arushriswarup/Grad-School/Expenses/Home Hardware 30-Mar-2017.jpg

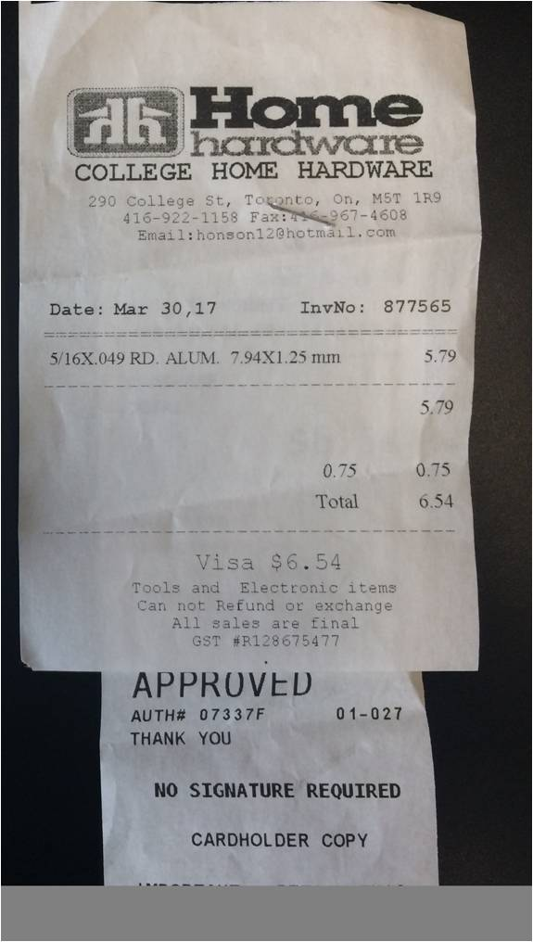
Expenses/Home Hardware 30-Mar-2017.jpg
