arushriswarup/Grad-School/Coursework/Bioengineering Science/Kevin Thesis Proposal Comments.JPG

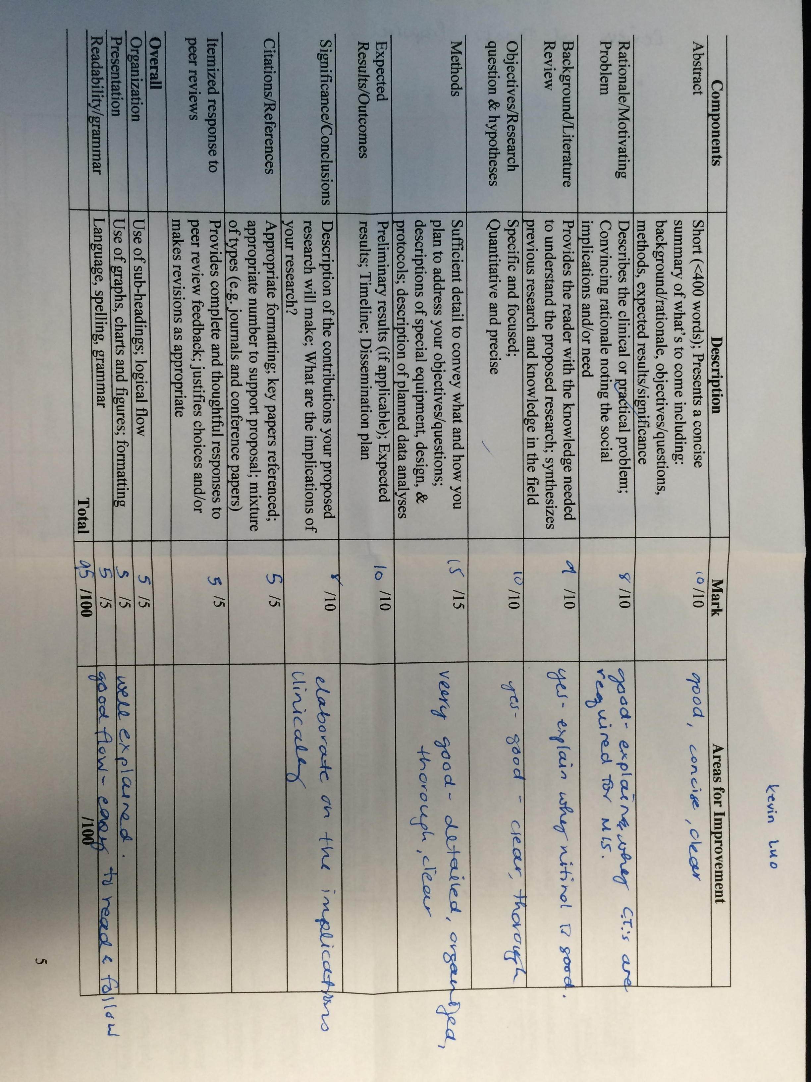
Coursework/Bioengineering Science/Kevin Thesis Proposal Comments.JPG
