arushriswarup/Grad-School/Ear Surgery Instruments/Wrist Tool Assembly/BOM.txt

McMaster Carr Parts: 

Stainless steel tubing for suction shaft: 5560K43 https://www.mcmaster.com/#5560k43/=15yuvoh
stainless steel tubing for containing the cable and suction shaft: 
stainless steel tubing for handle body: 89495K295 https://www.mcmaster.com/#standard-stainless-steel-hollow-tubing/=15ywdfg
