arushriswarup/Grad-School/Lab Meeting 07-Nov-2016.pptx

## Workspace Analysis

Goal: design the body and tip of the instrument using ear anatomy as a guide

## Problem: Endoscope can visualize areas in middle ear but current tools cannot reach certain areas.

Middle Ear Anatomy

Endoscopic View

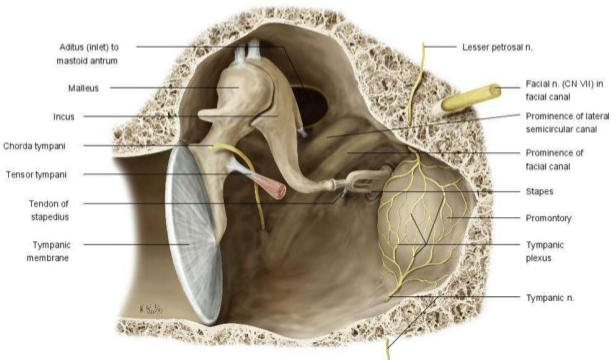
[picture p45: figure]

http://image.slidesharecdn.com/2-151023145818-lva1-app6892/95/anatomy-of-middle-ear-4-638.jpg?cb=1445612510

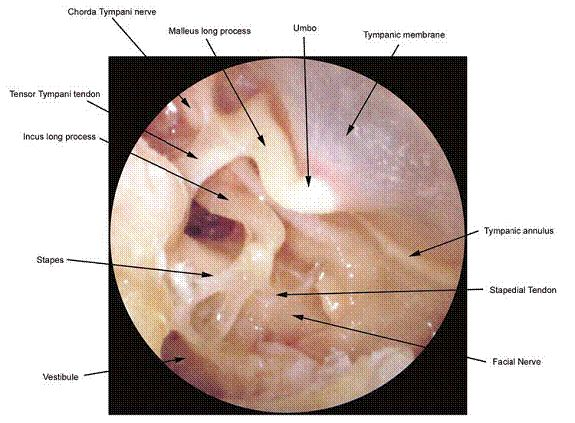
[picture p46: figure]

https://s-media-cache-ak0.pinimg.com/736x/a9/a7/0f/a9a70f560bd321be8d7cf8272315d433.jpg

Endoscope

## Slide 3

Question 1: What is the optimal geometry of the body of the tool to reach areas within the middle ear
Head CT Scan .dicom + Slicer → Solidworks [3D ear anatomy .stl + endoscope]
Question 2: What is the desired tip function when the tool reaches that area? (e.g. forceps, curette, blade, etc.)
3D printed bony ear anatomy + Instrument with electromagnetic sensors → map the tip workspace → integrate into computer model
Shaping Instrument:
Final computer model with anatomy & endoscope (boundaries), tip workspace → integrate a simple instrument and bend according to the model boundaries to try and form a shape that will reach the workspace

## Questions:

- Can you export the workspace map into an STL?
- How easy would it be to integrate into a solidworks file with an STL of the ear anatomy?
- How do you work with such a big file on solidworks?
- How easy is it to integrate a sldprt (endoscope and instrument model) into an STL on a solidworks file?
- Should I use solidworks for this or a different program?
- To validate that the tool will work on more than just one ear, I will make a separate model for each CT-generated ear model. Is this a good idea? What should be my sample size?
