arushriswarup/Grad-School/IP&C/ANSTY_Patent_Images.pptx

## Slide 2

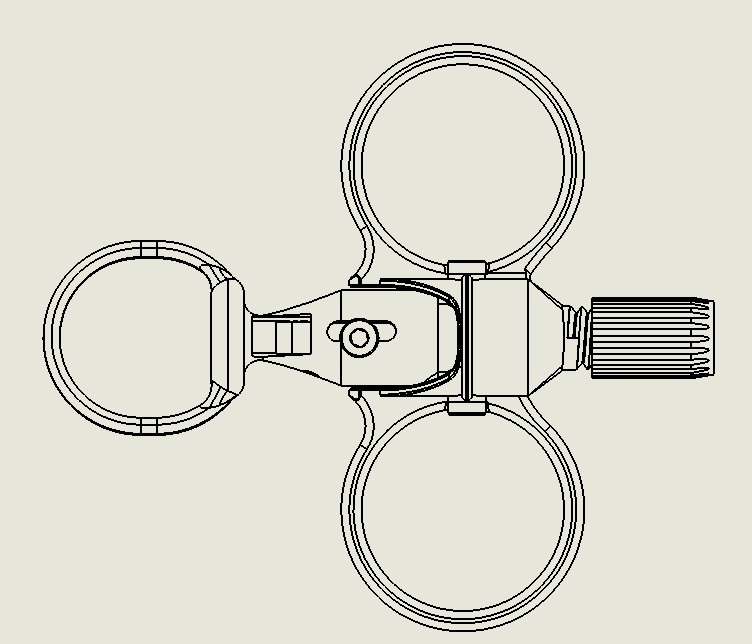
[picture p47: figure]

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
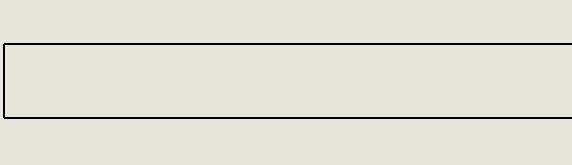
[picture p48: figure]

235

240

245

237

236

243

246

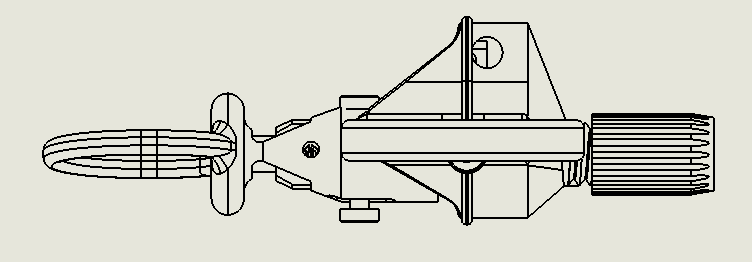
[picture p49: figure]

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
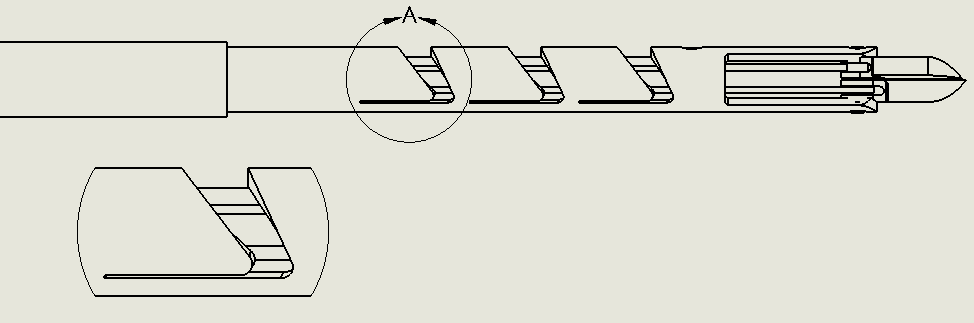
[picture p50: figure]
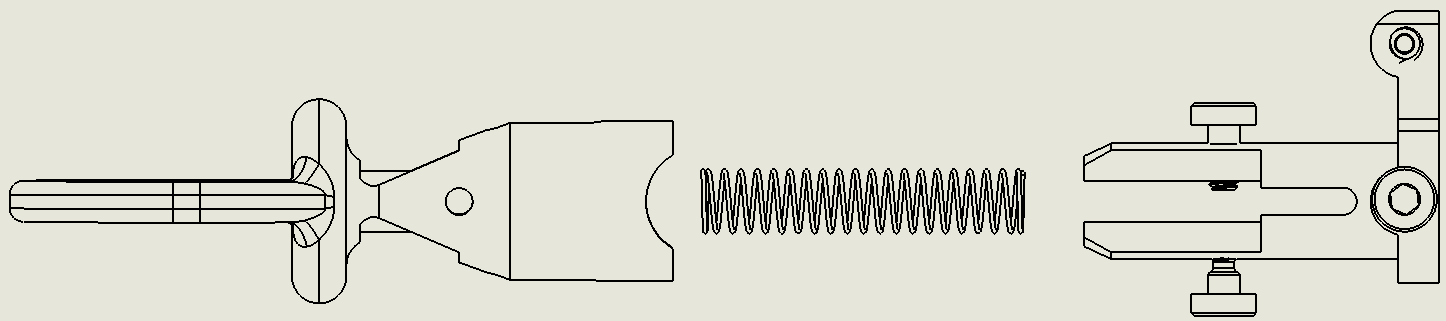
[picture p51: figure]

239

247

246

243

## Slide 3

Thumb Trigger

Compression Spring

Thumb Gimbal

## Slide 4

## Slide 5

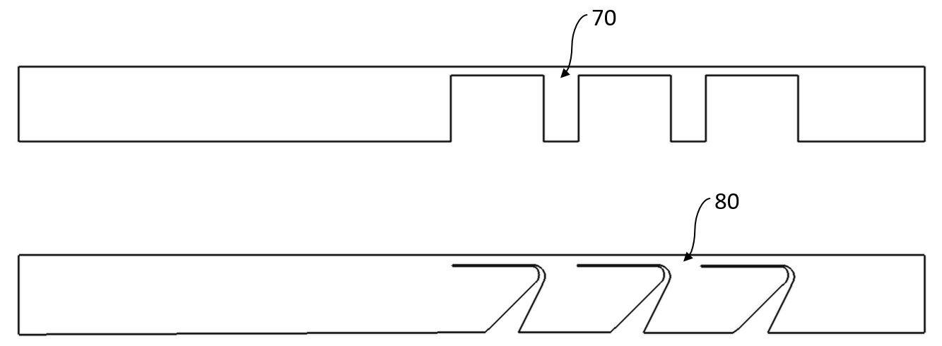
[picture p52: figure]
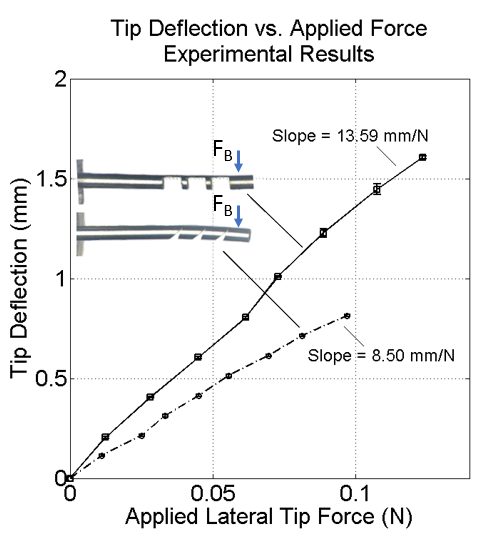
[picture p53: figure]

71

81

## Slide 6

## Slide 7

Dissector to the left:

Dissector to the right:

Dissector on the front:

Dissector to the left:

Dissector to the right:

Dissector on the front:

## Slide 8

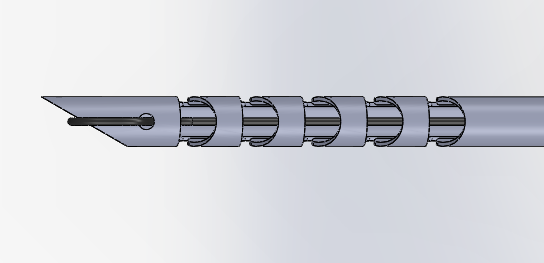
[picture p54: figure]

Nitinol CCM wrist

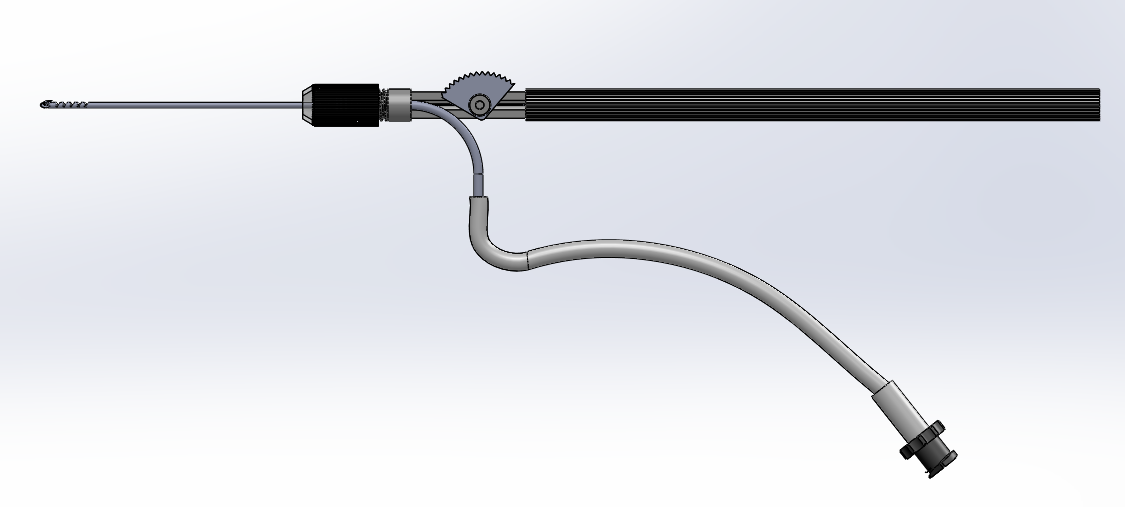
[picture p55: figure]

Finger Piece

Handle

Nitinol curved suction connector

Suction Tubing

Female Luer Connector

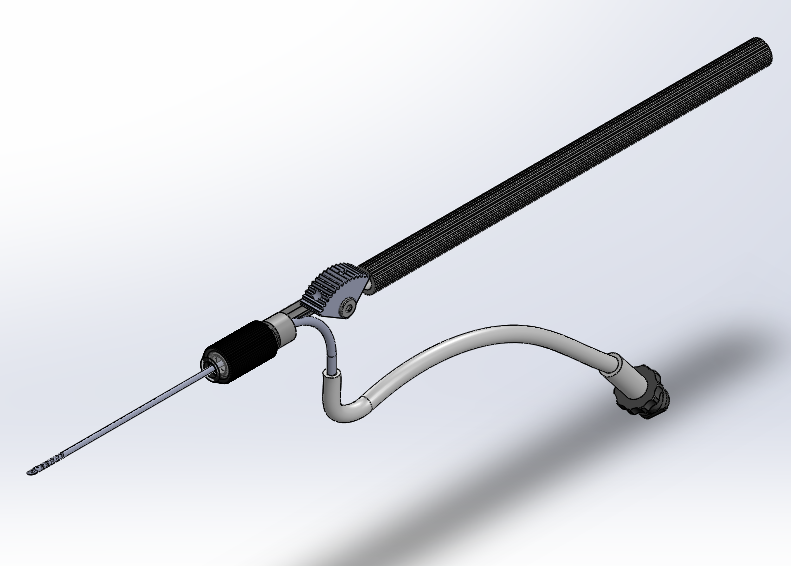
[picture p56: figure]
