arushriswarup/Grad-School/IP&C/Patent Search.docx

Patent Search:

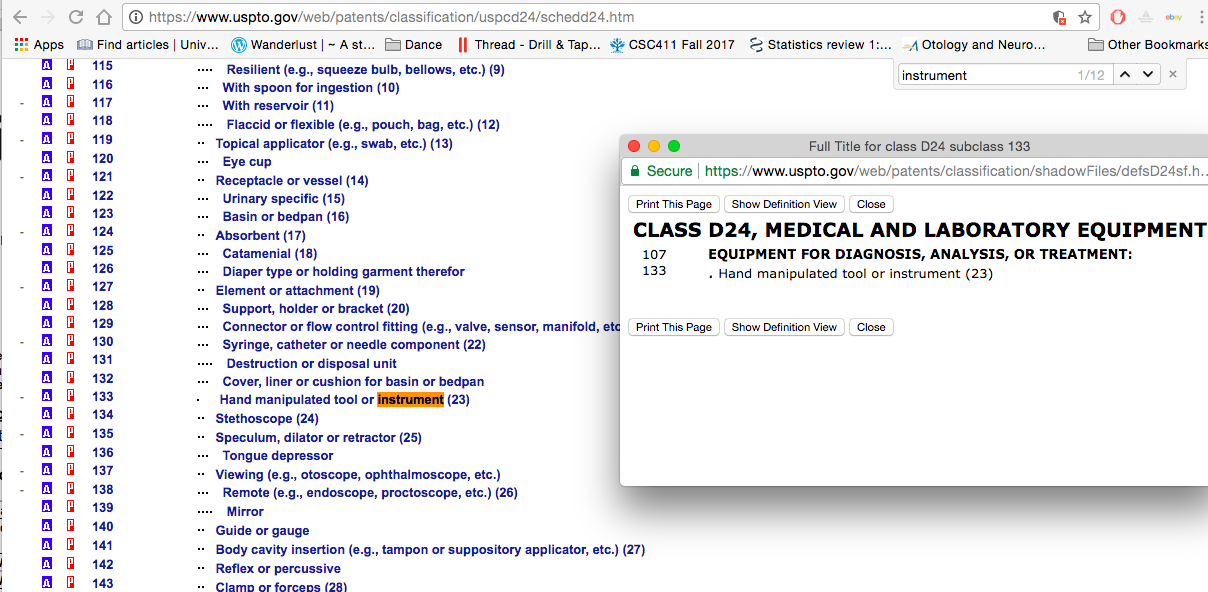
[picture p61: figure]

Classes:

CLASS D24, MEDICAL AND LABORATORY EQUIPMENT
107 | EQUIPMENT FOR DIAGNOSIS, ANALYSIS, OR TREATMENT:

133 | . Hand manipulated tool or instrument (23)

Click on the “p” button beside the class

http://patft.uspto.gov/netacgi/nph-Parser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

Patent Figures

- See folder of patents

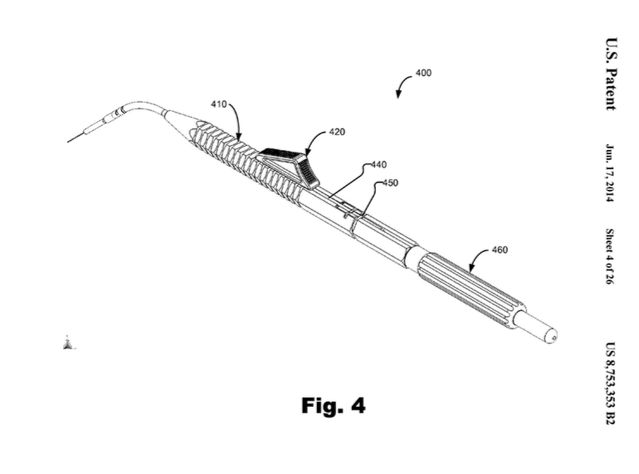
[picture p62: figure]
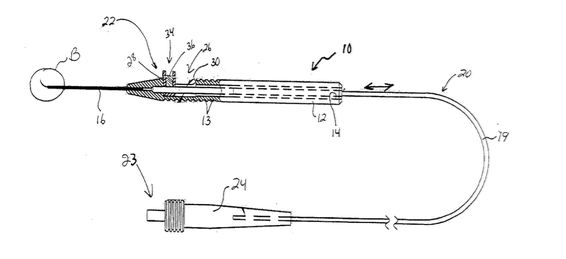
[picture p63: figure]
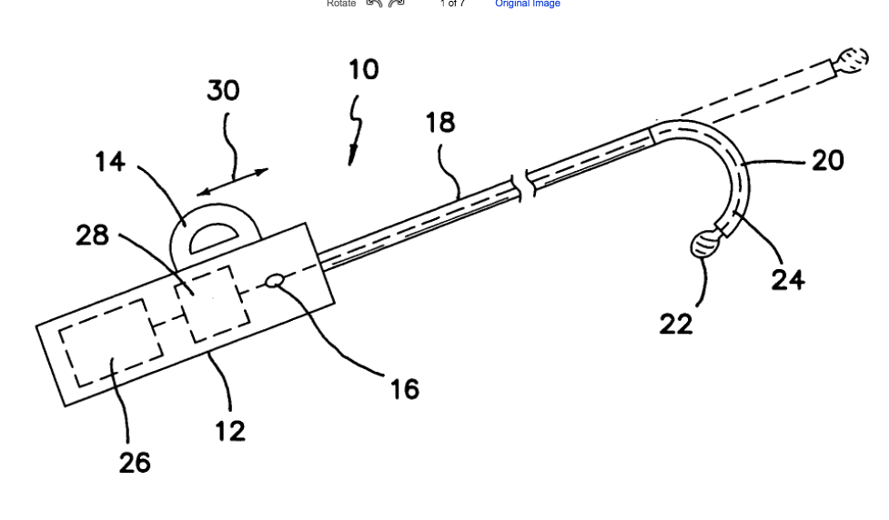
[picture p64: figure]

steerable catheter handles:

https://www.google.com/patents/US6146355

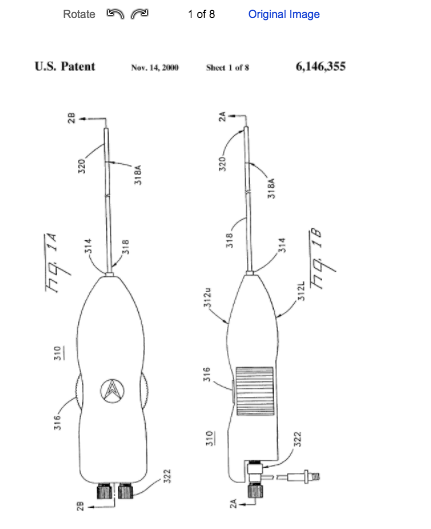
[picture p65: figure]

Published Prior Art

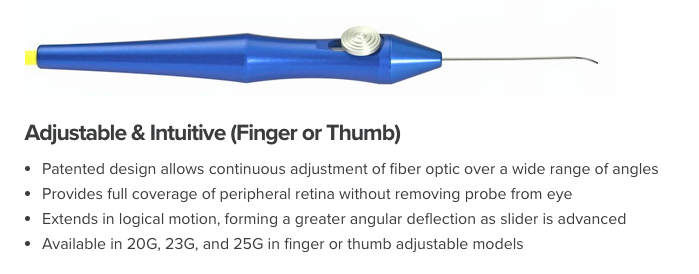
[picture p66: figure]

http://salientmed.com/solution/endoprobe-handpieces/

- https://healingsurgical.com.au/product/steerable-laser-probe#productDetailTab2

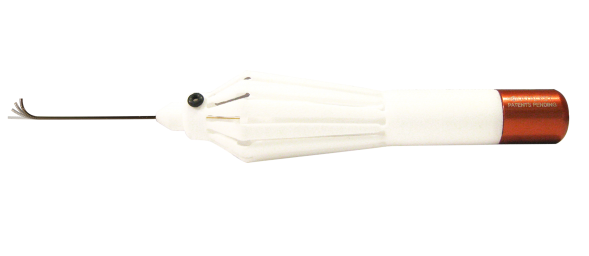
[picture p67: figure]

https://www.bitegroup.nl/category/maneuverable-devices/i-flex/

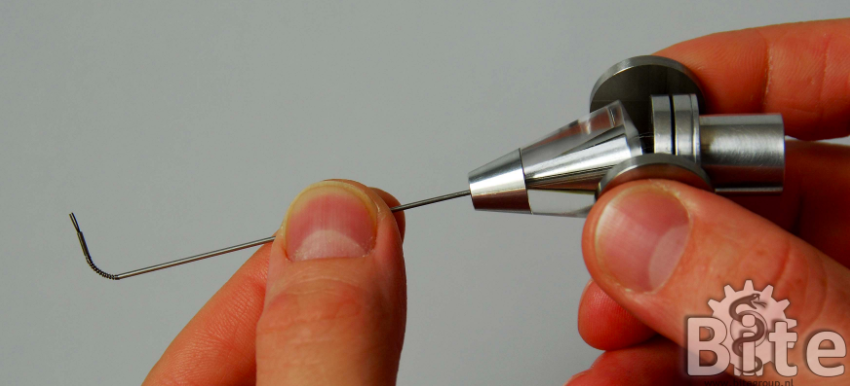
[picture p68: figure]

Curved Suction:

Medtronic Fusion ENT Navigation System: http://assets.medtronic.com/ent/flipbook-us/#p=44

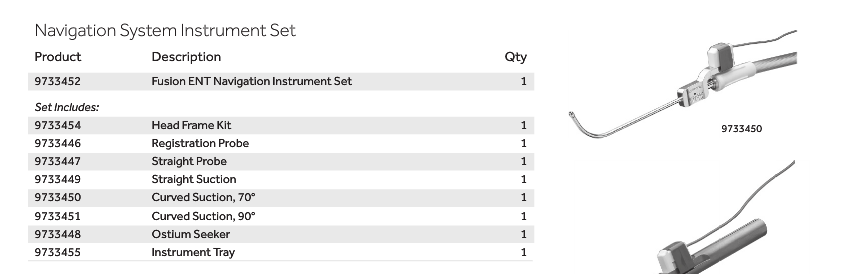
[picture p69: figure]

I think this has pre-curved suction (but not bendable)

http://www.medtronic.com/us-en/healthcare-professionals/products/ear-nose-throat/image-guided-surgery/fusion-ent-navigation-system/related-navigation-products.html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

- Frontal Suctions, 45° and 90°
- Small Straight Suction
- Suction Curettes, 45° and 90°
- Elevator
- Standard Registration Probe and Head Frame Kit (not pictured)
