arushriswarup/Grad-School/sentac/Sentac-Poster 01-Dec-2017.pdf

X

Thomassin Dissector,/
double/bend

Ear/Canal

Target

Controller:)Finger'Piece
Handle

Luer'Lock'for'
suction | Connector' | Tubing'for'suction)
| | or)laser)fibre

Flexible)Tip

0

20

40

60

80

100
Need for Better Instrumentation (%)

Reaching

Structures
Dissection and
Removal of

Cholesteatoma

Cutting Bone
Bleeding
Control

Keeping the
Lens Clean

Positioning a

Graft

### Arushri Swarup¹,2,3, Adrian L. James³

1Department of Otolaryngology – Head and Neck Surgery, Faculty of Medicine, University of Toronto, Toronto, ON, Canada 2Centre for Image Guided Innovation and Therapeutic Intervention, The Hospital for Sick Children, Toronto, ON, Canada 3Institute of Biomaterials and Biomedical Engineering, University of Toronto, Toronto, ON, Canada

# Design of Controllable Flexible Instruments to Facilitate Endoscopic Ear Surgery

As TEES is a young field, a needs analysis study was conducted to define the primary challenges faced by surgeons.

References
1. Cohen MS, Landegger LD, Kozin ED, Lee DJ. Pediatric endoscopic ear surgery in clinical practice: Lessons learned and early outcomes. Laryngoscope. 2015:732--738. 2. Kanona H, Virk JS, Owa A. Endoscopic ear surgery: A case series and first United Kingdom experience. World J Clin cases. 2015;;3(3):310--317. 3. Badr-el-dine M. Instrumentation and Technologies in Endoscopic Ear Surgery. Otolaryngol Clin NA. 2013;;46(2):211--225.
4. Bennett ML, Zhang D, Labadie RF, Noble JH. Comparison of Middle Ear Visualization With Endoscopy and Microscopy. Otol Neurotol. 2016;;37:362--366. 5. Yong M, Mijovic T, Lea J. Endoscopic ear surgery in Canada : a cross-sectional study. J Otolaryngol - Head Neck Surg. 2016:1--8. 6. Mijovic T, Lea J. Training and Education in Endoscopic Ear Surgery. Curr Otorhinolaryngol Rep. 2015;;3(4):193--199. 8. Eastwood KW, Francis P, Azimian H, Swarup A, Looi T, Drake JM, Naguib HE. Design of a Contact--Aided Compliant Notched--Tube Joint for Surgical Manipulation in Confined Workspaces. ASME. J. Mechanisms Robotics. 2017;;():. [accepted manuscript] arushri.swarup@mail.utoronto.ca
Study Results | Patient CT scans informed the design of the tip in order to reach the target anatomy, including the antrum and sinus tympani where cholesteatoma is usually found and currently inaccessible without removing bone. The desirable bending angle is 135o which allows the tip to reach the boundary of the endoscope viewing angle.

Reaching Problem: current instruments cannot reach all structures visualized by the endoscope without the removal of bone.

Reaching Solution: Incorporate a flexible “wrist” at the tip of the instrument. By cutting notches into a tube made of nitinol (a superelastic metal), the tube can bend by pulling on an

attached cable. A specific notch geometry is selected to achieve the desired bending shape while increasing stiffness⁷.

Cross%sectional-mixed-methodsstudy-questionnaireç

Interviews-with-5-localotologists

Pilot-questionnaire

TEES-skills-course

51-international-TEES-Surgeon-responses

Non%parametric-data-analysis:-Kruskal Wallis-H%Test
Wilcoxon-Method
P<0.05-significant

TEES-Experience:-
Percent-of-TEES-Cases:-
0%
Up-to-50%
50%90%
More-than-90%

Use-of-specialized-TEES-Instruments? Yes-No

“Are-there-any-other-instruments-that-you-would-like-tosee-modified-or-developed-for-endoscopic-earsurgery?-Please-give-examples”-

Visual-Analog-Scale:-
Rate-need-for-better-instrumentation-to-address-thefollowing-TEES-challenges:-Reaching-structures-visualized- by-the-endoscope Dissection-and-removal-of-cholesteatoma Cutting-bone
Bleeding- control
Keeping-the-endoscope-lens-clean Positioning- a-graft

The tip was manufactured by laser cutting a nitinol tube and attached to a handle which could articulate the joint. The handle is designed to maintain a similar grip used for existing ear surgery instruments with the addition of a finger piece for controlling the tip.

REB #s: 1000033566, 100005/5626

The | instrument | was
tested | using | an
endoscope inside 3D
printed patient temporal
bone models generated
from the CT scans. It
was possible to reach
the sinus tympani and
antrum.

To address the challenges of TEES, an instrument was designed, prototyped and tested to reach the structures visualized by the endoscope.

Defining the Challenges of TEES | Development of a New Instrument for TEES

### Needs Analysis Study

### Instrument Tip Design

### Instrument Prototype

### Instrument Testing

Transcanal endoscopic ear surgery (TEES) is a new minimally invasive middle ear surgery technique to access otherwise hidden recesses within the middle ear¹⁻-4. While TEES reduces length of hospital stay and patient morbidity, the surgical technique is challenging since only one hand can handle an instrument which must pass through the narrow ear canal⁵,6. Presently, surgeons performing TEES use otologic instruments developed for two-handed surgery which are not optimized for the TEES environment.
Objective: Design instruments to facilitate the challenges experienced during transcanal endoscopic ear surgery (TEES).

Reaching structures visualized by the endoscope yielded the greatest need for better instruments.

Survey comments called for new instruments to improve reach, dissect and remove
cholesteatoma, bone removal, and control bleeding.

### Future Work

Future work involves further testing of the tip to ensure it can safely encounter the tissue forces experienced during surgery, orient a laser fibre safely and effectively, and reach the desired targets within the middle ear without significant bone removal and ultimately facilitate endoscopic ear surgery.
