arushriswarup/Grad-School/Ear Surgery Instruments/Endoscopic Ear Surgery Tool Development Timeline.pdf

Untitled Gantt Project | Jan 26, 2016
Gantt Chart | 3

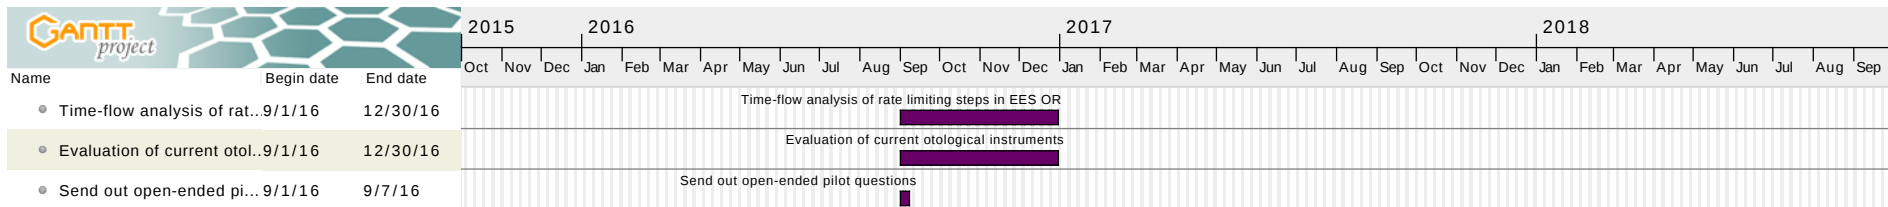
[picture p88: figure]
Name; Begin date; End date; Time-flow analysis of rat...9/1/16; Evaluation of current otol...9/1/16; Send out open-ended pi... 9/1/16; Oct; Nov; Dec; Jan; Feb; Mar; Apr; May; Jun; Jul; Aug; Sep; Time-flow; analysis; rate; limiting; steps; EES; Evaluation; current; otological; instruments; Send; out; open-ended; pilot; questions

Assimilate responses to ... 9/1/16 | 11/30/16
Send out survey and re... 10/3/16 | 10/10/16
Solidworks I Course - Ge...9/1/16 | 10/31/16
Assimilation and analysis...1/2/17 | 1/31/17
Dissemination of survey ...2/1/17 | 6/30/17
Feedback from on-line f... 2/1/17 | 6/30/17
Assimilation of focus-gro...2/1/17 | 6/30/17
Preparation of Instruments9/1/17 | 5/31/18
Preparation of virtual an... 9/1/17 | 9/30/17
Testing of instruments - ...10/2/17 | 12/29/17
Revision of Instruments | 12/1/17 | 1/31/18
Machine Final Instruments 2/1/18 | 2/28/18
Test final instruments - t...3/2/18 | 5/31/18
Survey Endoscopic Ear S... 3/2/18 | 5/31/18
Complete write-up of th... 5/2/18 | 8/31/18
Assimilate responses | to | pilot | survey | and | time-flow | analysis | to | develop | formal | needs | assessment | survey
Send | out | survey | and | reminders
Solidworks | I | Course | - | George | Brown | College
Assimilation | and | analysis | of | needs | assessment | survey
Dissemination | of | survey | results | and | time-flow | analysis | to | focus-groups | and | invitation | to | provide | solutions
Feedback | from | on-line | focus | groups
Assimilation | of | focus-group | feedback | with | in-house | solutions | and | comparison | with | current | instruments | to | create | innovative | solutions
Preparation | of | Instruments
Preparation | of | virtual | and | 3D | printed | temporal | bones | from | clinical | CT | scans | for | testing | of | prototype | instruments
Testing | of | instruments | - | involve | feedback | from | surveyed | endoscopic | ear | surgeons
Revision | of | Instruments
Machine | Final | Instruments
Test | final | instruments | - | time | flow | analysis
Survey | Endoscopic | Ear | Surgeons | for | acceptance | of | instruments
Complete | write-up | of | thesis, | preparation | for | dissemination | of | results

# Endoscopic Ear Surgery Tool Development Timeline
