arushriswarup/Grad-School/Ear Surgery Instruments/Gantt Chart 25-Jan-2016.pdf

Untitled Gantt Project | Jan 26, 2016 http://

Project manager
Project dates | Sep 1, 2016 - Aug 3, 2018
Completion | 0%
Tasks | 17
Resources | 0

Name | Begin date | End date
Time-flow analysis of rate limiting steps in EES OR | 9/1/16 | 12/30/16
Evaluation of current otological instruments | 9/1/16 | 12/30/16
Send out open-ended pilot questions | 9/1/16 | 9/7/16
Assimilate responses to pilot survey and time-flow analysis to develop formal needs assessment survey | 9/1/16 | 12/1/16
Send out survey and reminders | 10/3/16 | 10/10/16
Solidworks I Course - George Brown College | 9/1/16 | 11/1/16
Assimilation and analysis of needs assessment survey | 1/2/17 | 2/2/17
Dissemination of survey results and time-flow analysis to focus-groups and invitation to provide solutions | 2/1/17 | 6/1/17
Feedback from on-line focus groups | 2/1/17 | 6/1/17
Assimilation of focus-group feedback with in-house solutions and comparison with current instruments to create innovative solutions | 2/1/17 | 2/1/17
Preparation of Instruments | 9/1/17 | 6/1/18
Testing of instruments - involve feedback from surveyed endoscopic ear surgeons | 9/1/17 | 12/1/17
Revision of Instruments | 12/1/17 | 2/1/18
Machine Final Instruments | 2/1/18 | 3/2/18
Test final instruments - time flow analysis | 3/2/18 | 5/2/18
Survey Endoscopic Ear Surgeons for acceptance of instruments | 3/2/18 | 5/2/18
Complete write-up of thesis, preparation for dissemination of results | 5/2/18 | 8/2/18
Untitled Gantt Project | Jan 26, 2016
Tasks | 2

## Gantt Chart

3

Evaluation of current ot... 9/1/16 | 12/30/16
Send out open-ended ... 9/1/16 | 9/7/16
Assimilate responses to...9/1/16 | 12/1/16
Send out survey and re... 10/3/16 | 10/10/16
Solidworks I Course - G...9/1/16 | 11/1/16
Assimilation and analysi...1/2/17 | 2/2/17
Dissemination of survey...2/1/17 | 6/1/17
Feedback from on-line ... 2/1/17 | 6/1/17
Assimilation of focus-gr...2/1/17 | 2/1/17
Preparation of Instrume... 9/1/17 | 6/1/18
Testing of instruments ... 9/1/17 | 12/1/17
Revision of Instruments 12/1/17 | 2/1/18
Machine Final Instruments2/1/18 | 3/2/18
Test final instruments -...3/2/18 | 5/2/18
Survey Endoscopic Ear ... 3/2/18 | 5/2/18
Complete write-up of t... 5/2/18 | 8/2/18

Machine Final Instruments

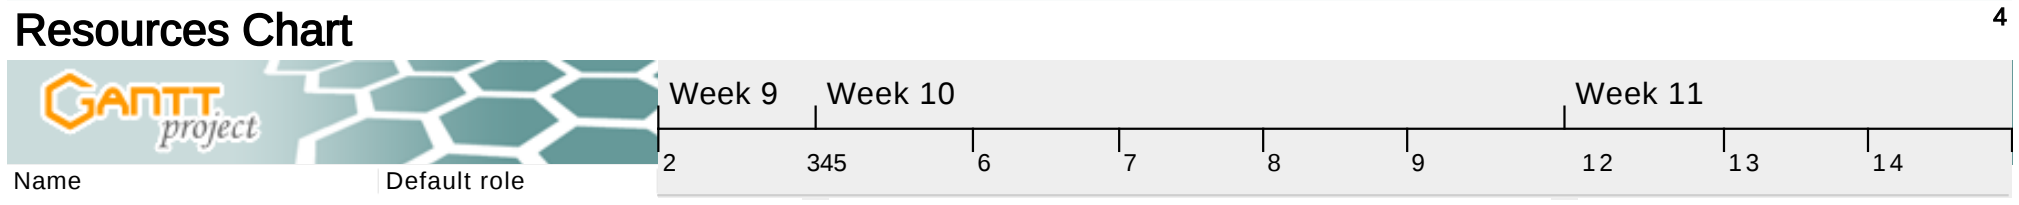
[picture p89: figure]
Resources Chart; Name; Default role; Week 9; Week 10; Week 11
