arushriswarup/Grad-School/Coursework/Bioengineering Science/First Draft Proposal .docx

Needs Analysis and Time Flow Study to Assess Endoscopic Ear Surgery

Page numbers, version date

Background:

Middle ear surgery is traditionally performed through an external incision with visualisation of delicate anatomical structures using a microscope. More recently, minimally invasive ear surgical techniques have been developed using endoscopes to access the middle ear through the ear canal without an external incision [1] [2]. As with open microscope-guided surgery, this transcanal endoscopic ear surgery (TEES) technique, allows the surgeon to perform procedures such as ear drum reconstruction, skin growth removal and hearing bone repair [2] [3]. The advantages of endoscopic ear surgery are as follows: removing the need for an external incision and reducing postoperative morbidity (10), improving visualisation for disease eradication (2-4), including reduction of the rate of residual skin growth (2, 3), and improving hearing by facilitating hearing bone preservation (10, 11).

Despite the enthusiasm of some ear surgeons (otologists), endoscopic ear surgery has not as yet been accepted by all practicing otologists (5). The principal challenge with TEES is that a one-handed surgical technique is required as the endoscope is held in the other hand. Otologic instruments were developed for two-handed microscope-guided surgery so they are not optimized for the TEES environment [2] [4]. As otologists have been trained and gained experience in microscope-guided ear surgery, they have developed techniques with the according instruments and have become accustomed to a two-handed surgical approach. By learning different surgical techniques and gaining experience with the endoscope, most surgeons find that they can complete more cases endoscopically (1, 7, 12). Nevertheless, the learning curve can be slow and frustrating. In the experience of the primary investigator (PI), technological advances in the design of the endoscope, camera and suction dissection instruments have lead to incremental stepwise jumps in this learning curve (13). There is a knowledge gap in the literature where it is not reported exactly why surgeons have not adopted the technique, and what technological and/or training advances would encourage greater adoption. It is proposed that in order to improve the adoption of TEES, the needs of surgeons and current limitations of tools must be determined.

Objectives and Hypothesis:

Objectives:

In order to increase the use of TEES, the following will be investigated: a) the reason for surgeons not adopting TEES and b) limitations of existing tools. This will aim to understand why TEES is not widely adopted by otologists and how its adoption can be improved.

Hypothesis:

TEES is recognized for its potential and the investigators hypothesize that by conducting a needs analysis survey and a surgical time flow analysis, current limitations of TEES will be developed to develop criteria to improve the adoption of TEES.

Overview of Methodology:

The protocol for this study forms part of a larger project aiming to develop improved instrumentation for endoscopic ear surgery. This study has two parts: (1) a needs assessment and (2) a time flow study.

1. Needs Assessment

The first part of this study aims to understand why TEES is not widely adopted by otologists and what technological advances would allow more frequent and broader use of TEES. A needs assessment survey will be conducted, using the two-round Delphi method, that examines the current limitations of surgical instruments used in TEES. Information from interviews with local otologists will be used to generate a questionnaire that will be disseminated to otologists globally. These results will help guide development of new instrumentation to facilitate TEES.

2. Time Flow Study

As well, independent of the needs analysis, a time flow analysis, recording the duration of surgical steps, will be conducted to quantify the limitations of the current instruments used in TEES, by assessing their efficiency.

Methods and Analysis:

Part 1: Needs Assessment Survey:

Surveys are widely used to gain information regarding a specific topic by consulting a wide variety of experts in the field. They have been used to assess the challenges of endoscopic neurosurgery in Britain and the current status of endoscopic ear surgery in Canada [6]-[7]. The Delphi method has been employed internationally in the field of surgery where surveys are sent out to surgeons to form a consensus about varying surgical issues such as: treatment of the retraction pockets of the tympanic membrane, developing a core set of patient-reported outcomes in pancreatic cancer, and an international consensus for sepsis and septic shock definitions [8] [9] [10].

A qualitative assessment of the challenges in endoscopic ear surgery caused by limitations in current instrumentation will be completed by performing an online survey of surgeons that perform endoscopic ear surgery. The Delphi method will be followed to analyze the qualitative results of the survey.

Preliminary interviews of local otolaryngologists, with varied experience in TEES within the University of Toronto, will be conducted by an IBBME MASc student (Arsuhri Swarup). Questions will ask for comments on factors that have prevented otologists from using endoscopes in ear surgery, and for comments on the perceived strengths and weaknesses of currently available instruments for endoscopic ear surgery. Their opinions will be de-identified and collated to develop a list of requirements for improvements in instrument design. In order to determine the relative priority of these requirements, a pilot questionnaire will be developed to ask a wider group of otologists to rate the importance of each requirement and will include further open-ended questions for additional comments. Invitations to participate will be sought from the 60 members of the International Working Group on Endoscopic Ear Surgery (IWGEES) (http://www.iwgees.org) plus delegates known to the PI from attendance at ear surgery courses. Results from this pilot questionnaire will be used to generate a formal questionnaire for a global survey of otologists’ opinions. This will attempt to develop a consensus on priorities for improvements in TEES instrumentation.

Participant Recruitment:

The participants are otologists who will be invited to participate by email. The email addresses will be obtained in two ways:

1. Publicly available information, as many ear surgeons list their email on their hospital website.

2. The mailing list of otological societies. Online surveys of surgical practice are frequently distributed by such societies. The following societies of which the PI is a member will be contacted asking for permission to survey their members:

- Canadian Society of Otolaryngology - Head and Neck Surgery
- American Society of Otology
- Politzer Society
- European Academy of Otology and Neurotology
- British Academy of Otolaryngology - Head and Neck Surgery
- International Working Group on Endoscopic Ear Surgery

In order to ensure that results of the survey remain de-identified, all contact information will be kept in a separate password protected spreadsheet from the results of the survey.

Needs Assessment Survey:

This portion has only surgeon participants. The survey responses will remain anonymous to the researchers and consent will be implied if the survey is filled out and received by the research team.

Questionnaire:

Refer to Appendix A for the survey details.

Part 2: Time Flow Study:

Time flow studies aim to analyze the efficiency of procedures, and have been used for many purposes in surgery, including MRI-guided angioplasty workflow and operating room setup dedicated for minimally invasive laparoscopic surgery [4]-[5]. This study will assess the feasibility and efficiency of endoscopic ear surgery using the same method.

Study Design (General Overview):

The time flow analysis will be recorded by the MASc student during ear surgery. The surgery will be divided into steps, described below. The type of instruments used during the different steps and the number of changes between instruments will also be noted. These observations will lead to an appreciation of the ergonomic requirements of instruments and the design advantages of different instruments for specific maneuvers. The time taken for five surgeons to perform ten surgeries each will be recorded. Each step for each surgeon will have a mean and standard error time, and statistical difference between surgeons for each step will be calculated. This will aim to determine the inefficiencies and address the steps where further instrument design would be beneficial. This would also provide a good benchmark against which to measure efficiency and feasibility of future tools that would be developed. The last half of surgeries will be done using the new tools developed for improving TEES. The results will be compared statistically.

Participants

The time flow study will include two kinds of participants: patients, who will be undergoing ear surgery, and surgeons, who will be performing the ear surgery.

Participant Recruitment

The PI’s colleagues in otolaryngology are interested in this project and would also like to improve their experience with TEES. Three additional surgeons from SickKids and one from Toronto General Hospital have expressed interest in participating in this study.

Inclusion criteria

Patient participants: 40 surgical patients, who require cholesteatoma surgery or tympanoplasty (surgical repair of perforated ear drum).

Surgeon participants: 5 surgeons with more than one year of experience in endoscopic ear surgery.

Exclusion criteria

Residents and fellows who are in training. It would be inappropriate to include surgeons in training in the study as their lack of experience will contribute to delays and lack of efficiency in time flow, so confounding the estimate of the contribution of instrument design to surgical time flow. Although the ability of trainees to use different instruments in TEES and the impact of their level of experience on this ability would be of interest, they are beyond the current scope and design of this study.

Study intervention

Each surgeon will be observed and recorded performing ten operations. The time and number of instruments changed will be recorded for the steps outlined in the Data Collection Form, included in Appendix B.

Outcome measures

The following outcomes will be measured: duration of the surgical steps described above and the number of times the surgeon changes the tool he/she is using during the step.

Statistical analysis

The factor to be studied is the type of instruments used for each surgical step. The block is the surgeon. The response is the time required for the surgical step. Therefore, an ANOVA will be used to determine if there is a statistical difference in the time to complete a surgical step depending on the instruments used.

[1] “Benefits of Minimally Invasive Surgery | AIMIS.” [Online]. Available: http://www.aimis.org/benefits-of-minimally-invasive-surgery/. [Accessed: 14-Nov-2015].

[2] M. S. Cohen, L. D. Landegger, E. D. Kozin, and D. J. Lee, “Pediatric endoscopic ear surgery in clinical practice: Lessons learned and early outcomes,” Laryngoscope, p. n/a–n/a, 2015.

[3] H. Kanona, J. S. Virk, and A. Owa, “Endoscopic ear surgery: A case series and first United Kingdom experience.,” World J. Clin. cases, vol. 3, no. 3, pp. 310–7, 2015.

[4] M. A. Rube, F. Fernandez-gutierrez, B. F. Cox, B. Holbrook, J. G. Houston, R. D. White, H. Mcleod, M. Fatahi, and A. Melzer, “HHS Public Access,” vol. 10, no. 5, pp. 637–650, 2015.

[5] K. C. Hsiao, Z. Machaidze, and J. G. Pattaras, “Time Management in the Operating Room : An Analysis of the Dedicated Minimally Invasive Surgery Suite,” pp. 300–303, 2004.

[6] H. J. Marcus, T. P. Cundy, A. Hughes-hallett, Z. Yang, A. Darzi, D. Nandi, and D. Phil, “Europe PMC Funders Group Endoscopic and Keyhole Endoscope-assisted Neurosurgical Approaches : A Qualitative Survey on Technical Challenges and Technological Solutions,” vol. 28, no. 5, pp. 606–610, 2015.

[7] M. Yong, T. Mijovic, and J. Lea, “Endoscopic ear surgery in Canada : a cross-sectional study,” J. Otolaryngol. - Head Neck Surg., pp. 1–8, 2016.

[8] A. Gerritsen, M. Jacobs, I. Henselmans, J. van Hattum, F. Efficace, G.-J. Creemers, I. H. de Hingh, M. Koopman, I. Q. Molenaar, H. W. Wilmink, O. R. Busch, M. G. Besselink, H. W. van Laarhoven, and Dutch Pancreatic Cancer Group, “Developing a core set of patient-reported outcomes in pancreatic cancer: A Delphi survey.,” Eur. J. Cancer, vol. 57, pp. 68–77, Apr. 2016.

[9] S. Y. Kosyakov, Y. V Minavnina, and E. V Pchelenok, “[The consensus view of the treatment of the retraction pockets of the tympanic membrane].,” Vestn. Otorinolaringol., vol. 81, no. 1, pp. 78–83, 2016.

[10] M. Singer, C. S. Deutschman, C. W. Seymour, M. Shankar-Hari, D. Annane, M. Bauer, R. Bellomo, G. R. Bernard, J.-D. Chiche, C. M. Coopersmith, R. S. Hotchkiss, M. M. Levy, J. C. Marshall, G. S. Martin, S. M. Opal, G. D. Rubenfeld, T. van der Poll, J.-L. Vincent, and D. C. Angus, “The Third International Consensus Definitions for Sepsis and Septic Shock (Sepsis-3).,” JAMA, vol. 315, no. 8, pp. 801–10, Feb. 2016.

[11] “AANS - Minimally Invasive Spine Surgery MIS.” [Online]. Available: http://www.aans.org/patient information/conditions and treatments/minimally invasive spine surgery mis.aspx. [Accessed: 17-Nov-2015].

[12] “Endoscopic Nasal & Sinus Surgery.” [Online]. Available: http://care.american-rhinologic.org/ess. [Accessed: 17-Nov-2015].

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

[14] A. L. James, B. C. Papsin, and B. C. Papsin, “-- Head and Neck Surgery,” no. September, 2012.

Page 1 of 4. Version date 27th October 2016
