arushriswarup/Grad-School/Coursework/Bioengineering Science/Proposal Outline 17-Oct-2016 Arushri Swarup.docx

Needs Analysis and Time Flow Study to Assess Endoscopic Ear Surgery

Introduction:

- Minimally invasive ear surgical techniques have been developed using endoscopes to access the middle ear through the ear canal without an external incision (1), (2)
- This is a new and challenging surgical technique, requiring one handed surgery (one hand holds the endoscope steady) and current instruments are not optimized for the technique therefore there is a low adoption among ear surgeons
- Traditional surgeries can be performed via this technique which allows better visualization within the hidden recesses in the middle ear

Research Question: Why is transcanal endoscopic ear surgery (TEES) not widely adopted by otologists and what technological advances would encourage more frequent and broader use of TEES.

Hypothesis: We hypothesize that a needs analysis study will provide an answer to this question and help develop criteria against which new endoscopic ear surgery tools can be developed.

Research Objectives: In order to increase the use of TEES we need to understand: a) the reason for surgeons not adopting TEES by conducting a questionnaire for surgeons and b) limitations of existing tools by conducting time flow analysis.

Study Rationale/Literature Review:

Time Flow Analysis

- Have been used for many purposes in surgery to test feasibility and efficiency of a specialized method
- Eg. MRI-guided angioplasty workflow and operating room setup dedicated for minimally invasive laparoscopic surgery (3)-(4)

Survey

- Used to gain information regarding a specific topic by consulting a wide variety of experts in the field
- Has been used to assess the challenges of endoscopic neurosurgery in Britain and the current status of endoscopic ear surgery in Canada (5)-(6) and is therefore applicable to assess the needs for endoscopic ear surgery

Specific Aims and Methods:

Time Flow Analysis:

- Aim: to measure the efficiency of current endoscopic ear surgery and provide areas where instrumentation redesign is required. Method: measure the duration of predetermined steps during endoscopic ear surgery as well as the number of changes between instruments

Survey:

- Aim: understand the reason why ear surgeons are not using endoscopic ear surgery and what would increase its use. Method: Following a two-round Delphi method: 1) preliminary survey developed by talking to local ear surgeons 2) first round of survey sent out to members of otology societies globally (provides a wide range of surgical experience & environments) 3) qualitative results are analyzed, using a statistical approach, to categorize answers and generate more specific questions 4) send out these new questions for round two of the survey 5) analyze and present results

Expected Outcomes and Significance:

From discussions with project investigator (an endoscopic ear surgeon) and his colleagues:

- Disadvantages: one handed surgery is difficult, bleeding control with one hand and limited space
- Advantages: better visualization within hidden recesses in middle ear, low patient morbidity, minimally invasive surgery advantages
- Understanding the needs for TEES in order to design instruments better suited for the surgery aims to encourage surgeons to adopt endoscopic ear surgery
- This study can also be applicable to other types of minimally invasive surgery performed through natural orifices in the body; can provide a means of developing better instruments for these other types of minimally invasive surgery

References:

1. Cohen MS, Landegger LD, Kozin ED, Lee DJ. Pediatric endoscopic ear surgery in clinical practice: Lessons learned and early outcomes. Laryngoscope [Internet]. 2015;n/a – n/a. Available from: http://doi.wiley.com/10.1002/lary.25410

2. Kanona H, Virk JS, Owa A. Endoscopic ear surgery: A case series and first United Kingdom experience. World J Clin cases [Internet]. 2015;3(3):310–7. Available from: http://www.pubmedcentral.nih.gov/articlerender.fcgi?artid=4360503&tool=pmcentrez&rendertype=abstract

3. Rube MA, Fernandez-gutierrez F, Cox BF, Holbrook B, Houston JG, White RD, et al. HHS Public Access. 2015;10(5):637–50.

4. Hsiao KC, Machaidze Z, Pattaras JG. Time Management in the Operating Room : An Analysis of the Dedicated Minimally Invasive Surgery Suite. 2004;300–3.

5. Marcus HJ, Cundy TP, Hughes-hallett A, Yang Z, Darzi A, Nandi D, et al. Europe PMC Funders Group Endoscopic and Keyhole Endoscope-assisted Neurosurgical Approaches : A Qualitative Survey on Technical Challenges and Technological Solutions. 2015;28(5):606–10.

6. Yong M, Mijovic T, Lea J. Endoscopic ear surgery in Canada : a cross-sectional study. J Otolaryngol - Head Neck Surg [Internet]. Journal of Otolaryngology - Head & Neck Surgery; 2016;1–8. Available from: http://dx.doi.org/10.1186/s40463-016-0117-7

Arushri Swarup 998866071 BME1450 Proposal Outline 17-Oct-2016
