arushriswarup/Grad-School/Needs Analysis Survey/superceded/Needs Analysis Survey Paper 05-Sept-2017.docx

The Current Limitations and Future Direction of Instruments in Totally Endoscopic Ear Surgery: A Needs Analysis Survey.

Short title: Current Limitations and Future Direction of Instruments in Totally Endoscopic Ear Surgery.

Arushri Swarup BASc¹,², Gavin J. le Nobel, BSc.Eng MD FRCSC²,³, Adrian James¹,²,³ MA DM FRCS.

¹Hospital for Sick Children, Toronto, ON

²Institute of Biomaterials and Biomedical Engineering, University of Toronto, Toronto, ON

³Department of Otolaryngology Head and Neck Surgery, University of Toronto, Toronto, ON

Corresponding author:

Dr. Adrian James

Phone: (416) 813-4938

Fax: (416) 813-5036

Hospital for Sick Children

555 University Avenue

Toronto ON, Canada, M5G 1X8

email: adr.james@utoronto.ca

Sources of funding:

Director’s Innovation Award, Institute of Biomaterials and Biomedical Engineering, University of Toronto

Department of Otolaryngology – Head & Neck Surgery, Hospital for Sick Children

# Needs Analysis Survey Paper

## Journal

Otology & Neurotology - http://edmgr.ovid.com/on/accounts/ifauth.htm

Basic Science Reports: - 3500 words. This count does not include the abstract, references, tables, or figure legends.

- 6 main figures and tables. Individual figures may consist of figure parts (Figure 1A, 1B, etc), but additional figures and tables should be submitted as Supplemental Digital Content.
- Title page – submitted as a separate word document

## Abstract:

250 words

Hypothesis: Brief, clear statement of the main goals of the investigation.
Background: Concise; designed for orientation of the reader who is unfamiliar with this line of investigation.
Methods: Succinct summary of techniques and materials used.
Results: Include statistical measures where appropriate.
Conclusion: Include only those directly supported by data generated from this study. Emphasize clinical relevance wherever possible.

## Introduction:

Endoscopes provide direct access and a wide angle view into the middle ear, reducing the time required to gain access, drill bone for exposure and close during middle ear surgery and are able to visualize hidden recesses within the middle ear including: the sinus tympani, anterior and posterior epitympanum and hypotympanum [1][2][3][4]. As well, the endoscope allows visualization past the shaft of the instrument, such as the drill, which is a problem during microscopic surgery[5].

Despite the enthusiasm of some otologists, endoscopic ear surgery has a low acceptance rate[6][7]. The principal challenge with TEES is that a one-handed surgical technique is required as the endoscope is held in the other hand[6][8]. During traditional surgery, the non-dominant hand usually maintains suction and removes blood from the operative field while the dominant hand performs the delicate maneuvers [8]. Otologic instruments were developed for two-handed microscope-guided surgery so they are not optimized for the TEES environment. As otologists have been trained and gained experience in microscope-guided ear surgery, they have developed techniques with the according instruments and have become accustomed to a two-handed surgical approach. By learning different surgical techniques and gaining experience with the endoscope, most surgeons find that they can complete more cases totally endoscopically [9][6][1][8].

Technological advances in the design of the endoscope, camera and suction dissection instruments have lead to incremental stepwise jumps in this learning curve [10]. In order to further develop technology and instruments to facilitate TEES, it is important to understand the specific challenges experienced during TEES. It is proposed that in order to facilitate TEES, the needs of surgeons and current limitations of tools must be determined.

We hypothesize that otologists need better instrumentation to facilitate specific challenges posed by TEES. Further, we hypothesize that otologists performing greater proportions of surgeries using TEES will experience different challenges than those who use TEES less frequently. Similarly, we hypothesize that those surgeons who use specialized TEES instrument sets may experience different challenges that those who do not. To this end, we conducted a mixed-methods study to explore these hypotheses.

## Materials and Methods:

### Study Design:

Ethics approval was obtained for this study from the institution’s Research Ethics Board (REB number: 1000055626, Principal Investigator: Dr. Adrian Lewis James).

This cross-sectional study employed a mixed-methods self-administered online questionnaire consisting of nine questions. The responses were scored using multiple choice, yes/no, an analog scale and an open-ended free-text response. The analog scale was anchored with verbal descriptions to ensure comparability between participants, while facilitating parametric statistical analysis. Participant demographics included the percentage of middle ear surgeries performed using TEES as well as whether the surgeon uses a specialized TEES instrument set. Participants were asked the degree to which an instrument that addresses the following challenges would be of use to the participant: i) bleeding control ii) keeping the endoscope lens clean iii) cutting and/or removing bone iv) reaching structures visualized by the endoscope v) dissection and removal of cholesteatoma vi) moving and positioning a graft into the intended place.

In addition, participants were asked to identify any other types of instruments that they would find useful while performing TEES. The questionnaire content was developed through a literature search on challenges experienced during TEES and the clinical experience of the principal author and his colleagues. Using this data, a preliminary questionnaire was developed and piloted amongst local otologists with varying degrees of TEES experience. The results of the pilot questionnaire were used to create the final concise questionnaire that was distributed internationally.

### Participants and Data Collection:

We identified otologists who attended the 2nd World Congress of Endoscopic Ear Surgery, members of the International Working Group of Endoscopic Ear Surgery and attendees of a TEES course in Japan. After obtaining REB approval, these otologists were invited to participate in the survey. The beginning of the online survey includes a letter of information and informed consent was assumed upon anonymous completion of the questionnaire. All information was stored anonymously.

### Data Analysis:

Visual analog scales were quantified and the means as well as the 95% confidence intervals were established. ANOVA was used to determine which challenge presented the greatest degree of need. The Kruskall-Wallis H-test was used to determine if the percentage of cases done with TEES influenced the degree of need for each challenge. The t-test was used to determine if use of a specialized TEES instrument set affected the degree of need for each challenge. Qualitative data was analyzed by grouping the responses into themes/categories which would describe additional difficulties those tools would address. Statistical analysis was performed using JPM statistical analysis software (JMP version 13.0; SAS Institute; Cary, NC).

## Results:

### Study Participants and Demographics

The questionnaire was distributed to a total of _____ surgeons and 51 surgeons completed the questionnaire with an overall response rate of <???>. 16 attendees at the 2nd World Congress on Endoscopic Ear Surgery, six attendees of the Japanese course, and 26 members of the International Working Group on Endoscopic Ear Surgery (IWGEES) responded. Of the respondents, 4 (8.1%) do not perform any surgeries using TEES, 15 (30.6%) perform up to 50% of surgeries using TEES, 20 (40.8%) perform 50-90% of surgeries using TEES, and 10 (20.4%) perform greater than 90% of surgeries using TEES. Thirty eight (77.6%) of respondents use specialized TEES instrument sets.

Figure XXX. Mean degree of need reported for each TEES challenge. The error bars indicate standard error, n = 51.

### Challenges during TEES that exhibit the greatest degree of need by surgeons:

The average degree of need exceeded 50% for all challenges. Reaching structures visualized by the endoscope resulted in the highest degree of need (mean 83%, 95%CI 76-89%) although the degree of need was not statistically different from the degree of need for dissecting and removal of cholesteatoma. Conversely, positioning the graft resulted in the lowest degree of need (mean 58%, 95%CI 52-65%), although this was not statistically different from the degree of need for keeping the endoscope clean.

### Effect of percentage of surgeries performed totally endoscopically on TEES challenges:

There was a statistically significant difference in the degree of need for reaching structures and for positioning a graft, depending on the percentage of surgeries performed endoscopically. For reaching structures, X²(2) = 8.9481, p = 0.0300 with mean scores of 76, 72, 88, and 92, respectively, for surgeons who perform none, 0 – 50%, 50 – 90%, and greater than 90% of surgeries using TEES. For positioning a graft, X²(2) = 12.8438, p = 0.0050 with mean scores of 50, 44, 60, and 81, respectively, for surgeons who perform none, 0 – 50%, 50 – 90%, and greater than 90% of surgeries using TEES. The remainder of challenges were not significantly dependent on the proportion of cases performed using TEES

### Effect of using a specialized TEES instrument set on TEES challenges experienced:

Respondents who used a specialized TEES instrument set had a significantly lower mean degree of need for positioning a graft than those who did not use a specialized set, with means of 55 and 71 respectively (p=0.002)

### Qualitative Results:

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

When asked _____ question_______, 30 comments were received and many of the comments suggested identified a need for the development of instruments that could address multiple challenges faced in TEES. The comments included 8 (27%) addressing the need to reach structures, 10 (33%) addressing the need for improved dissection and removal of cholesteatoma, 4 (13%) addressing the need for improved bone removal, 6 (20%) addressing the need for improved bleeding control, and 1 (3%) addressing the need for keeping the lens clean). No comments specifically addressed the need for development of instruments to address the challenge of positioning the graft.

Ten (33%) comments suggested improvements to instruments to address challenges arising from a need to reach structures and remove cholesteatoma. Four (13%) of these comments identified a need for different curved suctions and another 2 (13%) comments identified a need for additional curved instruments to reach into middle ear recesses and the mastoid. A need for suctions and instruments specifically designed to access the sinus tympani were identified in 4 (13%) comments. Two (7%) comments identified a need for flexible instruments to reach the mastoid and middle ear recesses in TEES. Four (13%) respondents identified a need for improving bone removal techniques in endoscopic surgery with 2 comments focusing on improving visualization with drilling alongside endoscopes and 2 comments focusing on further development of piezoelectric surgical instruments. Three (10%) comments suggested developing new instruments to manage bleeding, with two (7%) focusing on coagulating instruments such as bipolar. One (3%) comment suggested development of an instrument combining suction with bipolar to facilitate hemostasis. One (3%) comment identified a need for modification of endoscope such that there would be a continuously cleaning lens. No comments suggested development of new instruments to help position grafts in TEES.

Eight (27%) comments from respondents focused on modifications to endoscopes and the use of endoscopes in TEES. Four comments identified a need for endoscope holders to facilitate two handed operating with a stationary endoscope. Two comments focused on improving visualization using endoscopes that are flexible or endoscopes with a continuously cleaning lens. One comment identified a need for more instruments with curved shafts to facilitate working alongside the endoscope.

From the comments regarding instrumentation to facilitate TEES, 10 out of 21 responses described an instrument that combines suction with another function, such as dissection, cautery and reach via shaft shape. 10 comments described an instrument that could reach areas better and four comments mentioned a tool that combined reach and suction. Four described an instrument to hold the endoscope and four comments described an instrument that could drill bone while combining irrigation and suction or with better visualization.

## Discussion:

We have conducted a cross-sectional mixed-methods survey to identify, quantify, and describe the challenges otologists face with TEES. A survey on TEES for Canadian otologists has reported that 11% of otologists in Canada use TEES for cholesteatoma, tympanoplasty, and ossicular reconstruction surgeries and they find the following factors difficult about TEES: single-handed surgery, efficiency/operative time, technical difficulty, cost, managing bleeding [6]. This questionnaire was intended to build upon this research by measuring the degree to which surgeons experience specific challenges during surgery and whether they could be addressed by a specialized surgical tool. While previous studies have sought to identify challenges experienced during specific TEES surgeries, fewer studies have attempted to identify these challenges as well as instruments that could address these challenges. This survey included respondents internationally to get a world-wide response on what challenges during TEES require instrumentation.

Reaching Structures & Dissection & Removal of Cholesteatoma

While endoscopes facilitate excellent visualization, reaching structure as well as dissection and removal of cholesteatoma remain significant challenges in TEES surgery. Difficult to reach anatomical recesses include the sinus tympani, facial recess, and anterior epitympanic recess [3]. As a result of inadequate access, patients may be at increased risk of residual disease if these areas are involved with cholesteatoma[15][16]. Further, surgeons may have to modify their approach to reach these areas, potentially necessitating a post-auricular approach or additional bone removal with a TEES approach thus resulting in more aggressive surgery. While specialized instruments with curved tips have been developed to address this, the curves in the shafts are fixed and there are areas where these instruments still cannot reach [3].

These challenges were found to have the greatest need by respondents on visual analog scale. Further, when asked about need for development or modification of new instruments, more than 30% of the comments focused on the need for instruments that address these challenges. This indicates that otologists struggle with these aspects of endoscopic ear surgery. The degree of need for reaching structures was lower for surgeons who perform a lower proportion of cases using TEES. This may be because surgeons who perform lower proportions of cases using TEES may be more likely to use a microscope when they need to access deep recesses in the middle ear and mastoid. As a result, this may result in a lower degree of need for reaching structures for their TEES cases where as for surgeons who perform more difficult using TEES, this may remain a challenge with a significant degree of need. Interestingly, the degree of need for these challenges did not differ amongst respondents depending on use of specialized TEES instrument sets. This suggests reaching structures as well as dissection and removal of cholesteatoma remain significant challenges despite current specialized TEES instrument sets. Certainly, these results suggest that future instrument development should focus on instruments that improve our ability to reach structures and facilitate dissection and removal of cholesteatoma.

### Cutting and removing bone

Cutting and removing bone allows visualization of and access to areas within the middle ear that cannot be seen by the endoscope or reached by existing instruments. While straight and angled endoscopes facilitate a broader field of view than line-of-sight microscopic surgery, bone removal may still be necessary for visualization and access of recesses within the middle ear and mastoid. Currently, bone removal can be accomplished with bone curettes, osteotomes, drills, and piezoelectric bone instruments. Nevertheless, this was still found identified as the challenge with the third greatest degree of need in our survey. This may relate to some of the limitations with each of the current bone removal techniques: bone curettes offer precise bone removal, however, bone removal is slow and removal of large amounts of bone may be difficult; osteotomes may be imprecise working along endoscopes in the confines of the middle ear; drills may be difficult to use alongside endoscopes and bone dust from drilling may impair visualization with the endoscopes; Pizeoelectic surgical instruments, while effective, are very expensive. The degree of need was not significantly dependent on use of a specialized TEES instrument set or the proportion of middle ear cases accomplished with TEES.

-suggested future design focus?

### Bleeding control

-discuss the nature of the challenge

-identified this as a challenge

-compare this to existing literature on the topic (i.e. did we identify this as being a greater concern? Subgroup analyses?)

-discuss existing methods managing bleeding

-discuss potential future ways of managing

Management of intraoperative bleeding represents a significant challenge when performing TEES. Intraoperative bleeding may impair surgical field clarity and obscure target tissues and this may lead to increased rates of residual cholesteatoma [15]. To manage this, techniques such as hypotensive anesthesia, patient positioning, local vasoconstrictors, and atraumatic surgical techniques have been employed[8][14][15]. In addition, specialized instrument sets have been developed specifically to improve bleeding management in TEES [3]. These instruments incorporate a functional tip with a suction shaft to allow for cutting, dissecting or elevating tissues while suctioning[3]. Previous studies have identified management of intraoperative bleeding as a significant challenge faced by otologists when performing TEES (by 24% of Canadian Otologist respondents in Lea et al.’s survey)[5][6][3][4][14]. Our study confirms this finding. Our study confirms that this is a challenge with a significant degree of need on visual analog scales. Interestingly, despite that fact specialized TEES instrument sets are specifically designed to address this challenge, the degree of need for those who used specialized TEES instrument sets was not significantly different from those who did not.

Moreover, from this questionnaire, bleeding control exhibited a mean need of 67% and nine of the seventeen comments from respondents described that an instrument combining suction with another functionality, such as dissecting, cauterizing or reaching, would be beneficial for TEES.

### Keeping the endoscope lens clean

Fogging and smearing of the endoscope tip is a challenge of TEES and surgeons must pause surgery, remove the fogged lens, and wipe it clean on a defog pad periodically[3][14]. This can be time consuming during surgery. Moreover, compromised visualization may potentially increase the risk injury to middle ear structures or the tympanomeatal flap as the instruments and endoscopes are repeatedly introduced and removed from the ear to facilitate cleaning the endoscope lens. Keeping the endoscope lens clean was identified as the challenge with the second lowest degree of need in our survey, however, the mean degree of need still exceeded 60%. Currently, this is managed by … ?

### Moving and positioning a graft into the intended place

In tympanoplasty surgery, the approach, graft material and graft placement technique vary depending on the training, case load, resources and experience available to the surgeon [18]. During TEES tympanoplasty the graft must be inserted into the ear canal and positioned single handedly in the desired orientation [18]. Performing this technique single handedly is, in the authors’ experience, quite challenging. Nevertheless, this was identified as the challenge with the lowest mean degree of need.

and so perhaps a tool that facilitates graft manipulation would be helpful for TEES surgeons. Lea and Mijovic show that cartilage or graft placement is easier when using two hands in a surgery video [8]

### Implications of the Findings

The findings from this needs analysis study can be used for future development of tools to facilitate TEES or to develop training/teaching models. The team hopes that otologists will continue to study the needs of TEES to continually improve upon the technology available to facilitate its use (?????).

### Limitations

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

## Conclusion:

key findings

review main outcome measures

compare key findings with other literature

limitations of study

# References:

[1] M. S. Cohen, L. D. Landegger, E. D. Kozin, and D. J. Lee, “Pediatric endoscopic ear surgery in clinical practice: Lessons learned and early outcomes,” Laryngoscope, p. n/a-n/a, 2015.

[2] H. Kanona, J. S. Virk, and A. Owa, “Endoscopic ear surgery: A case series and first United Kingdom experience.,” World J. Clin. cases, vol. 3, no. 3, pp. 310–7, 2015.

[3] M. Badr-el-dine, “Instrumentation and Technologies in Endoscopic Ear Surgery,” Otolaryngol. Clin. NA, vol. 46, no. 2, pp. 211–225, 2013.

[4] M. L. Bennett, D. Zhang, R. F. Labadie, and J. H. Noble, “Comparison of Middle Ear Visualization With Endoscopy and Microscopy,” Otol. Neurotol., vol. 37, pp. 362–366, 2016.

[5] M. Tarabichi, “Endoscopic Middle Ear Surgery,” Ann. Otol. Rhinol. Laryngol., vol. 108, no. 1, pp. 39–46, 1999.

[6] M. Yong, T. Mijovic, and J. Lea, “Endoscopic ear surgery in Canada : a cross-sectional study,” J. Otolaryngol. - Head Neck Surg., pp. 1–8, 2016.

[7] S. C. Prasad, A. Giannuzzi, E. A. Nahleh, G. De Donato, A. Russo, and M. Sanna, “Is endoscopic ear surgery an alternative to the modified Bondy technique for limited epitympanic cholesteatoma?,” Eur. Arch. Oto-Rhino-Laryngology, vol. 273, no. 9, pp. 2533–2540, 2016.

[8] T. Mijovic and J. Lea, “Training and Education in Endoscopic Ear Surgery,” Curr. Otorhinolaryngol. Rep., vol. 3, no. 4, pp. 193–199, 2015.

[9] A. L. James, “Endoscopic Middle Ear Surgery in Children.,” Otolaryngol. Clin. North Am., vol. 46, no. 2, pp. 233–44, Apr. 2013.

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

[11] A. Celenza and I. R. Rogers, “Comparison of visual analogue and Likert scales in evaluation of an emergency department bedside teaching programme,” EMA - Emerg. Med. Australas., vol. 23, no. 1, pp. 68–75, 2011.

[12] D. M. Marsh-richard, E. S. Hatzis, C. W. Mathias, N. Venditti, D. M. Dougherty, and W. Forest, “Adaptive Visual Analog Scales (AVAS): A Modifiable Software Program for the Creation, Administration, and Scoring of Visual Analog Scales,” Heal. (San Fr., vol. 41, no. 1, pp. 99–106, 2009.

[13] H. T. and P. Filzmoser, “Benefits from Using Continuous Rating Scales in Online Survey Research,” J. Econ. Soc. Meas., vol. 4, no. November, p. 25, 2009.

[14] E. D. Kozin, R. Kiringoda, and D. J. Lee, “Incorporating Endoscopic Ear Surgery into Your Clinical Practice,” Otolaryngol. Clin. North Am., vol. 49, no. 5, pp. 1237–1251, 2016.

[15] G. J. le Nobel, S. L. Cushing, B. C. Papsin, and A. L. James, “Intraoperative Bleeding and the Risk of Residual Cholesteatoma,” Otol. Neurotol., vol. 38, no. 4, pp. 529–534, 2017.

[16] J. L. Sheehy, “Cholesteatoma Surgery in Children,” The American journal of otology, vol. 6, no. 2. pp. 170–2, 1985.

[17] B. M. Hanna et al., “Minimally invasive functional approach for cholesteatoma surgery,” Laryngoscope, vol. 124, no. 10, pp. 2386–2392, 2014.

[18] A. L. James and B. C. Papsin, “Ten Top Considerations in Pediatric Tympanoplasty,” Am. Acad. Otolaryngol. - Head Neck Surg., no. September, pp. 992–998, 2012.

[19] H. J. Marcus et al., “Europe PMC Funders Group Endoscopic and Keyhole Endoscope-assisted Neurosurgical Approaches : A Qualitative Survey on Technical Challenges and Technological Solutions,” vol. 28, no. 5, pp. 606–610, 2015.
