arushriswarup/Grad-School/Conferences.docx

Conferences:

- Can’t submit the same thing for multiple conferences

Workspace study – Hamlyn Competition (paper not searchable on pubmed) June

http://embc.embs.org/2017/ - IEEE Engineering in Medicine and Biology Society

IWGEES conference – needs analysis April

Design of Medical Devices - http://www.dmd.umn.edu/ - April

Techna

Gallie Day - http://surgery.utoronto.ca/research/Gallie_Day_2016_-_Oral_Presentations_and_Abstracts.htm
