arushriswarup/Grad-School/Talk.docx

Talk

Theme – to show how to explore the limits of what can be done with pediatric endoscopic ear surgery

Dr. James – limits of disease adn anatomy

Me – how can we push those limits with improved instrument design

Promo for the needs analysis – show initial results and then ask

- Describe the problem and how to solve
- Show the model and different ways of approaching it
  - CONCENTRIC tubes
  - Wrist
- Show how we will test and develop them
- Pictures of the model
