arushriswarup/Grad-School/Coursework/Bioengineering Science/Kevin Thesis Proposal Comments.pdf

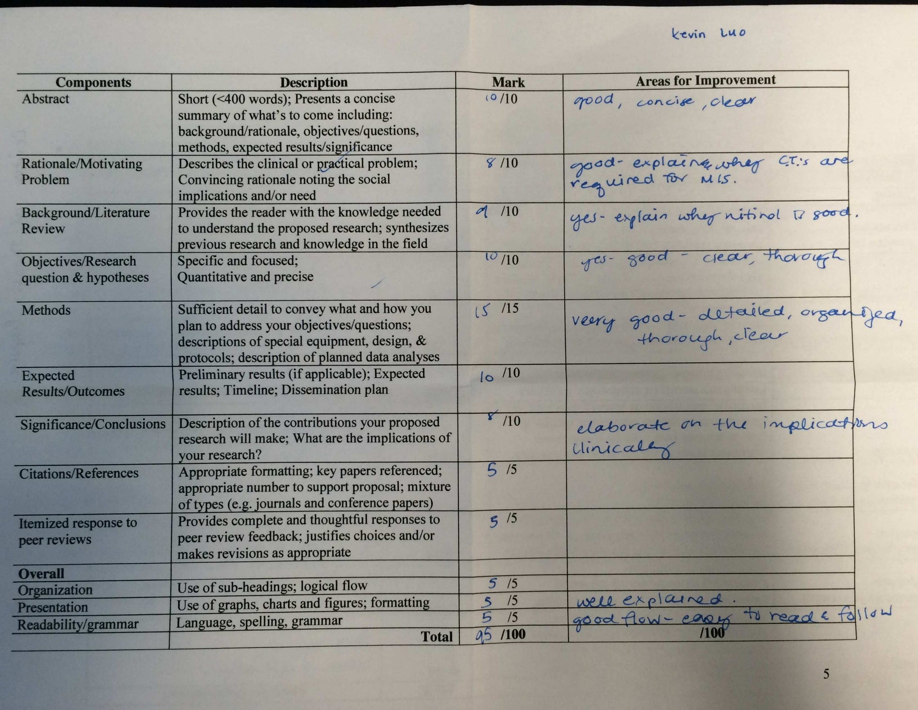
[picture p116: page 1]
