arushriswarup/Grad-School/Coursework/Bioengineering Science/Tianyu Thesis Proposal Comments.pdf

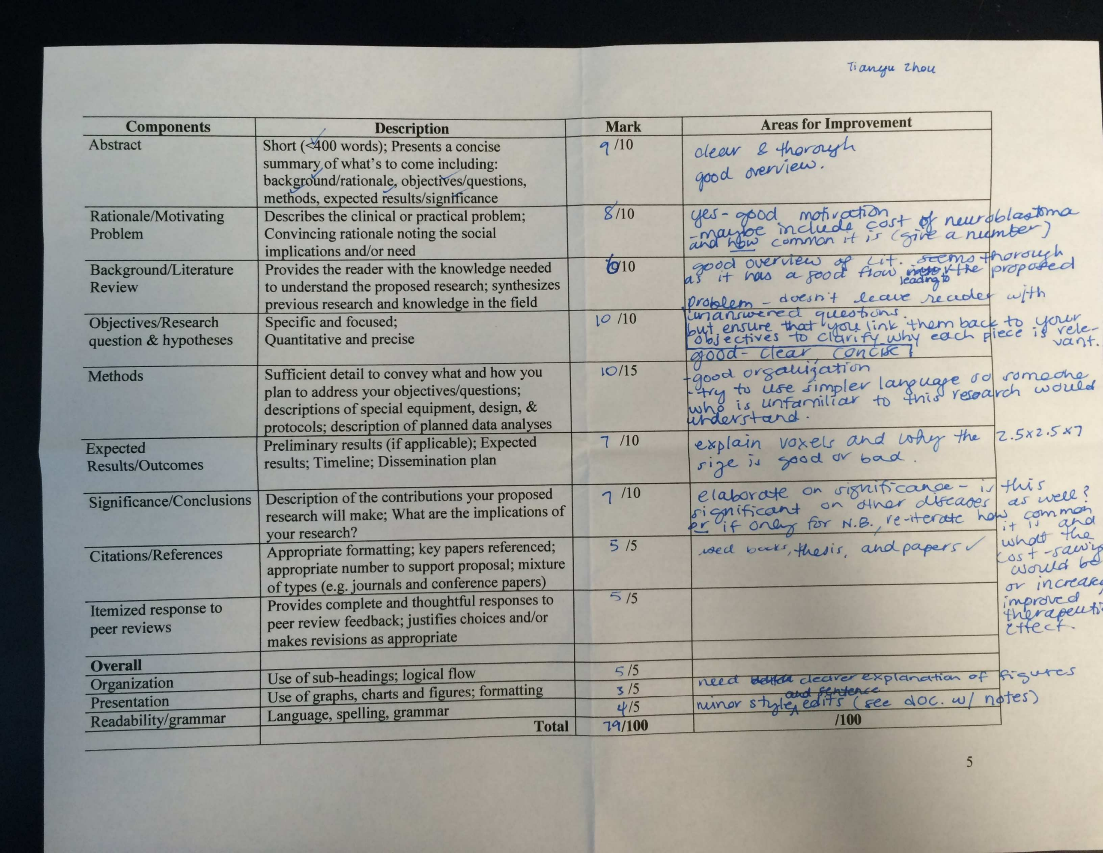
[picture p117: page 1]
