arushriswarup/Grad-School/Expenses/Receipts for Jan-2018 expense claim .pdf

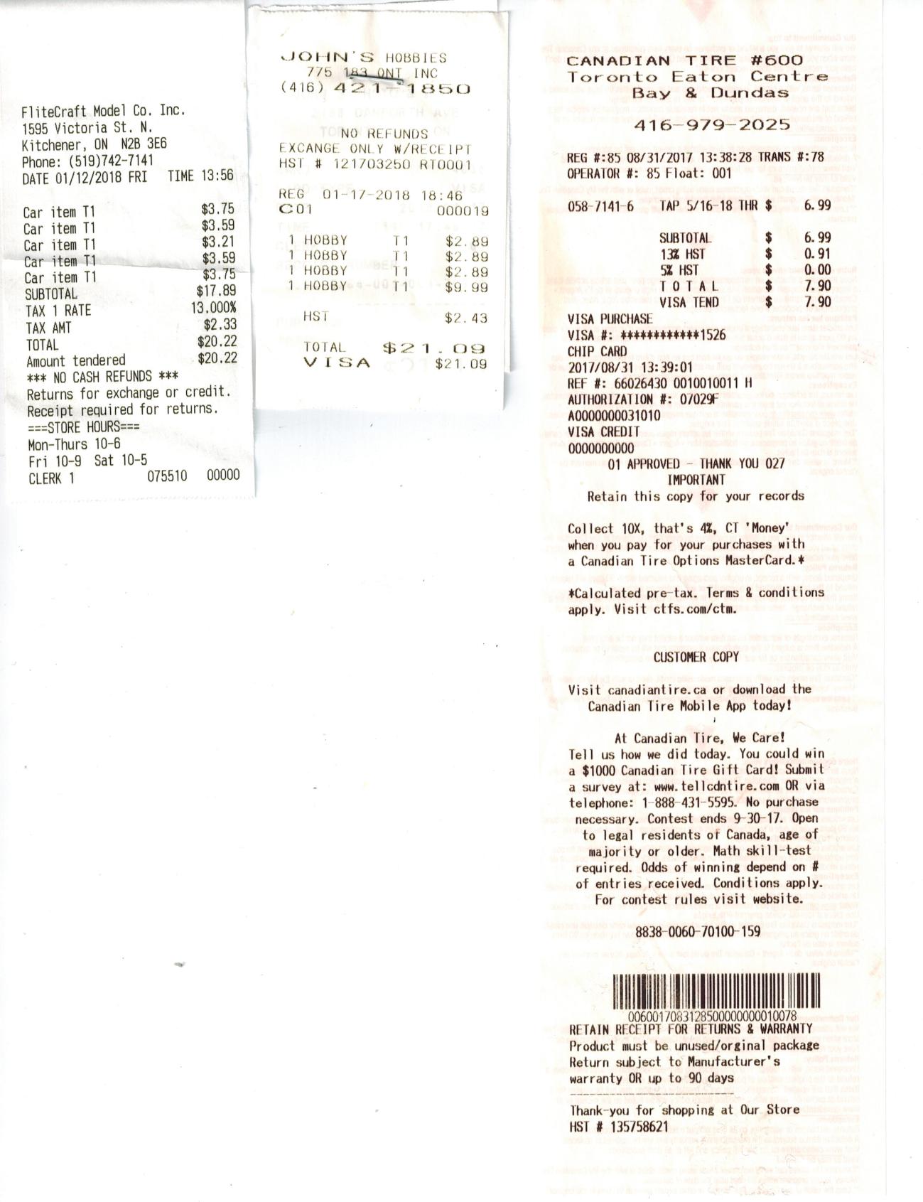
[picture p126: figure]

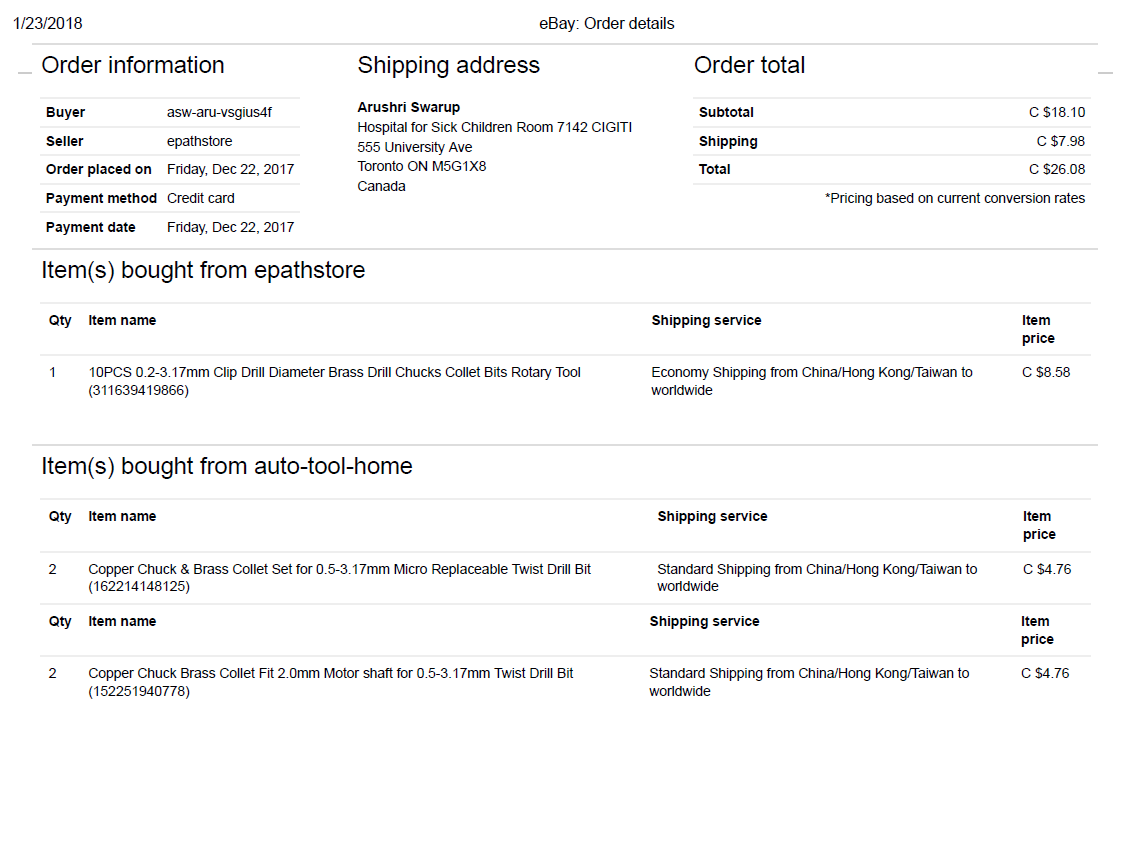
[picture p127: figure]
