arushriswarup/Grad-School/Coursework/signed TA application form 2017.pdf

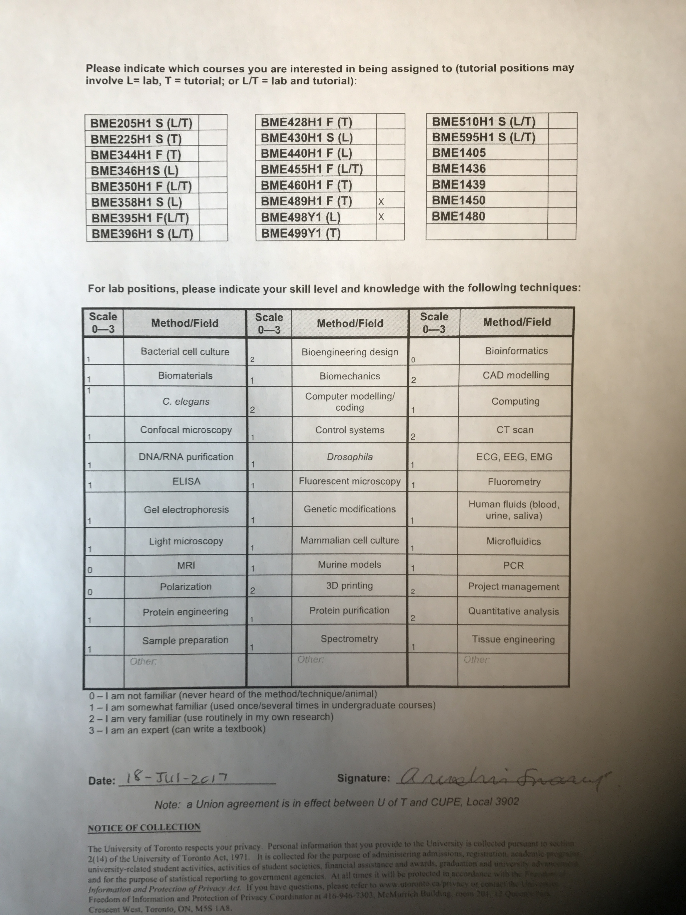
[picture p128: page 1]
