arushriswarup/Grad-School/Ear Surgery Instruments/T-Tube Inserter.pdf

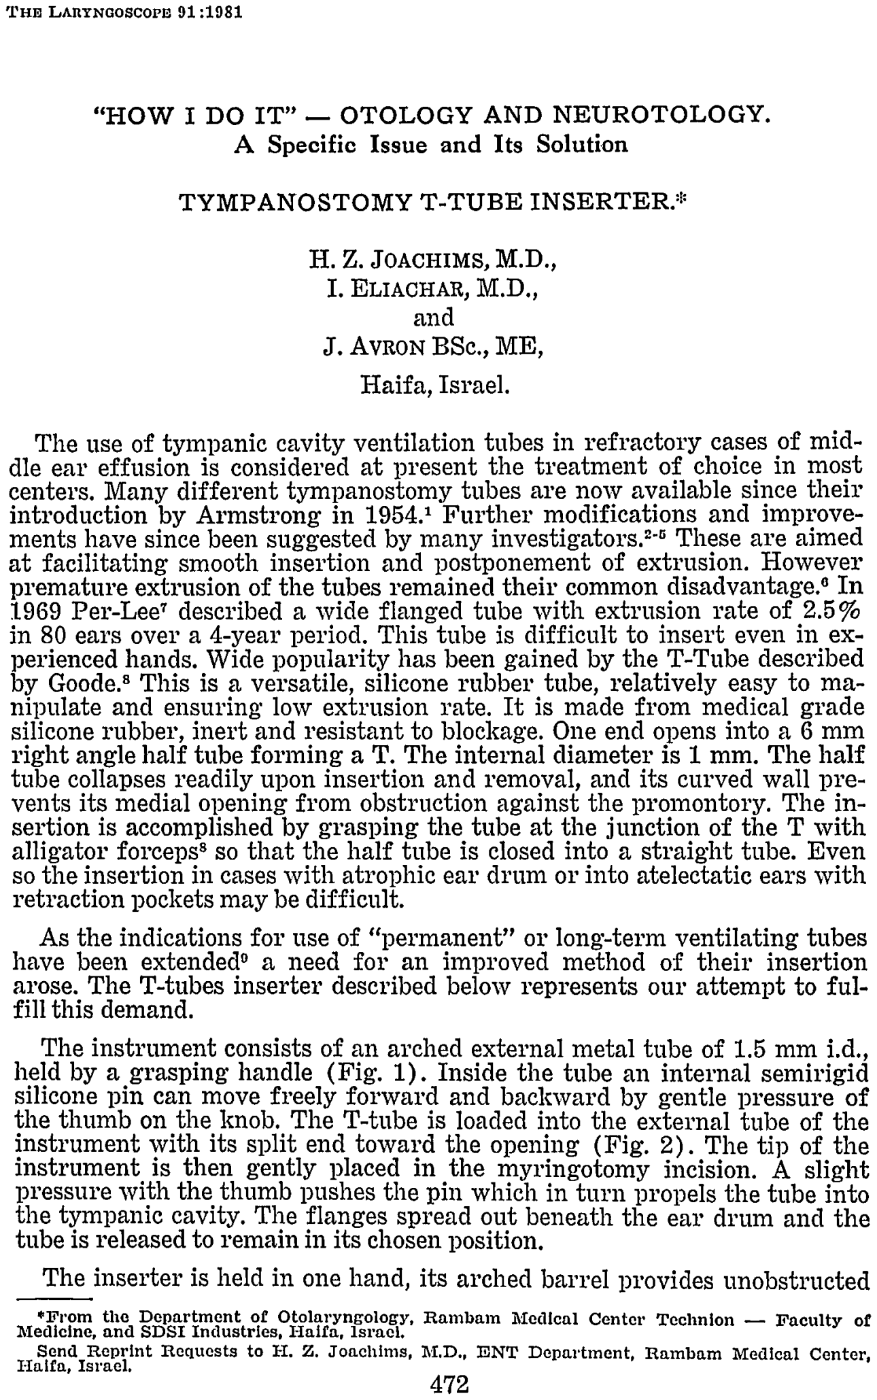
[picture p129: page 1]
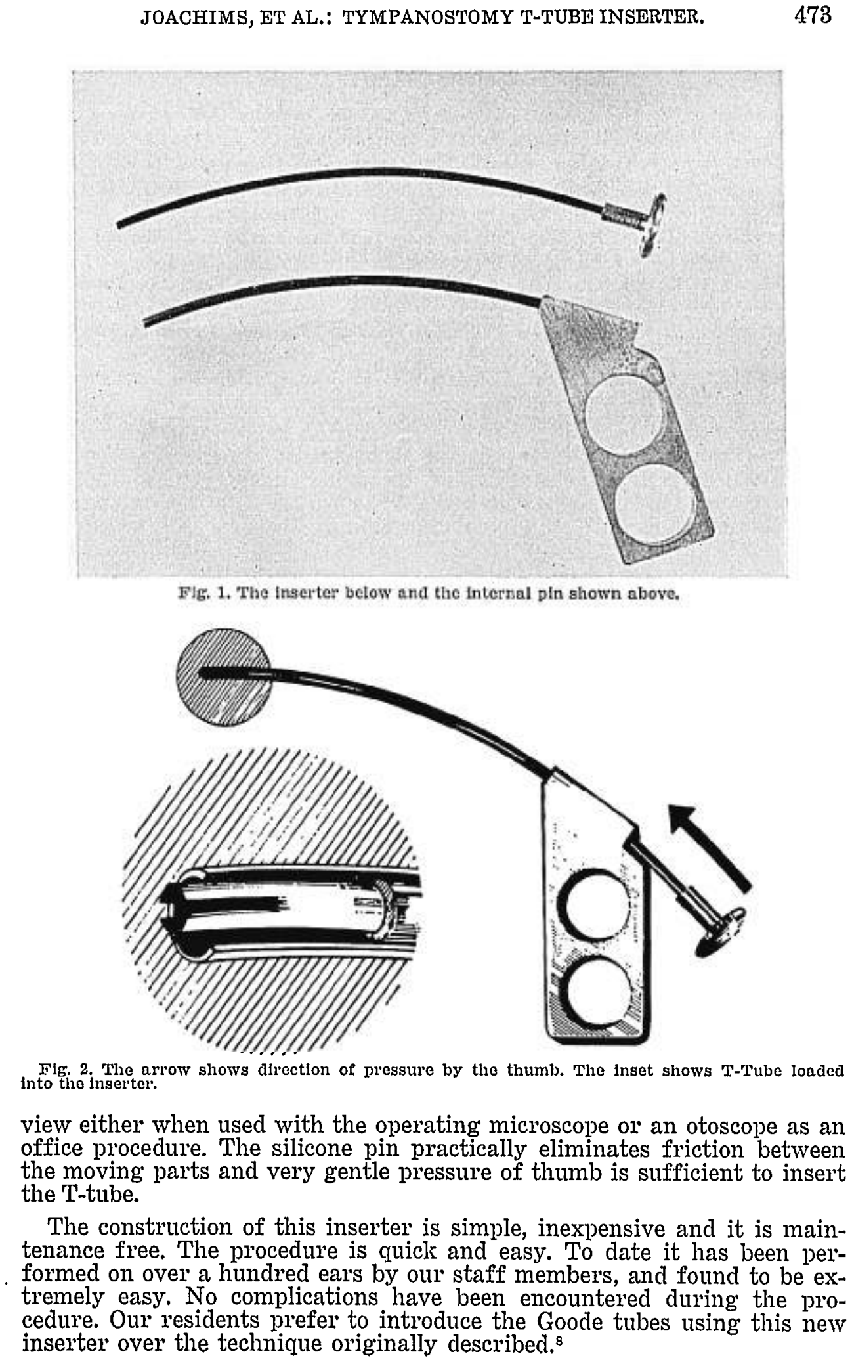
[picture p130: page 2]
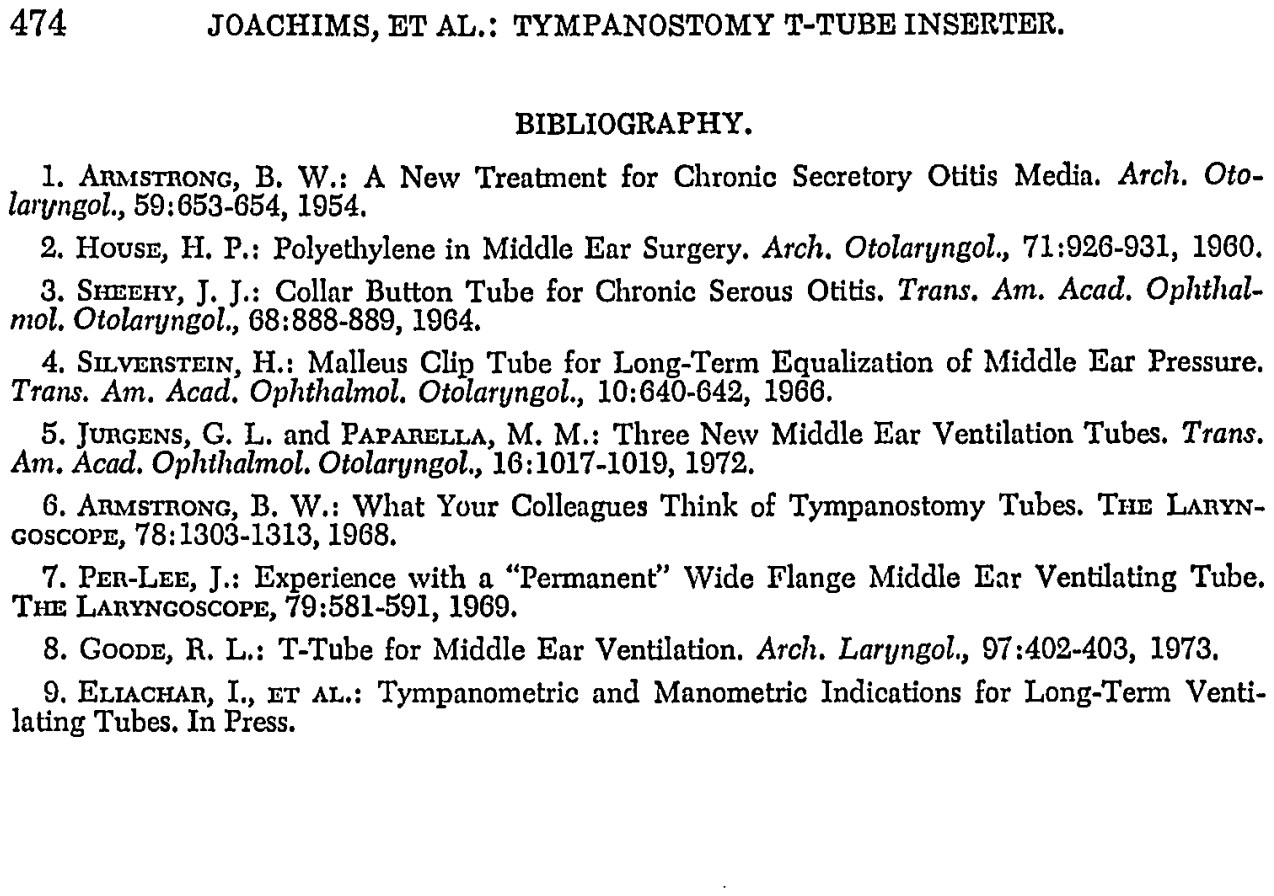
[picture p131: page 3]
