arushriswarup/Grad-School/HR Stipend and Admin/Direct deposit bank authorization.pdf

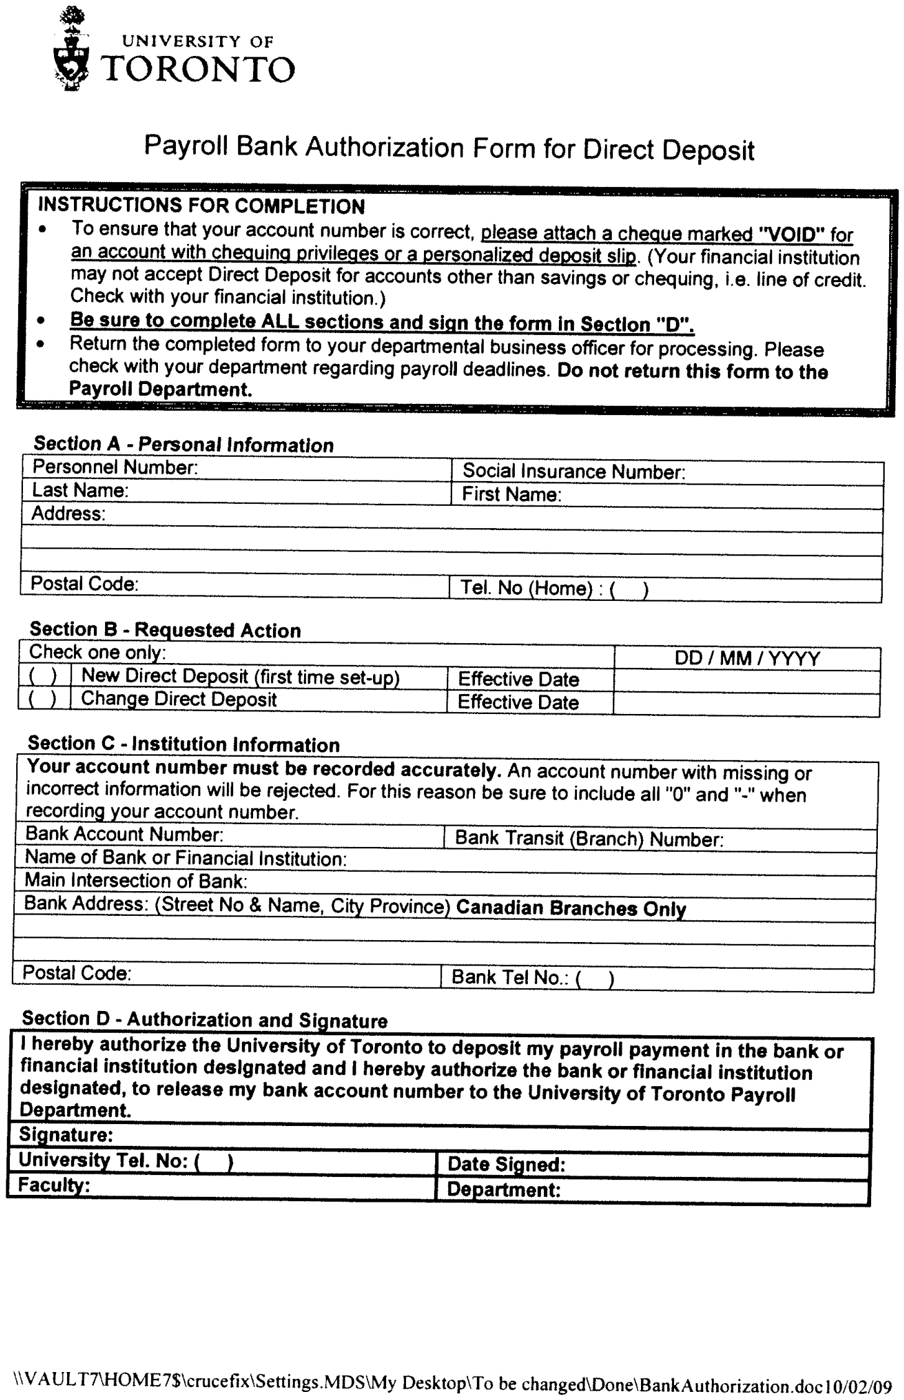
[picture p132: page 1]
