arushriswarup/Grad-School/HR Stipend and Admin/Graduate Stipend Form 2016-17.pdf

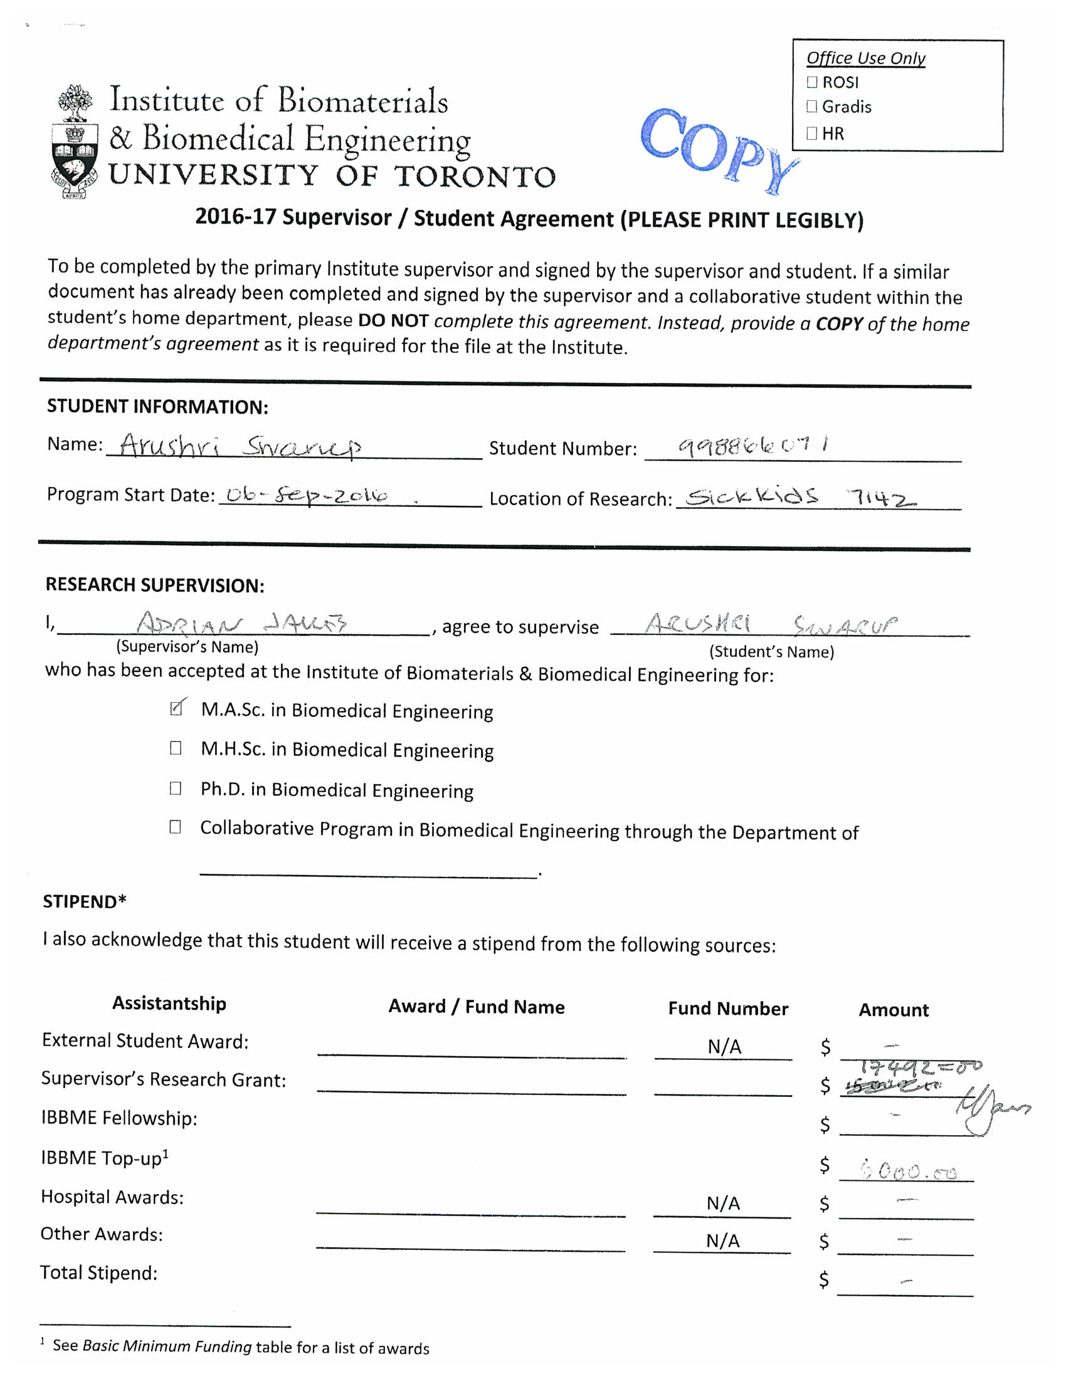
[picture p133: page 1]
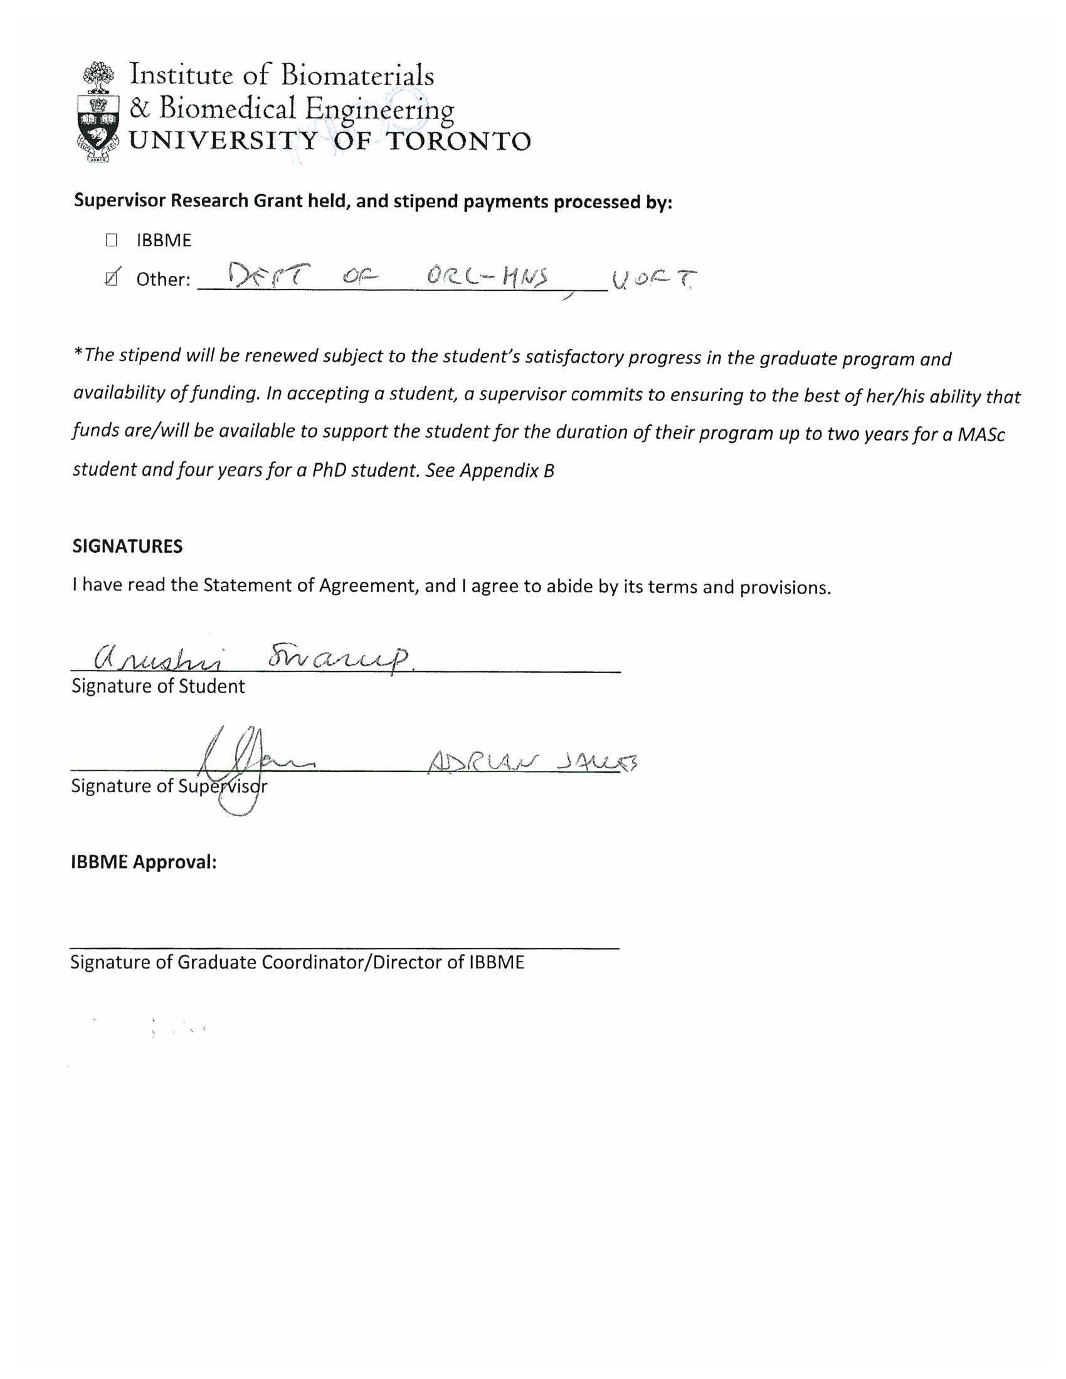
[picture p134: page 2]
