arushriswarup/Grad-School/HR Stipend and Admin/Signed offer of admission.pdf

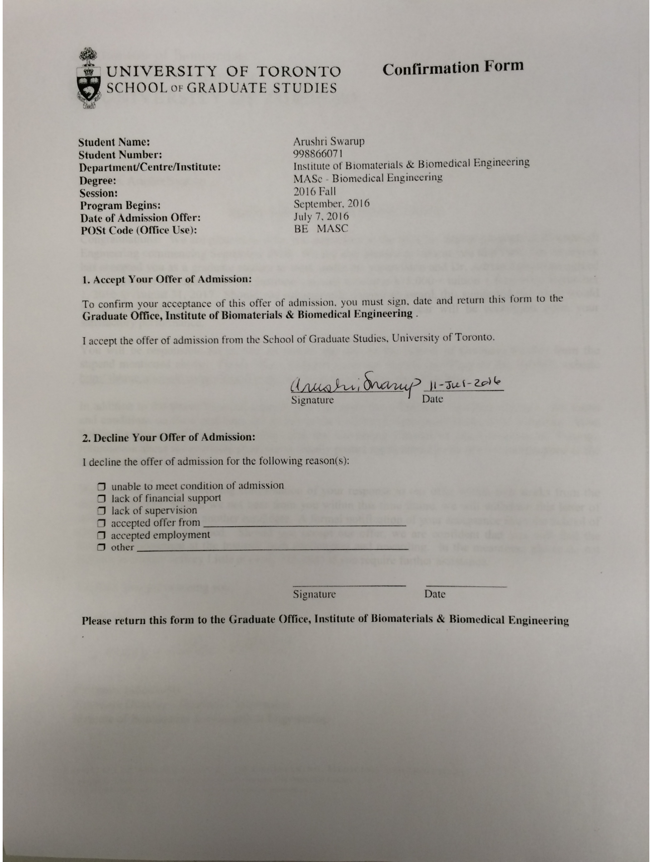
[picture p135: page 1]
