arushriswarup/Grad-School/UHN Observership/1.pdf

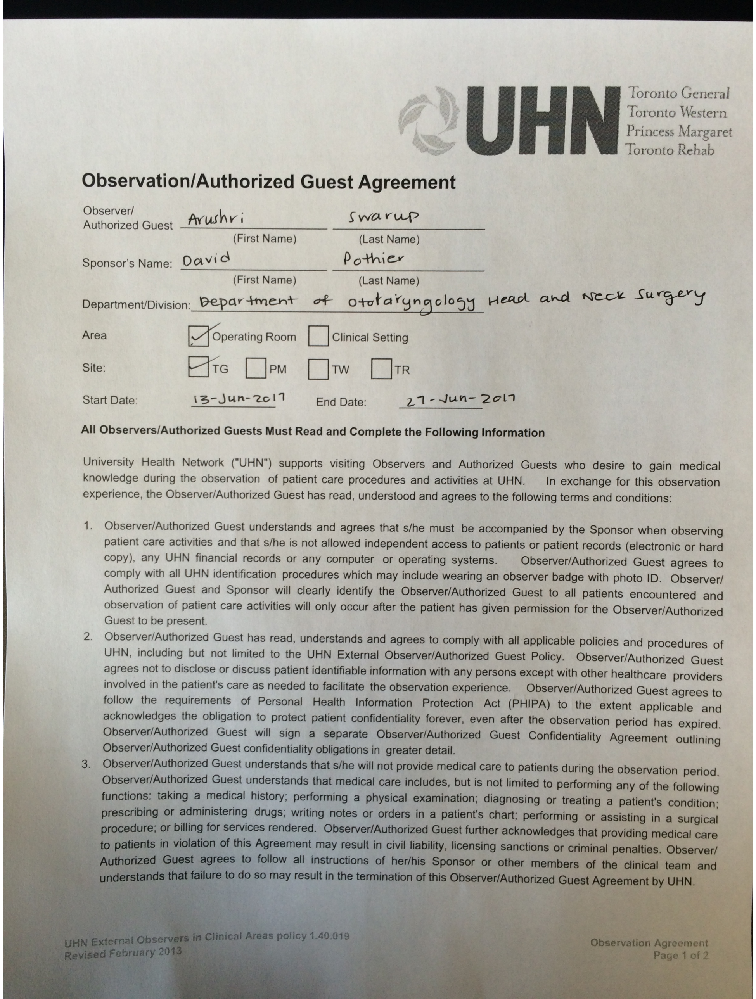
[picture p136: page 1]
