arushriswarup/Grad-School/UHN Observership/2.pdf

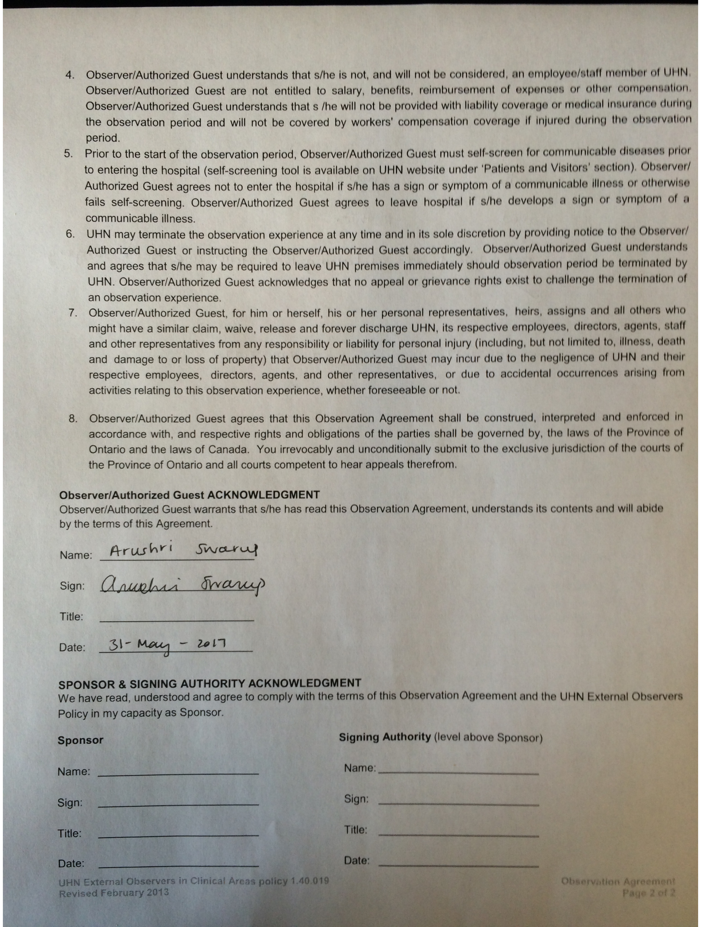
[picture p137: page 1]
