arushriswarup/Grad-School/UHN Observership/Observership_Dr. Pothier signed.pdf

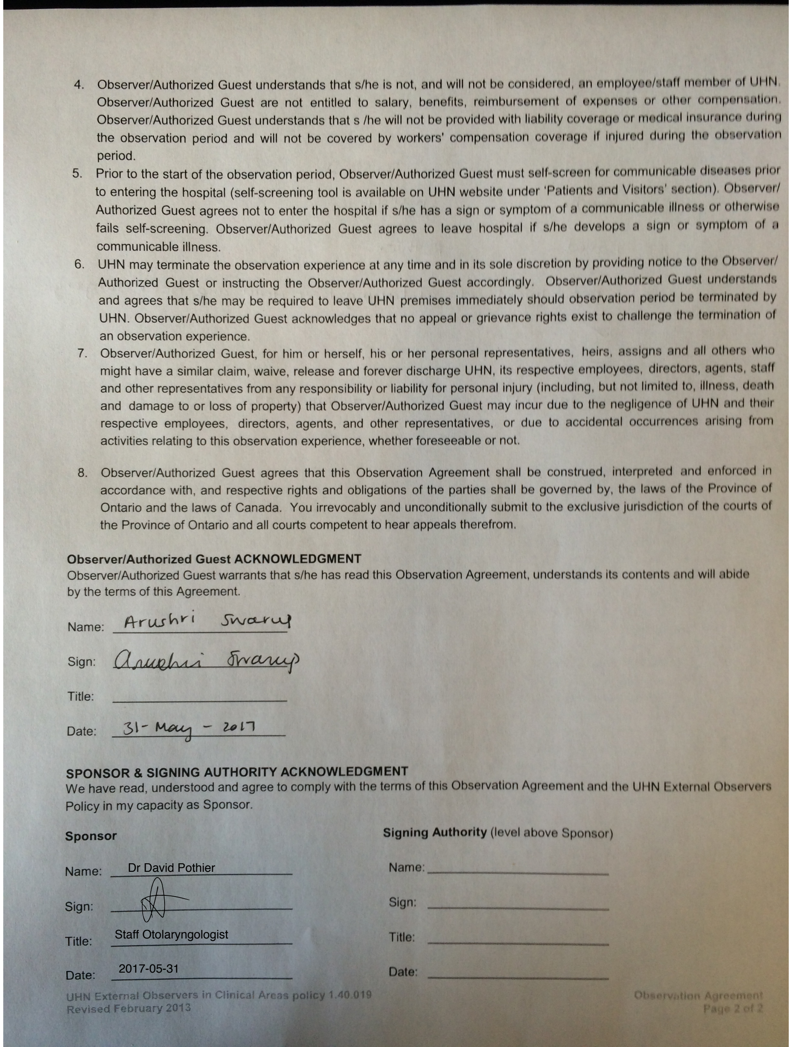
[picture p138: page 1]

Dr David Pothier

Staff Otolaryngologist

2017-05-31
