arushriswarup/Grad-School/UHN Observership/Proof of Enrolment.pdf

Arushri

Swarup

Proof

of

Enrolment

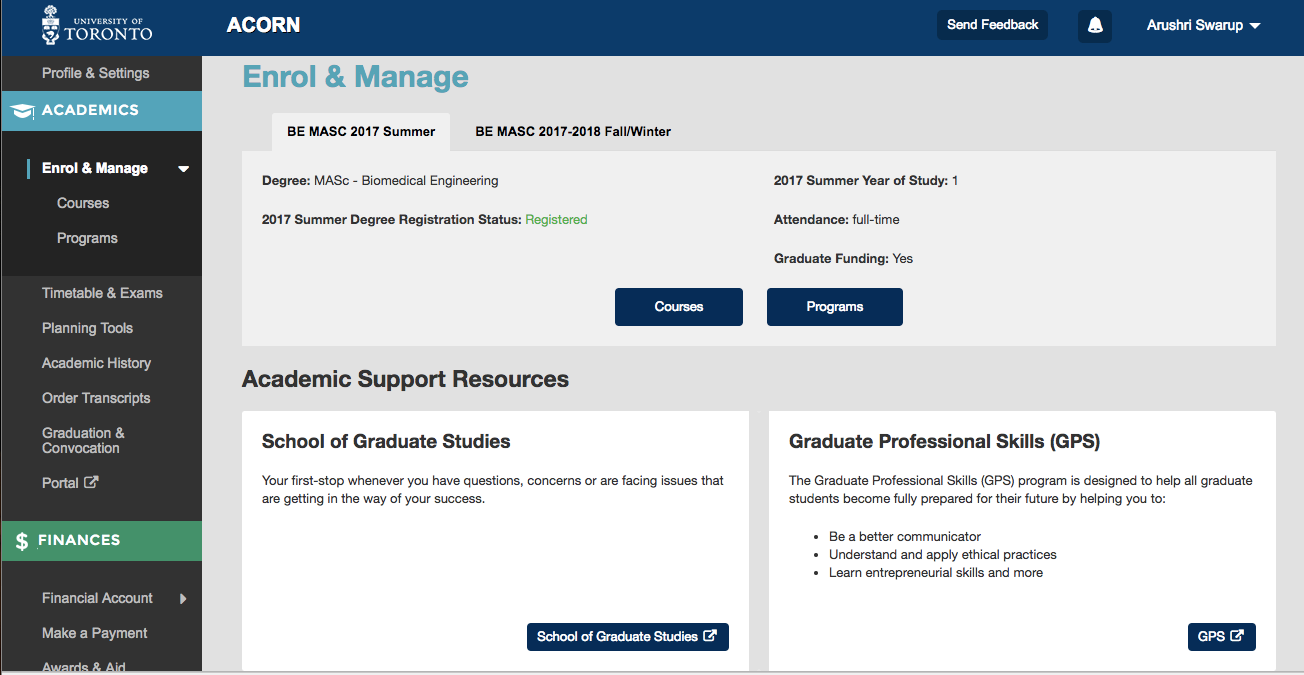
[picture p139: figure]
