arushriswarup/Grad-School/3D Models/anatomy stls/Stand_1.JPG

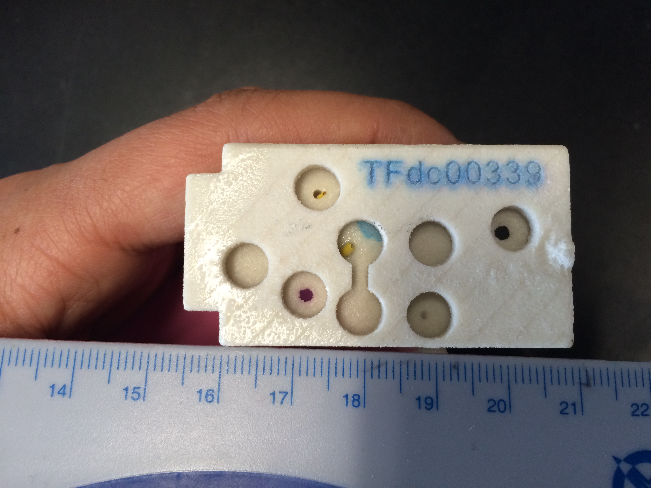
3D Models/anatomy stls/Stand_1.JPG
