arushriswarup/Grad-School/3D Models/anatomy stls/stand_2.JPG

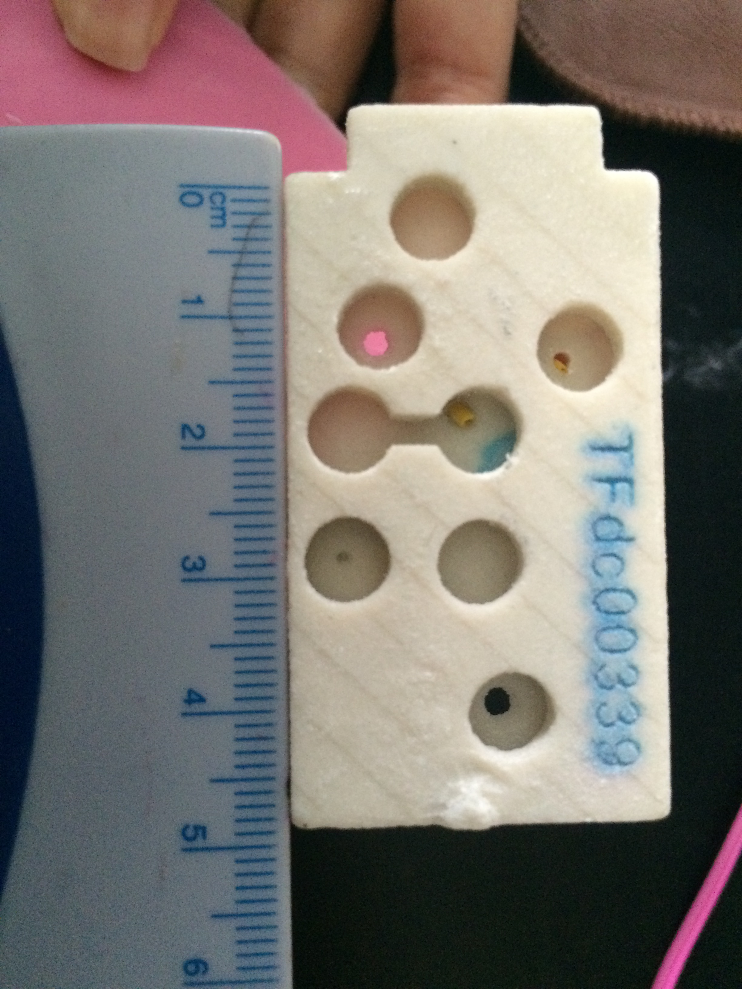
3D Models/anatomy stls/stand_2.JPG
