arushriswarup/Grad-School/3D Models/cross section of ear canal with endoscope.png

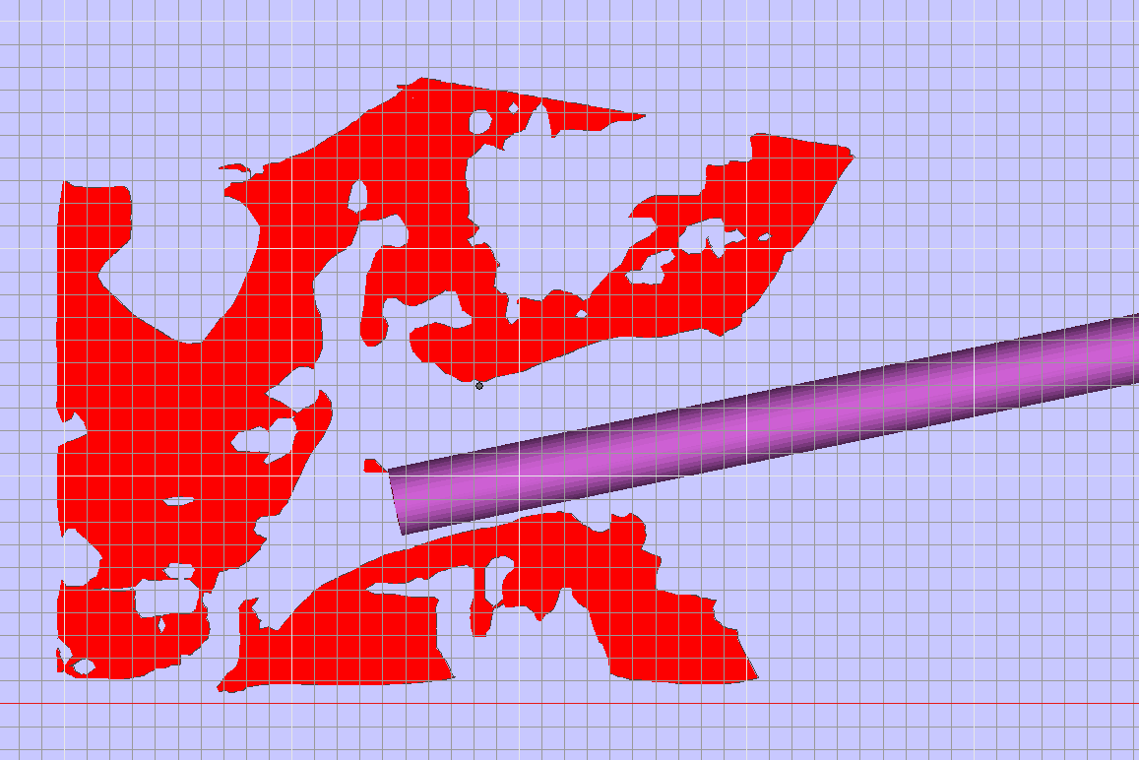
3D Models/cross section of ear canal with endoscope.png
