arushriswarup/Grad-School/3D Models/cross section of ear canal with endoscope_3.png

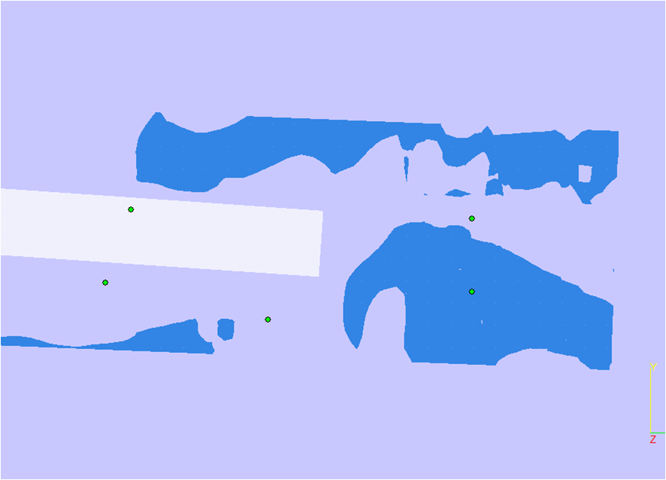
3D Models/cross section of ear canal with endoscope_3.png
