arushriswarup/Grad-School/3D Models/CT scans May-2017 targets/A/axial section.png

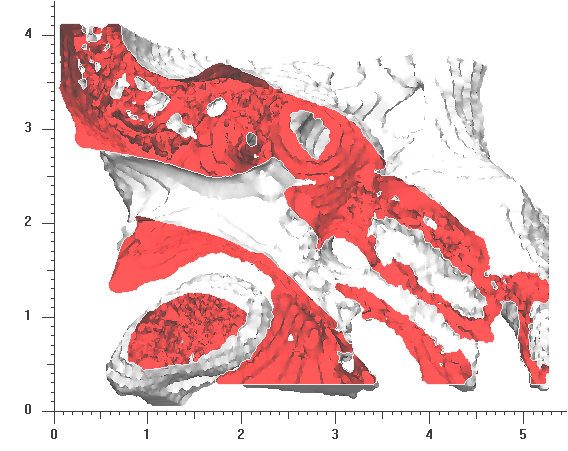
3D Models/CT scans May-2017 targets/A/axial section.png
