arushriswarup/Grad-School/3D Models/CT scans May-2017 targets/A/cropped model 1.PNG

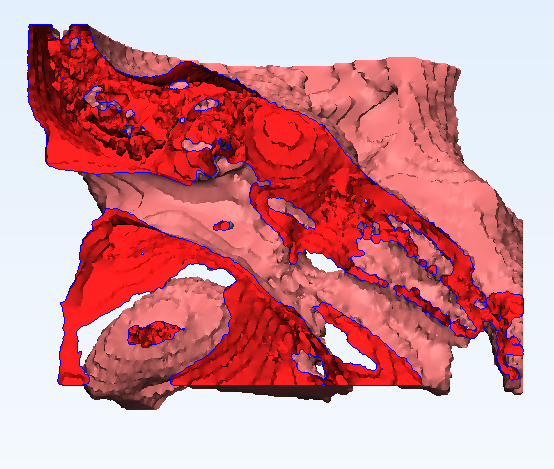
3D Models/CT scans May-2017 targets/A/cropped model 1.PNG
