arushriswarup/Grad-School/3D Models/CT scans May-2017 targets/A/target A.PNG

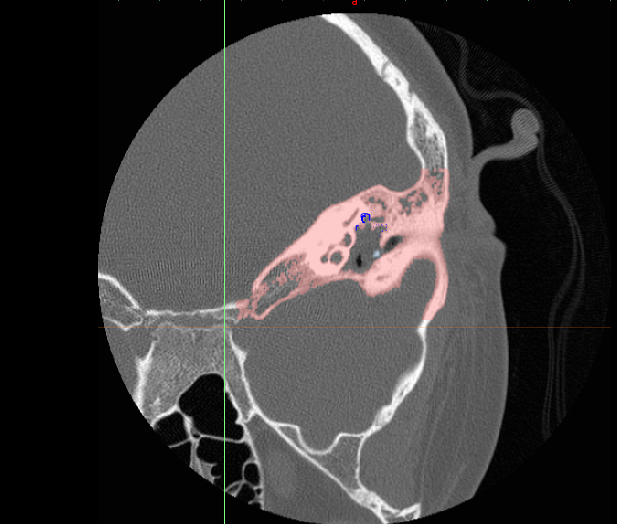
3D Models/CT scans May-2017 targets/A/target A.PNG
