arushriswarup/Grad-School/3D Models/CT scans May-2017 targets/A/Target A_3D model_axial.PNG

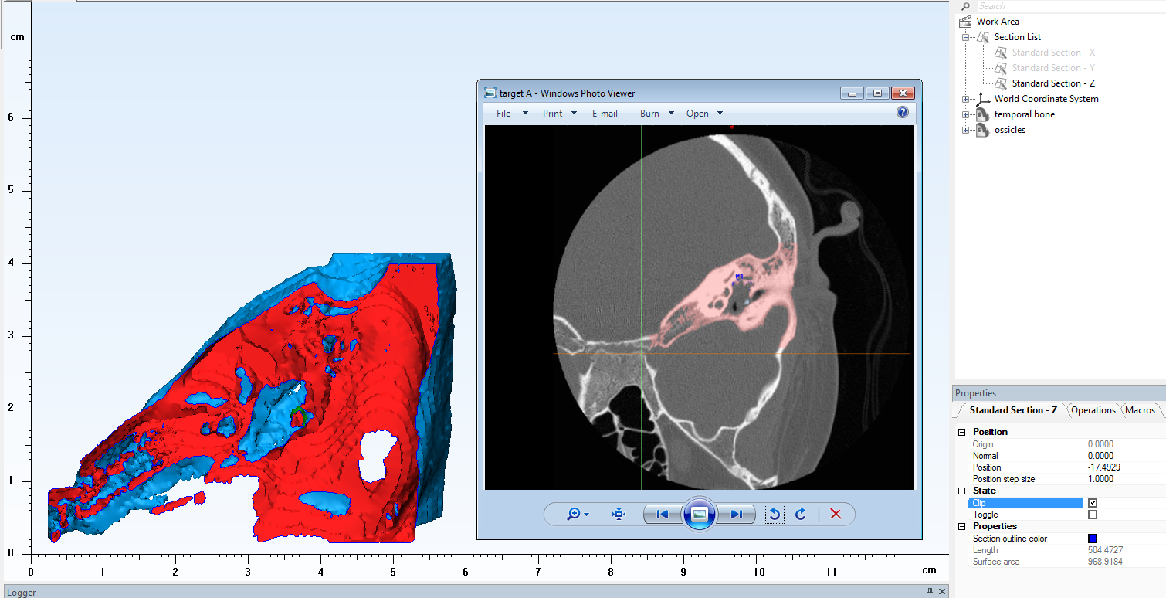
3D Models/CT scans May-2017 targets/A/Target A_3D model_axial.PNG
