arushriswarup/Grad-School/3D Models/CT scans May-2017 targets/A/Target A_3D model_coronal.PNG

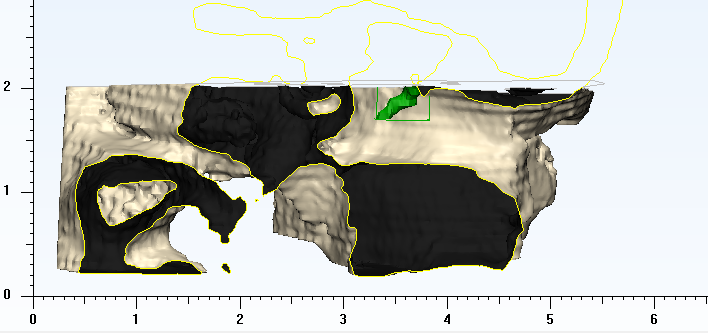
3D Models/CT scans May-2017 targets/A/Target A_3D model_coronal.PNG
