arushriswarup/Grad-School/3D Models/CT scans May-2017 targets/A/Target B_3D model.PNG

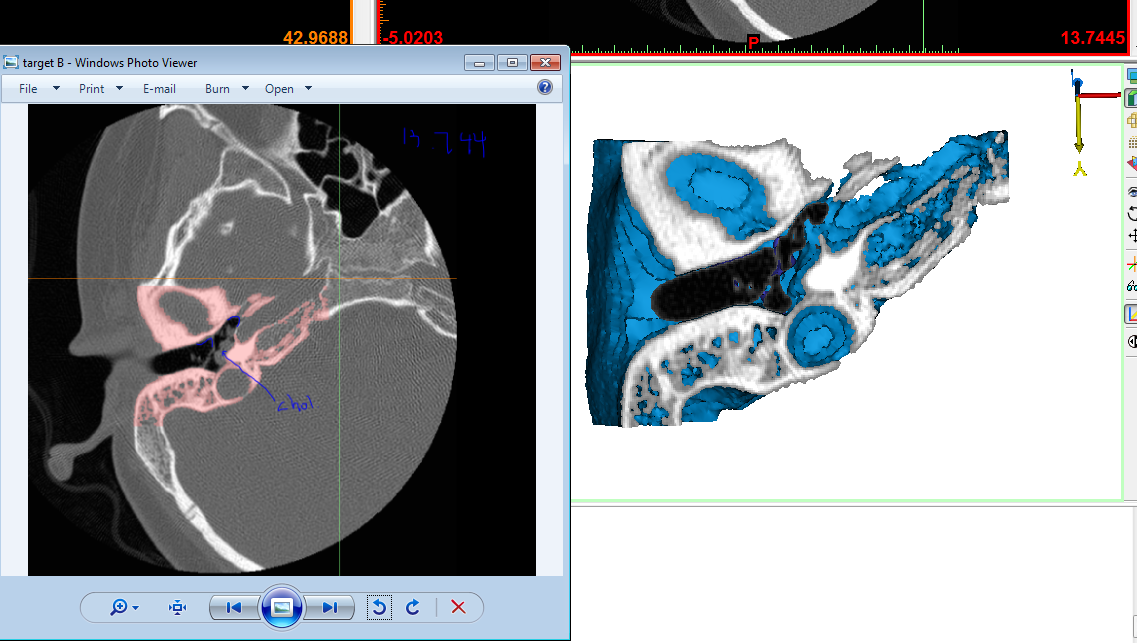
3D Models/CT scans May-2017 targets/A/Target B_3D model.PNG
