arushriswarup/Grad-School/3D Models/CT scans May-2017 targets/A/target d.PNG

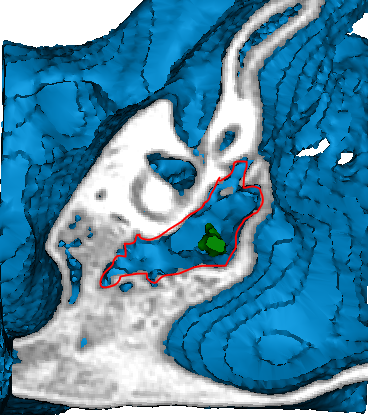
3D Models/CT scans May-2017 targets/A/target d.PNG
