arushriswarup/Grad-School/3D Models/CT scans May-2017 targets/A/target e 15.6189.PNG

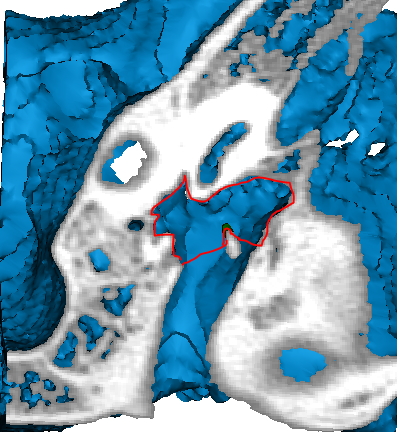
3D Models/CT scans May-2017 targets/A/target e 15.6189.PNG
