arushriswarup/Grad-School/3D Models/instrument photos/Angled Thomassin.JPG

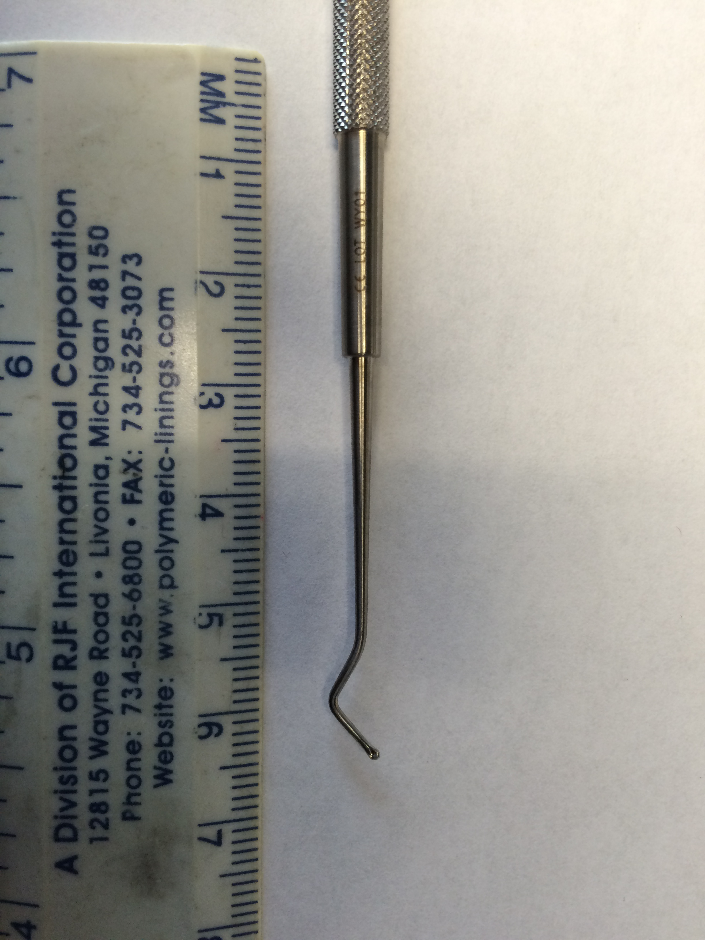
3D Models/instrument photos/Angled Thomassin.JPG
