arushriswarup/Grad-School/3D Models/instrument photos/IMG_5397.JPG

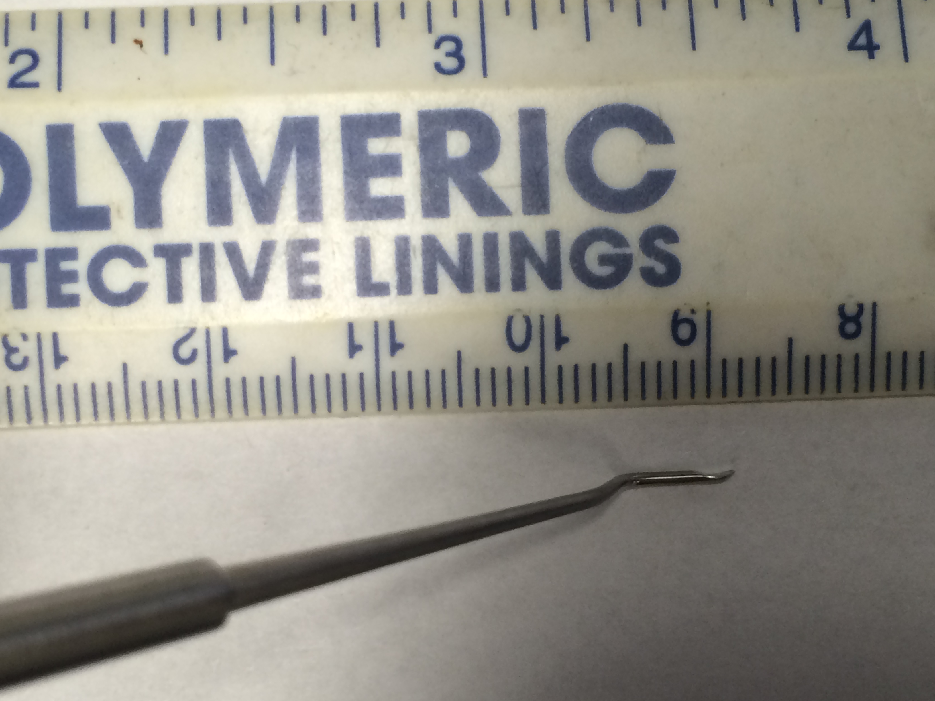
3D Models/instrument photos/IMG_5397.JPG
