arushriswarup/Grad-School/3D Models/instrument photos/IMG_5398.JPG

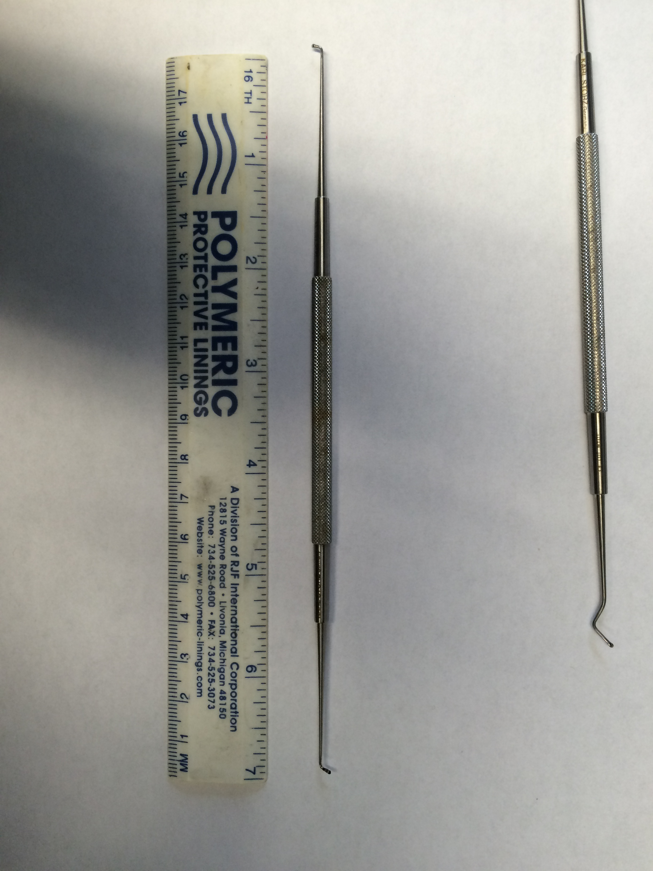
3D Models/instrument photos/IMG_5398.JPG
