arushriswarup/Grad-School/3D Models/instrument photos/IMG_5400.JPG

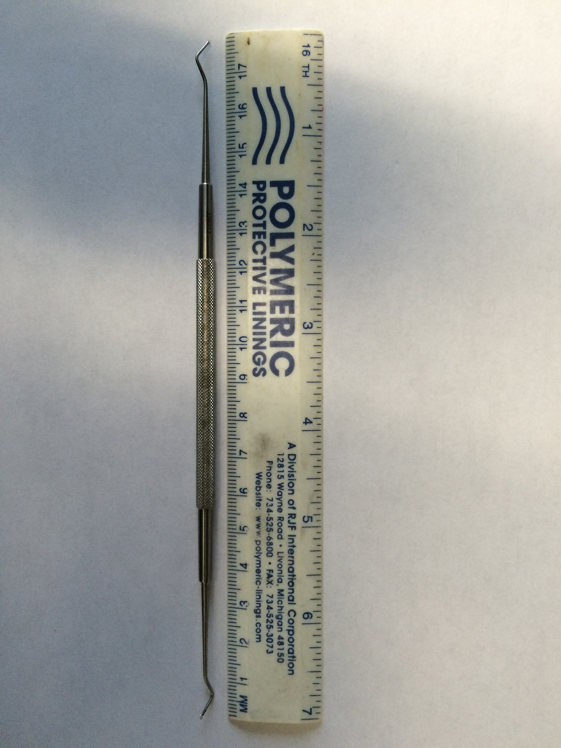
3D Models/instrument photos/IMG_5400.JPG
