arushriswarup/Grad-School/3D Models/instrument photos/panetti left zoomed.JPG

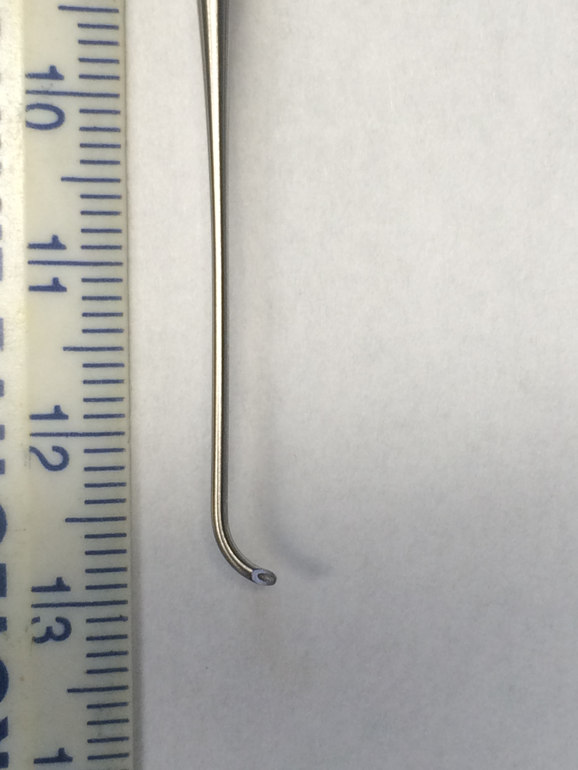
3D Models/instrument photos/panetti left zoomed.JPG
