arushriswarup/Grad-School/3D Models/instrument photos/panetti right.jpg

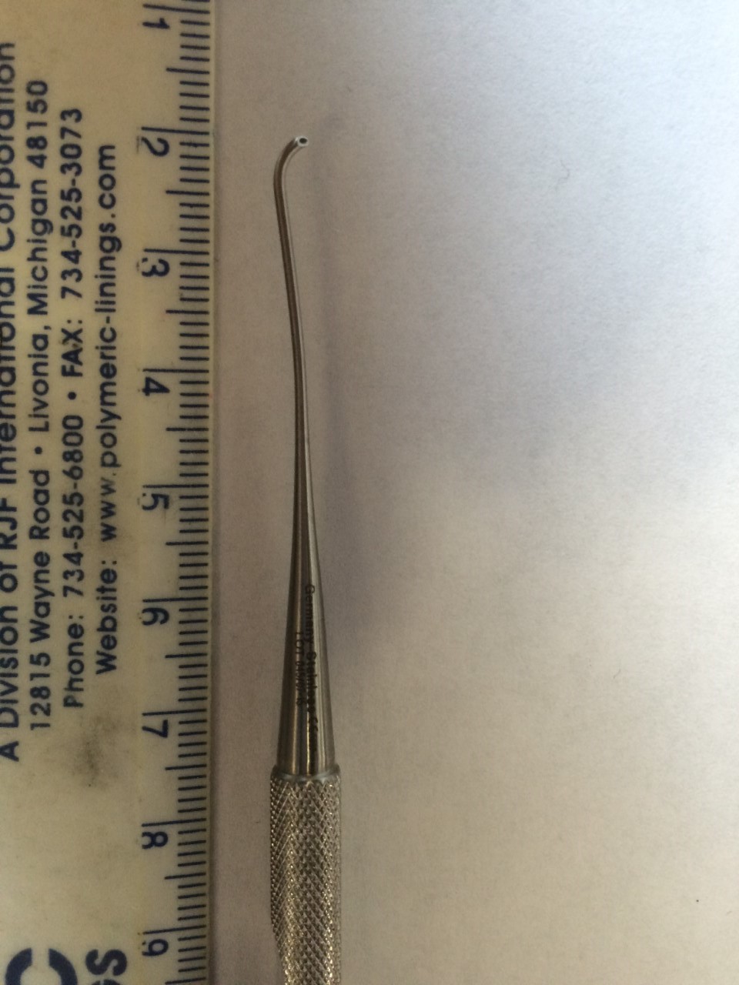
3D Models/instrument photos/panetti right.jpg
