arushriswarup/Grad-School/3D Models/instrument photos/rosen.JPG

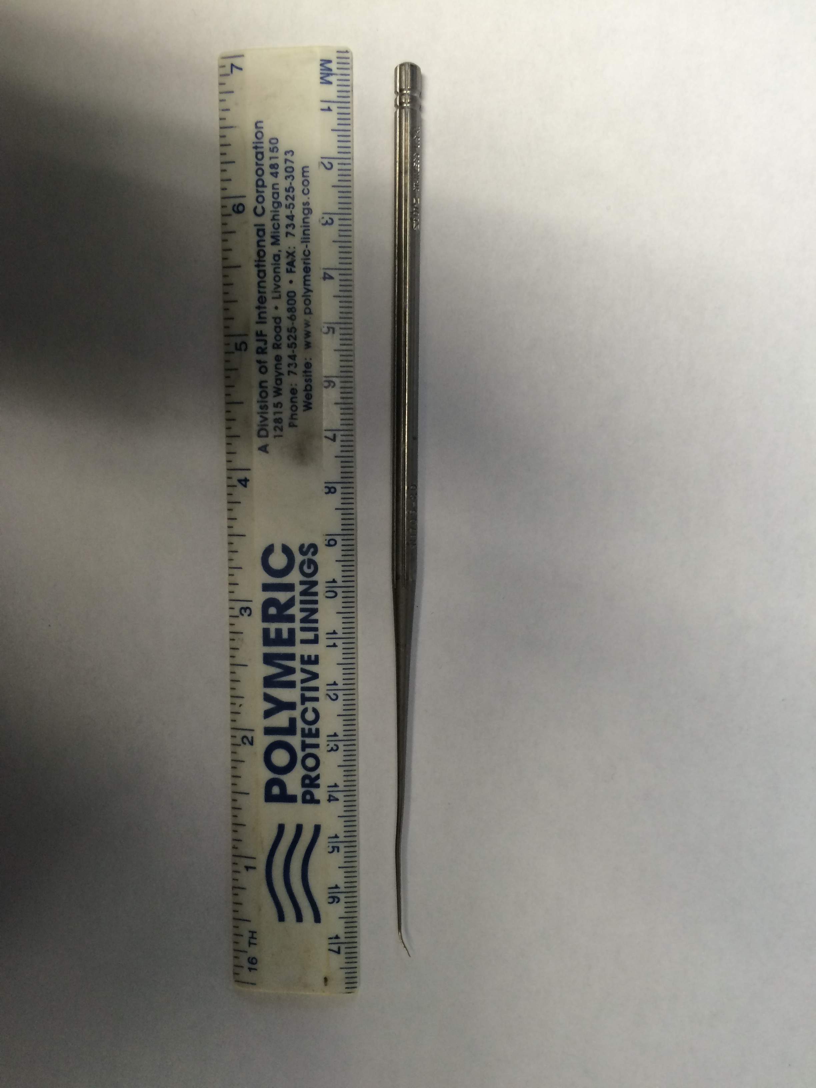
3D Models/instrument photos/rosen.JPG
