arushriswarup/Grad-School/3D Models/instrument photos/Thomassin tip.JPG

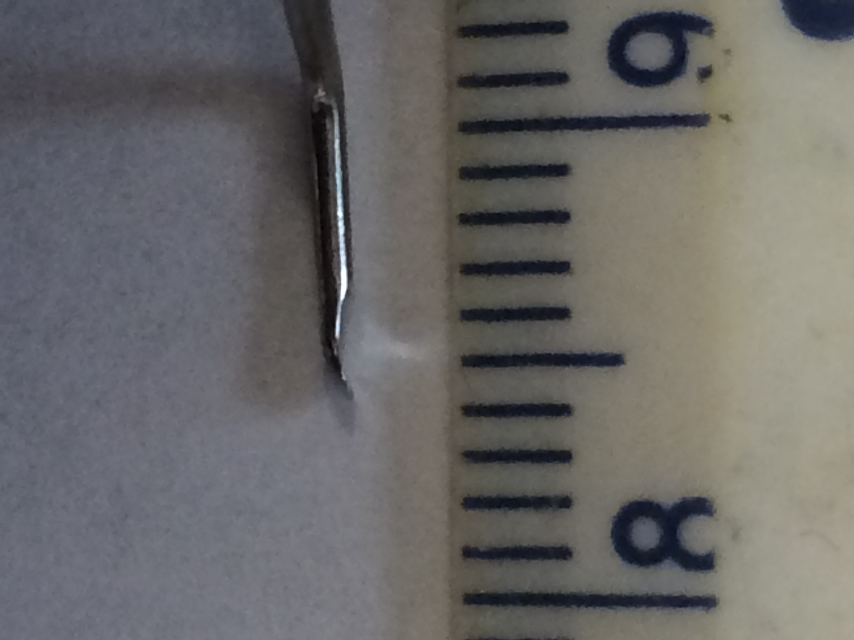
3D Models/instrument photos/Thomassin tip.JPG
