arushriswarup/Grad-School/3D Models/instrument photos/Thomassin.JPG

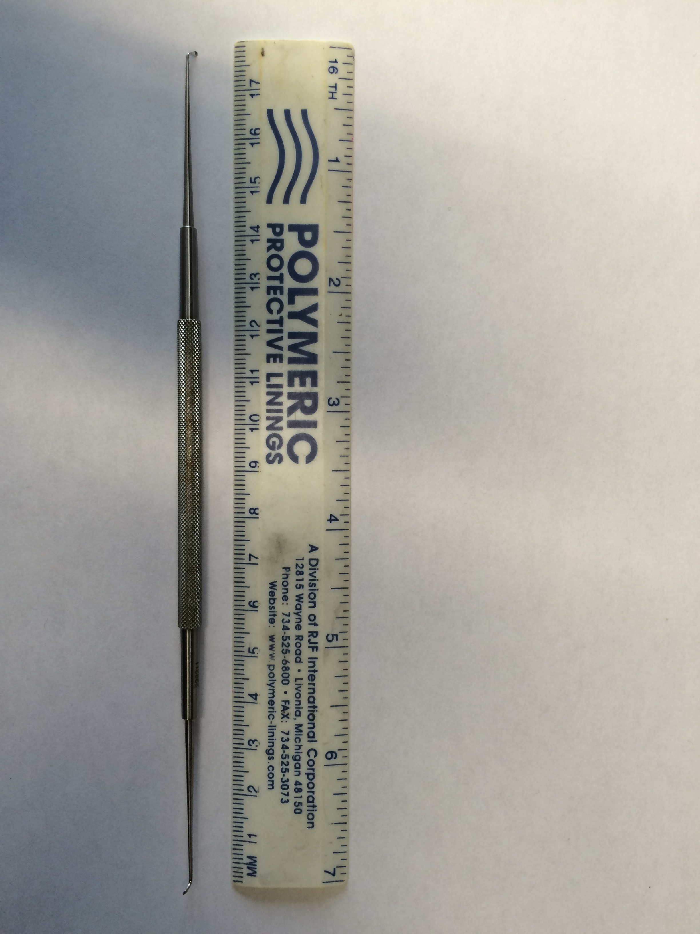
3D Models/instrument photos/Thomassin.JPG
