arushriswarup/Grad-School/Committee Meeting/anatomy plus endoscope.png

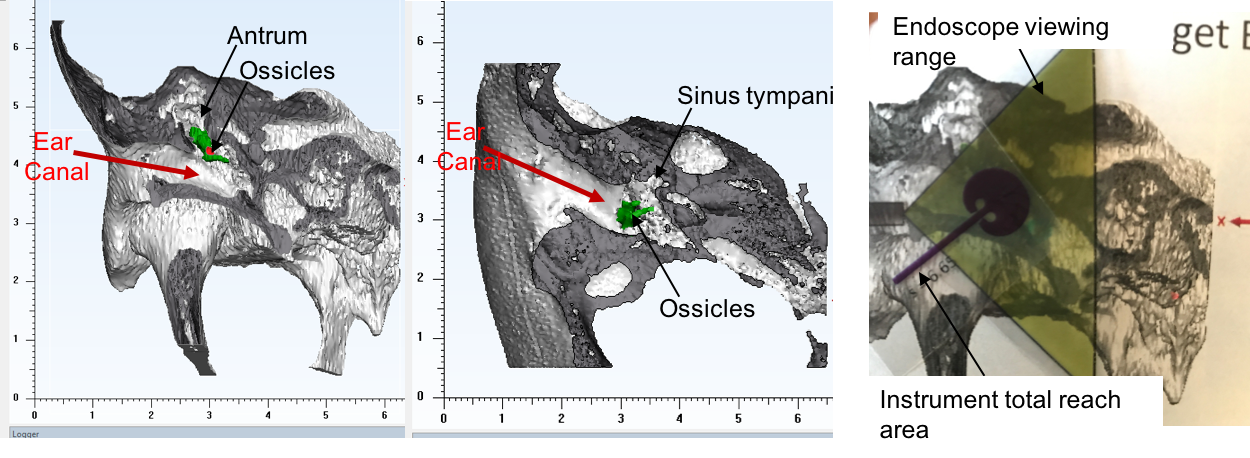
Committee Meeting/anatomy plus endoscope.png
