arushriswarup/Grad-School/Committee Meeting/antrum.png

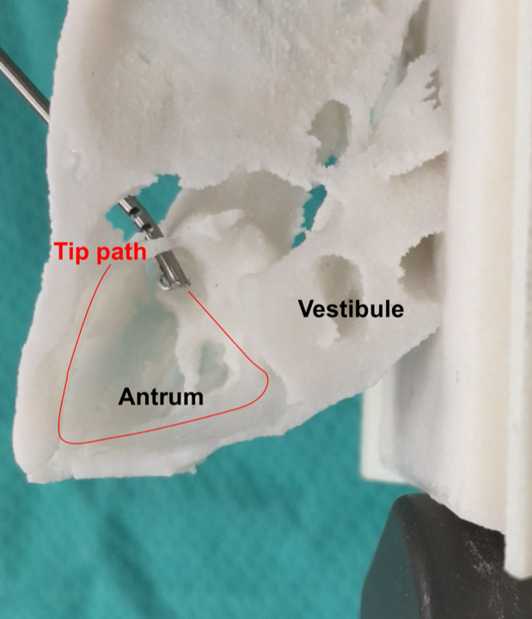
Committee Meeting/antrum.png
