arushriswarup/Grad-School/Committee Meeting/arc length range.png

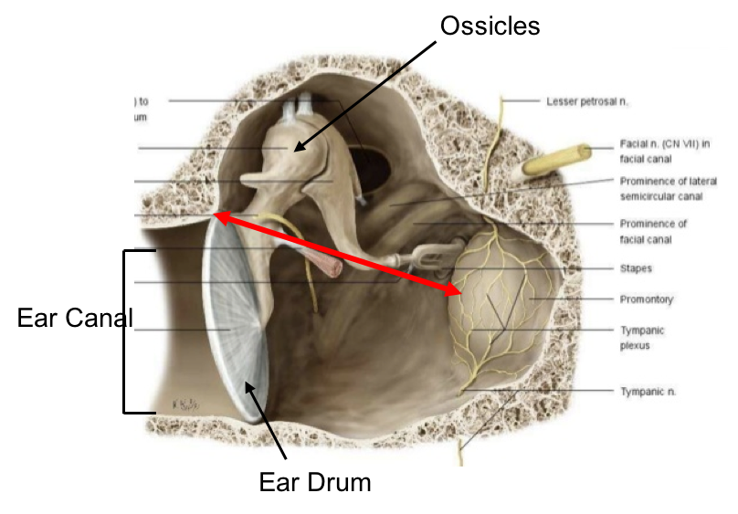
Committee Meeting/arc length range.png
