arushriswarup/Grad-School/Committee Meeting/endoscope with vectors.png

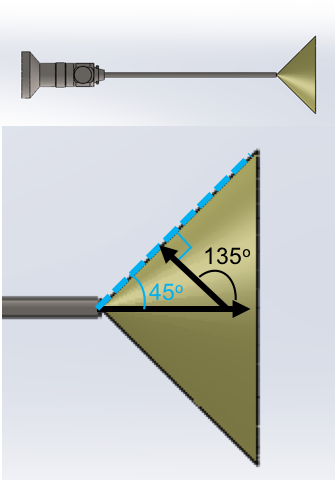
Committee Meeting/endoscope with vectors.png
