arushriswarup/Grad-School/Committee Meeting/ent robot concentric tube.png

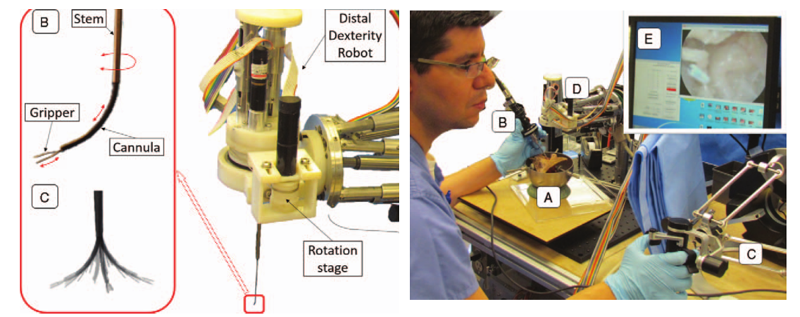
Committee Meeting/ent robot concentric tube.png
