arushriswarup/Grad-School/Committee Meeting/figure 1.png

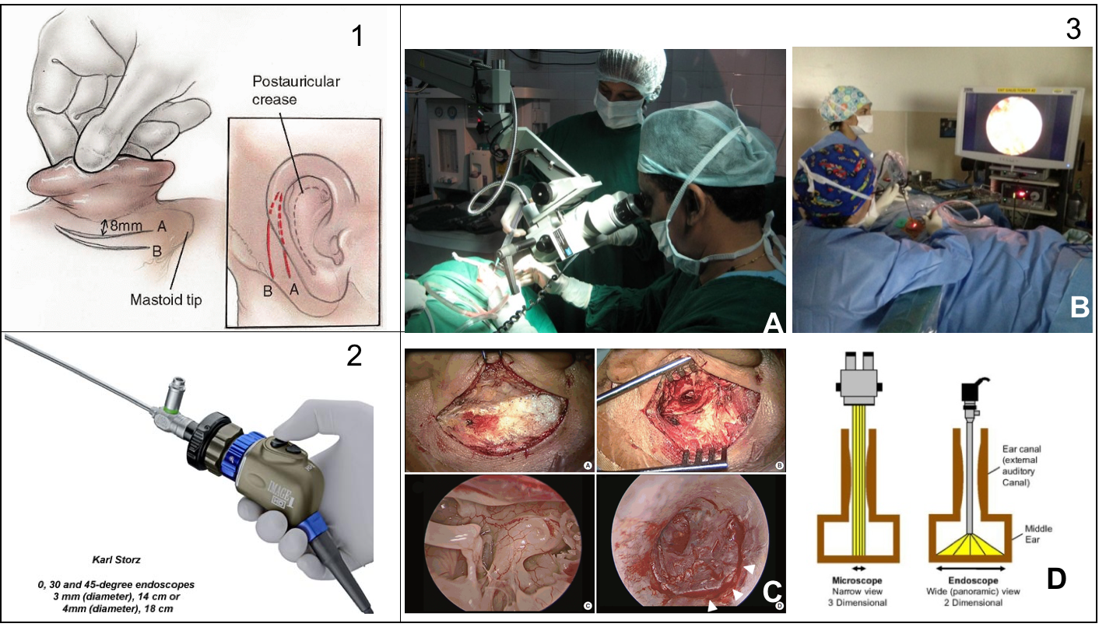
Committee Meeting/figure 1.png
