arushriswarup/Grad-School/Committee Meeting/handles.png

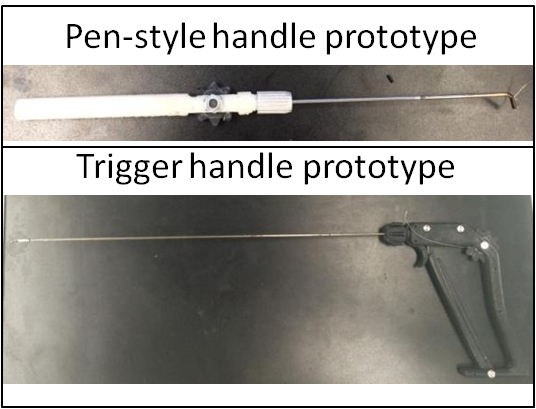
Committee Meeting/handles.png
