arushriswarup/Grad-School/Committee Meeting/laser etched nitinol.png

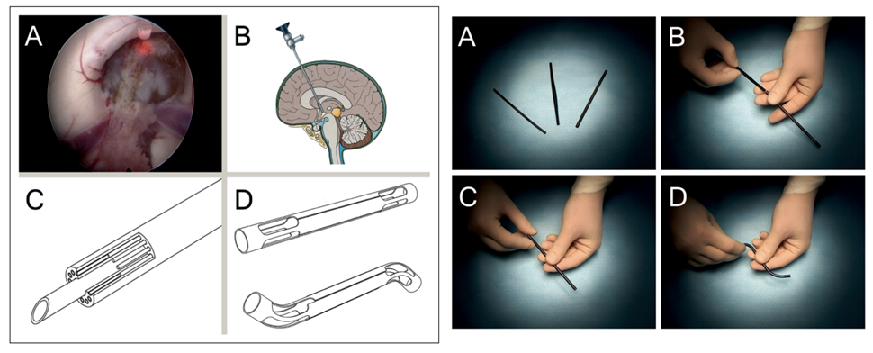
Committee Meeting/laser etched nitinol.png
