arushriswarup/Grad-School/Committee Meeting/middle ear anatomy.png

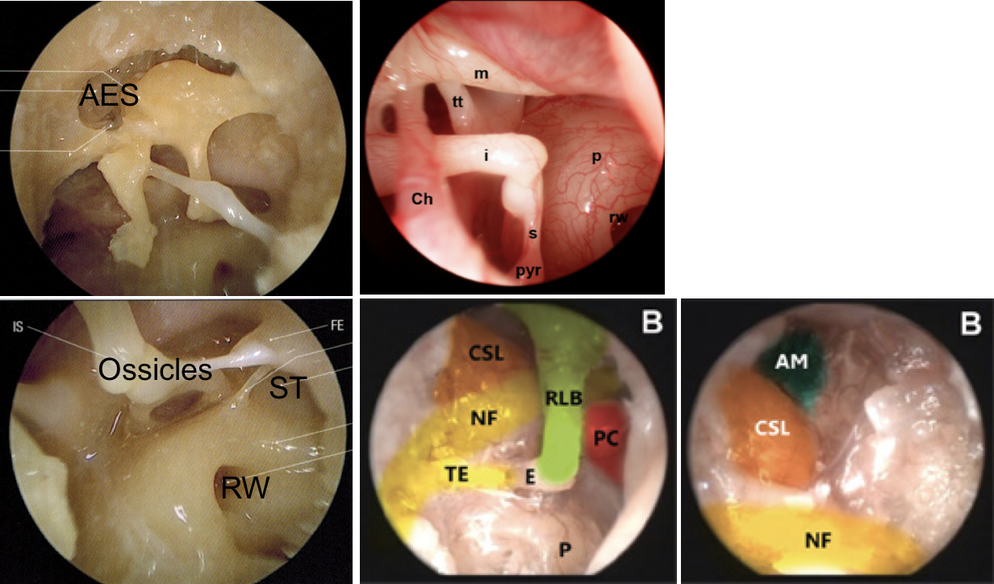
Committee Meeting/middle ear anatomy.png
