arushriswarup/Grad-School/Committee Meeting/middle ear anatomy_1.jpg

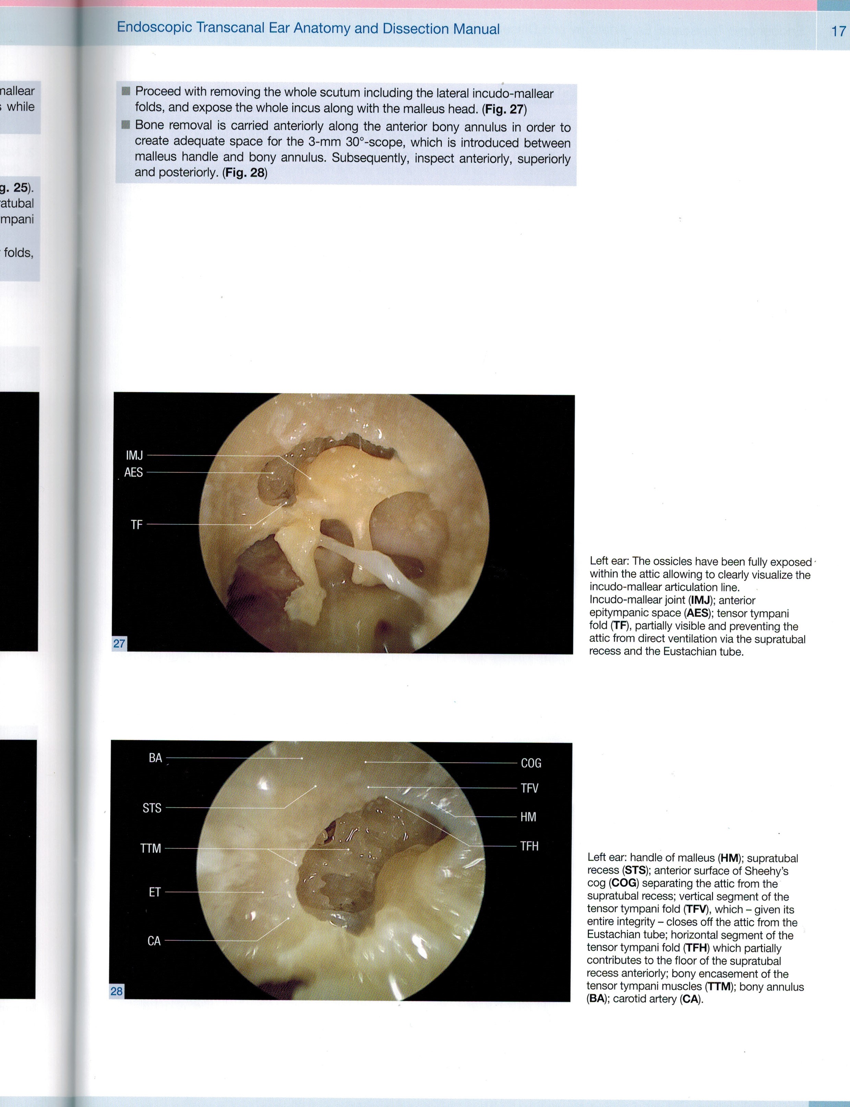
Committee Meeting/middle ear anatomy_1.jpg
