arushriswarup/Grad-School/Committee Meeting/middle ear anatomy_2.jpg

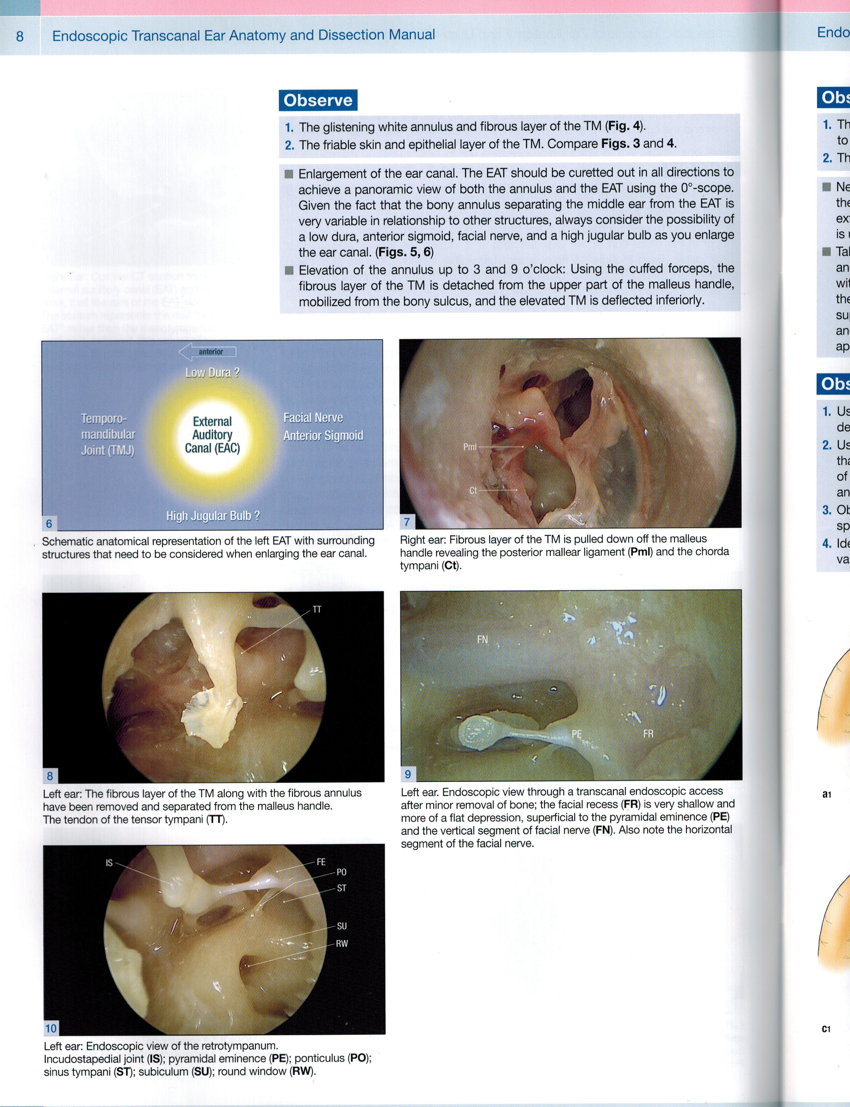
Committee Meeting/middle ear anatomy_2.jpg
