arushriswarup/Grad-School/Committee Meeting/middle ear anatomy_3.jpg

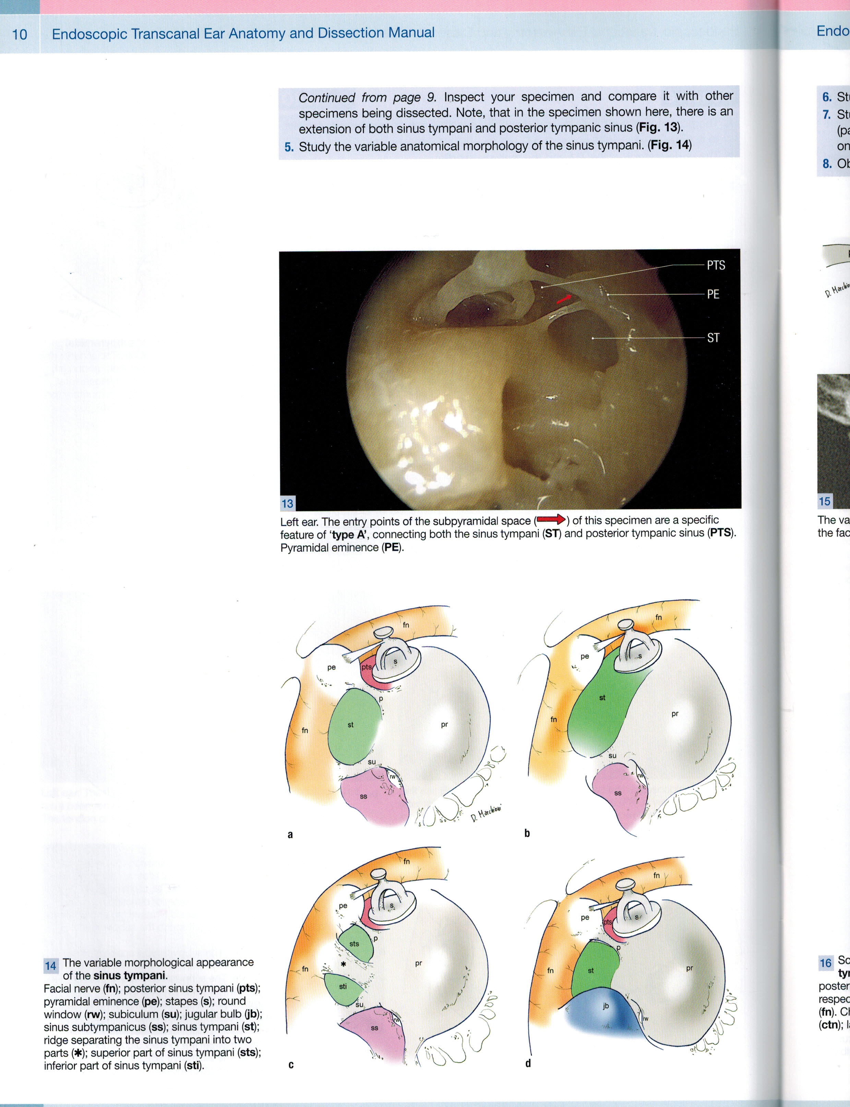
Committee Meeting/middle ear anatomy_3.jpg
