arushriswarup/Grad-School/Committee Meeting/sinus tympani.png

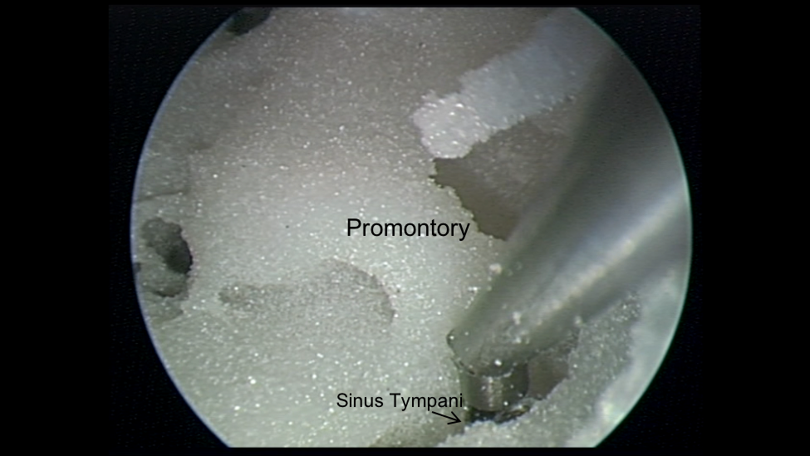
Committee Meeting/sinus tympani.png
