arushriswarup/Grad-School/Committee Meeting/steerable instruments.png

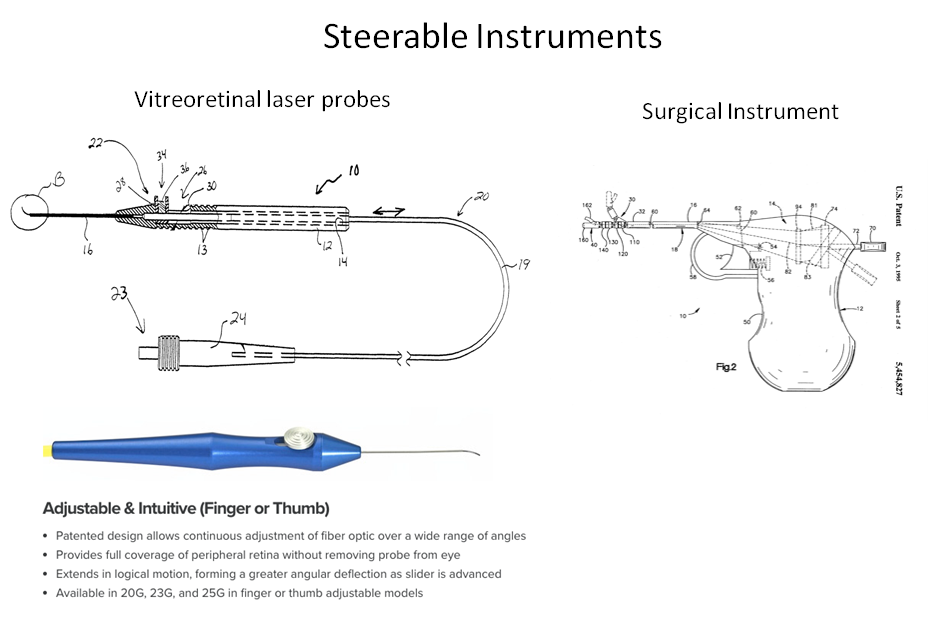
Committee Meeting/steerable instruments.png
