arushriswarup/Grad-School/Committee Meeting/tees instruments.png

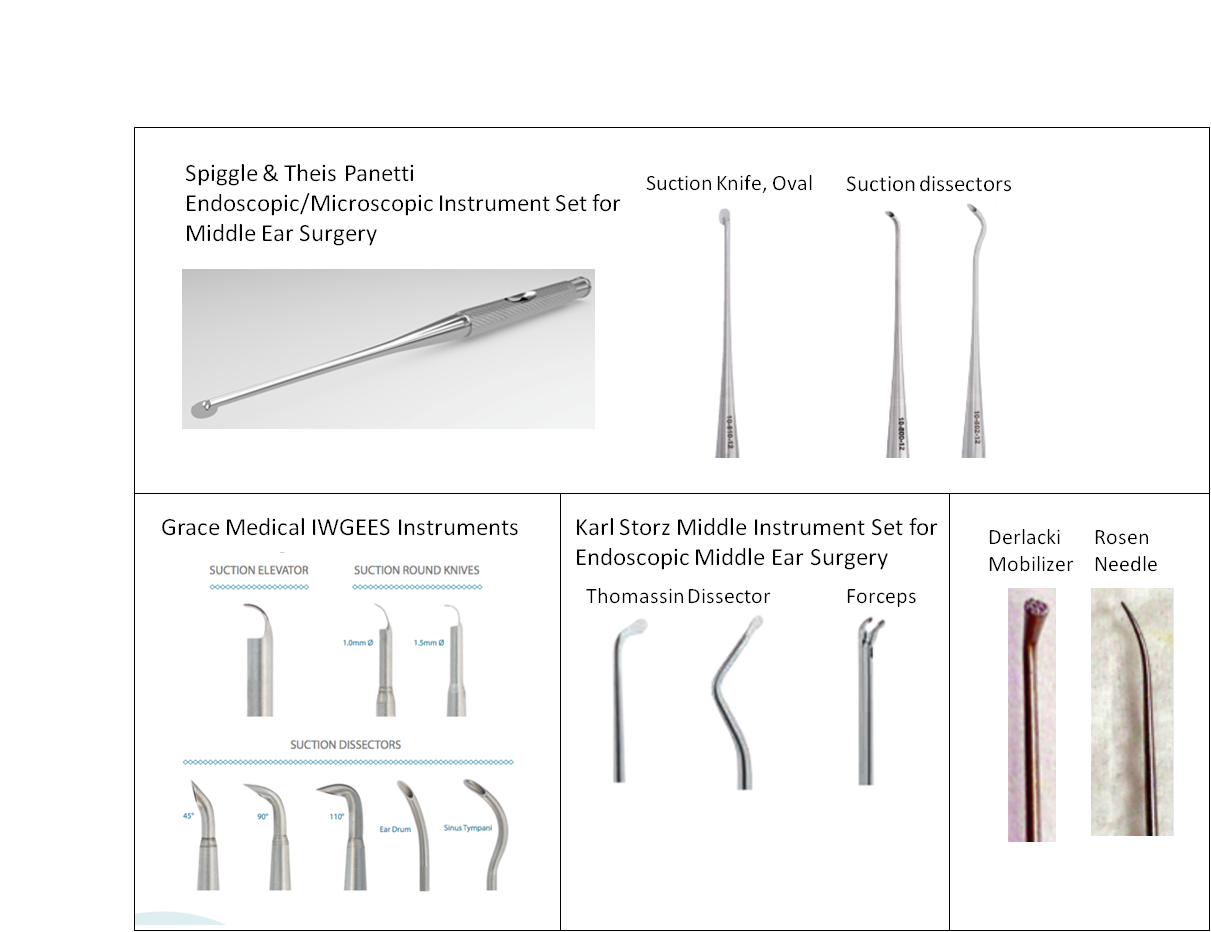
Committee Meeting/tees instruments.png
