arushriswarup/Grad-School/Committee Meeting/tip zoomed in.png

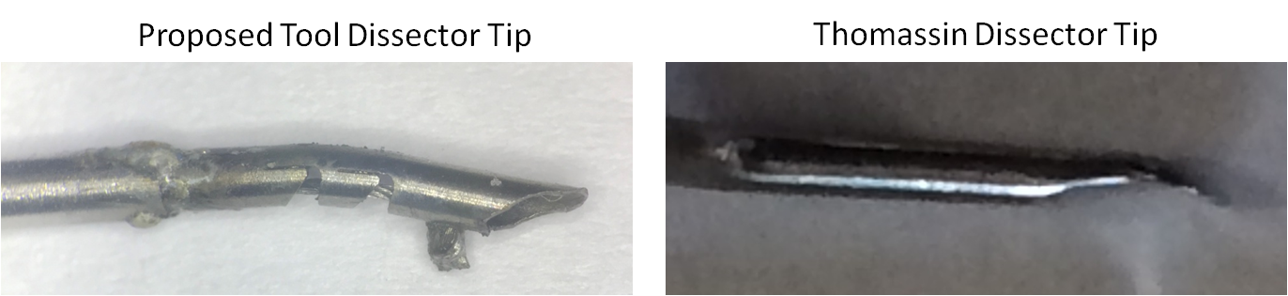
Committee Meeting/tip zoomed in.png
