arushriswarup/Grad-School/Committee Meeting/virtual anatomy.png

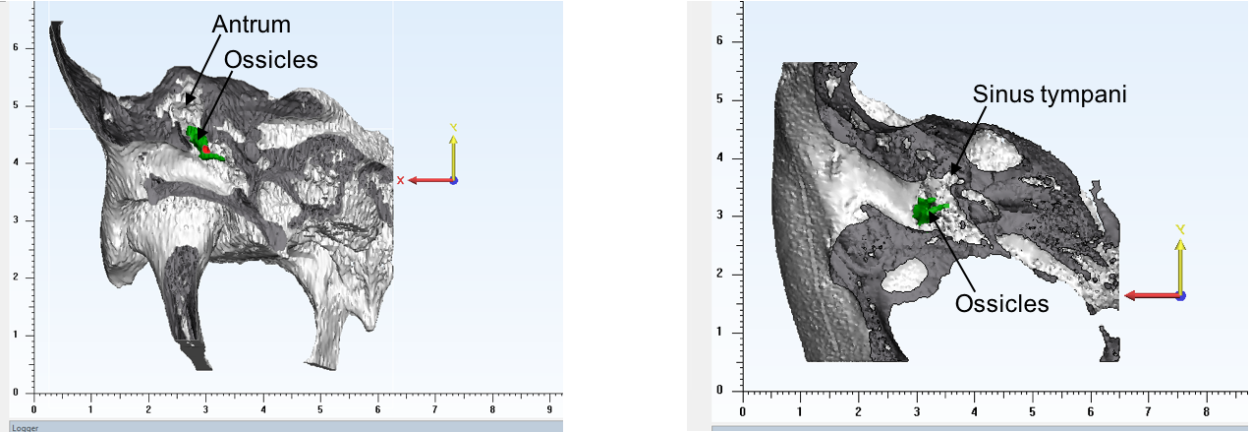
Committee Meeting/virtual anatomy.png
