arushriswarup/Grad-School/Committee Meeting/virtual model.png

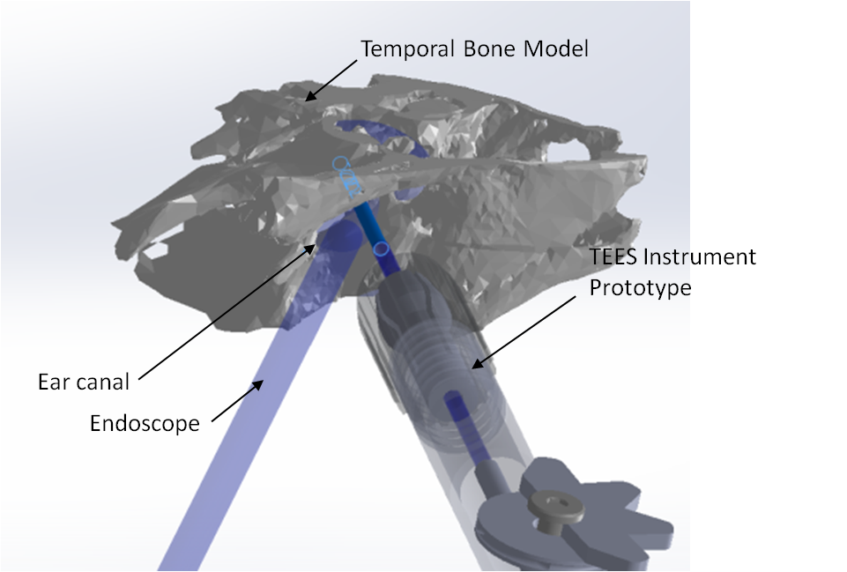
Committee Meeting/virtual model.png
