arushriswarup/Grad-School/Committee Meeting/wrist.png

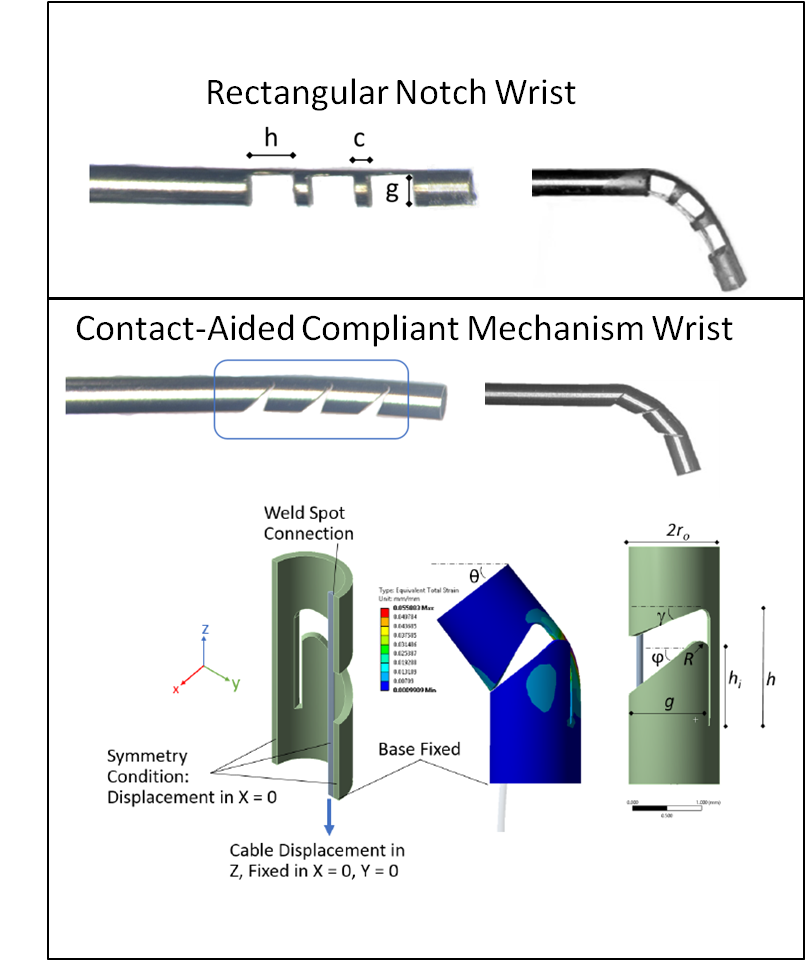
Committee Meeting/wrist.png
