arushriswarup/Grad-School/Coursework/Bioengineering Science/Tianyu Thesis Proposal Comments.JPG

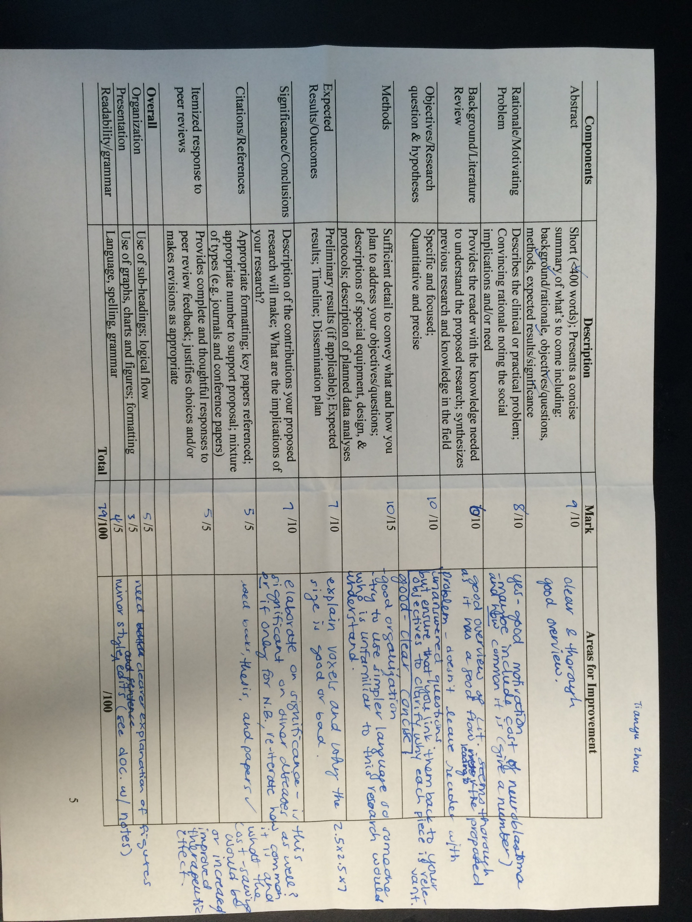
Coursework/Bioengineering Science/Tianyu Thesis Proposal Comments.JPG
