arushriswarup/Grad-School/Coursework/course add drop form.jpg

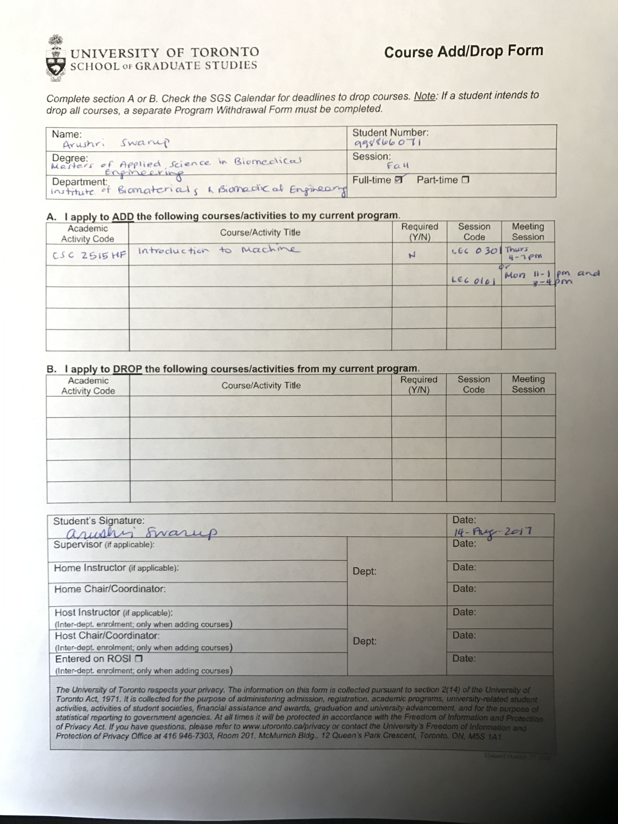
Coursework/course add drop form.jpg
