arushriswarup/Grad-School/Ear Surgery Instruments/Gantt Chart EES.png

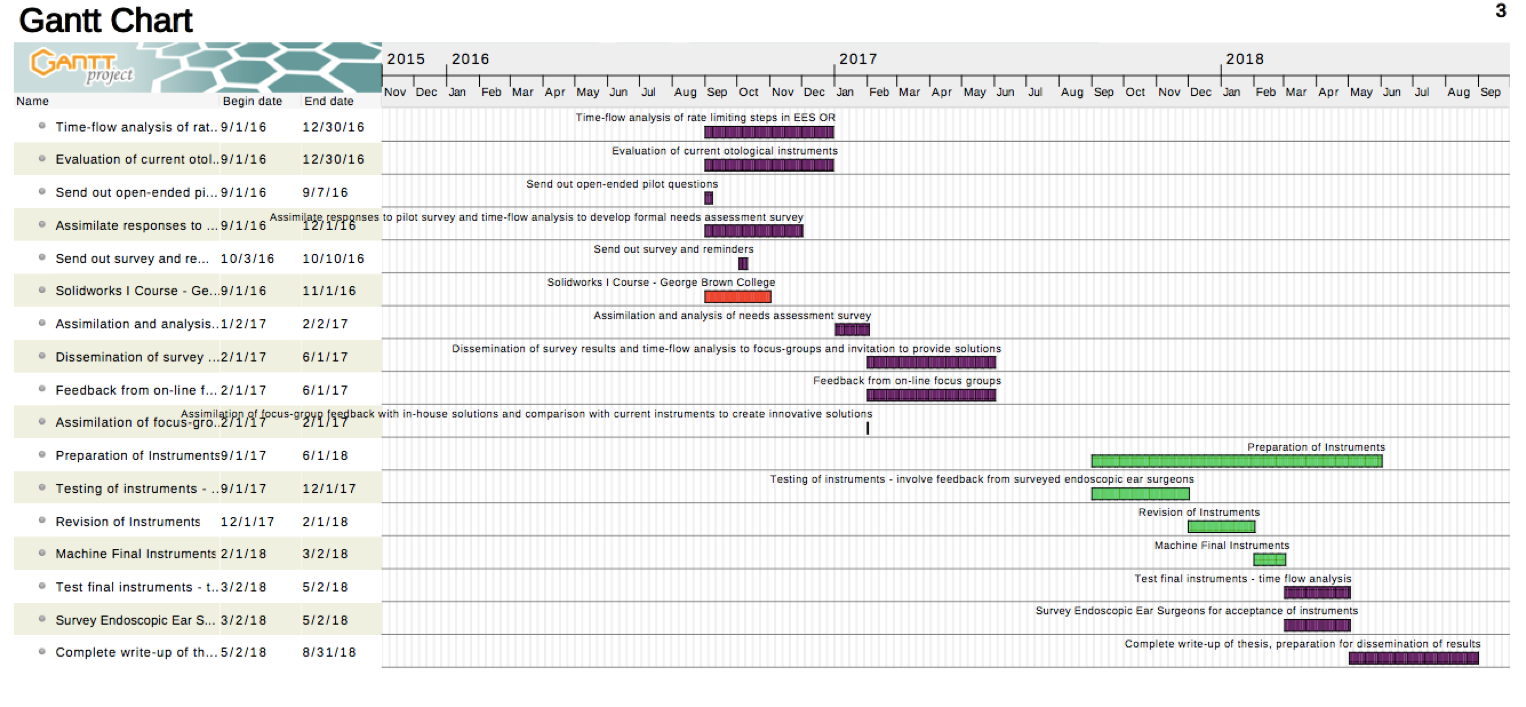
Ear Surgery Instruments/Gantt Chart EES.png
