arushriswarup/Grad-School/Ear Surgery Instruments/Pictures of Ideas/IMG_4774.JPG

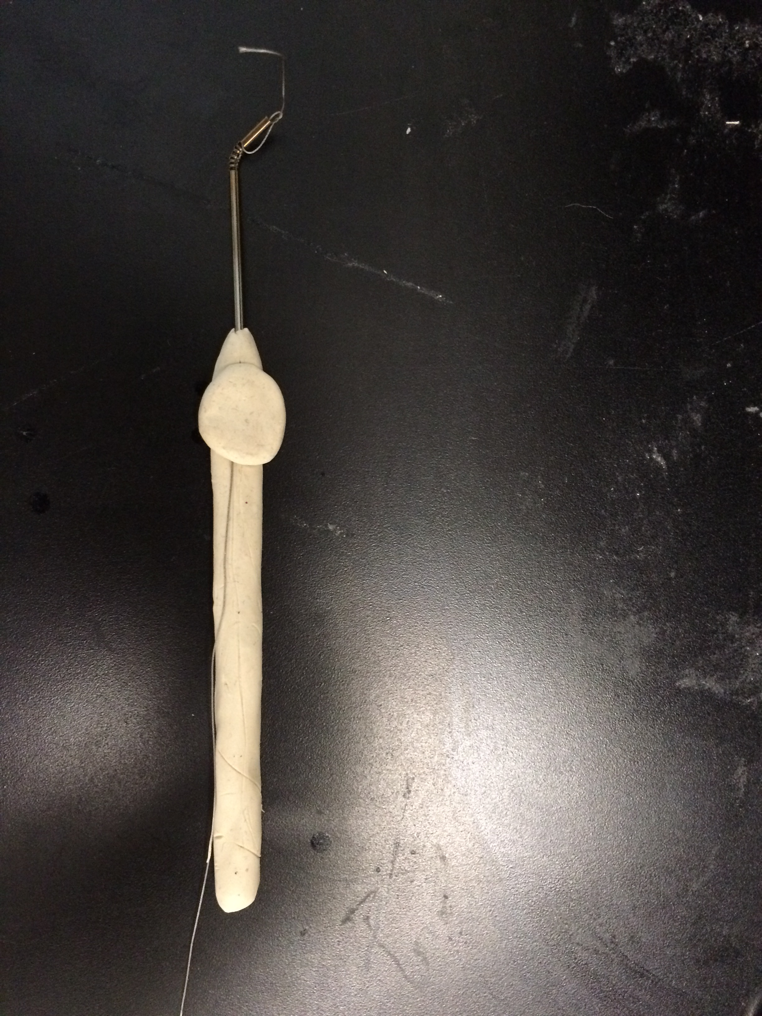
Ear Surgery Instruments/Pictures of Ideas/IMG_4774.JPG
