arushriswarup/Grad-School/Ear Surgery Instruments/Pictures of Ideas/IMG_4775.JPG

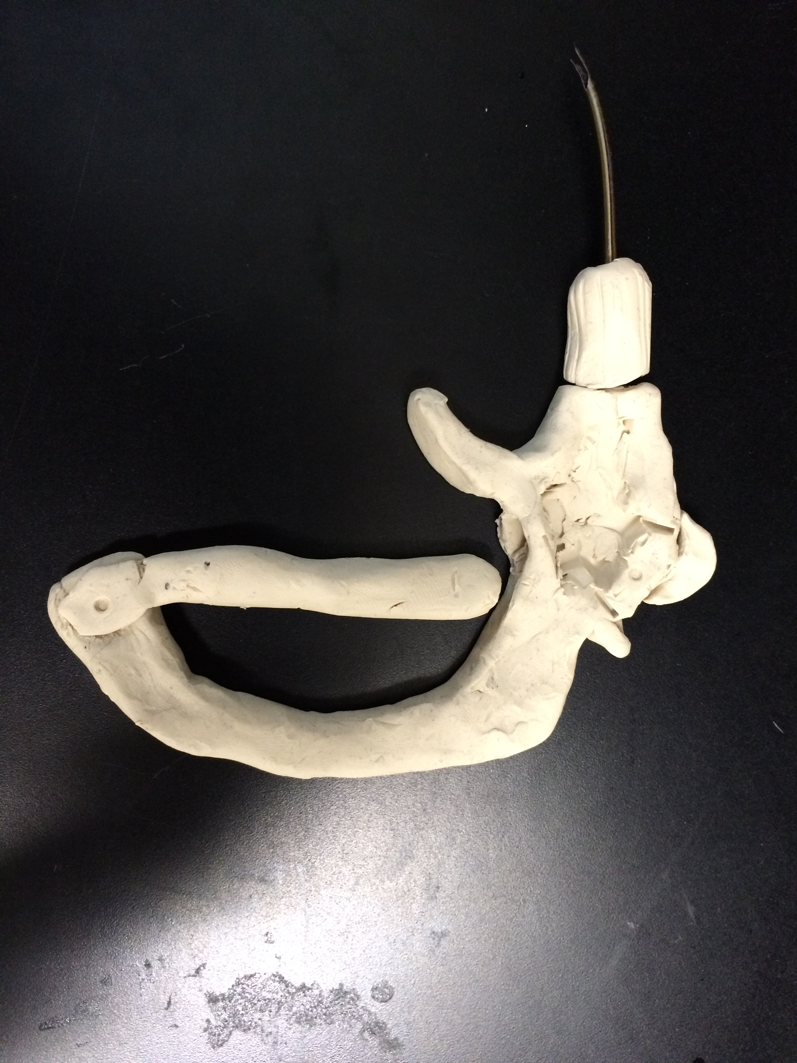
Ear Surgery Instruments/Pictures of Ideas/IMG_4775.JPG
