arushriswarup/Grad-School/Ear Surgery Instruments/Pictures of Ideas/IMG_4791.JPG

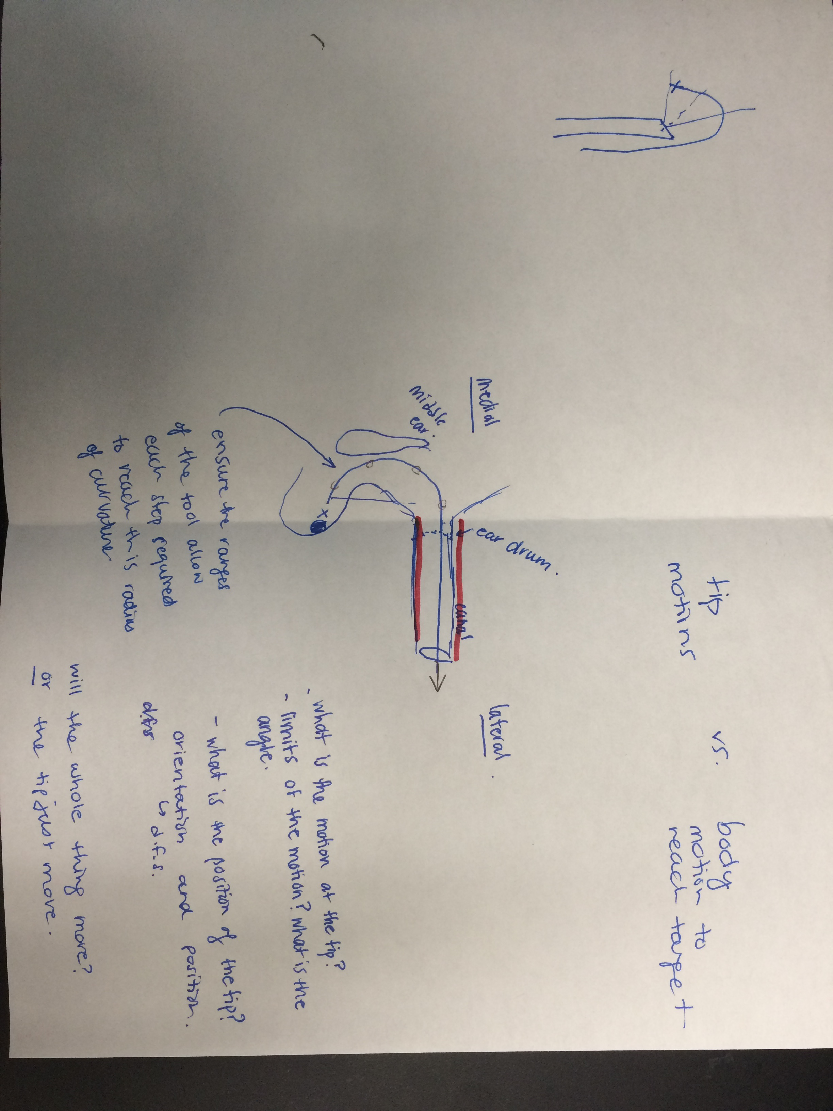
Ear Surgery Instruments/Pictures of Ideas/IMG_4791.JPG
