arushriswarup/Grad-School/Ear Surgery Instruments/Pictures of Ideas/IMG_4792.JPG

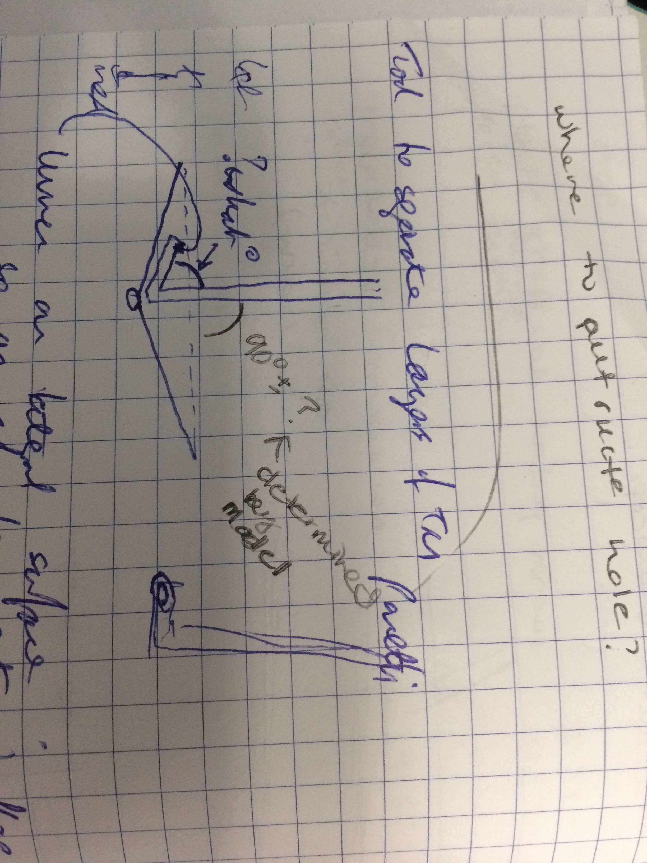
Ear Surgery Instruments/Pictures of Ideas/IMG_4792.JPG
