arushriswarup/Grad-School/Ear Surgery Instruments/Pictures of Ideas/IMG_4793.JPG

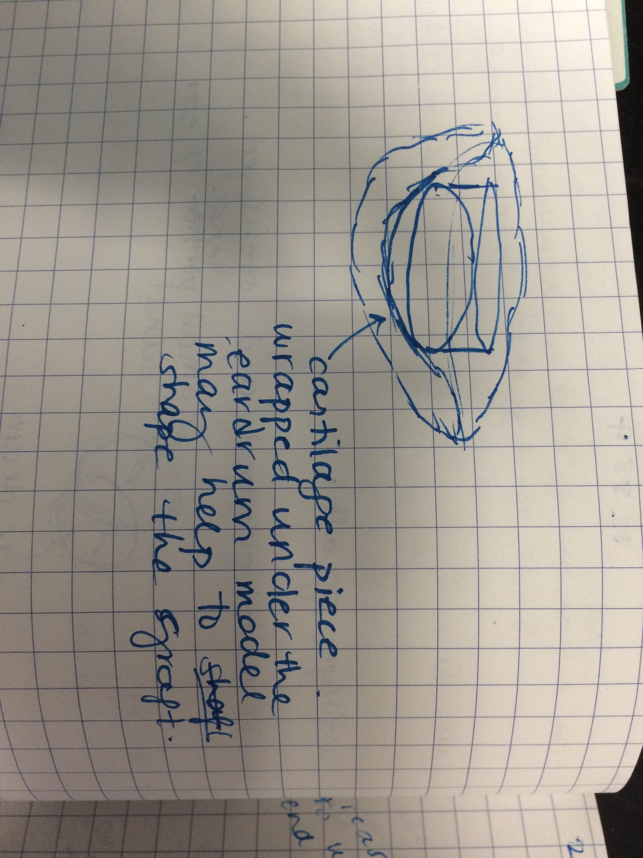
Ear Surgery Instruments/Pictures of Ideas/IMG_4793.JPG
