arushriswarup/Grad-School/Ear Surgery Instruments/Pictures of Ideas/IMG_4794.JPG

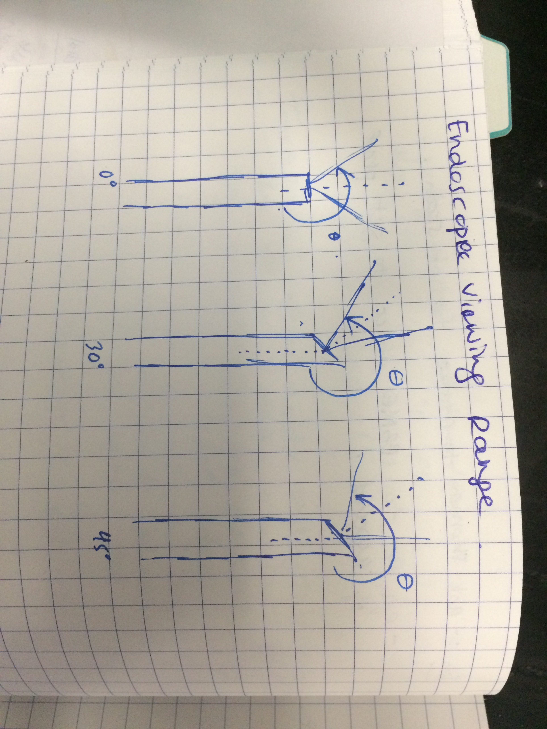
Ear Surgery Instruments/Pictures of Ideas/IMG_4794.JPG
