arushriswarup/Grad-School/Ear Surgery Instruments/Pictures of Ideas/IMG_4795.JPG

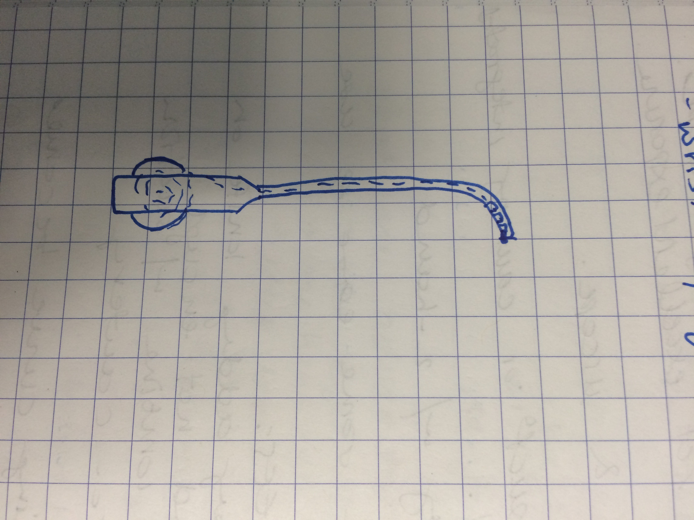
Ear Surgery Instruments/Pictures of Ideas/IMG_4795.JPG
