arushriswarup/Grad-School/Ear Surgery Instruments/Pictures of Ideas/IMG_4796.JPG

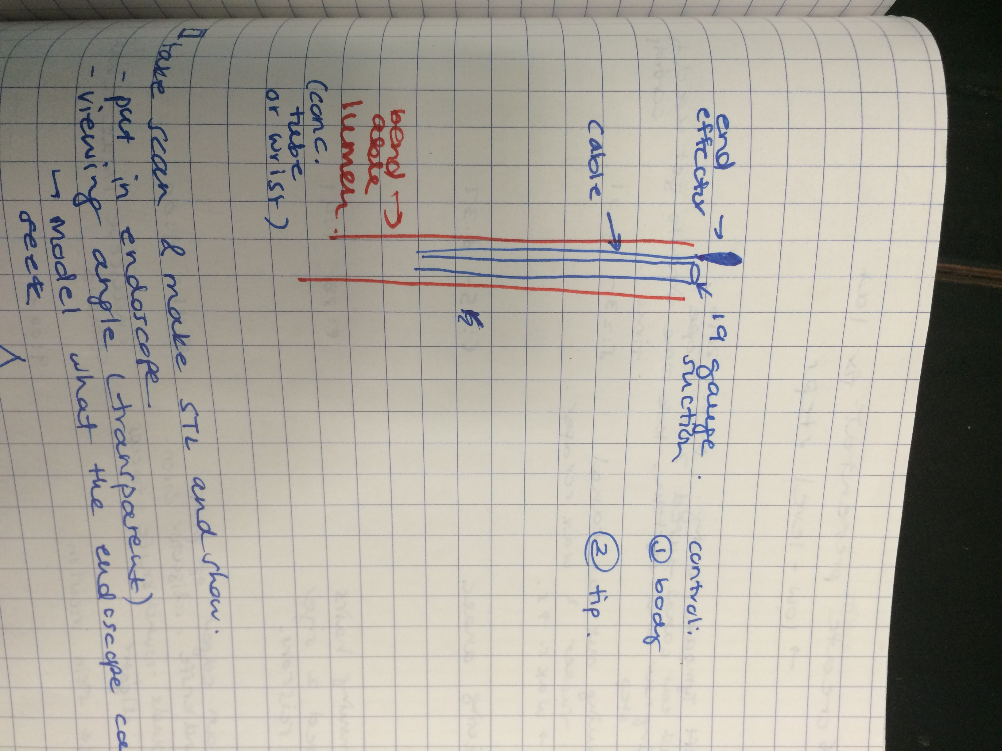
Ear Surgery Instruments/Pictures of Ideas/IMG_4796.JPG
