arushriswarup/Grad-School/Ear Surgery Instruments/Pictures of Ideas/IMG_4797.JPG

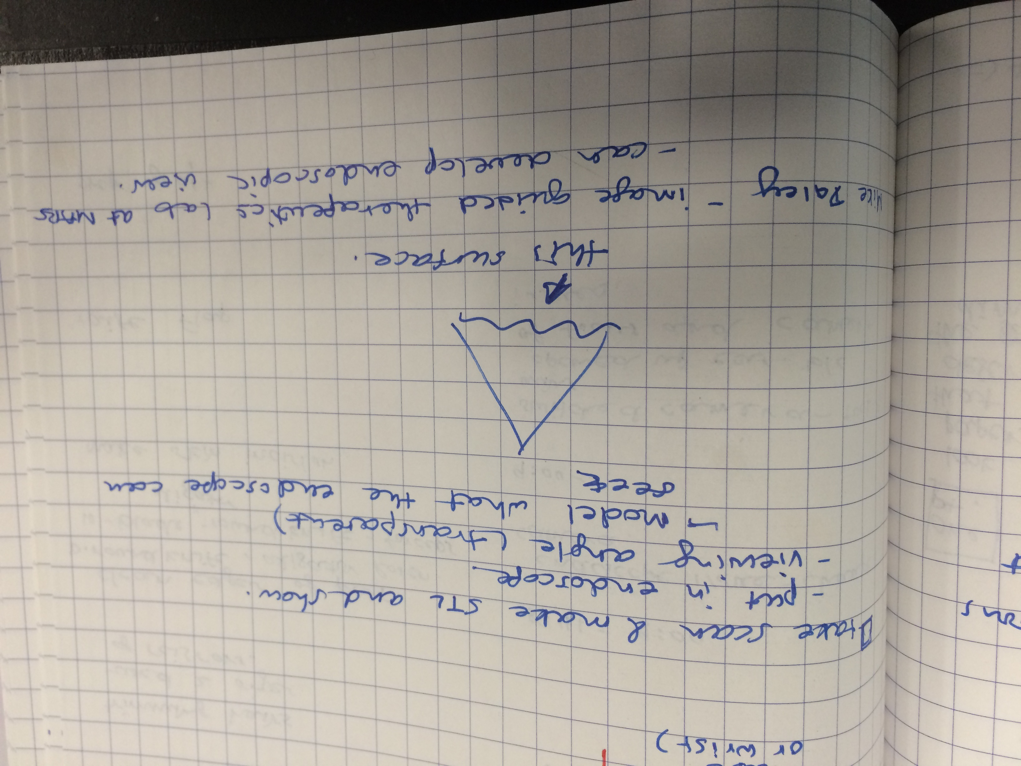
Ear Surgery Instruments/Pictures of Ideas/IMG_4797.JPG
