arushriswarup/Grad-School/Ear Surgery Instruments/Pictures of Ideas/IMG_4798.JPG

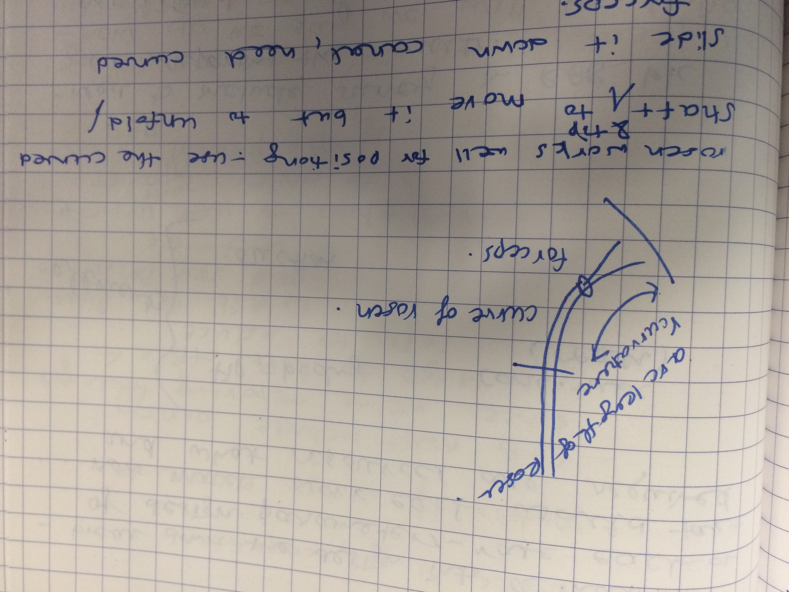
Ear Surgery Instruments/Pictures of Ideas/IMG_4798.JPG
