arushriswarup/Grad-School/Ear Surgery Instruments/Pictures of Ideas/IMG_4799.JPG

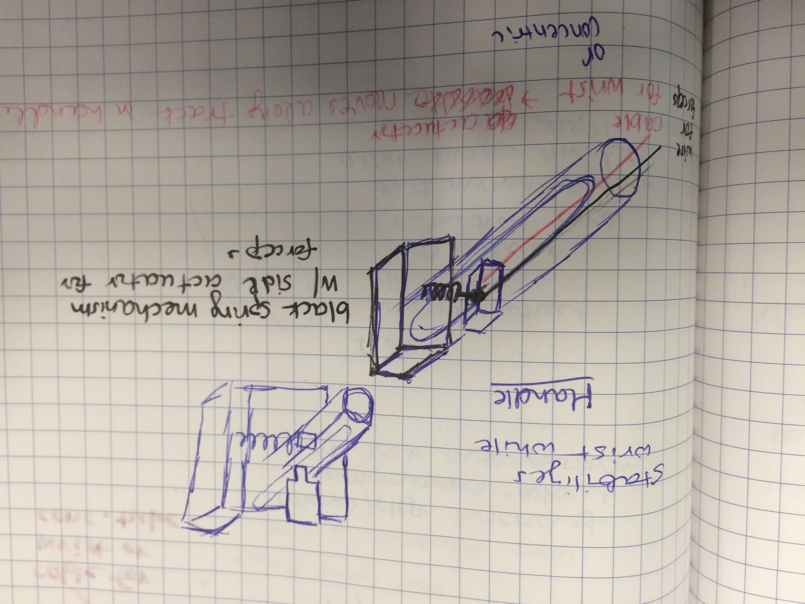
Ear Surgery Instruments/Pictures of Ideas/IMG_4799.JPG
