arushriswarup/Grad-School/Ear Surgery Instruments/Pictures of Ideas/IMG_4801.JPG

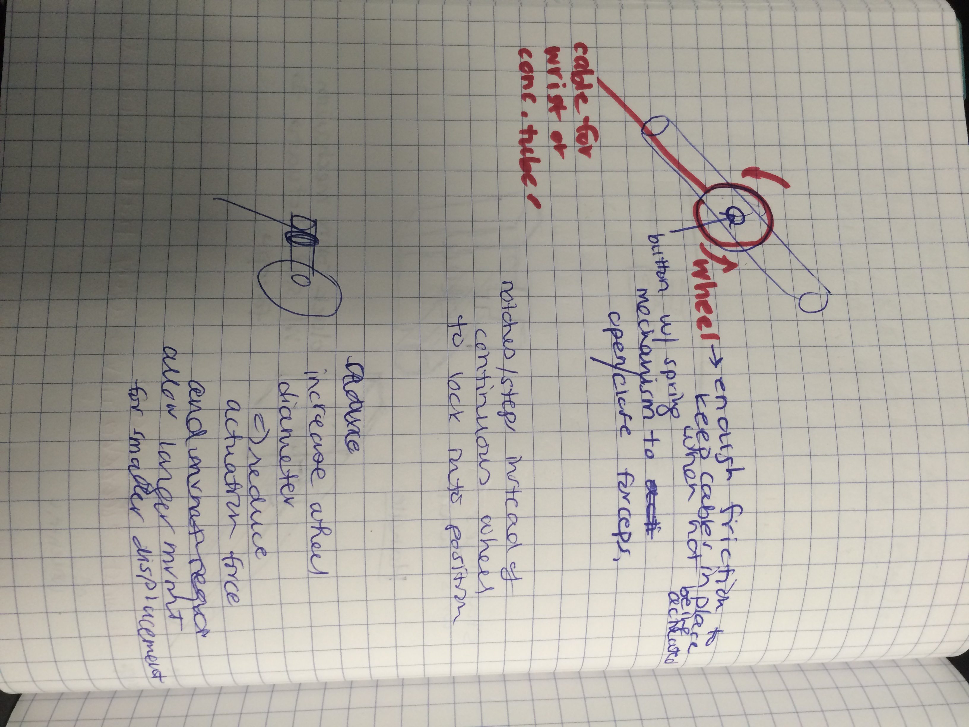
Ear Surgery Instruments/Pictures of Ideas/IMG_4801.JPG
