arushriswarup/Grad-School/Ear Surgery Instruments/Quotes/Rosen needle quote 11-Jul-2017.PNG

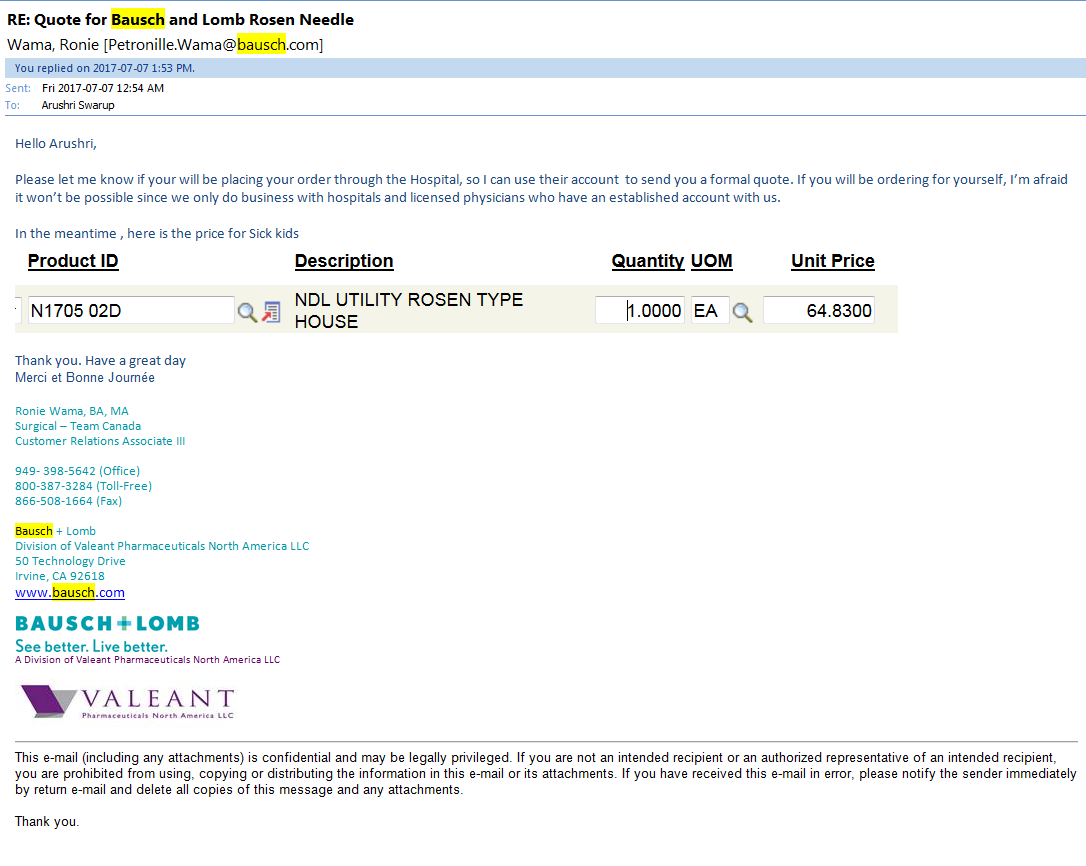
Ear Surgery Instruments/Quotes/Rosen needle quote 11-Jul-2017.PNG
