arushriswarup/Grad-School/Ear Surgery Instruments/Rosen Needle.png

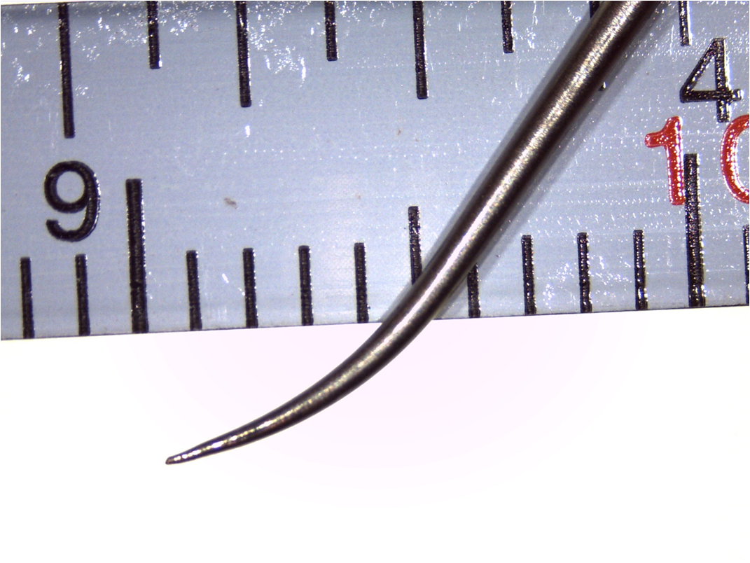
Ear Surgery Instruments/Rosen Needle.png
