arushriswarup/Grad-School/Ear Surgery Instruments/Thomassin dissector.png

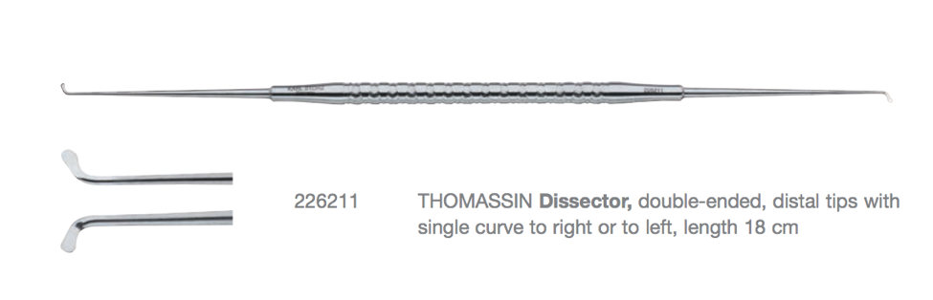
Ear Surgery Instruments/Thomassin dissector.png
