arushriswarup/Grad-School/Ear Surgery Instruments/wheels.JPG

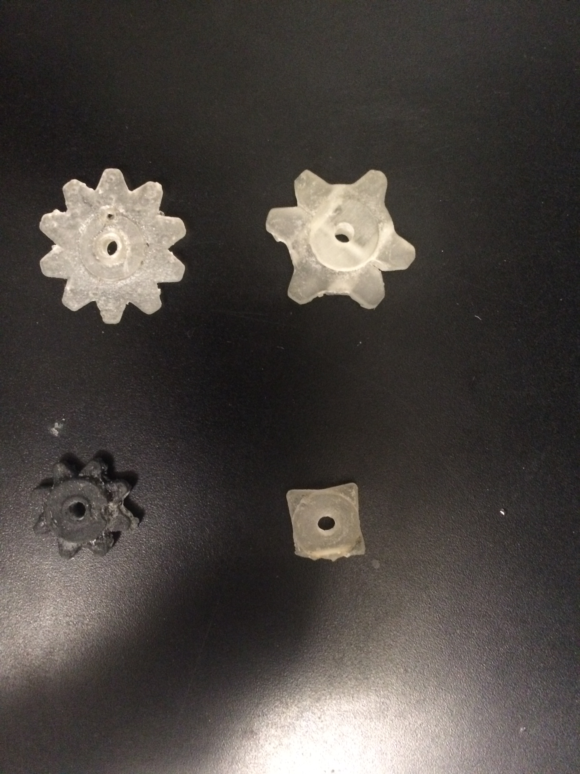
Ear Surgery Instruments/wheels.JPG
