arushriswarup/Grad-School/Endoscopic vs microscopic.png

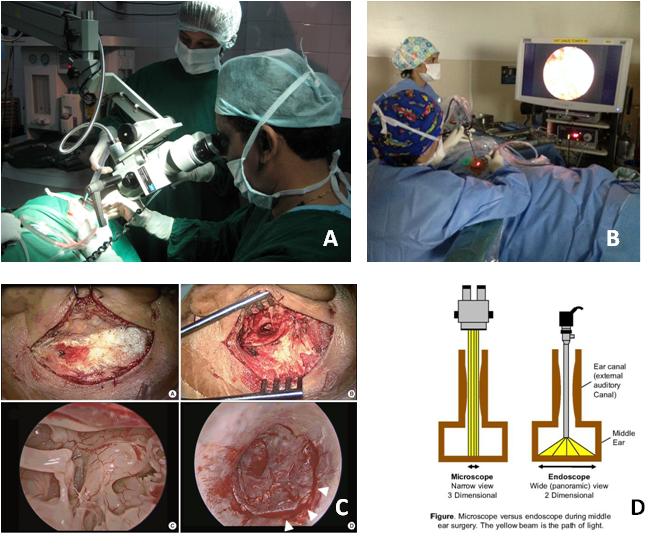
Endoscopic vs microscopic.png
