arushriswarup/Grad-School/Expenses/Home Hardware 28-Mar-2017.jpg

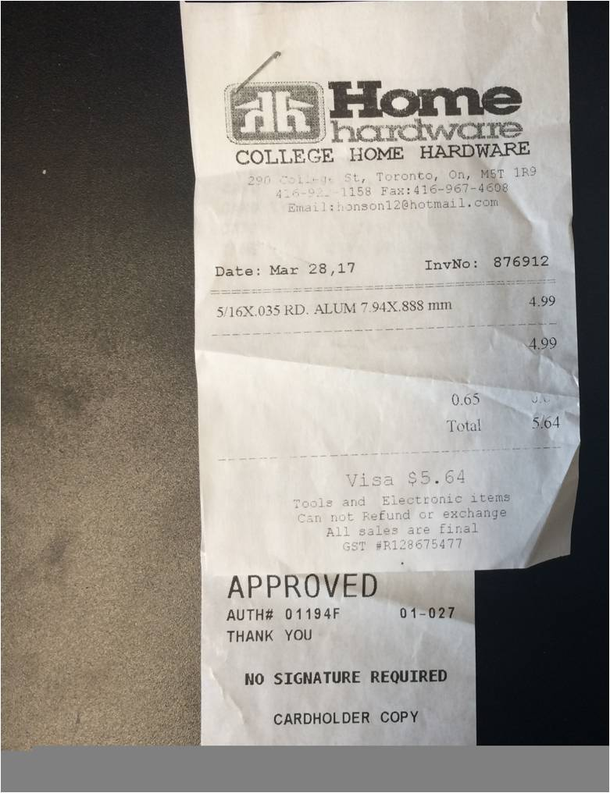
Expenses/Home Hardware 28-Mar-2017.jpg
