arushriswarup/Grad-School/Expenses/Home Hardware receipts Al tubes Mar-2017.jpg

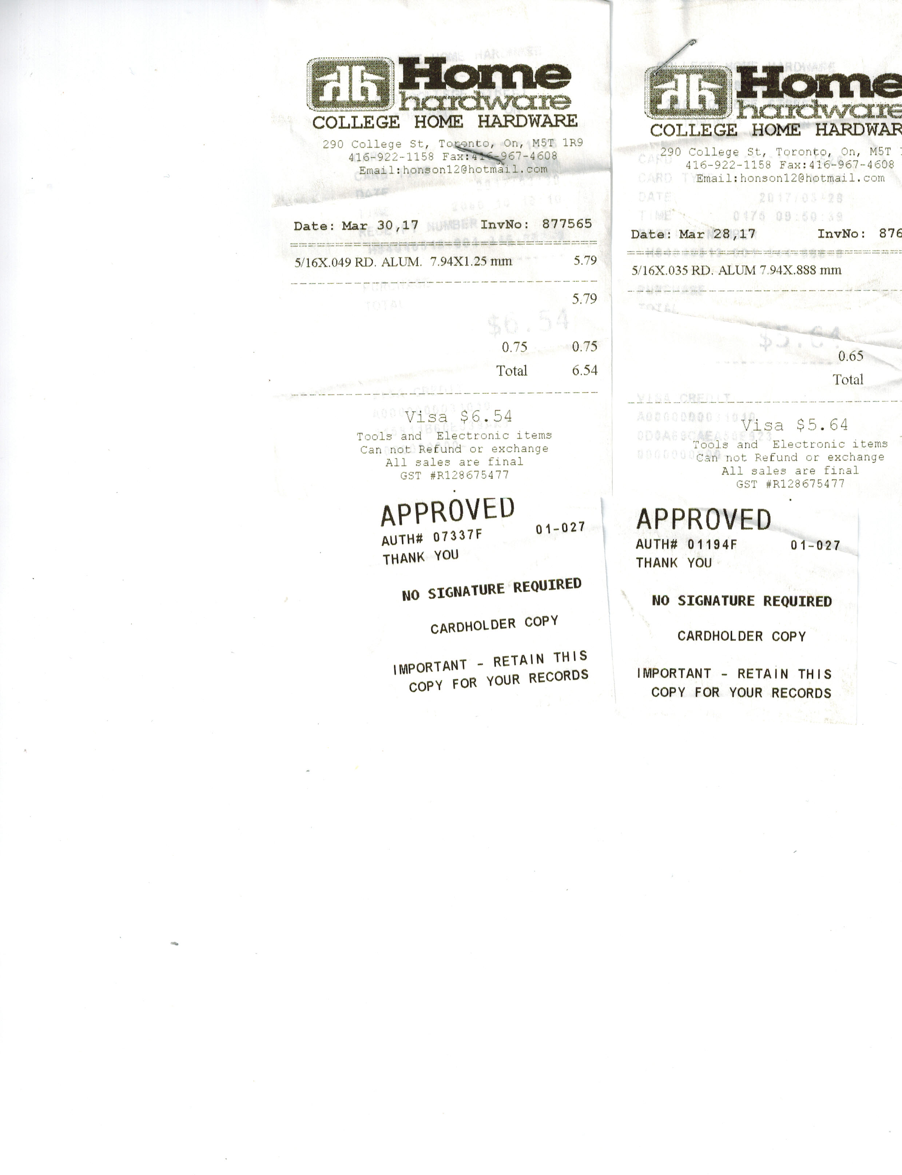
Expenses/Home Hardware receipts Al tubes Mar-2017.jpg
