arushriswarup/Grad-School/Funding/Greenshield/plan member number.PNG

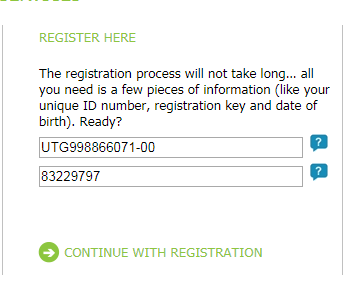
Funding/Greenshield/plan member number.PNG
