arushriswarup/Grad-School/Funding/SickKids Trainee Travel Award/IMG_6124.JPG

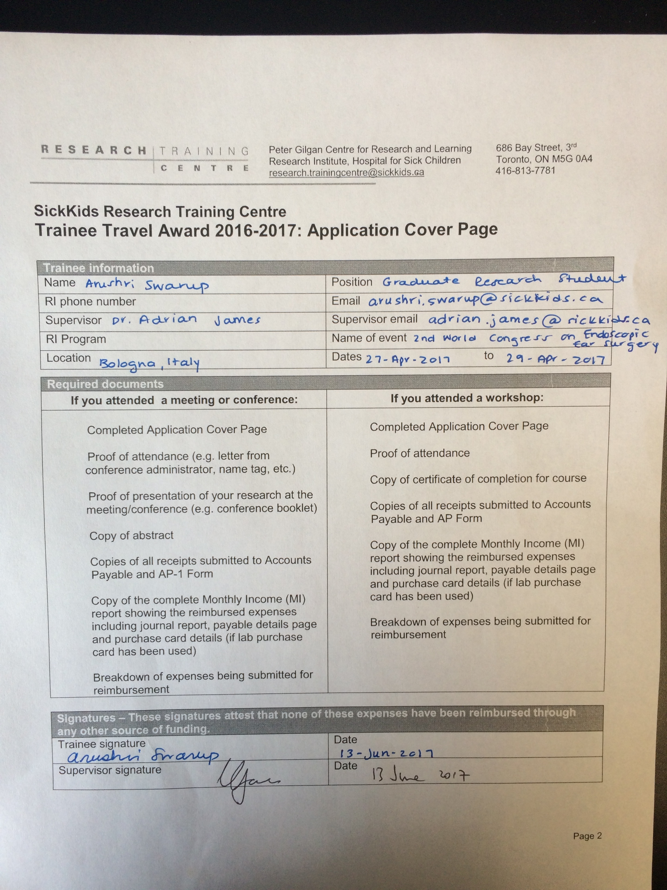
Funding/SickKids Trainee Travel Award/IMG_6124.JPG
