arushriswarup/Grad-School/Funding/University Wide Awards/financial needs form_1.jpg

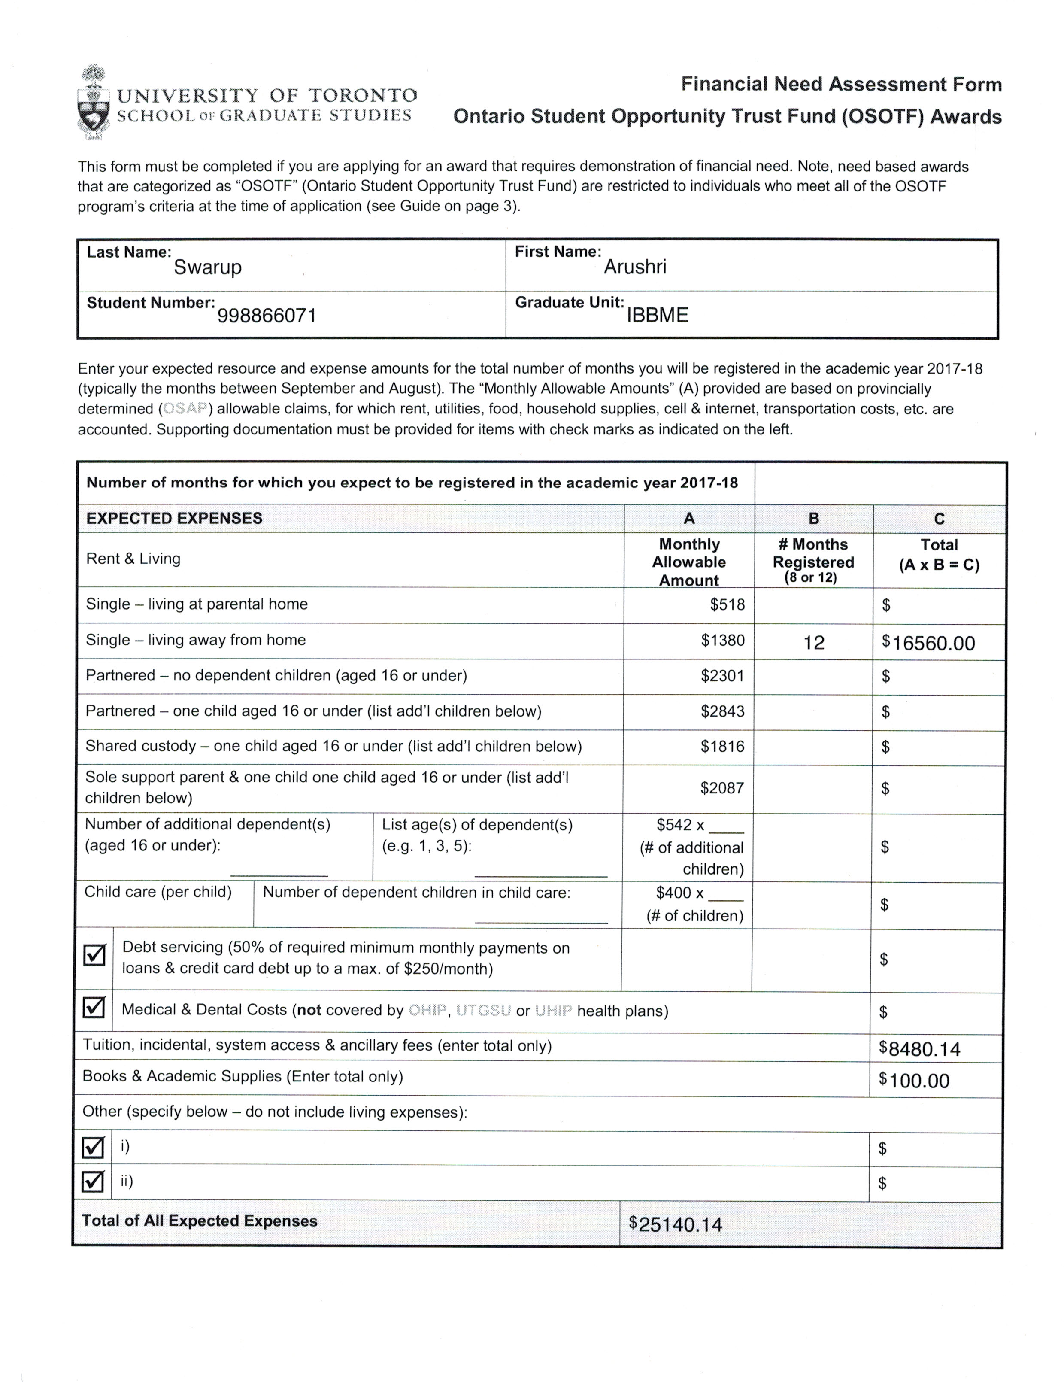
Funding/University Wide Awards/financial needs form_1.jpg
