arushriswarup/Grad-School/Funding/University Wide Awards/financial needs form_2.jpg

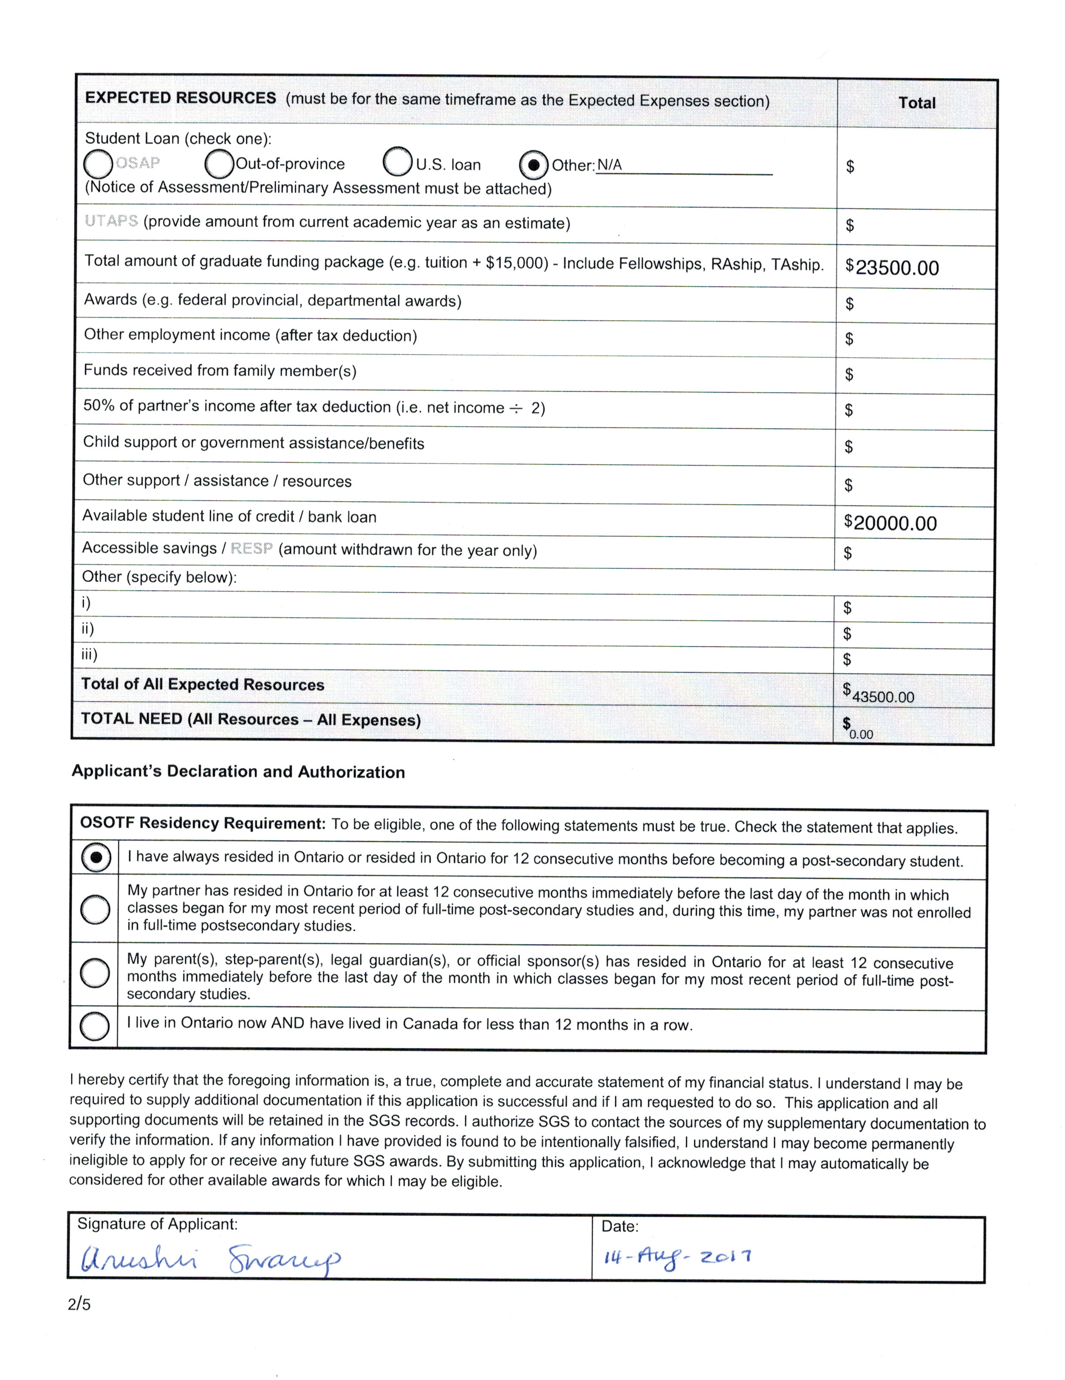
Funding/University Wide Awards/financial needs form_2.jpg
