arushriswarup/Grad-School/Papers/Otolaryngology Feb 2017 manuscript/otolaryngology_JG53247644 Figure 1.tif

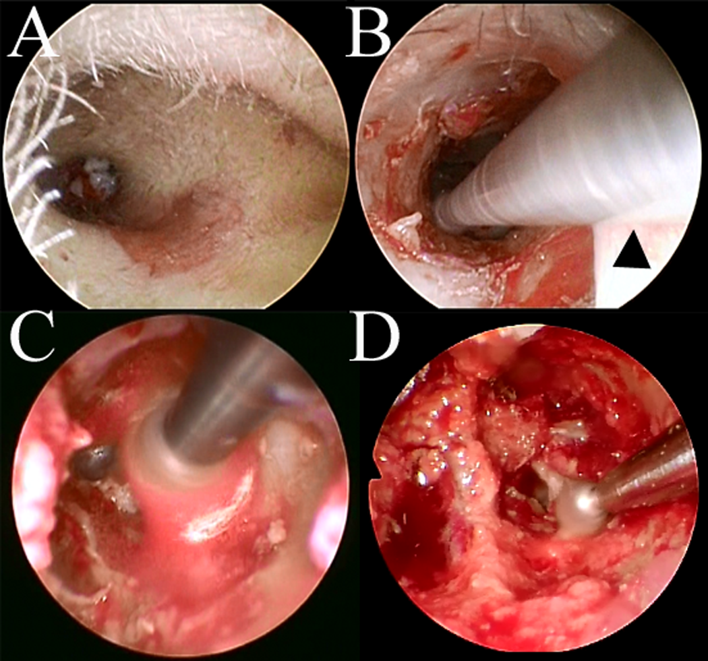
Papers/Otolaryngology Feb 2017 manuscript/otolaryngology_JG53247644 Figure 1.tif
