arushriswarup/Grad-School/sentac/Picture1.png

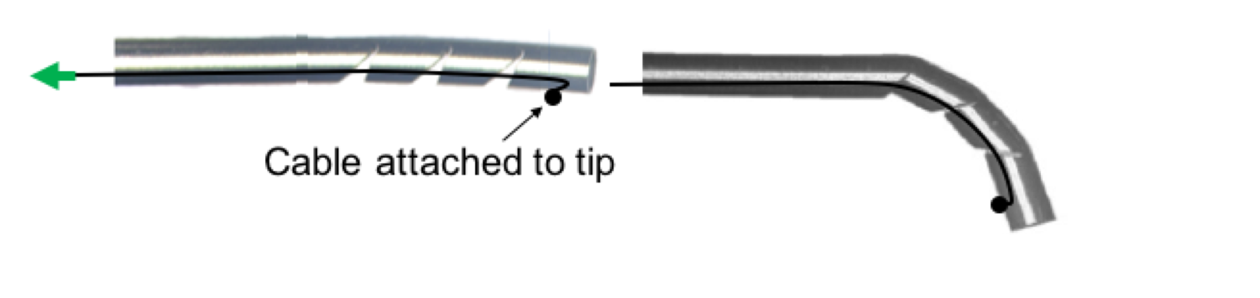
sentac/Picture1.png
