arushriswarup/Grad-School/Time Flow Study/Time Flow Study Box and Whisker Plot.png

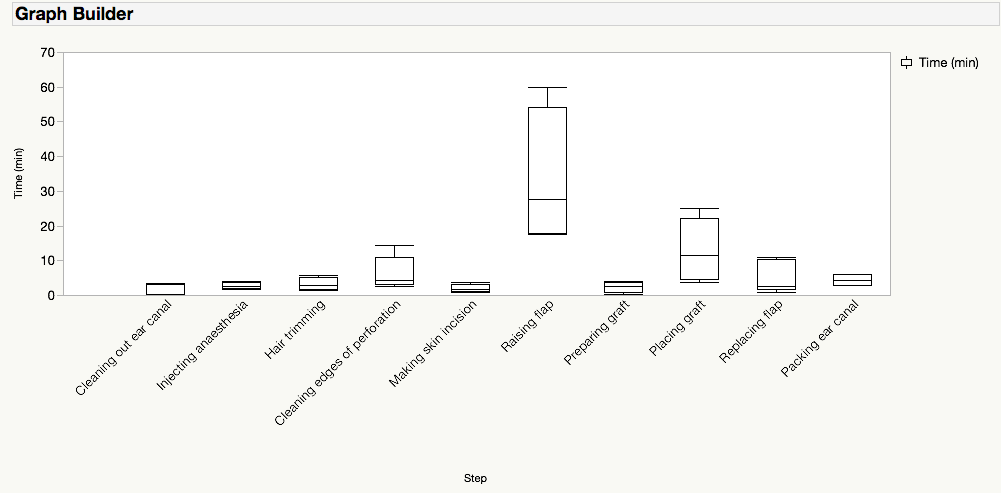
Time Flow Study/Time Flow Study Box and Whisker Plot.png
