arushriswarup/Grad-School/UHN Observership/IMG_6022.JPG

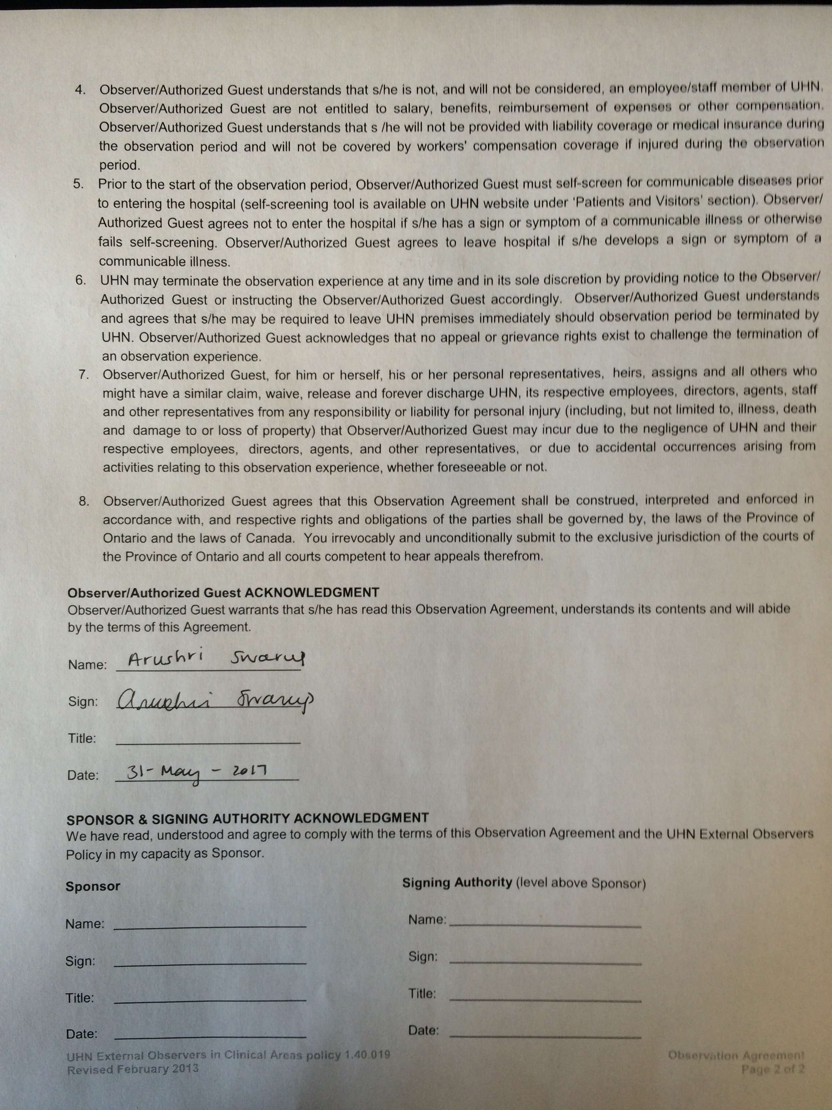
UHN Observership/IMG_6022.JPG
