arushriswarup/Grad-School/UHN Observership/IMG_6023.JPG

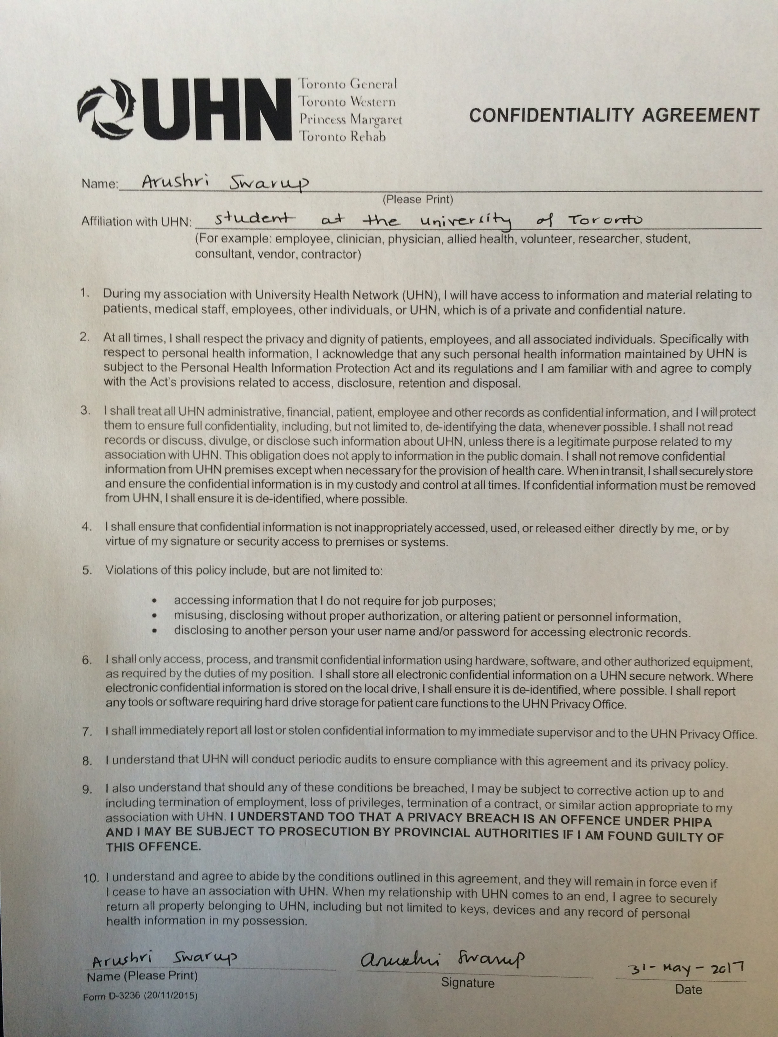
UHN Observership/IMG_6023.JPG
