arushriswarup/Grad-School/UHN Observership/IMG_6024.JPG

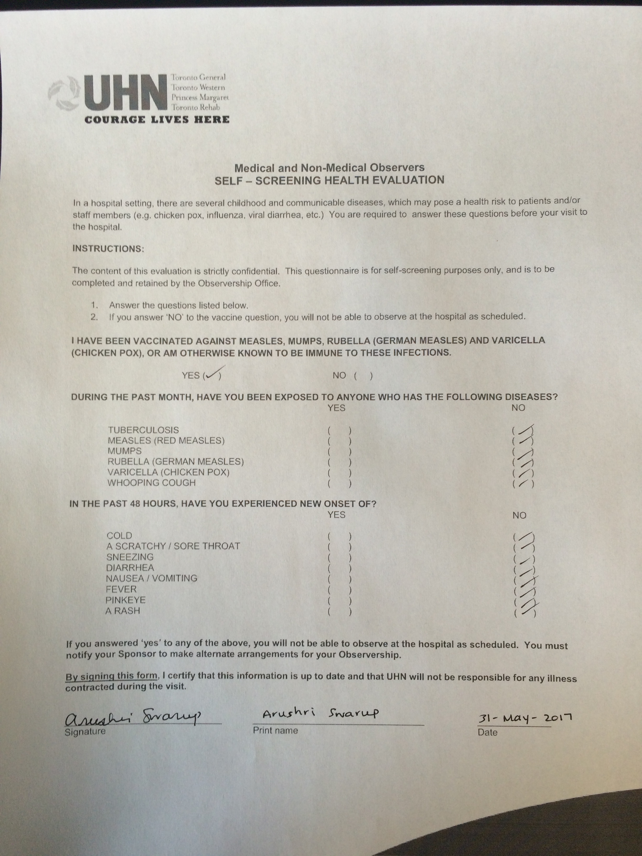
UHN Observership/IMG_6024.JPG
