arushriswarup/Grad-School/Ear Surgery Instruments/Wrist Tool Assembly/superceded/Clinical Tool/Components info and quotes/Thread assignments.docx

Collet Clamp: inner threads: M7X1

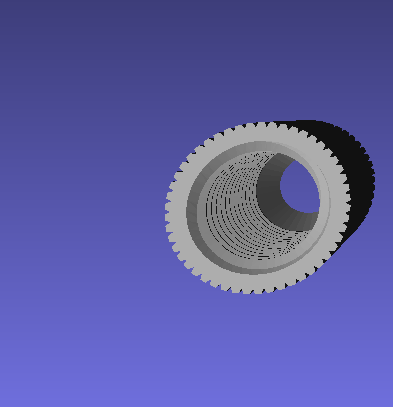
[picture p217: figure]

Handle M7 threads: outer threads: M7X1

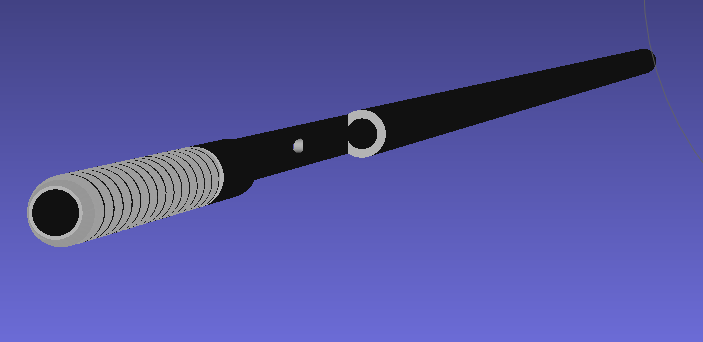
[picture p218: figure]

Wedge: inner thread: 4-40

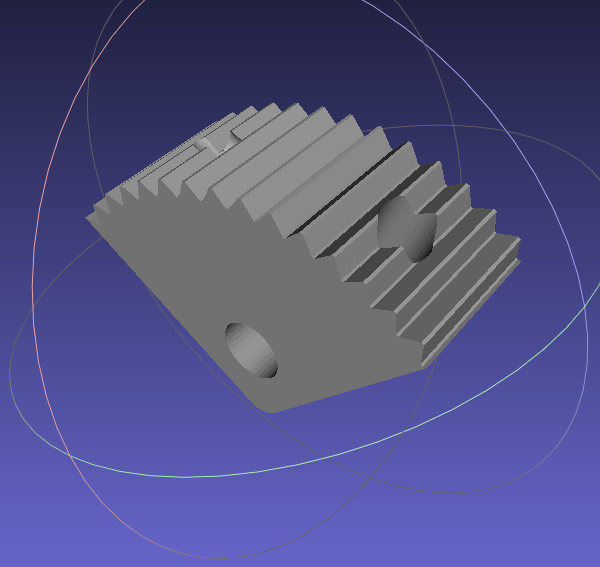
[picture p219: figure]
