arushriswarup/Grad-School/Ear Surgery Instruments/Budget and Materials 11-Dec-2017.xlsx

Sheet: Sheet1
 | Item | Description | Price/Unit | Unit | Qty | Cost (CAD) | Source |  | Cost (USD)
Instruments
 | N1705-2D | Rosen Needle | 64.83 | piece | 2 | 129.66 | C:\Users\arushri swarup\Documents\GitHub\Grad-School\Ear Surgery Instruments\Quotes\Rosen needle quote 11-Jul-2017 |  | 98.5416 | 0.76 | as of 21-Feb-2017 the exchange rate is 0.6883 CAD = 1 USD
 | 10-802-02 | Suction dissector for sinus tympani, double curved, 6 mm, left | 708 |  | 1 | 708 | C:\Users\arushri swarup\Documents\GitHub\Grad-School\Ear Surgery Instruments\Quotes\Panetti instrument quote 11-Jul-2017 |  | 538.08 | 1.13 | tax (HST)
 | 10-804-12 | Suction dissector for atticus, double curved, 6 mm, left | 708 |  | 1 | 708 | C:\Users\arushri swarup\Documents\GitHub\Grad-School\Ear Surgery Instruments\Quotes\Panetti instrument quote 11-Jul-2018
 | 10-813-12 | Suction dissector for ear drum, single curved, very fine, left | 738 |  | 1 | 738 | C:\Users\arushri swarup\Documents\GitHub\Grad-School\Ear Surgery Instruments\Quotes\Panetti instrument quote 11-Jul-2019
 | 10-814-12 | Suction dissector for ear drum, single curved, very fine, right | 738 |  | 1 | 738 | C:\Users\arushri swarup\Documents\GitHub\Grad-School\Ear Surgery Instruments\Quotes\Panetti instrument quote 11-Jul-2020
 |  |  |  | Total | 6 | 3021.66
Sub-Total + tax |  |  |  |  |  | 6828.9516 |  |  | 719.382408
Prototyping Materials:
 | Nitinol Tubing - NDC | Inner diameter > 0.039" | 80 | ft (min. 4 ft) | 4 | 320 | https://shop.nitinol.com/shop/?slug=index.php&cPath=27 | to be safe, 1800 budget | 243.2
Sub-Total + tax |  |  |  |  |  | 361.6 |  |  | 274.816
Personnel
 | Student Stipend |  | 23465 | year | 1 | 23465 |  |  | 17833.4
Sub-Total |  |  |  |  |  | 23465 |  |  | #REF!
Grand Total |  |  |  |  |  | 30655.5516 |  |  | #REF! | #REF!
 |  |  |  | 2339.1
Budget for REB: | Item | Description | Price/Unit | Unit | Qty | Total Cost
 | Master's Student | Stipend | 23465 | year | 0.5 | 11732.5

Sheet: Pusher Device
Device: Pusher
 | Component | Technical Spec
 | Nitinol tube (metal sheath) | ID = 1mm = 0.039"
 | Thumb Piece | ID = 5mm
 | Thumb Piece Pusher extrusion | slot >= 1mm | extrusion length = 44.5mm = 1.75"
 | Thumb Piece Length | TBD based on ergonomics testing
 | Thumb Piece OD | TBD based on ergonomics testing
Design Iterations:
 | Version: | Desription: | Revision Notes: | Link:
 | V-2 | Intital - tested on ear cadaver and generally works | - ergonomics - thumb piece too long (1"), OD too thick (0.19" - distance from hole to OD) - size - thumb piece pusher extrusion - sticking out too wide from body of Rosen Needle (0.07") | https://drive.google.com/open?id=0B1QbcJa_MetzNHRONUEwN2RLQkk
 | V-3 | - thumb piece - length = 0.75", distance from hole to OD = 0.07" - - thumb piece pusher extrusion = 0.07" wide, slot = 0.03" wide |  | https://drive.google.com/open?id=0B1QbcJa_MetzbzhoUXVwSGRuSlU
 | V-4 | - thumb piece - length = 0.75", distance from hole to OD = 0.07" - thumb piece pusher extrusion = 0.05" wide, slot = 0.025" wide so the walls are not too thin |  | https://drive.google.com/open?id=0B1QbcJa_MetzZ21FMjZ6OTJYM2M

Sheet: BOM
 | Component | Material | Dimensions | Supplier | Supplier P/N | Qty | Cost | Manufacturing Sterility Cert | Assembly Instruction: | Assembly Sterility Cert:
Tubing Assembly:
 | Wristed Tip | Nitinol Tube | 1.24mm OD | Lab |  |  |  | obtainable: Confluent medical makes medical- grade NiTi | CHANGE ASSEMBLY PROCESS - currently solder the cable to the tip and wrist to the shaft - need to redesign
 |  | laser cutting |  | Pulse Systems | quote Number |  |  | obtainable
 | Stainless steel tube 5560K43, soldered to wrist | stainless steel tube | 1.27mmID X 1.47mmOD | McMaster Carr | 5560K43 | 3 ft | 21.57 USD | ask McMaster Carr | CHANGE ASSEMBLY PROCESS - currently wrist is soldered to the shaft
 | tube without cable, coupled with suction tubing and luer lock | stainless steel tube | 1.6mm ID X 2.11mmID | McMaster Carr | 8988K35 |  |  | ask McMaster Carr | laser welded to the shaft (laser welding sterility cert?) slides into the silicone tubing set screw clamps it into the luer-tube coupler
 | Suction Tubing | silicone |  |  |  |  |  |  | slips/fits around the SS tube without cable on both ends
 | collet 1.75 mm ID |  |  | Amazon | amazon: "Bestgle 14pcs 0.5-3mm Small Electric Drill Bit Collet Micro Twist Drill Chuck Set with Allen wrench" | 3 pairs | CAD 32.25 | unknown manufacturer | clamped by the collet thread cap
Handle: | Collet thread cap |  |  | Amazon | amazon: "Bestgle 14pcs 0.5-3mm Small Electric Drill Bit Collet Micro Twist Drill Chuck Set with Allen wrench" |  |  | unknown manufacturer | screws onto the handle body
 | Handle Body | Aluminum tube | 5/16X0.049in | Home Hardware |  |  |  | unknown | holes with threads for the collet thread cap, ultra low profile screw
 | Ultra Low Profile SS screw 90318A102 |  | 3/32in, 2-56 | McMaster Carr | 90318A102 |  |  | ask McMaster Carr | holds the wheel in place
 | Wheel |  |  | Form 1+ 3D printed |  |  |  | 3D printed | holes for cable/tube assembly, set screw
 | tube that is clamped in the wheel | SS |  |  |  |  |  | ask McMaster Carr | laser welded to the cable end and set screw clamped into the wheel
 | Luer end |  | 10-32 end | McMaster Carr | 51465K161 |  |  | ask McMaster Carr | screws into the luer-tube coupler
 | Luer-tube coupler | Aluminum |  | Mill machined at Lab |  |  |  | 3D printed or machined | holes for the luer end and set screw for luer-tube coupler
 | Cable | ss | 0.3mm | Lab |  |  |  | ask manufacturer | CHANGE ASSEMBLY PROCESS - currently solder ball at the tip laser weld the other end into a stainless steel tube
 | set screw for luer-tube coupler |  | 5-40 | McMaster Carr |  |  |  | ask McMaster Carr | set screw clamps the SS tube without cable into place on the luer-tube coupler
 | set screw for wheel |  | 5-40 | McMaster Carr |  |  |  | ask McMaster Carr | set screw clamps the cable + tube into place in the wheel
to order
to print/make

Sheet: Wrist Laser Cutting
Nitinol Wristed Tip Laser Cutting
filename: | 135deg CCM V-1 Wrist 07-Dec-2017.PDF
location: | /Users/arushriswarup/Documents/GitHub/Grad-School/Ear Surgery Instruments/Wristed Cuts
models: | 80deg CCM V-1 Wrist left
 | 80deg CCM V-1 Wrist right
 | 135deg CCM V-1 Wrist right
 | 135deg CCM V-1 Wrist left
