arushriswarup/Grad-School/Ear Surgery Instruments/Endoscopic ear instrument order 2015_from Dr. James.xlsx

Sheet: Sheet1
Panetti |  | $ | number | Total | min |  | Middle ear set | Mini ME extra / endoscopic set
suction round knife |  | 658 | 5 | 3290 | 4 | 2632 | 4 | 1 | 658
connector |  | 472 | 5 | 2360 | 5 | 2360 | 4 | 1 | 472
forceps | up | 474 | 5 | 2370 | 4 | 1896 | 4 | 1 | 474
forceps | down | 724 | 5 | 3620 |  | 0 | 4 | 1 | 724
dissector L |  | 658 | 4 | 2632 | 1 | 658 | 4
dissector R |  | 658 | 4 | 2632 | 1 | 658 | 4
new dissector L |  | 658 | 4 | 2632 | 4 | 2632 | 4
new dissector R |  | 658 | 4 | 2632 | 4 | 2632 | 4
basket |  | 1995 | 0 | 0 |  | 0
steriliser |  | 1712 | 1 | 1712 | 1 | 1712 | 1
microhook |  | 658 | 1 | 658 | 1 | 658 |  | 1 | 658
dissector double curve L |  | 658 | 1 | 658 | 1 | 658 |  | 1 | 658
dissector double curve R |  | 658 | 1 | 658 | 1 | 658 |  | 1 | 658
Storz |  |  |  | 0 |  | 0
Endoscope | 30°, 3mm 14cm | 4995 |  | 0 |  | 0
Endoscope | 0°, 3mm 14cm | 4995 | 1 | 4995 | 1 | 4995
Endoscope | tray | 425 |  | 0 |  | 0
ear hook | R | 223.26 | 1 | 223.26 | 1 | 223.26 |  | 1 | 223.26
ear hook | L | 223.26 | 1 | 223.26 | 1 | 223.26 |  | 1 | 223.26
ear dissector | R | 223.26 | 1 | 223.26 | 1 | 223.26 |  | 1 | 223.26
ear dissector | L | 223.26 | 1 | 223.26 | 1 | 223.26 |  | 1 | 223.26
curette | 90° double ended | 267.91 | 4 | 1071.64 | 1 | 267.91 | 4
 |  |  |  |  |  | 0
Aesculap |  |  |  |  |  | 0
cupped forceps | 0G343R |  | 3 |  | 3 | 0 | 3
cupped forceps | 0G344R |  | 3 |  | 3 | 0 | 3
 |  |  |  |  |  | 0
 |  |  |  | 32813.68 |  | 23309.95 |  |  | 5195.04
HST |  |  |  | 37079.4584 |  | 26340.2435 |  |  | 5870.3952
Remaining budget |  |  |  | -10079.4584 |  | 659.7565
Remaining budget |  | before HST |  |  |  | 583.8553097

Sheet: Sheet2
 |  | Product code number | $ per item | Number of items | Cost
Panetti
suction round knife |  | 10-808-12 | 658 | 4 | 2632 | suction seperator suction on inside
connector |  | 10-850-00 | 472 | 5 | 2360
forceps | up | 10-703-03 | 474 | 4 | 1896
forceps | down |  | 724 |  | 0
dissector L |  | 10-800-12 | 658 | 1 | 658
dissector R |  | 10-801-12 | 658 | 1 | 658
delicate dissector L |  | 10-813-12 | 658 | 4 | 2632
delicate dissector R |  | 10-814-12 | 658 | 4 | 2632
basket |  |  | 1995 |  | 0
steriliser |  | 10-845-00 | 1712 | 1 | 1712
microhook |  | 10-867-12 | 658 |  | 0
dissector sinus tympani L |  | 10-802-12 | 658 | 1 | 658
dissector sinus tympani R |  | 10-803-12 | 658 | 1 | 658
dissector atticus L |  | 10-805-12 | 658 | 1 | 658
dissector atticus R |  | 10-804-12 | 658 | 1 | 658
Storz
Endoscope | 30°, 3mm 14cm |  | 4995 |  | 0
Endoscope | 0°, 3mm 14cm | 7220AA | 4995 | 1 | 4995
Endoscope | tray |  | 425 |  | 0
ear hook | R | 227201 | 223.26 | 1 | 223.26
ear hook | L | 227202 | 223.26 | 1 | 223.26
ear dissector | R | 227206 | 223.26 | 1 | 223.26
ear dissector | L | 227207 | 223.26 | 1 | 223.26
curette | 90° double ended | 227213 | 267.91 | 1 | 267.91
Aesculap
cupped forceps |  | 0G343R |  | 3 | 0
cupped forceps |  | 0G344R |  | 3 | 0
Subtotal |  |  |  |  | 23967.95
Total incl HST |  |  |  |  | 27083.7835
Remaining budget |  |  |  |  | -83.78
Remaining budget |  |  | before HST |  | -74.14
