arushriswarup/Grad-School/Ear Surgery Instruments/superceded/Budget and Materials 14-Mar-2017.xlsx

Sheet: Sheet1
 | Item | Description | Price/Unit | Unit | Qty | Cost (CAD) | Source |  | Cost (USD)
Instruments
 | Rosen Needle (small) |  | 75.5 | piece | 3 | 226.5 | Sick Kids Quotation - Dr Adrian James - Jan 8 2016.pdf |  | 172.14 | 0.76 | as of 21-Feb-2017 the exchange rate is 0.6883 CAD = 1 USD
 | Rosen Needle (large) |  | 152.6 | piece | 3 | 457.8 | Sick Kids Quotation - Dr Adrian James - Jan 8 2016.pdf |  | 347.928 | 1.13 | tax (HST)
 | Panetti - 10-800-12 | Suction dissector for ear drum single curved, left side, 3 mm | 658 | piece | 1 | 658 | see email from Dr. James - 07-Jan-2016 catalogue: http://entermedkno.mediastorm.nl/bestanden/380/Panetti%20Suction%20Instruments%20Set.pdf |  | 500.08
 | Panetti - 10-802-12 | Suction dissector for sinus tympani, double curved, backwards, left side, 6 mm | 658 | piece | 1 | 658 |  |  | 500.08
 | Panetti - 10-850-00 | connector | 472 | piece | 1 | 472 |  |  | 358.72
 | 19 Gauge Suction Cannula |  | 30 | piece | 2 | 90 | http://www.mytamed.com/Rosen-Suction-Tubes-p/rosen-suction-tubes.htm |  | 68.4
 | T-Tube Inserter |  | 75 | piece | 1 | 110 | http://www.re-owned.com/itemcode-308656320-c3#.Vnytmd-rT-Y |  | 83.6
 | KNIFE MCO5D MICROFRANCE SUCTION RND 2MM |  | 274.5 | piece | 1 | 274.5 | MF-18652-011516.18N.pdf |  | 208.62
 | KNIFE MCO5E MICROFRANCE SUCTION RND 3MM |  | 274.5 | piece | 1 | 274.5 | MF-18652-011516.18N.pdf |  | 208.62
 | PICK MCO989 180MM CVD MONOPOLAR LEGENT |  | 251.1 | piece | 1 | 251.1 | MF-18652-011516.18N.pdf |  | 190.836
 | CABLE CP391 1.8M MONOPOLAR |  | 51.3 | piece | 1 | 51.3 | MF-18652-011516.18N.pdf |  | 38.988
Sub-Total + tax |  |  |  |  |  | 3981.781 |  |  | 3026.15356
Prototyping Materials:
 | Nitinol Tubing - NDC | Inner diameter > 0.039" | 80 | ft (min. 4 ft) | 4 | 320 | https://shop.nitinol.com/shop/?slug=index.php&cPath=27 | to be safe, 1800 budget | 243.2
 | 3D Printing Budget |  | 40 | piece | 20 | 800 | Proto3000 - Initial thumb piece slider quote = $65.00 |  | 608
 | Machining Bits |  |  |  |  | 100 |  |  | 76
 | Metal Machining |  |  |  |  | 3000 |  |  | 2280
Sub-Total + tax |  |  |  |  |  | 4768.6 |  |  | 3624.136
Personnel
 | Student Stipend |  | 23465 | year | 1 | 23465 |  |  | 17833.4
Sub-Total |  |  |  |  |  | 23465 |  |  | #REF!
Grand Total |  |  |  |  |  | 32215.381 |  |  | #REF! | #REF!
 |  |  |  | 2339.1
Budget for REB: | Item | Description | Price/Unit | Unit | Qty | Total Cost
 | Master's Student | Stipend | 23465 | year | 0.5 | 11732.5

Sheet: Pusher Device
Device: Pusher
 | Component | Technical Spec
 | Nitinol tube (metal sheath) | ID = 1mm = 0.039"
 | Thumb Piece | ID = 5mm
 | Thumb Piece Pusher extrusion | slot >= 1mm | extrusion length = 44.5mm = 1.75"
 | Thumb Piece Length | TBD based on ergonomics testing
 | Thumb Piece OD | TBD based on ergonomics testing
Design Iterations:
 | Version: | Desription: | Revision Notes: | Link:
 | V-2 | Intital - tested on ear cadaver and generally works | - ergonomics - thumb piece too long (1"), OD too thick (0.19" - distance from hole to OD) - size - thumb piece pusher extrusion - sticking out too wide from body of Rosen Needle (0.07") | https://drive.google.com/open?id=0B1QbcJa_MetzNHRONUEwN2RLQkk
 | V-3 | - thumb piece - length = 0.75", distance from hole to OD = 0.07" - - thumb piece pusher extrusion = 0.07" wide, slot = 0.03" wide |  | https://drive.google.com/open?id=0B1QbcJa_MetzbzhoUXVwSGRuSlU
 | V-4 | - thumb piece - length = 0.75", distance from hole to OD = 0.07" - thumb piece pusher extrusion = 0.05" wide, slot = 0.025" wide so the walls are not too thin |  | https://drive.google.com/open?id=0B1QbcJa_MetzZ21FMjZ6OTJYM2M

Sheet: Sheet2
BOM for suction Wristed Tool
 | Component | Material | Dimensions | Supplier | Supplier P/N | Qty | Cost
Tubing Assembly:
 | Wristed Tip | Nitinol Tube | 1.24mm OD | Lab
 |  | laser cutting |  | Pulse Systems | quote Number
 | Stainless steel tube 5560K43, soldered to wrist | stainless steel tube | 1.27mmID X 1.47mmOD | McMaster Carr | 5560K43
 | tube without cable, coupled to luer lock | stainless steel tube | 1.6mm ID X 2.11mmID | McMaster Carr | 8988K35
 | collet 1.75 mm ID |  |  | Lab
 | Collet thread cap |  |  | Form 1+ 3D printed
 | Wheel Handle Body | Aluminum tube | 5/16in OD | McMaster Carr | 89965K451
 | Ultra Low Profile SS screw 90318A102 |  | 3/32in, 2-56 | McMaster Carr | 90318A102
 | Wheel |  |  | Form 1+ 3D printed
 | Luer end |  | 10-32 end | McMaster Carr | 51465K161
 | Luer-tube coupler | Aluminum |  | Mill machined at Lab
 | Cable | ss | 0.3mm | Lab
