arushriswarup/Grad-School/Ear Surgery Instruments/Wrist Tool Assembly/Clinical Tool/Components info and quotes/Clinical Tool BOM.xlsx

Sheet: Sheet1
 | Item | Description | Price/Unit | Unit | Qty | Cost (CAD) | Source |  | Cost (USD)
Instruments
 | N1705-2D | Rosen Needle | 64.83 | piece | 2 | 129.66 | C:\Users\arushri swarup\Documents\GitHub\Grad-School\Ear Surgery Instruments\Quotes\Rosen needle quote 11-Jul-2017 |  | 98.5416 | 0.76 | as of 21-Feb-2017 the exchange rate is 0.6883 CAD = 1 USD
 | 10-802-02 | Suction dissector for sinus tympani, double curved, 6 mm, left | 708 |  | 1 | 708 | C:\Users\arushri swarup\Documents\GitHub\Grad-School\Ear Surgery Instruments\Quotes\Panetti instrument quote 11-Jul-2017 |  | 538.08 | 1.13 | tax (HST)
 | 10-804-12 | Suction dissector for atticus, double curved, 6 mm, left | 708 |  | 1 | 708 | C:\Users\arushri swarup\Documents\GitHub\Grad-School\Ear Surgery Instruments\Quotes\Panetti instrument quote 11-Jul-2018
 | 10-813-12 | Suction dissector for ear drum, single curved, very fine, left | 738 |  | 1 | 738 | C:\Users\arushri swarup\Documents\GitHub\Grad-School\Ear Surgery Instruments\Quotes\Panetti instrument quote 11-Jul-2019
 | 10-814-12 | Suction dissector for ear drum, single curved, very fine, right | 738 |  | 1 | 738 | C:\Users\arushri swarup\Documents\GitHub\Grad-School\Ear Surgery Instruments\Quotes\Panetti instrument quote 11-Jul-2020
 |  |  |  | Total | 6 | 3021.66
Sub-Total + tax |  |  |  |  |  | 6828.9516 |  |  | 719.382408
Prototyping Materials:
 | Nitinol Tubing - NDC | Inner diameter > 0.039" | 80 | ft (min. 4 ft) | 4 | 320 | https://shop.nitinol.com/shop/?slug=index.php&cPath=27 | to be safe, 1800 budget | 243.2
Sub-Total + tax |  |  |  |  |  | 361.6 |  |  | 274.816
Personnel
 | Student Stipend |  | 23465 | year | 1 | 23465 |  |  | 17833.4
Sub-Total |  |  |  |  |  | 23465 |  |  | #REF!
Grand Total |  |  |  |  |  | 30655.5516 |  |  | #REF! | #REF!
 |  |  |  | 2339.1
Budget for REB: | Item | Description | Price/Unit | Unit | Qty | Total Cost
 | Master's Student | Stipend | 23465 | year | 0.5 | 11732.5

Sheet: Pusher Device
Device: Pusher
 | Component | Technical Spec
 | Nitinol tube (metal sheath) | ID = 1mm = 0.039"
 | Thumb Piece | ID = 5mm
 | Thumb Piece Pusher extrusion | slot >= 1mm | extrusion length = 44.5mm = 1.75"
 | Thumb Piece Length | TBD based on ergonomics testing
 | Thumb Piece OD | TBD based on ergonomics testing
Design Iterations:
 | Version: | Desription: | Revision Notes: | Link:
 | V-2 | Intital - tested on ear cadaver and generally works | - ergonomics - thumb piece too long (1"), OD too thick (0.19" - distance from hole to OD) - size - thumb piece pusher extrusion - sticking out too wide from body of Rosen Needle (0.07") | https://drive.google.com/open?id=0B1QbcJa_MetzNHRONUEwN2RLQkk
 | V-3 | - thumb piece - length = 0.75", distance from hole to OD = 0.07" - - thumb piece pusher extrusion = 0.07" wide, slot = 0.03" wide |  | https://drive.google.com/open?id=0B1QbcJa_MetzbzhoUXVwSGRuSlU
 | V-4 | - thumb piece - length = 0.75", distance from hole to OD = 0.07" - thumb piece pusher extrusion = 0.05" wide, slot = 0.025" wide so the walls are not too thin |  | https://drive.google.com/open?id=0B1QbcJa_MetzZ21FMjZ6OTJYM2M

Sheet: Sheet2
 | Component | Material | Dimensions | Supplier | Supplier P/N | Qty | Cost | Manufacturing Sterility Cert | Assembly Instruction: | Assembly Sterility Cert: | ordered?
Tubing Assembly:
 | Wristed Tip | Nitinol Tube | 1.24mm OD 1.0287 ID long enough to go into handle | Confluent Medical (NDC) https://shop.confluentmedical.com/collections/tube | TSE0490X0405GS (quote) |  |  | obtainable: Confluent medical makes medical- grade NiTi | long shaft, attached to handle via collet stainless steel wire is looped through 2 holes at the top |  | ordered through myfinance - waiting for approval and the order
 |  | laser cutting |  | Pulse |  |  |  |  | sent request for quote to Pulse (Bob Lamson) |  | ordered through Pulse
 | SS wire to actuate wrist | stainless steel | 0.19mm OD = 0.0075" OD | in lab - Sava
 | Niti tubing to reinforce shaft and prevent the tube from slipping in the collet | Nitinol Tube | ID = OD of wrist | Confluent Medical (NDC) |  |  |  |  | Laser welded to the niti wrist
 | collet 1.75 mm ID |  |  | Ebay | see quote: C:\Users\arushri swarup\Documents\Wrist Tool Assembly\Clinical Tool\Components info and quotes | 3 pairs | CAD 32.25 | unknown manufacturer | clamped by the collet thread cap |  | acquired
 | Collet thread cap | stainless steel 316 |  | Metal 3D printed | Protolabs quote |  |  | Protolabs | screws onto the handle body |  | order from Protolabs
 | Handle Body | stainless steel 316 |  | Metal 3D printed | Protolabs quote |  |  | Protolabs | holes with threads for the collet thread cap, ultra low profile screw |  | order from Protolabs
 | Wedge | Ultem1010 |  | 3D printed U of T medstores | see quote: C:\Users\arushri swarup\Documents\Wrist Tool Assembly\Clinical Tool\Components info and quotes |  |  | 3D printed | holes for cable/tube assembly, 4-40 set screw |  | order from Protolabs
 | M2 screw | SS | 12mm length |  |  |  |  |  | attaches wedge to handle |  | ordered through mcmaster carr
 | M2 nut | SS |  |  |  |  |  |  | secures M2 screw |  | ordered through mcmaster carr
 | tube that is clamped in the wedge | SS | OD = 1mm ID = 0.5mm | McMaster Carr | 50415K38 |  |  | ask McMaster Carr | laser welded to the cable end and set screw clamped into the wheel |  | ordered through mcmaster carr
 | set screw for wedge | SS | 4-40 | McMaster Carr |  |  |  | ask McMaster Carr | set screw clamps the cable + tube into place in the wheel
 | luer plus suction tubing | sterilized suction tubing |  | SickKids OR - MED-RX, Standard bore tubing with slide clamp, M/F L.L., REF 10-1044 (see picture below) |  |  |  |  |  |  | In the OR
 | Niti tubing where the laser fibre will enter the tool/where suction tubing will be fed onto it | Nitinol Tube | OD = ID of suction tubing | Confluent Medical (NDC) |  |  |  |  | Laser welded to the niti wrist
to order
to print/make |  | spoke with members of the lab - Thomas, Peter, Kyle, Vito about manufacturing clinical tool - suggested components not be toxic/have coatings and sterilize twice - once before assembly, once after assembly Greg from medical engineering - can probably use set screws, screws from McMaster Carr as they are currently used for surgical instruments that they make/fix Andrew from Baylis - current instruments are made from stainless steel which is compatible for surgical instruments and baylis suture passer uses stainless steel shaft, screw, etc. that are biocompatible (ss is biocompatible) and ensures they are cleaned before being used - i.e. no oils on the surface. Louis Konstant from sterilization said that any stainless steel can be sterilized - send him the sample and then they will test to make sure it is sterilizable
