arushriswarup/Grad-School/Expenses/Expenses 07-Apr-2017.xlsx

Expenses
Date | Item(s) | Amount | Supplier | Bought By | To Be Reimbursed By | Reimbursed? | Receipt
2017-03-10 | White spray pain (Krylon) to spray skull | $6.54 | Canadian Tire | Arushri VISA | CIGITI | with Monica | Canadian Tire Receipt spray paint 10-Mar-2017
2017-03-22 | 4-40 screws, machinable plastic tube | $49.78 | McMaster Carr | Arushri VISA | Dr. James | with Aja | McMaster Carr Receipt 22-Mar-2017
2017-03-28 | Aluminum tube | $6.54 | Home Hardware | Arushri VISA | Dr. James | with Aja | Home Hardware receipts Al tubes Mar-2017
2017-03-30 | Aluminum tube | $6.54 | Home Hardware | Arushri VISA | Dr. James | with Aja
2017-04-07 | 2-56 tap (for the lab) | $26.35 | McMaster Carr | CIGITI | Dr. James |  | RE Receipt for Your April 5th Order with McMaster-Carr
