arushriswarup/Grad-School/Ear Surgery Instruments/superceded/Budget 24-Dec-2015.xlsx

Sheet: Sheet1
 | Item | Description | Price/Unit | Unit | Qty | Price (CAD) Year 1 | Price (CAD) Year 2 | Source |  | Price (USD) Year 1 | Price (USD) Year 2
Instruments
 | Rosen Needle (small) |  | 75.5 | piece | 3 | 226.5 |  | Sick Kids Quotation - Dr Adrian James - Jan 8 2016.pdf |  | 155.89995 |  | 0.6883 | as of 17-Jan-2016 the exchange rate is 0.6883 CAD = 1 USD
 | Rosen Needle (large) |  | 152.6 | piece | 3 | 457.8 |  | Sick Kids Quotation - Dr Adrian James - Jan 8 2016.pdf |  | 315.10374 |  | 1.13 | tax (HST)
 | Panetti - 10-800-12 | Suction dissector for ear drum single curved, left side, 3 mm | 658 | piece | 1 | 658 |  | see email from Dr. James - 07-Jan-2016 catalogue: http://entermedkno.mediastorm.nl/bestanden/380/Panetti%20Suction%20Instruments%20Set.pdf |  | 452.9014
 | Panetti - 10-802-12 | Suction dissector for sinus tympani, double curved, backwards, left side, 6 mm | 658 | piece | 1 | 658 |  |  |  | 452.9014
 | Panetti - 10-850-00 | connector | 472 | piece | 1 | 472 |  |  |  | 324.8776
 | 19 Gauge Suction Cannula |  | 30 | piece | 2 | 90 |  | http://www.mytamed.com/Rosen-Suction-Tubes-p/rosen-suction-tubes.htm |  | 61.947
 | T-Tube Inserter |  | 75 | piece | 1 | 110 |  | http://www.re-owned.com/itemcode-308656320-c3#.Vnytmd-rT-Y |  | 75.713
 | KNIFE MCO5D MICROFRANCE SUCTION RND 2MM |  | 274.5 |  | 1 | 274.5 |  | MF-18652-011516.18N.pdf |  | 188.93835
 | KNIFE MCO5E MICROFRANCE SUCTION RND 3MM |  | 274.5 |  | 1 | 274.5 |  | MF-18652-011516.18N.pdf |  | 188.93835
 | PICK MCO989 180MM CVD MONOPOLAR LEGENT |  | 251.1 |  | 1 | 251.1 |  | MF-18652-011516.18N.pdf |  | 172.83213
 | CABLE CP391 1.8M MONOPOLAR |  | 51.3 |  | 1 | 51.3 |  | MF-18652-011516.18N.pdf |  | 35.30979
Sub-Total + tax |  |  |  |  |  | 3981.781 | 0 |  |  | 2740.659862 | 0
Prototyping Materials:
 | Nitinol Tubing - NDC | Inner diameter > 0.039" | 80 | ft (min 4 ft) | 12 | 1800 | 0 | https://shop.nitinol.com/shop/?slug=index.php&cPath=27 | to be safe, 1800 budget | 1238.94
 | 3D Printing Budget |  | 40 | piece | 20 | 800 | 3000 | Proto3000 - Initial thumb piece slider quote = $65.00 |  | 550.64 | 2500
 | Machining Bits |  |  |  |  | 100 |  |  |  | 68.83
 | Metal Machining |  |  |  |  | 3000 | 7000 |  |  | 2064.9 | 4818.1
Sub-Total + tax |  |  |  |  |  | 6441 | 11300 |  |  | 4433.3403 | 7944.453
Personnel
 | Student Stipend | Inner diameter > 0.039" | 23465 | year | 1 | 23465 | 23465 |  |  | 16150.9595 | 16150.9595
 | Solidworks Course | Inner diameter > 0.039" | 568 | one-time | 1 | 568 |  |  |  | 390.9544
Sub-Total |  |  |  |  |  | 24106.84 | 23465 |  |  | 16592.73797 | 16150.9595
Grand Total |  |  |  |  |  | 34529.621 | 34765 |  |  | 23766.73813 | 24095.4125 | 47862.15063
 |  |  |  | 2339.1

Sheet: Sheet2
Device: Pusher
 | Component | Technical Spec
 | Nitinol tube (metal sheath) | ID = 1mm = 0.039"
 | Thumb Piece | ID = 5mm
 | Thumb Piece Pusher extrusion | slot >= 1mm | extrusion length = 44.5mm = 1.75"
 | Thumb Piece Length | TBD based on ergonomics testing
 | Thumb Piece OD | TBD based on ergonomics testing
