arushriswarup/Grad-School/Funding/Restracomp/Proof of Application to Graduate Program Master’s of Applied Science at Institute of Biomaterials and Biomedical Engineering.docx

Proof of Application to Graduate Program Master’s of Applied Science at Institute of Biomaterials and Biomedical Engineering

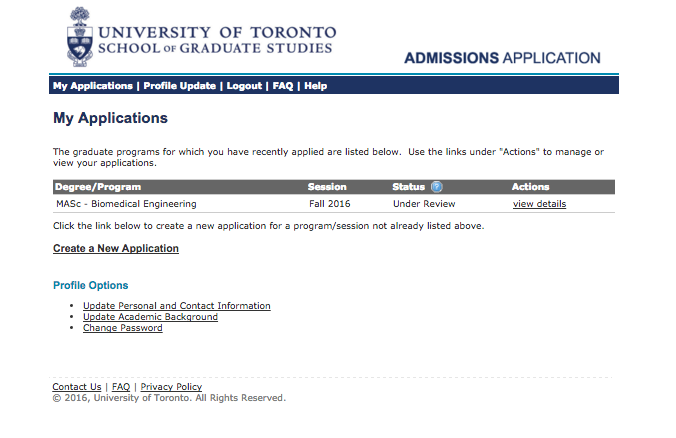
[picture p220: figure]
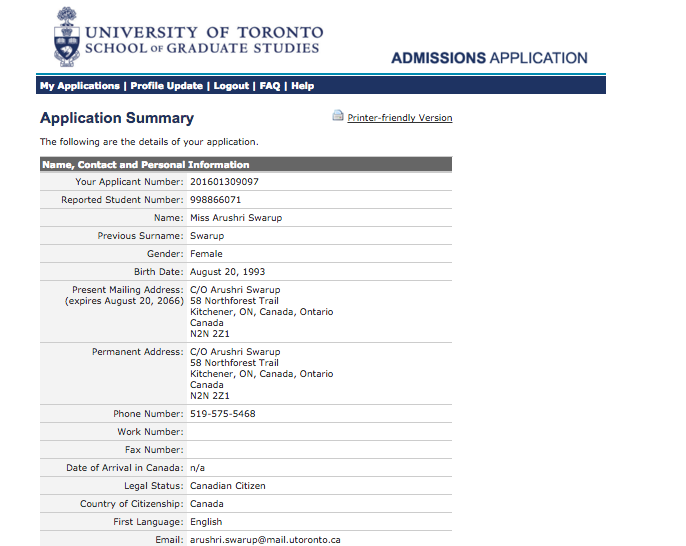
[picture p221: figure]
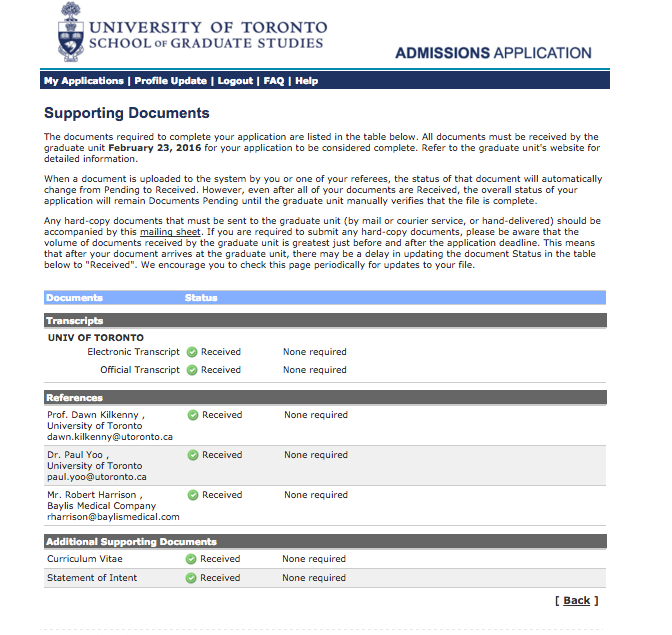
[picture p222: figure]

1 Proof of Application
