arushriswarup/Grad-School/Ear Surgery Instruments/Wrist Tool Assembly/superceded/Clinical Tool/Components info and quotes/NiTi Tube cert.docx

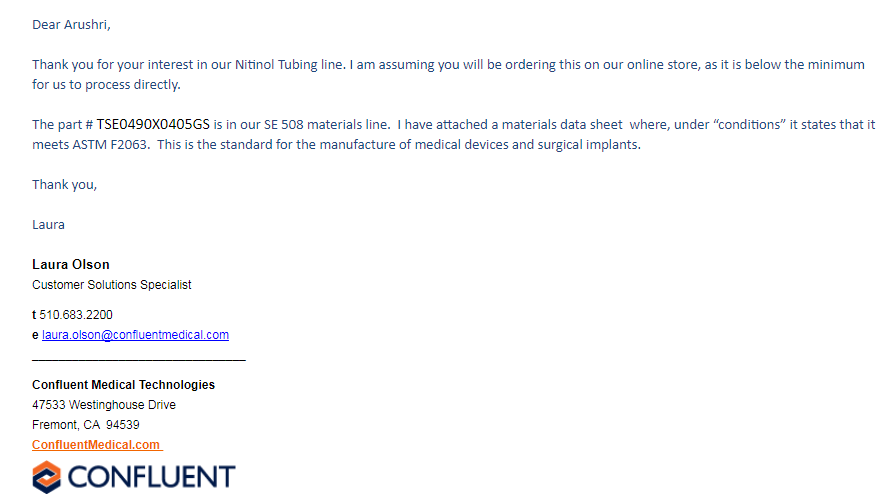
[picture p223: figure]
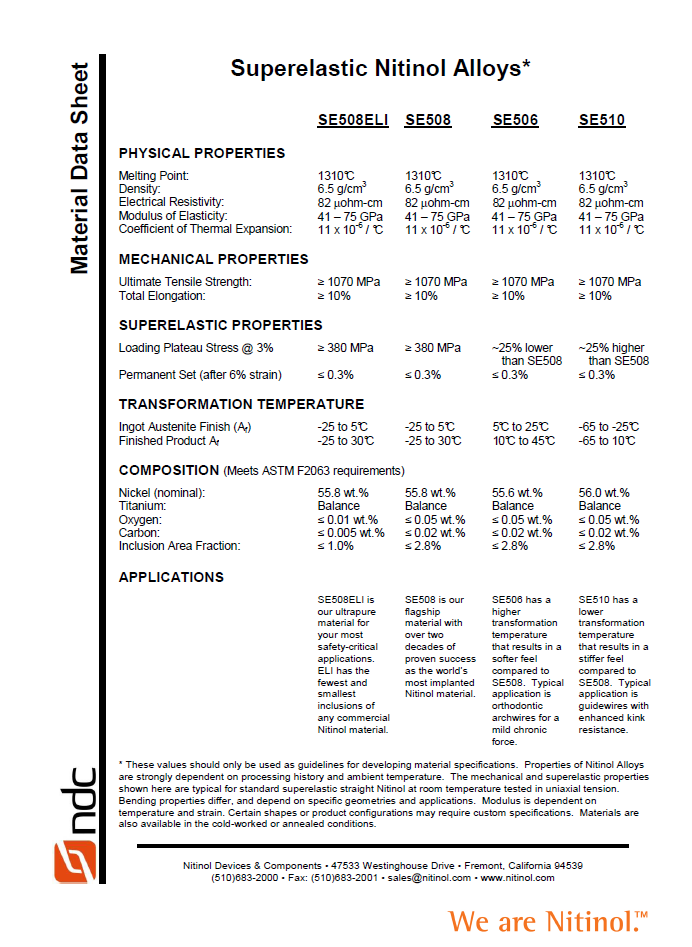
[picture p224: figure]
