arushriswarup/Grad-School/Needs Analysis Survey/superceded/Needs Analysis Survey Results 18-May-2017.xlsx

record_id | redcap_survey_identifier | survey_1_endoscopic_ear_surgery_needs_assessment_timestamp | percent_of_totally_ees | Percent of TEES Surgeries | instrument set | Instrument Set | Bleeding Control | Reaching Structures | Cutting Bone | Keeping the Lens Clean | Positioning a Graft | Dissection and Removal of Cholesteatoma | instruments | survey_1_endoscopic_ear_surgery_needs_assessment_complete
1 |  | 2017-04-03 14:32 | 2 | Up to 50% | 1 | Yes | 76 | 76 | 64 | 77 | 68 | 72 | N/A | 2 | Percent of TEES surgeries: | catergory | count: |  | Instrument Set |  | count:
3 |  | 2017-04-25 08:12 | 2 | Up to 50% | 1 | Yes | 86 | 90 | 61 | 62 | 73 | 65 |  | 2 | 1 | 0% | 0 |  | 1 | Yes | 14
4 |  | 2017-04-26 11:55 | 2 | Up to 50% | 1 | Yes |  |  |  | 7 | 7 |  |  | 2 | 2 | Up to 50% | 8 |  | 2 | No | 2
5 |  | 2017-04-26 11:57 | 2 | Up to 50% | 1 | Yes | 20 | 36 | 51 | 52 | 28 | 26 |  | 2 | 3 | 50%-90% | 5
6 |  | 2017-04-27 09:47 | 2 | Up to 50% | 1 | Yes | 64 | 91 | 69 | 43 | 23 | 92 |  | 2 | 4 | More than 90% | 3
10 |  | 2017-04-28 09:45 | 2 | Up to 50% | 1 | Yes | 19 | 67 | 71 | 33 | 50 | 75 |  | 2
12 |  | 2017-04-28 10:54 | 2 | Up to 50% | 2 | No | 78 | 94 | 71 | 92 | 91 | 86 | Wondering about adapting flexible endoscope with working port to use in ear surgery? | 2
13 |  | 2017-04-29 04:08 | 2 | Up to 50% | 1 | Yes | 50 | 94 | 92 | 5 | 5 | 96 | There is a need for an instrument to reach disease in the mastoid through the canal, keeping the instrument size the same as they are now; may be look at a retractible instrument? | 2
2 |  | 2017-04-21 17:46 | 3 | 50%-90% | 1 | Yes | 53 | 83 | 62 | 72 | 93 | 100 |  | 2
7 |  | 2017-04-27 10:57 | 3 | 50%-90% | 1 | Yes | 83 | 93 | 69 |  | 57 | 69 | Suction elevators, should be able to control the amount of suction | 2 |  | Results:
8 |  | 2017-04-27 13:23 | 3 | 50%-90% | 1 | Yes | 58 | 40 | 70 | 67 | 56 | 41 |  | 2 |  | no sig difference between TEES percentage and any of the difficulties - when alpha = 10% and 5%
11 |  | 2017-04-28 10:00 | 3 | 50%-90% | 2 | No | 24 | 98 | 77 | 41 | 69 | 84 | Angled shaft instruments to keep hands from bumping into each other | 2
15 |  | 2017-05-01 13:21 | 3 | 50%-90% | 1 | Yes |  | 85 |  | 35 | 36 | 81 |  | 2
9 |  | 2017-04-28 09:44 | 4 | More than 90% | 1 | Yes | 99 | 100 | 100 | 100 | 99 | 100 |  | 2
14 |  | 2017-04-29 18:12 | 4 | More than 90% | 1 | Yes | 64 | 90 | 99 | 76 | 50 | 90 | EES bipolar with suction. Endo pen is too wide. Bayonet bipolars do not open. | 2
16 |  | 2017-05-06 12:55 | 4 | More than 90% | 1 | Yes | 92 | 99 | 61 | 87 | 83 | 92 | Disposable curved and angled suckers. With the current multiuse suction devices, our sterile services department refuse to clean them due to the very narrow lumen. Therefore cost-effective disposable instruments would be great. | 2
 |  |  | 2 | Up to 50% | 1 | Yes | 95 | 89 | 50 | 95 | 50 | 50 |  | 2
 |  |  | 1 | 0 | 2 | No | 50 | 50 | 50 | 50 | 50 | 50 |  | 2
 |  |  | 1 | 0 | 2 | No | 8 | 86 | 52 | 11 | 49 | 51 |  | 2
 |  |  | 3 | 50%-90% | 1 | Yes | 50 | 100 | 50 | 50 | 0 | 100 | More specialised instruments for coagulations. - More specialised instruments for single handed drilling means drilling irrigation and suction in the same time. |  |  |  | endoscope | instrument
 |  |  | 2 | Up to 50% | 1 | Yes | 100 | 100 | 100 | 100 | 69 | 81 |  |  |  |  | flexible | retractible
 |  |  | 3 | 50%-90% | 1 | Yes | 68 | 88 | 41 | 10 | 49 | 91 |  |  |  |  |  | suction elevators to control amount of suction
mean |  |  |  |  |  |  | 61.85 | 83.28571429 | 68 | 55.47619048 | 52.5 | 75.80952381 |  |  |  |  |  | angled shaft
std dev |  |  |  |  |  |  | 27.92522911 | 19.20453815 | 17.89736823 | 31.21957567 | 27.88368699 | 21.40471688 |  |  |  |  |  | bipolar with suction
std error |  |  |  |  |  |  | 5.953678851 | 4.094421292 | 3.815731727 | 6.656035896 | 5.94482204 | 4.563500972 |  |  |  |  |  | disposable curved and angled suckers
 |  |  |  |  |  |  |  |  |  |  |  |  |  |  |  |  |  | coagulations
 |  |  |  |  |  |  |  |  |  |  |  |  |  |  |  |  |  | single handed drilling - irrigation and suction at the same time
