arushriswarup/Grad-School/Needs Analysis Survey/superceded/Needs Analysis Survey Results 22-Jul-2017.xlsx

record_id | redcap_survey_identifier | survey_1_endoscopic_ear_surgery_needs_assessment_timestamp | percent_of_totally_ees | Percent of TEES Surgeries | instrument set | Instrument Set | Bleeding Control | Reaching Structures | Cutting Bone | Keeping the Lens Clean | Positioning a Graft | Dissection and Removal of Cholesteatoma | instruments | survey_1_endoscopic_ear_surgery_needs_assessment_complete
1 |  | 2017-04-03 14:32 | 2 | Up to 50% | 1 | Yes | 76 | 76 | 64 | 77 | 68 | 72 | N/A | 2 | Percent of TEES surgeries: | catergory | count: |  | Instrument Set |  | count:
3 |  | 2017-04-25 08:12 | 2 | Up to 50% | 1 | Yes | 86 | 90 | 61 | 62 | 73 | 65 |  | 2 | 1 | 0% | 0 |  | 1 | Yes | 14
4 |  | 2017-04-26 11:55 | 2 | Up to 50% | 1 | Yes | 50 | 50 | 50 | 7 | 7 | 50 |  | 2 | 2 | Up to 50% | 8 |  | 2 | No | 2
5 |  | 2017-04-26 11:57 | 2 | Up to 50% | 1 | Yes | 20 | 36 | 51 | 52 | 28 | 26 |  | 2 | 3 | 50%-90% | 5
6 |  | 2017-04-27 09:47 | 2 | Up to 50% | 1 | Yes | 64 | 91 | 69 | 43 | 23 | 92 |  | 2 | 4 | More than 90% | 3
10 |  | 2017-04-28 09:45 | 2 | Up to 50% | 1 | Yes | 19 | 67 | 71 | 33 | 50 | 75 |  | 2
12 |  | 2017-04-28 10:54 | 2 | Up to 50% | 2 | No | 78 | 94 | 71 | 92 | 91 | 86 | Wondering about adapting flexible endoscope with working port to use in ear surgery? | 2
13 |  | 2017-04-29 04:08 | 2 | Up to 50% | 1 | Yes | 50 | 94 | 92 | 5 | 5 | 96 | There is a need for an instrument to reach disease in the mastoid through the canal, keeping the instrument size the same as they are now; may be look at a retractible instrument? | 2
2 |  | 2017-04-21 17:46 | 3 | 50%-90% | 1 | Yes | 53 | 83 | 62 | 72 | 93 | 100 |  | 2
7 |  | 2017-04-27 10:57 | 3 | 50%-90% | 1 | Yes | 83 | 93 | 69 | 50 | 57 | 69 | Suction elevators, should be able to control the amount of suction | 2 |  | Results:
8 |  | 2017-04-27 13:23 | 3 | 50%-90% | 1 | Yes | 58 | 40 | 70 | 67 | 56 | 41 |  | 2 |  | no sig difference between TEES percentage and any of the difficulties - when alpha = 10% and 5%
11 |  | 2017-04-28 10:00 | 3 | 50%-90% | 2 | No | 24 | 98 | 77 | 41 | 69 | 84 | Angled shaft instruments to keep hands from bumping into each other | 2
15 |  | 2017-05-01 13:21 | 3 | 50%-90% | 1 | Yes | 50 | 85 | 50 | 35 | 36 | 81 |  | 2
9 |  | 2017-04-28 09:44 | 4 | More than 90% | 1 | Yes | 99 | 100 | 100 | 100 | 99 | 100 |  | 2
14 |  | 2017-04-29 18:12 | 4 | More than 90% | 1 | Yes | 64 | 90 | 99 | 76 | 50 | 90 | EES bipolar with suction. Endo pen is too wide. Bayonet bipolars do not open. | 2
16 |  | 2017-05-06 12:55 | 4 | More than 90% | 1 | Yes | 92 | 99 | 61 | 87 | 83 | 92 | Disposable curved and angled suckers. With the current multiuse suction devices, our sterile services department refuse to clean them due to the very narrow lumen. Therefore cost-effective disposable instruments would be great. | 2
17 |  |  | 2 | Up to 50% | 1 | Yes | 95 | 89 | 50 | 95 | 50 | 50 |  | 2
18 |  |  | 1 | 0 | 2 | No | 50 | 50 | 50 | 50 | 50 | 50 |  | 2
19 |  |  | 1 | 0 | 2 | No | 8 | 86 | 52 | 11 | 49 | 51 |  | 2
20 |  |  | 3 | 50%-90% | 1 | Yes | 50 | 100 | 50 | 50 | 0 | 100 | More specialised instruments for coagulations. - More specialised instruments for single handed drilling means drilling irrigation and suction in the same time. |  |  |  | endoscope | instrument
21 |  |  | 2 | Up to 50% | 1 | Yes | 100 | 100 | 100 | 100 | 69 | 81 |  |  |  |  | flexible | retractible
22 |  |  | 3 | 50%-90% | 1 | Yes | 68 | 88 | 41 | 10 | 49 | 91 |  |  |  |  |  | suction elevators to control amount of suction
23 |  |  | 3 | 50%-90% | 1 | Yes | 84 | 100 | 52 | 89 | 50 | 65 | Endoscope holder that can be possible two hand surgery when necessary
24 |  |  | 3 | 50%-90% | 1 | Yes | 50 | 94 | 86 | 90 | 84 | 93
25 |  |  | 4 | More than 90% | 2 | No | 96 | 91 | 49 | 95 | 96 | 67
26 |  |  | 4 | More than 90% | 2 | No | 30 | 99 | 99 | 51 | 100 | 100
27 |  |  | 2 | Up to 50% | 1 | Yes | 50 | 50 | 100 | 100 | 50 | 100 | Combined suction and blunt dissectors.
28 |  |  | 4 | More than 90% | 1 | Yes | 48 | 98 | 5 | 50 | 98 | 98
29 |  |  | 2 | Up to 50% | 1 | Yes | 79 | 49 | 57 | 4 | 5 | 71 | =- cleansing lens continuously - feasible holder* *assuming endoscope holder
30 |  |  | 3 | 50%-90% | 2 | No | 58 | 84 | 86 | 63 | 57 | 67 | Curved suctions Bone cutting such as piezoelectric
31 |  |  | 2 | Up to 50% | 1 | Yes | 37 | 41 | 57 | 29 | 28 | 61
32 |  |  | 4 | More than 90% | 1 | Yes | 97 | 66 | 15 | 68 | 28 | 75 | =- instruments bended and longer to reach easily supratubal recess or deep sinus tympani - curved ronded Knife for better incision of the skin in the first step of any Middle Ear Surgery
33 |  |  | 2 | Up to 50% | 2 | No | 50 | 64 | 66 | 58 | 82 | 64
34 |  |  | 1 | 0 | 1 | Yes | 92 | 92 | 50 | 90 | 50 | 90 | Instruments with working angles that can be adjusted.
35 |  | 2017-07-22 16:38 | 4 | More than 90% | 1 | Yes | 98 | 99 | 85 | 77 | 99 | 53 | suctions with differet angles to facilitate suction of cholesteatomatous matrix at differet sites and a tool for dissection and suction at the same time | 2
36 |  | 2017-07-22 18:00 | 3 | 50%-90% | 1 | Yes | 70 | 100 | 100 | 68 | 68 | 100 |  | 2
37 |  | 2017-07-22 18:30 | 3 | 50%-90% | 1 | Yes | 100 | 100 | 76 | 78 | 79 | 78 |  | 2
38 |  | 2017-07-22 18:33 | 3 | 50%-90% | 2 | No | 50 | 50 | 89 | 96 | 50 | 98 |  | 2
39 |  | 2017-07-23 07:19 | 3 | 50%-90% | 1 | Yes | 100 | 100 | 100 | 49 | 51 | 100 | Overall, I feel that the most frustrating aspect is not being able to reach structures and disease that you can see with the endoscope with currently available instruments. | 2
40 |  | 2017-07-23 08:19 | 3 | 50%-90% | 1 | Yes | 62 | 91 | 61 | 92 | 50 | 96 | At this time in my level of experience, what I would need the most is to have improved curved suctions that are able to reach and aspirate cholesteatoma matrix from difficult areas such as attic and sinus tympani. The Storz curved suctions I have in my set are too flimsy, too thin and too long. A device to suction smoke during laser surgery mounted on the laser tip or separate would be very useful. In regards of cutting bone, I have found the piezoelectric drill quite useful. In regards of bleeding control, I feel that with experience and optimal injection I can manage with intermittently suctioning the field and placing cotton balls. In regards of graft positioning, I manage well with traditional middle ear instruments. | 2
41 |  | 2017-07-23 09:18 | 2 | Up to 50% | 2 | No | 72 | 96 | 50 | 51 | 53 | 100 |  | 2
42 |  | 2017-07-23 09:20 | 3 | 50%-90% | 1 | Yes | 71 | 100 | 73 | 100 | 86 | 100 |  | 2
43 |  | 2017-07-23 22:32 | 3 | 50%-90% | 1 | Yes | 100 | 86 | 76 | 69 | 60 | 67 | A drill that can remove bone without obscuring vision. An instrument that can remove vascular lesions without causing bleeding! | 2
44 |  | 2017-07-24 03:49 | 1 | 0 | 1 | Yes | 53 | 75 | 51 | 50 | 49 | 47 | The flexible joint made by stors to fix endoscope allowing biannual work is useful. However it is thick, I think it need to be thinned out. | 2
45 |  | 2017-07-24 05:11 | 3 | 50%-90% | 1 | Yes | 50 | 100 | 50 | 0 | 100 | 100 |  | 2
mean |  |  |  |  |  |  | 65.2 | 82.75555556 | 66.51111111 | 60.71111111 | 58.4 | 78.48888889
std dev |  |  |  |  |  |  | 24.8784317 | 19.80375946 | 21.92406546 | 29.54243652 | 27.34659693 | 19.98820359
std error |  |  |  |  |  |  | 5.304099459 | 4.222175704 | 4.674226462 | 6.298468629 | 5.830314055 | 4.261499324
