arushriswarup/Grad-School/Ear Surgery Instruments/Wrist Tool Assembly/Clinical Tool/Components info and quotes/McMaster Carr order clinical components Feb 2018.jpg

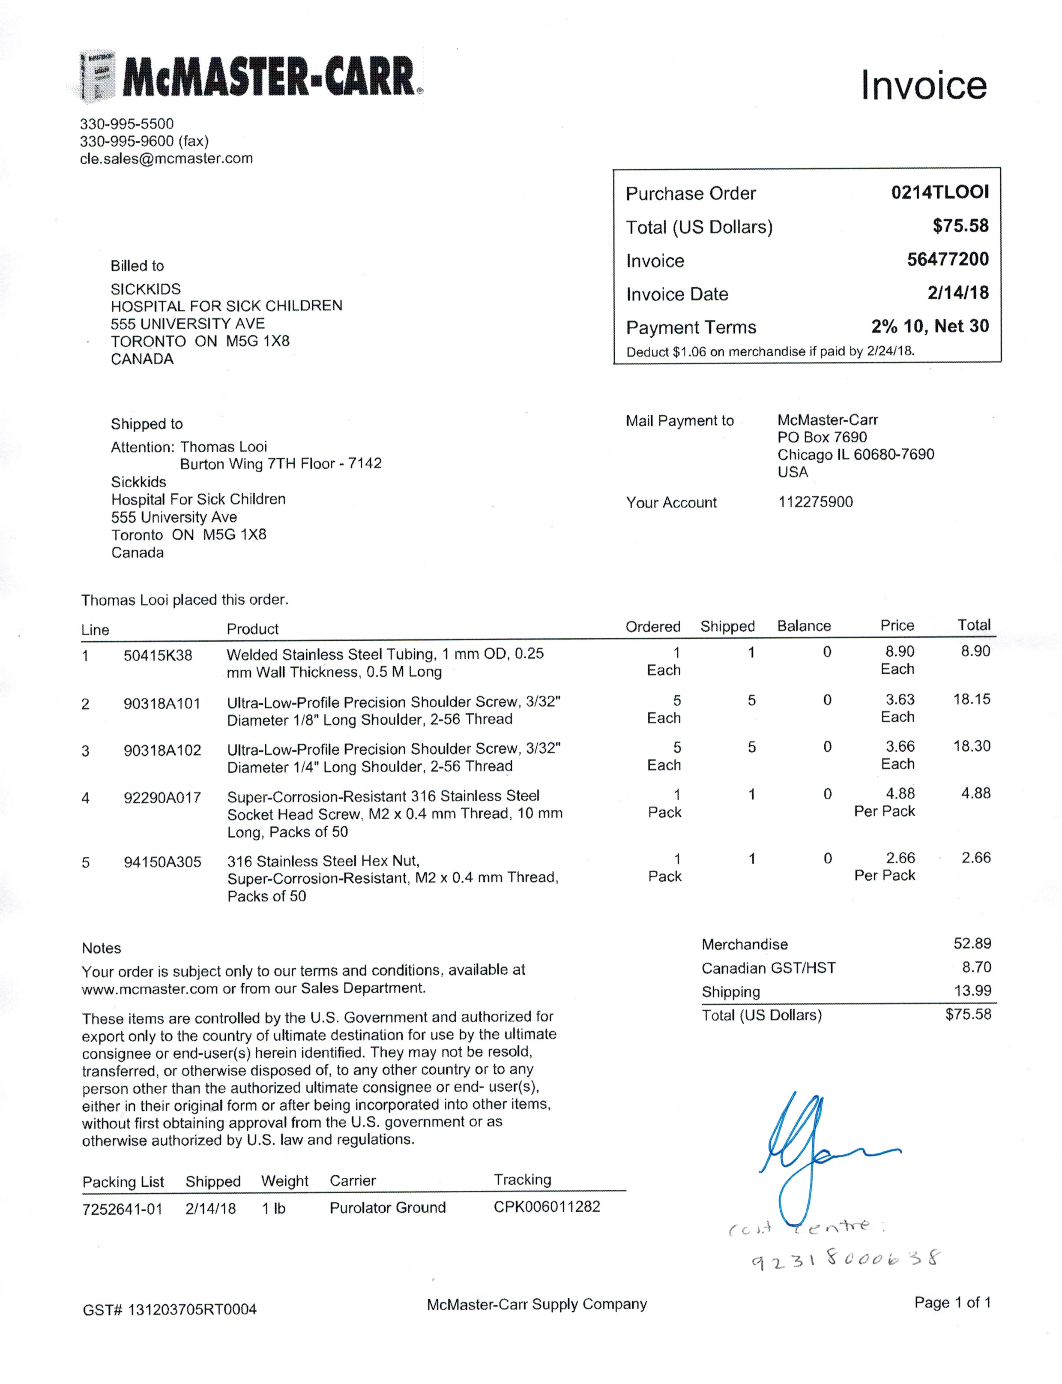
Ear Surgery Instruments/Wrist Tool Assembly/Clinical Tool/Components info and quotes/McMaster Carr order clinical components Feb 2018.jpg
