arushriswarup/Grad-School/Ear Surgery Instruments/Wrist Tool Assembly/New Handle Dec-2017/cable + square joint_curve 2 assem.SLDASM

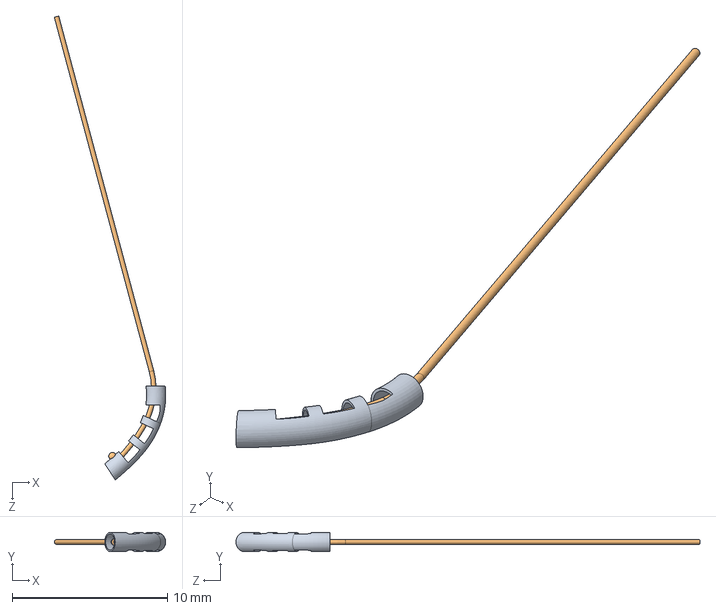
[picture p226: CAD file, 2018-02-12]
Ear Surgery Instruments/Wrist Tool Assembly/New Handle Dec-2017/cable + square joint_curve 2 assem.SLDASM
7.17 x 1.24 x 29.8 mm
Arushri_Tube_SquareJoint_curve 2
cable_curve2
