arushriswarup/Grad-School/Ear Surgery Instruments/Wrist Tool Assembly/superceded/print 15-Nov-2017/wedge v-6 15-Nov-2017_5mm 270deg.SLDASM

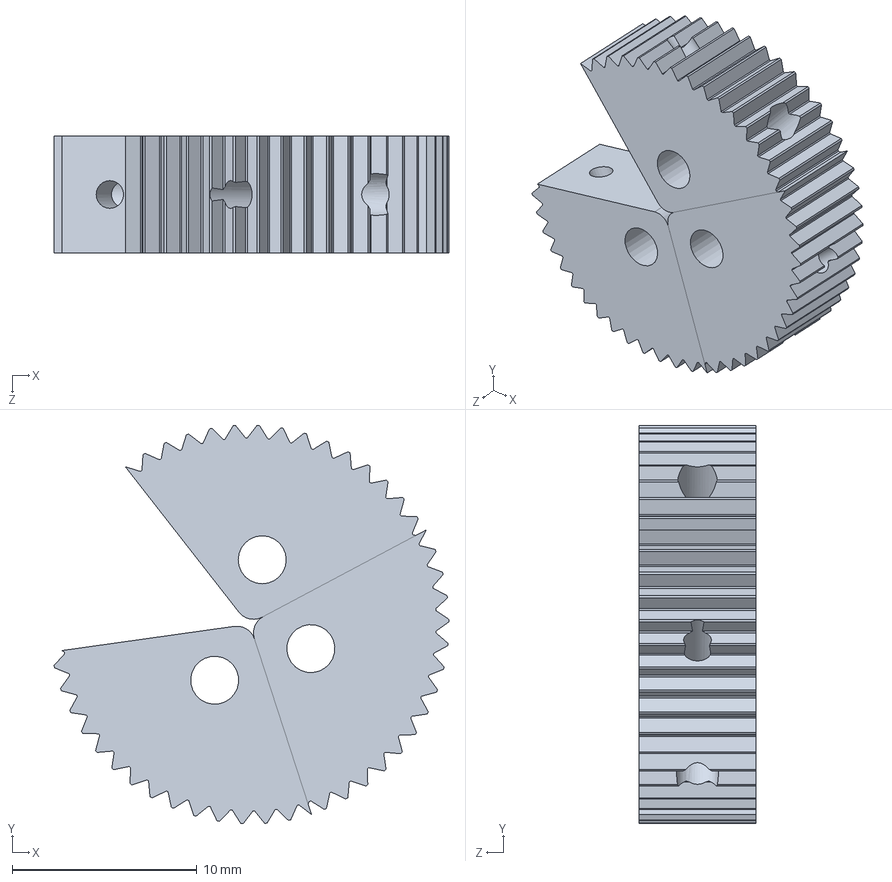
[picture p227: CAD file, 2018-02-12]
Ear Surgery Instruments/Wrist Tool Assembly/superceded/print 15-Nov-2017/wedge v-6 15-Nov-2017_5mm 270deg.SLDASM
21.4 x 21.6 x 6.35 mm
wedge v-5 14-Sep-2017_5mm x 3
