arushriswarup/Grad-School/Ear Surgery Instruments/Wrist Tool Assembly/superceded/print 22-Nov-2017/slider handle assembly v-5 22-Nov-2017.STL

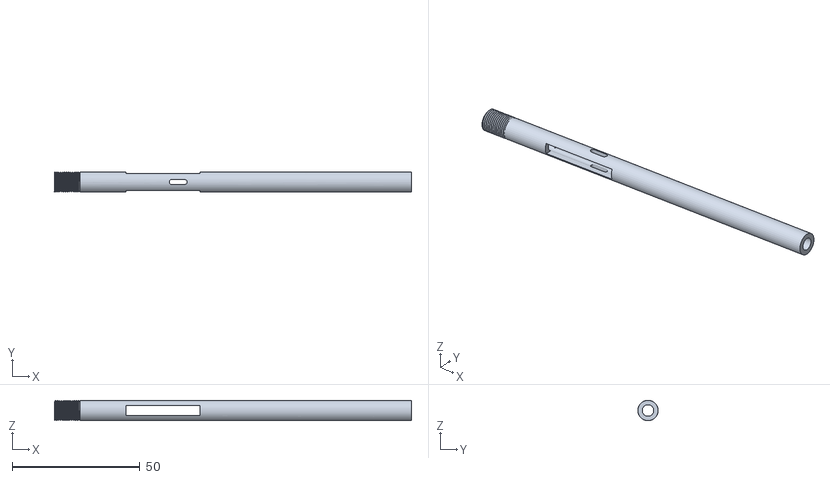
[picture p228: CAD file, 2018-02-12]
Ear Surgery Instruments/Wrist Tool Assembly/superceded/print 22-Nov-2017/slider handle assembly v-5 22-Nov-2017.STL
140.0 x 8.00 x 8.00
