arushriswarup/Grad-School/Ear Surgery Instruments/Wrist Tool Assembly/superceded/slider print 08-Nov-2017/slider assembly v-4 06-Nov-2017.STL

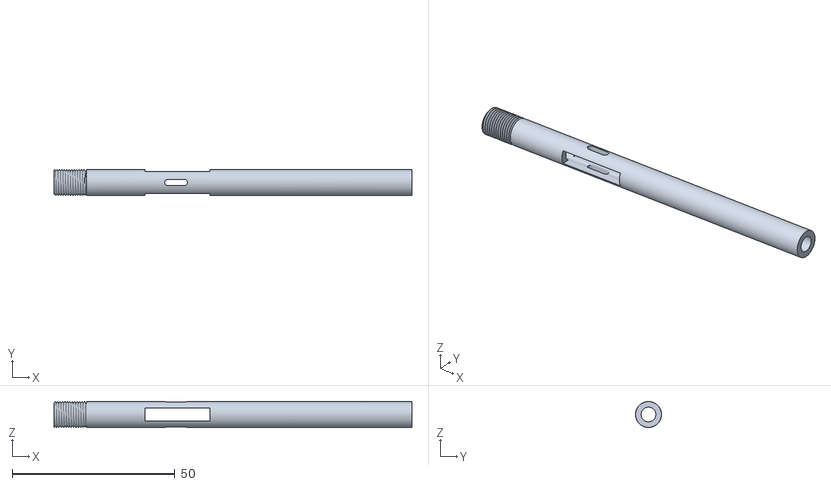
[picture p229: CAD file, 2018-02-12]
Ear Surgery Instruments/Wrist Tool Assembly/superceded/slider print 08-Nov-2017/slider assembly v-4 06-Nov-2017.STL
110.0 x 8.00 x 8.00
