arushriswarup/Grad-School/Hamlyn/CAD/ham1.SLDASM

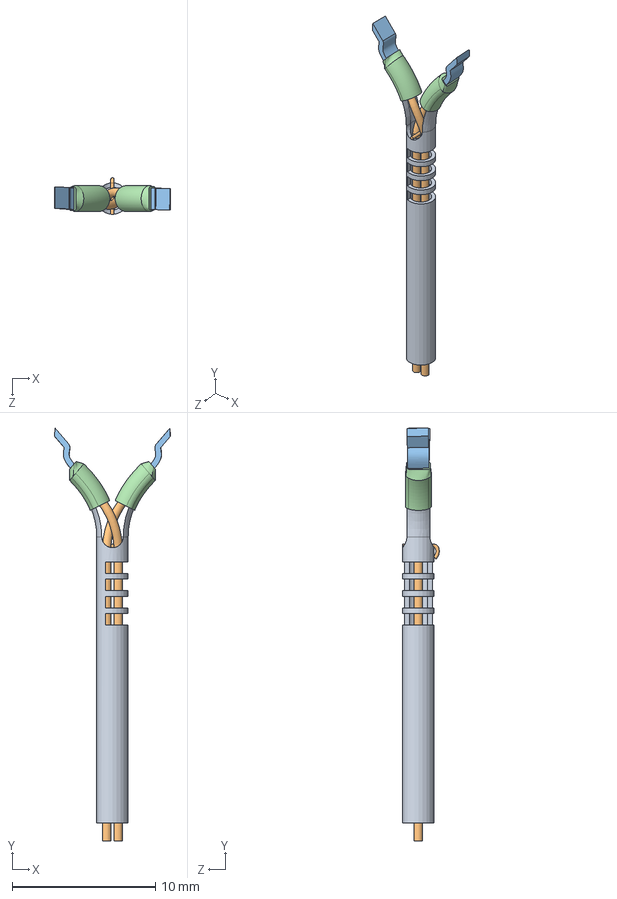
[picture p230: CAD file, 2017-11-13]
Hamlyn/CAD/ham1.SLDASM
8.12 x 28.9 x 2.56 mm
tube
tip_small_v2 x 2
heat_shrink x 2
