arushriswarup/Grad-School/Ear Surgery Instruments/Wrist Tool Assembly/New Handle Dec-2017/cable + square joint_curve 3 assem.SLDASM

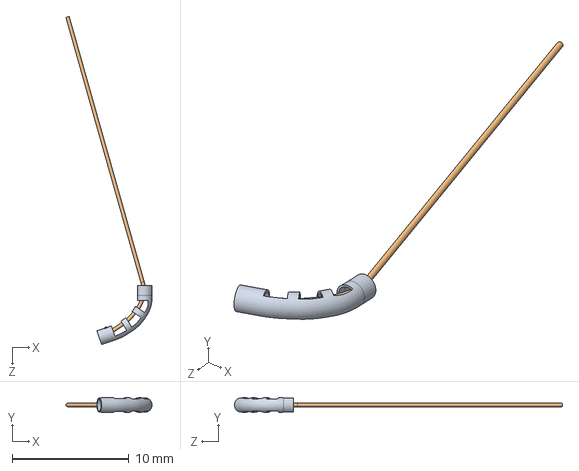
[picture p231: CAD file, 2018-02-12]
Ear Surgery Instruments/Wrist Tool Assembly/New Handle Dec-2017/cable + square joint_curve 3 assem.SLDASM
7.39 x 1.24 x 28.1 mm
Arushri_Tube_SquareJoint_curve 3
cable_curve3
