arushriswarup/Grad-School/3D Models/Virtual Model V-1 08-Mar-2017.SLDASM

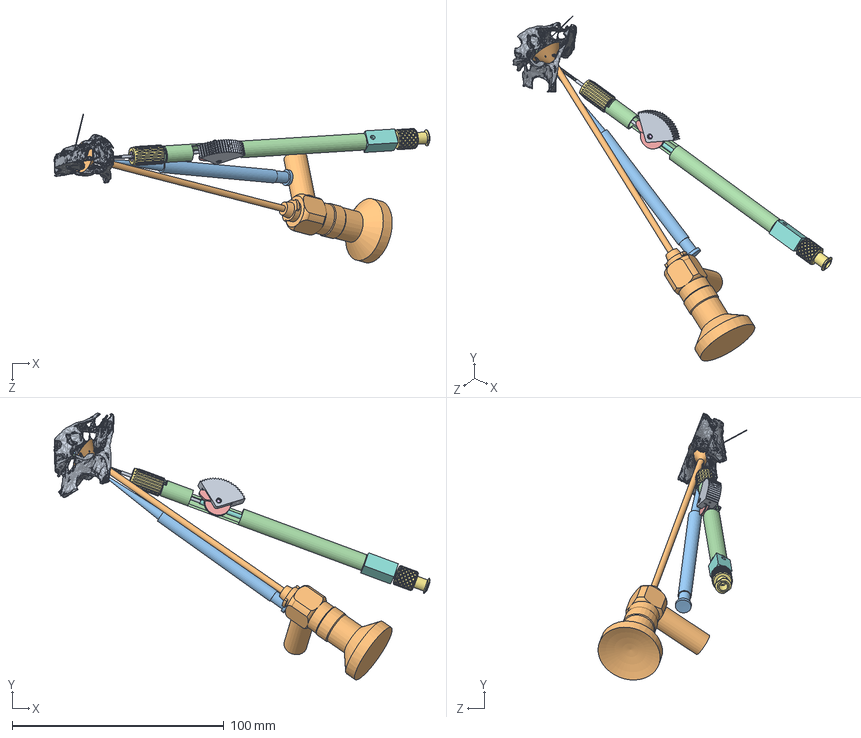
[picture p232: CAD file, 2017-11-13]
3D Models/Virtual Model V-1 08-Mar-2017.SLDASM
177.5 x 126.0 x 70.2 mm
temporal bone axial crop_4_reduced
endoscope
Panetti left
