arushriswarup/Grad-School/Ear Surgery Instruments/Wrist Tool Assembly/superceded/assem_handle_ent V-4 13-Apr-2017.SLDASM

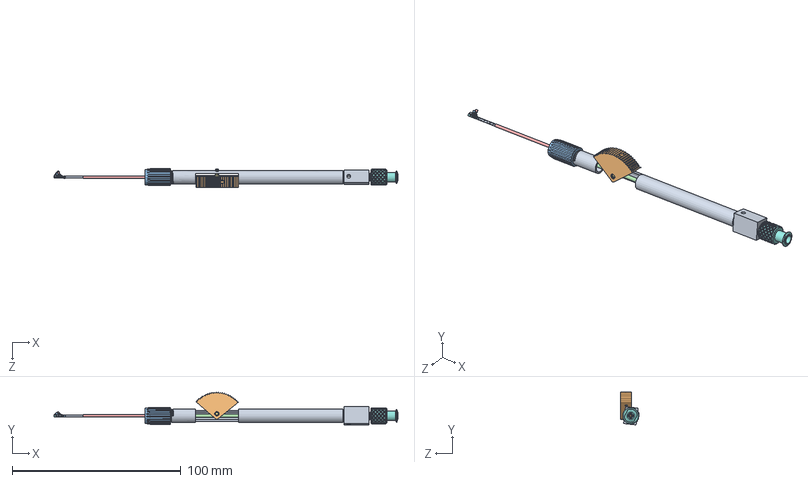
[picture p233: CAD file, 2017-11-13]
Ear Surgery Instruments/Wrist Tool Assembly/superceded/assem_handle_ent V-4 13-Apr-2017.SLDASM
203.7 x 19.5 x 11.0 mm
wheel_handle_body v-3 18-Jan-2017
Collet_1_75mmID
V06_Collet_ThreadCap
tube without cable 8988K35
stainless steel tube 5560K43
wire exit path v-3 29-Aug-2017
Arushri_Tube_SquareJoint_curve 1
cable_curve1
Arushri_Tube_SquareJoint_curve 2
cable_curve2
Arushri_Tube_SquareJoint_curve 3
cable_curve3
90318A102_ULTRA LOW PROFILE TYPE 316 SS SHOULDER SCREW
51465K161_HIGH-STRENGTH QUICK-TURN TUBE COUPLING
tubing to luer coupler v-2 21-Sep-2017
wedge v-4 01-Aug-2017_5mm
