arushriswarup/Grad-School/Ear Surgery Instruments/Wrist Tool Assembly/superceded/Clinical Tool/superceded/handle assembly - handle threads-1.STL

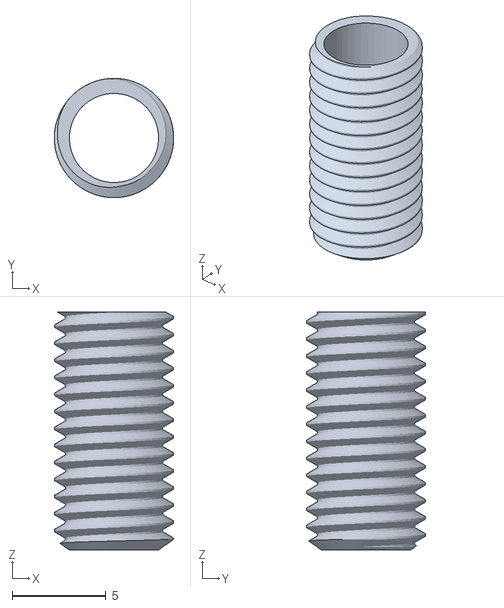
[picture p234: CAD file, 2018-02-06]
Ear Surgery Instruments/Wrist Tool Assembly/superceded/Clinical Tool/superceded/handle assembly - handle threads-1.STL
6.35 x 6.35 x 12.7
