arushriswarup/Grad-School/Ear Surgery Instruments/Wrist Tool Assembly/tubing assembly.SLDASM

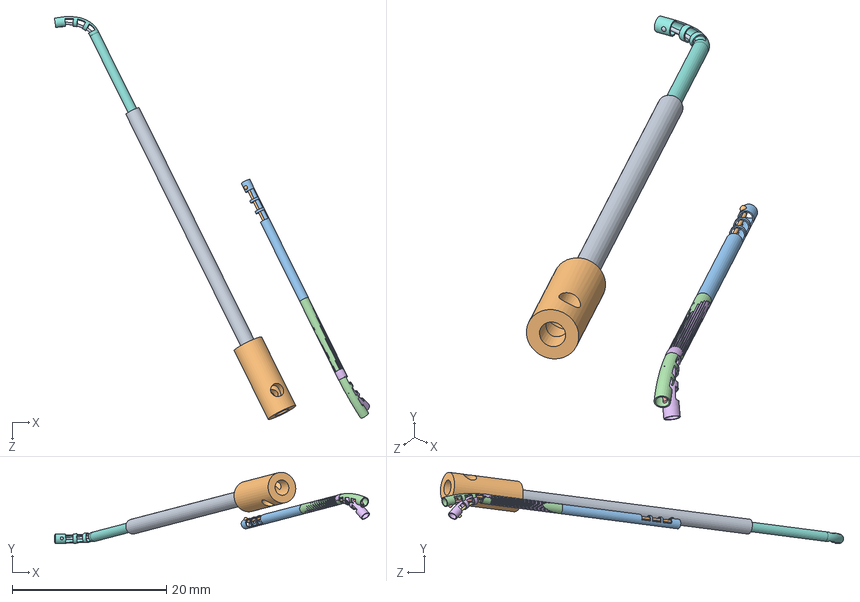
[picture p235: CAD file, 2018-02-12]
Ear Surgery Instruments/Wrist Tool Assembly/tubing assembly.SLDASM
40.8 x 9.25 x 52.2 mm
Nitinol shaft
Arushri_Tube_SquareJoint_curve 3
cable_curve3
handle shaft connector
