arushriswarup/Grad-School/Ear Surgery Instruments/Wrist Tool Assembly/Clinical Tool/Clinical Tool Assembly.SLDASM

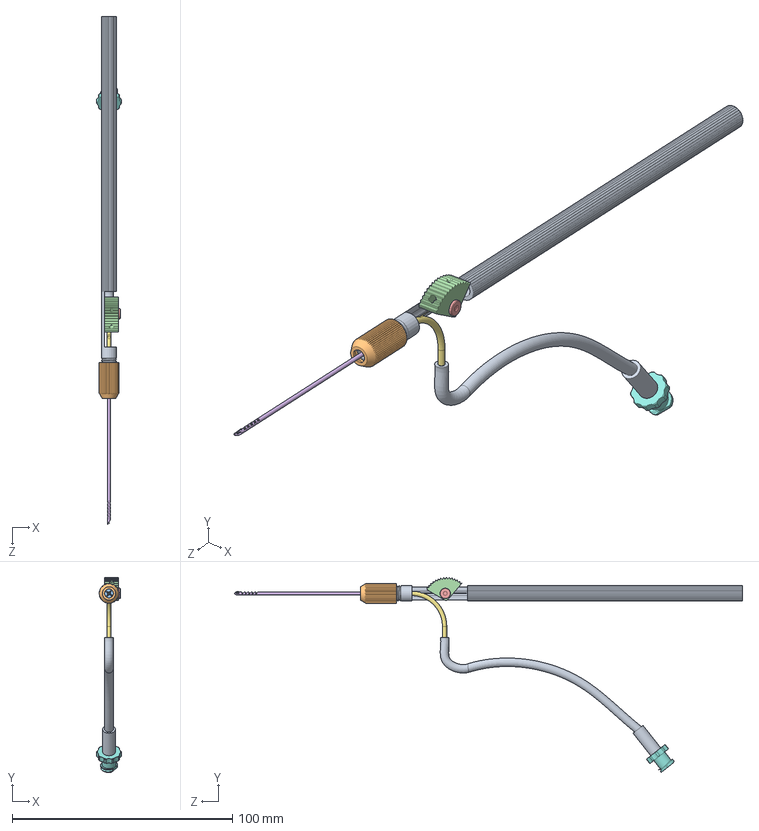
[picture p236: CAD file, 2018-02-27]
Ear Surgery Instruments/Wrist Tool Assembly/Clinical Tool/Clinical Tool Assembly.SLDASM
11.2 x 88.6 x 230.7 mm
Handle M7 threads
90591A154 M7 collet clamp
collet
wedge v-5 14-Sep-2017_5mm_stainless steel
90318A101_ULTRA LOW PROFILE TYPE 316 SS SHOULDER SCREW
135deg CCM V-1 Wrist left
laser suction exit tube
51525K315_LIGHTWEIGHT QUICK-TURN TUBE COUPLING
suction tube
