arushriswarup/Grad-School/Ear Surgery Instruments/Wrist Tool Assembly/superceded/Clinical Tool/superceded/handle assembly.SLDASM

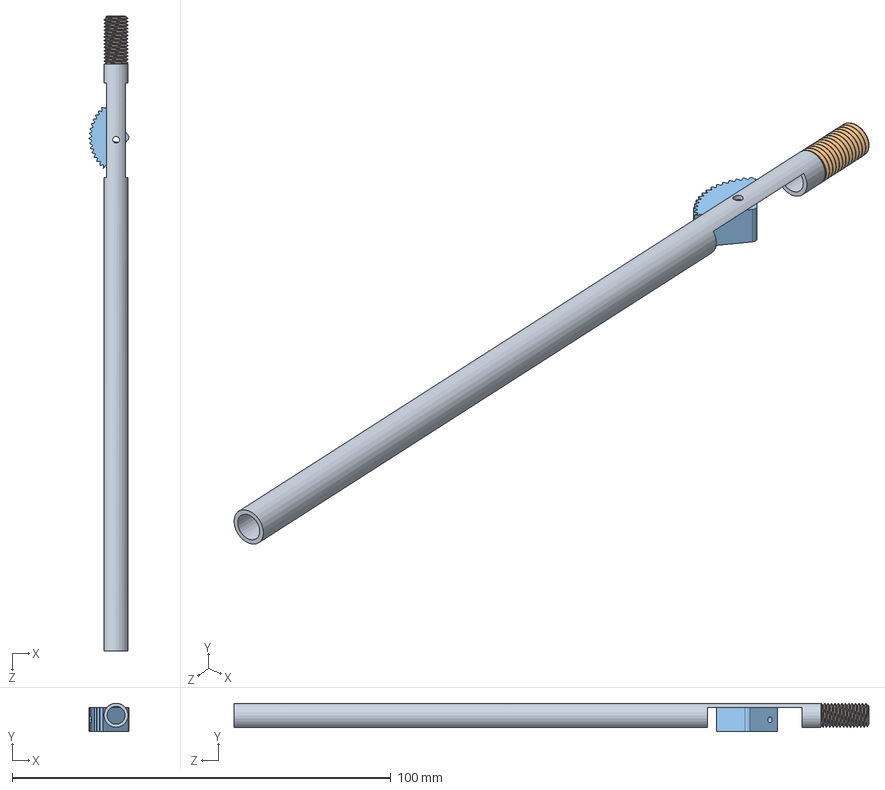
[picture p237: CAD file, 2018-02-06]
Ear Surgery Instruments/Wrist Tool Assembly/superceded/Clinical Tool/superceded/handle assembly.SLDASM
10.5 x 7.53 x 167.7 mm
handle
handle threads
wedge v-5 14-Sep-2017_5mm
