arushriswarup/Grad-School/Hamlyn/CAD_for_pin_joint/pin joint assembly.SLDASM

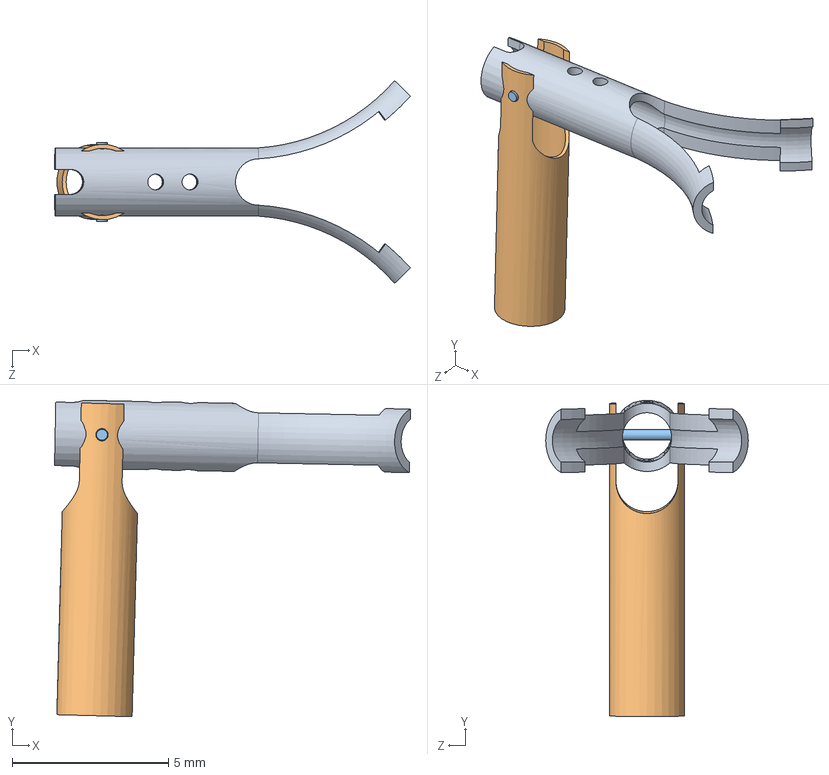
[picture p238: CAD file, 2017-11-13]
Hamlyn/CAD_for_pin_joint/pin joint assembly.SLDASM
11.4 x 10.1 x 6.49 mm
tube
stainless steel tube_pin joint
pin
