arushriswarup/Grad-School/Hamlyn/CAD/pin joint assembly.SLDASM

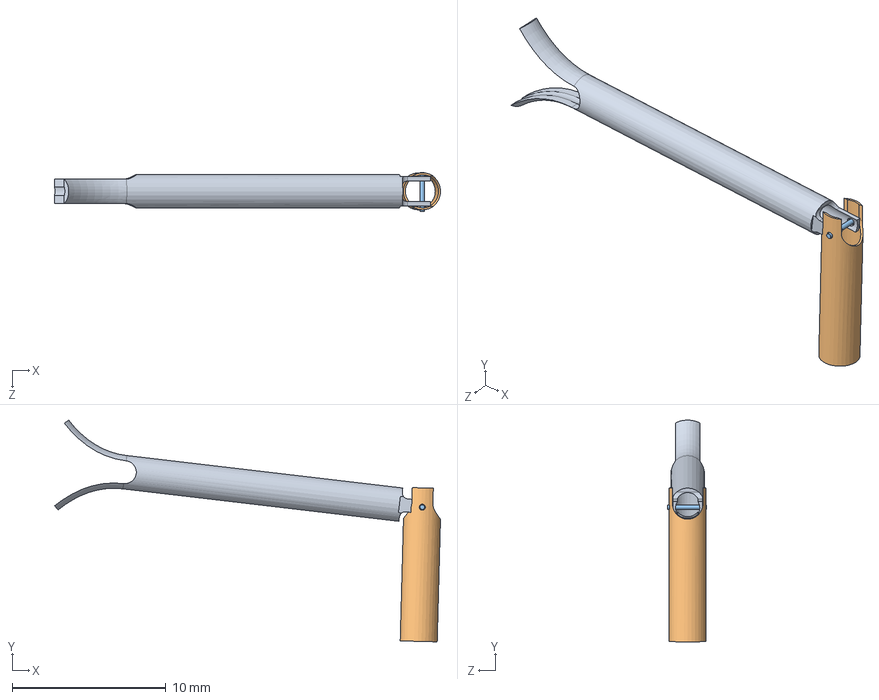
[picture p240: CAD file, 2017-11-13]
Hamlyn/CAD/pin joint assembly.SLDASM
25.1 x 14.4 x 2.54 mm
tube
stainless steel tube_pin joint
pin
