arushriswarup/Grad-School/Ear Surgery Instruments/ear drum instruments/ear drum tool.SLDASM

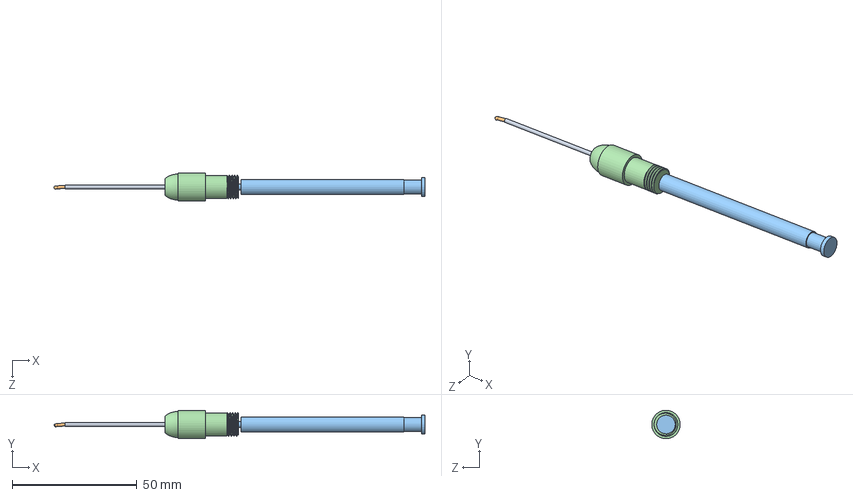
[picture p241: CAD file, 2017-11-13]
Ear Surgery Instruments/ear drum instruments/ear drum tool.SLDASM
148.7 x 11.4 x 11.4 mm
stainless steel tube 5560K43
ear drum tool tip 1.16mm
Panetti body_modified
Collet amazon 0.5-3mm
