arushriswarup/Grad-School/Ear Surgery Instruments/Wrist Tool Assembly/superceded/Clinical Tool/Clinical Tool Assembly.SLDASM

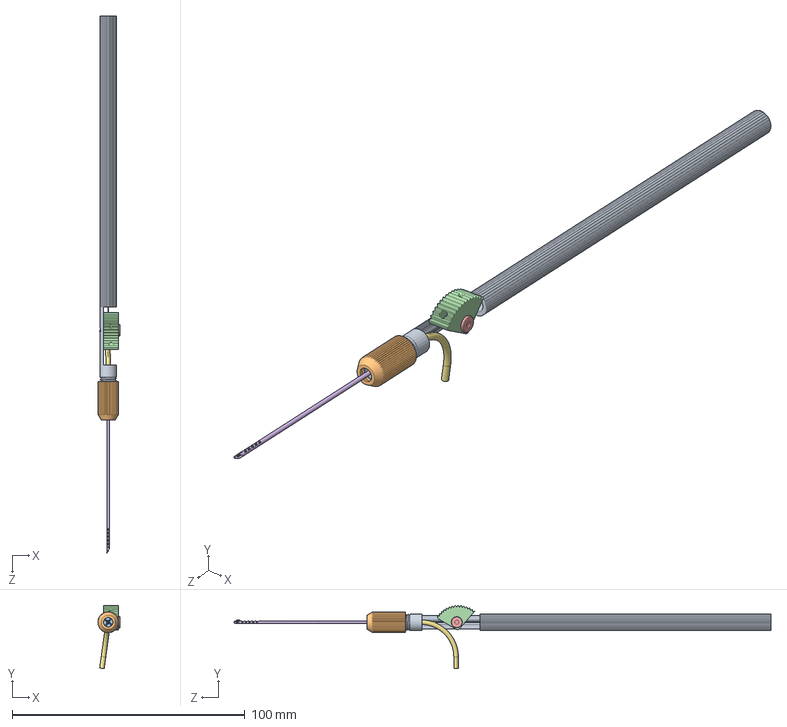
[picture p242: CAD file, 2018-02-12]
Ear Surgery Instruments/Wrist Tool Assembly/superceded/Clinical Tool/Clinical Tool Assembly.SLDASM
9.64 x 27.2 x 230.7 mm
Handle M7 threads
90591A154 M7 collet clamp
collet
wedge v-5 14-Sep-2017_5mm_stainless steel
90318A101_ULTRA LOW PROFILE TYPE 316 SS SHOULDER SCREW
135deg CCM V-1 Wrist left
laser suction exit tube
