arushriswarup/Grad-School/Ear Surgery Instruments/Wrist Tool Assembly/assem_handle_ent V-5 14-Sep-2017.SLDASM

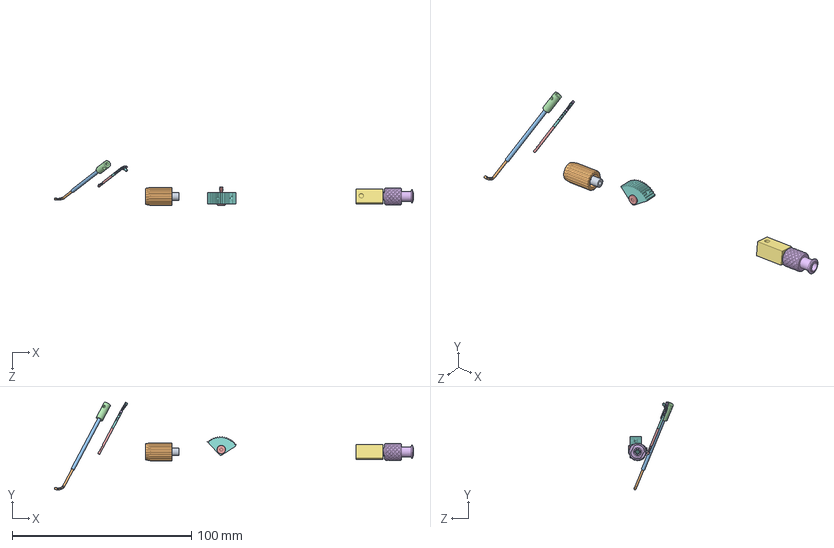
[picture p243: CAD file, 2018-02-12]
Ear Surgery Instruments/Wrist Tool Assembly/assem_handle_ent V-5 14-Sep-2017.SLDASM
200.4 x 49.0 x 25.0 mm
Collet_1_75mmID
V06_Collet_ThreadCap
Nitinol shaft
Arushri_Tube_SquareJoint_curve 3
cable_curve3
handle shaft connector
90318A102_ULTRA LOW PROFILE TYPE 316 SS SHOULDER SCREW
51465K161_HIGH-STRENGTH QUICK-TURN TUBE COUPLING
tubing to luer coupler
wedge v-5 14-Sep-2017_5mm
