arushriswarup/Grad-School/Ear Surgery Instruments/Wrist Tool Assembly/New Handle Dec-2017/cable + square joint_curve 1 assem.SLDASM

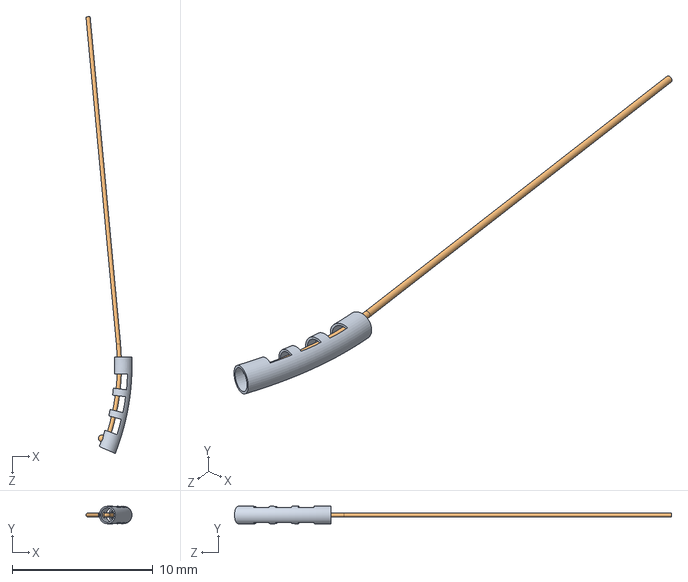
[picture p244: CAD file, 2018-02-12]
Ear Surgery Instruments/Wrist Tool Assembly/New Handle Dec-2017/cable + square joint_curve 1 assem.SLDASM
3.28 x 1.24 x 31.0 mm
Arushri_Tube_SquareJoint_curve 1
cable_curve1
