arushriswarup/Grad-School/3D Models/Thomassin angled tip.SLDASM

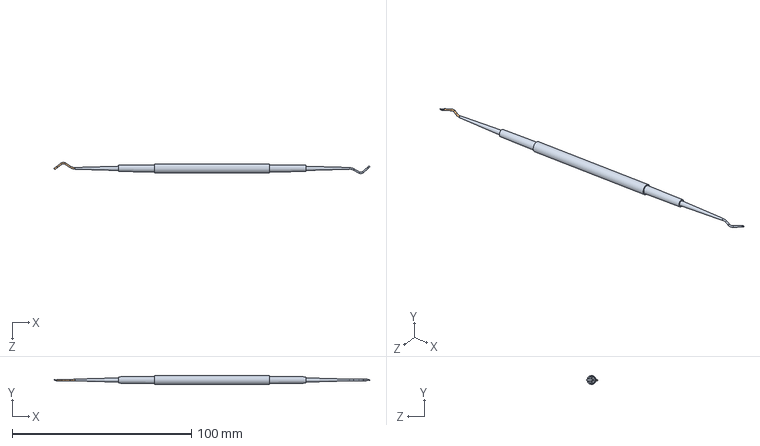
[picture p245: CAD file, 2017-11-13]
3D Models/Thomassin angled tip.SLDASM
176.2 x 5.00 x 6.42 mm
Thomassin angled tip_one end
Thomassin angled tip_other end
