arushriswarup/Grad-School/Ear Surgery Instruments/Wrist Tool Assembly/New Handle Dec-2017/Wrist Tool Assembly V-2.SLDASM

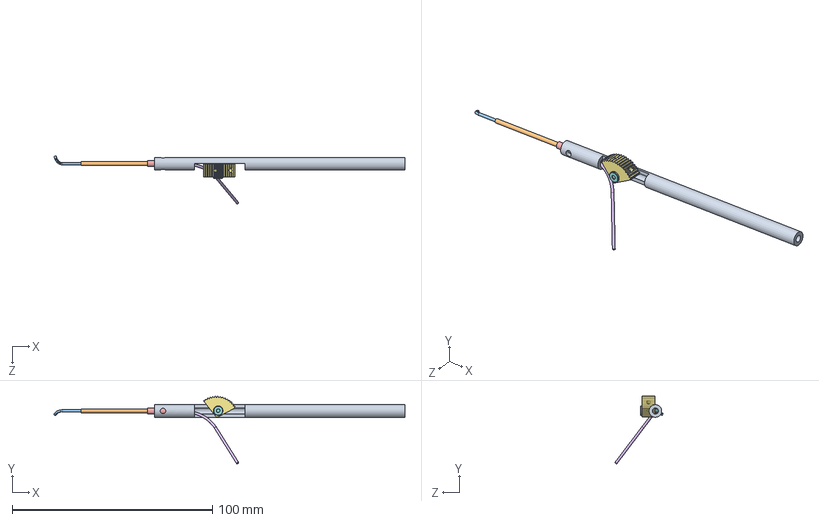
[picture p246: CAD file, 2018-02-12]
Ear Surgery Instruments/Wrist Tool Assembly/New Handle Dec-2017/Wrist Tool Assembly V-2.SLDASM
175.3 x 33.8 x 24.0 mm
handle
Nitinol shaft
Arushri_Tube_SquareJoint_curve 3
cable_curve3
handle shaft connector
1.24mm nitinol laser and suction port
wedge v-5 14-Sep-2017_5mm
90318A102_ULTRA LOW PROFILE TYPE 316 SS SHOULDER SCREW
