arushriswarup/Grad-School/Tools/Tube Clamp v-2_assem.SLDASM

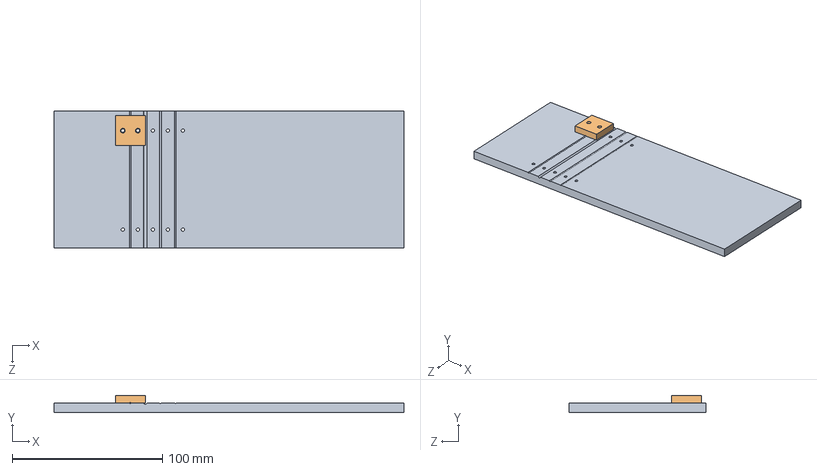
[picture p247: CAD file, 2017-11-13]
Tools/Tube Clamp v-2_assem.SLDASM
233.0 x 11.4 x 91.0 mm
Tube Clamp v-2
Tube Clamp 1_24mm top
