arushriswarup/Grad-School/Ear Surgery Instruments/Wrist Tool Assembly/slider assembly v-5 22-Nov-2017.SLDASM

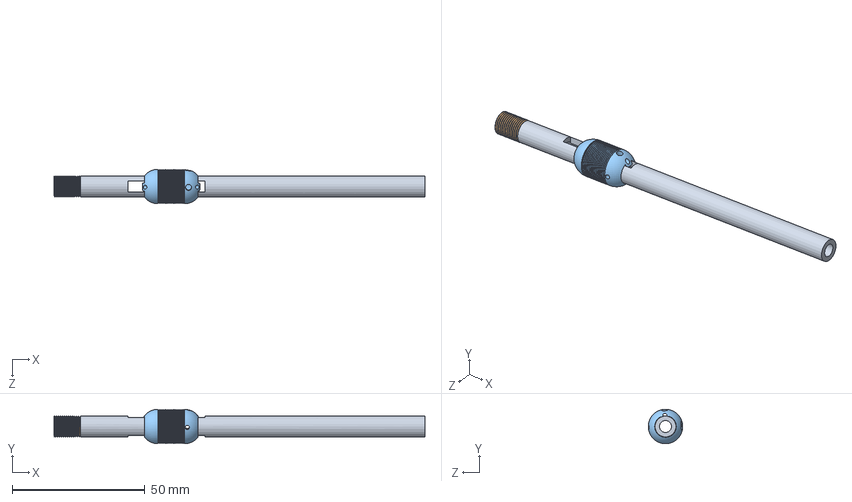
[picture p248: CAD file, 2018-02-12]
Ear Surgery Instruments/Wrist Tool Assembly/slider assembly v-5 22-Nov-2017.SLDASM
140.0 x 13.0 x 13.0 mm
wheel_handle_body_slider v-4 06-Nov-2017
M8X0.75
slider v-6 22-Nov-2017
