arushriswarup/Grad-School/Ear Surgery Instruments/Wrist Tool Assembly/New Handle Dec-2017/tubing assembly.SLDASM

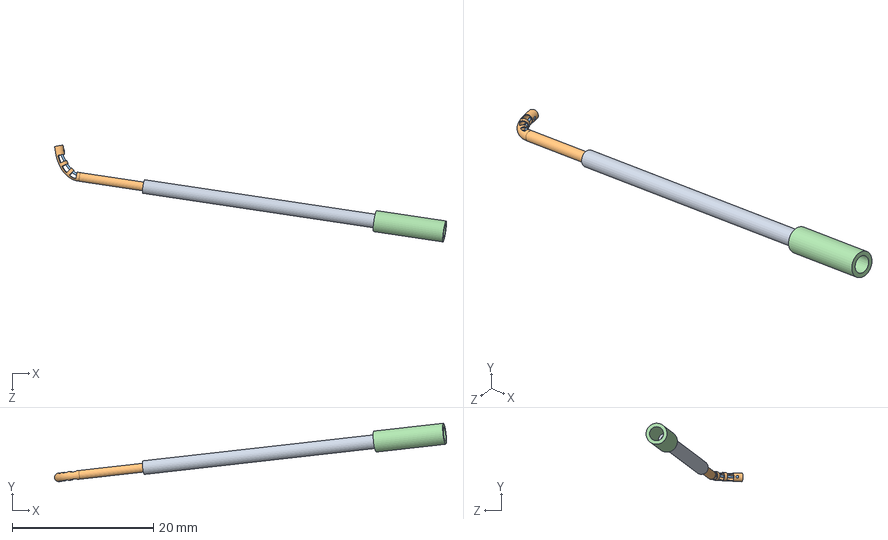
[picture p249: CAD file, 2018-02-12]
Ear Surgery Instruments/Wrist Tool Assembly/New Handle Dec-2017/tubing assembly.SLDASM
55.4 x 8.28 x 13.7 mm
Nitinol shaft
Arushri_Tube_SquareJoint_curve 3
cable_curve3
handle shaft connector
