arushriswarup/Grad-School/Ear Surgery Instruments/Wrist Tool Assembly/slider assembly v-1 26-Oct-2017.SLDASM

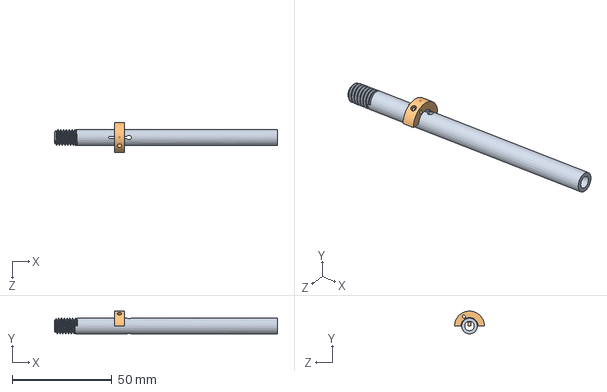
[picture p250: CAD file, 2018-02-12]
Ear Surgery Instruments/Wrist Tool Assembly/slider assembly v-1 26-Oct-2017.SLDASM
112.0 x 11.5 x 15.0 mm
wheel_handle_body_slider v-1 26-Oct-2017
slider v-1 26-Oct-2017
