arushriswarup/Grad-School/Ear Surgery Instruments/Wrist Tool Assembly/Wristed Cuts/ANSTY Profile_1DOF_ARUSHRI_Full Joint.SLDPRT

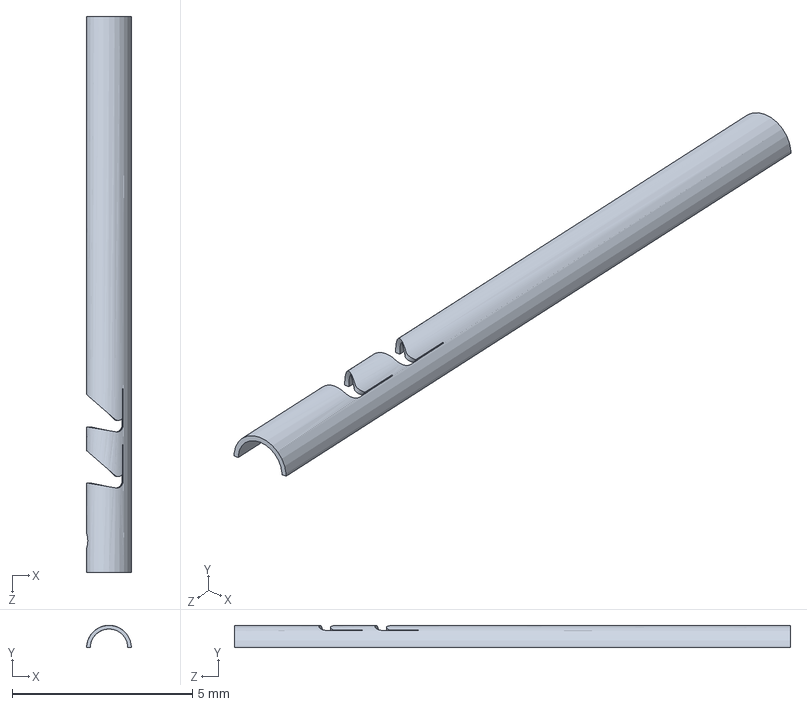
[picture p251: CAD file, 2017-11-13]
Ear Surgery Instruments/Wrist Tool Assembly/Wristed Cuts/ANSTY Profile_1DOF_ARUSHRI_Full Joint.SLDPRT
1.24 x 0.622 x 15.4 mm
