arushriswarup/Grad-School/3D Models/Panetti left with tip reach volume_assem.SLDASM

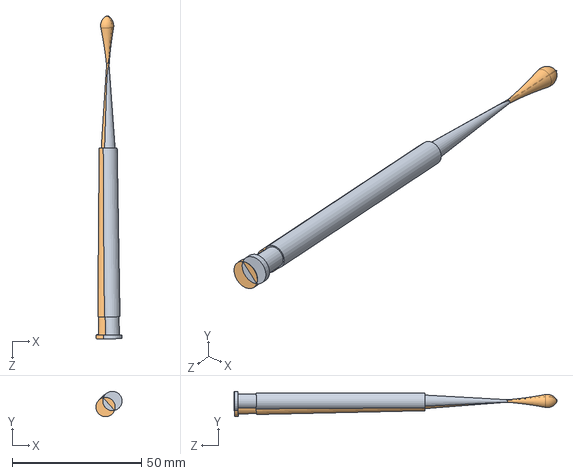
[picture p252: CAD file, 2017-11-13]
3D Models/Panetti left with tip reach volume_assem.SLDASM
10.2 x 9.84 x 125.1 mm
Panetti left
Panetti left with tip reach volume
