arushriswarup/Grad-School/Ear Surgery Instruments/Wrist Tool Assembly/superceded/assem_handle_ent.SLDASM

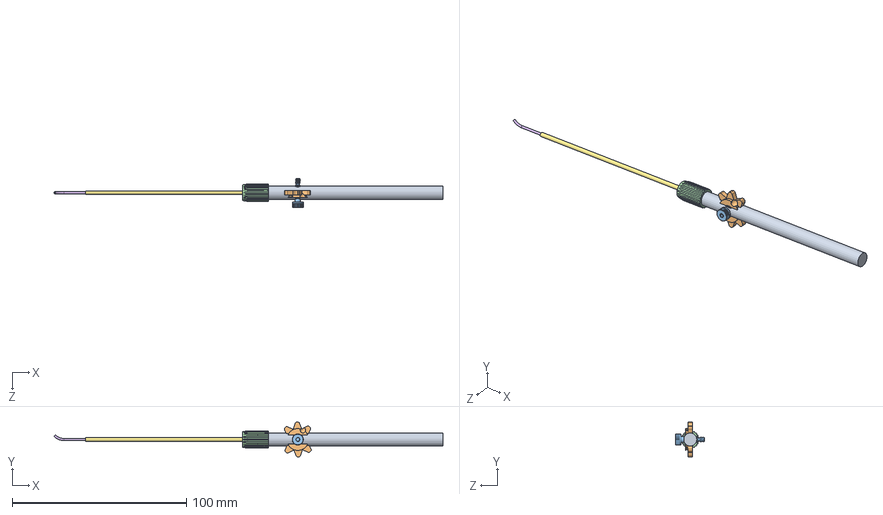
[picture p253: CAD file, 2017-11-13]
Ear Surgery Instruments/Wrist Tool Assembly/superceded/assem_handle_ent.SLDASM
223.0 x 20.0 x 16.7 mm
wheel_handle_body v-2 17-Jan-2017
wheel_ent
91259A156_ALLOY STEEL SHOULDER SCREW
V06_Collet_ThreadCap
Collet_1_75mmID
nitinol notched tube v-1 17-Jan-2017
stainless steel rod v-1 17-Jan-2017
