arushriswarup/Grad-School/3D Models/bone_endoscope_panetti.SLDASM

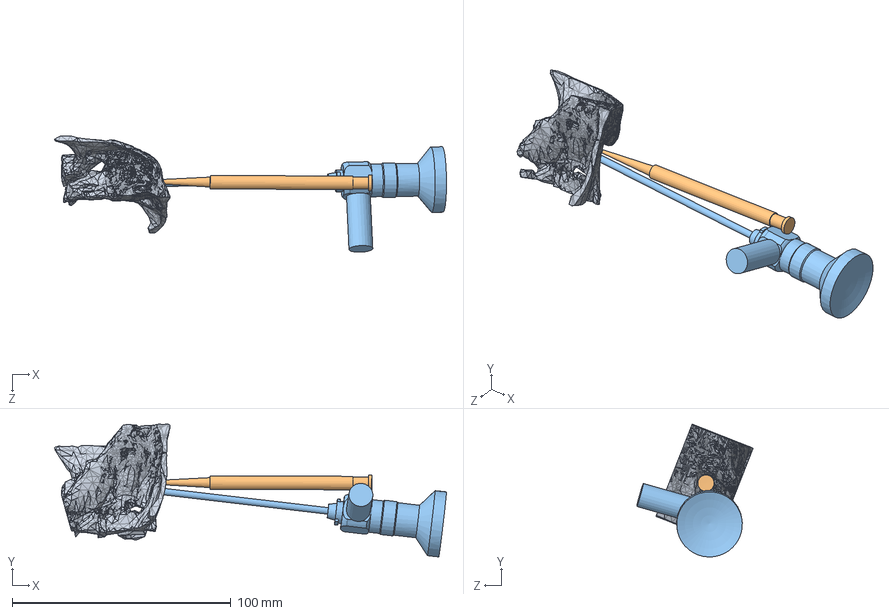
[picture p254: CAD file, 2017-11-13]
3D Models/bone_endoscope_panetti.SLDASM
179.2 x 60.8 x 53.2 mm
temporal bone_reduced
Panetti left with tip reach volume
endoscope
