arushriswarup/Grad-School/Ear Surgery Instruments/Wrist Tool Assembly/superceded/assem_handle_ent V-3 18-Jan-2017.SLDASM

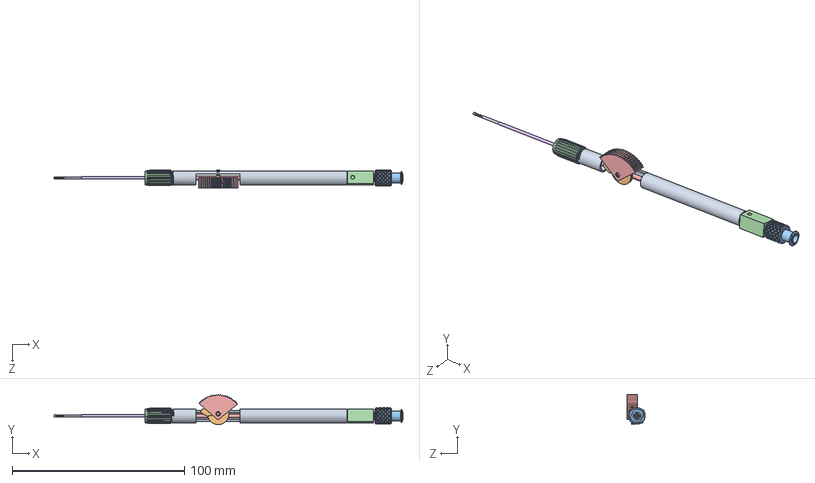
[picture p255: CAD file, 2017-11-13]
Ear Surgery Instruments/Wrist Tool Assembly/superceded/assem_handle_ent V-3 18-Jan-2017.SLDASM
202.5 x 17.5 x 10.7 mm
wheel_handle_body v-3 18-Jan-2017
Collet_1_75mmID
V06_Collet_ThreadCap
tube without cable 8988K35
stainless steel tube 5560K43
wire exit path v-2 23-Mar-2017
cable
Arushri_Tube_SquareJoint
90318A102_ULTRA LOW PROFILE TYPE 316 SS SHOULDER SCREW
51465K161_HIGH-STRENGTH QUICK-TURN TUBE COUPLING
tubing to luer coupler
wedge v-2 28-Mar-2017
