arushriswarup/Grad-School/Ear Surgery Instruments/Wrist Tool Assembly/Wristed Cuts/ANSTY_1DOF_Square and Modified Joints.SLDASM

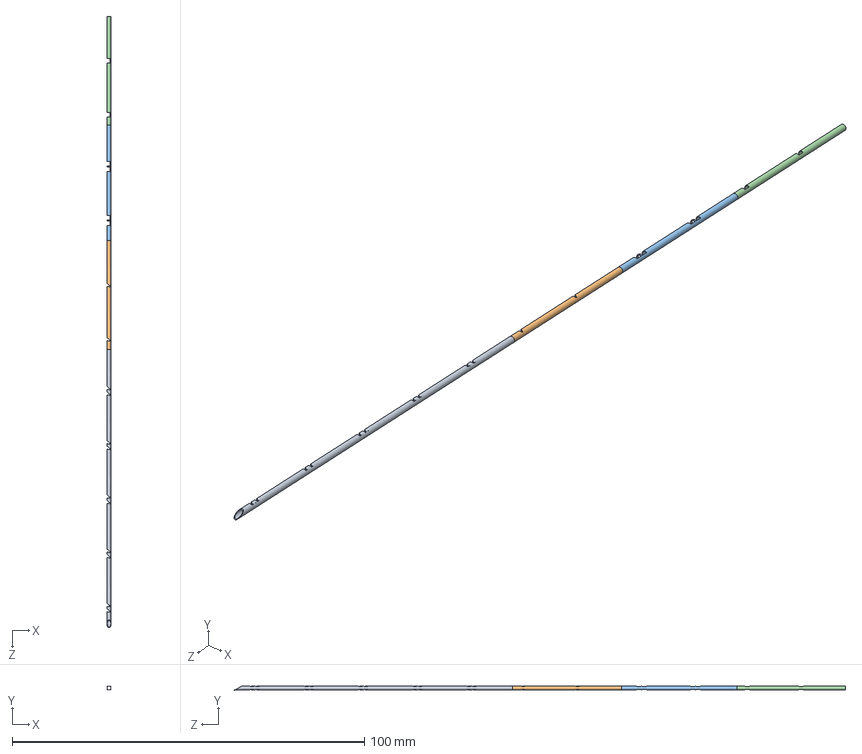
[picture p256: CAD file, 2017-11-13]
Ear Surgery Instruments/Wrist Tool Assembly/Wristed Cuts/ANSTY_1DOF_Square and Modified Joints.SLDASM
1.24 x 1.24 x 173.6 mm
Arushri_Tube_MultiJoint
Arushri_Tube_ModifiedSingleJoint
Arushri_Tube_SquareJoint
Arushri_Tube_SingleSquareJoint
