arushriswarup/Grad-School/Ear Surgery Instruments/Wrist Tool Assembly/brass collet fitting and aluminum tube connector_cut out of aluminum stock.SLDASM

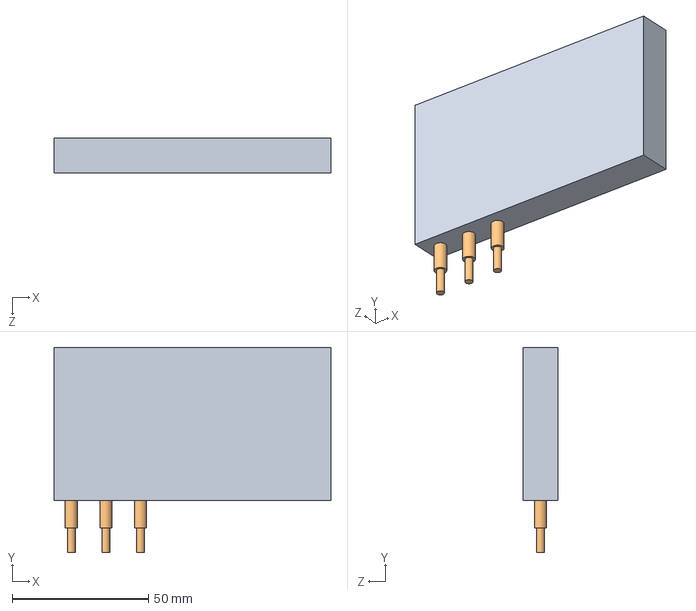
[picture p257: CAD file, 2018-02-12]
Ear Surgery Instruments/Wrist Tool Assembly/brass collet fitting and aluminum tube connector_cut out of aluminum stock.SLDASM
101.6 x 75.2 x 12.7 mm
Aluminum stock
brass collet fitting and aluminum tube connector x 3
