arushriswarup/Grad-School/3D Models/Virtual Model V-2 10-Apr-2017.SLDASM

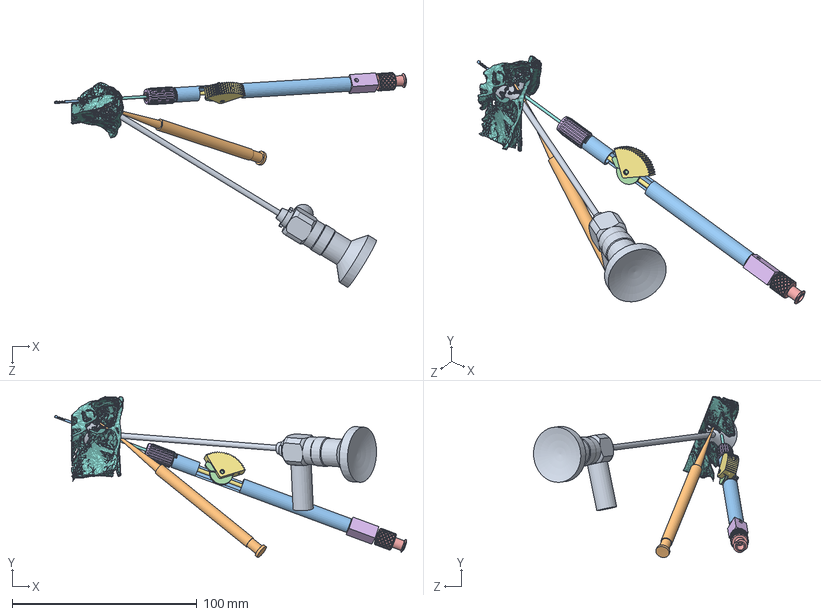
[picture p258: CAD file, 2017-11-13]
3D Models/Virtual Model V-2 10-Apr-2017.SLDASM
190.5 x 87.2 x 116.4 mm
endoscope
Panetti left
temporal bone axial crop v-4 10-Apr-2017
endoscope viewing range
