arushriswarup/Grad-School/Ear Surgery Instruments/Wrist Tool Assembly/slider handle assembly v-4 06-Nov-2017.SLDASM

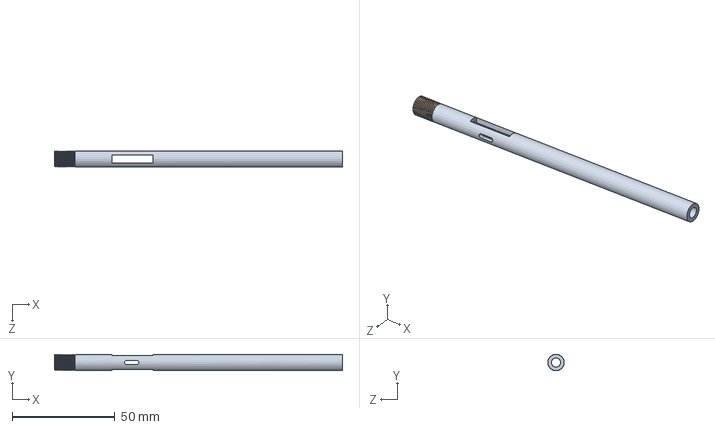
[picture p259: CAD file, 2018-02-12]
Ear Surgery Instruments/Wrist Tool Assembly/slider handle assembly v-4 06-Nov-2017.SLDASM
140.0 x 8.00 x 8.00 mm
wheel_handle_body_slider v-4 06-Nov-2017
M8X0.75
