arushriswarup/Grad-School/Ear Surgery Instruments/Wrist Tool Assembly/slider assembly v-2 30-Oct-2017.SLDASM

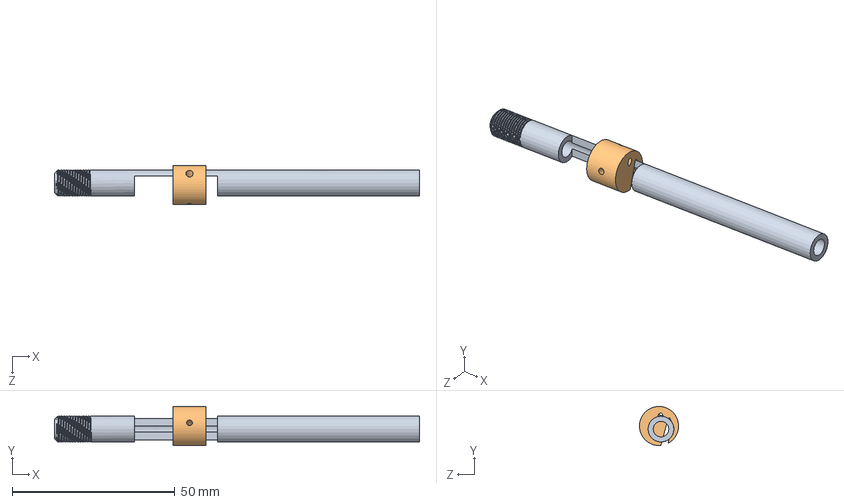
[picture p260: CAD file, 2018-02-12]
Ear Surgery Instruments/Wrist Tool Assembly/slider assembly v-2 30-Oct-2017.SLDASM
112.0 x 12.0 x 12.0 mm
wheel_handle_body_slider v-3 01-Nov-2017
slider v-4 02-Nov-2017
