arushriswarup/Grad-School/Ear Surgery Instruments/Wrist Tool Assembly/assem_handle_ent_wheel V-6 26-Oct-2017.SLDASM

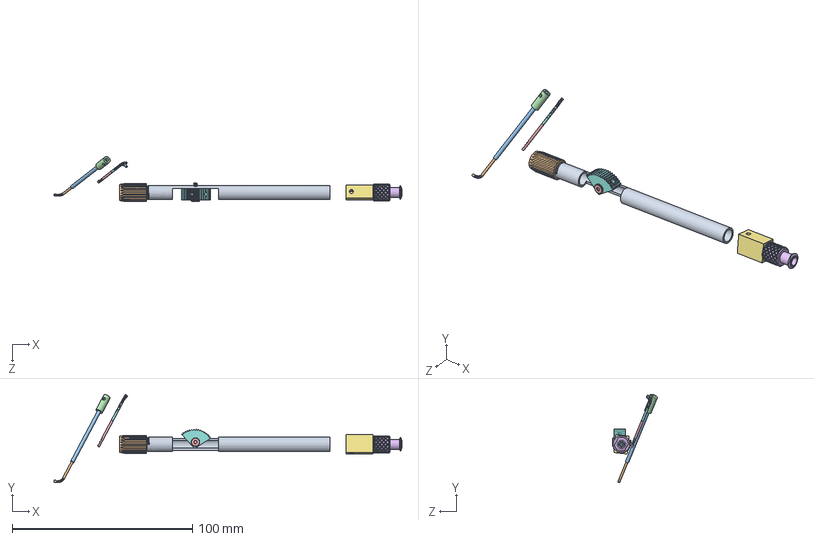
[picture p261: CAD file, 2018-02-12]
Ear Surgery Instruments/Wrist Tool Assembly/assem_handle_ent_wheel V-6 26-Oct-2017.SLDASM
193.3 x 49.0 x 25.0 mm
Collet_1_75mmID
V06_Collet_ThreadCap
Nitinol shaft
Arushri_Tube_SquareJoint_curve 3
cable_curve3
handle shaft connector
90318A102_ULTRA LOW PROFILE TYPE 316 SS SHOULDER SCREW
51465K161_HIGH-STRENGTH QUICK-TURN TUBE COUPLING
tubing to luer coupler v-2 21-Sep-2017
wedge v-5 14-Sep-2017_5mm
wheel_handle_body v-4 26-Oct-2017
