arushriswarup/Grad-School/Ear Surgery Instruments/Wrist Tool Assembly/slider assembly v-6 23-Nov-2017.SLDASM

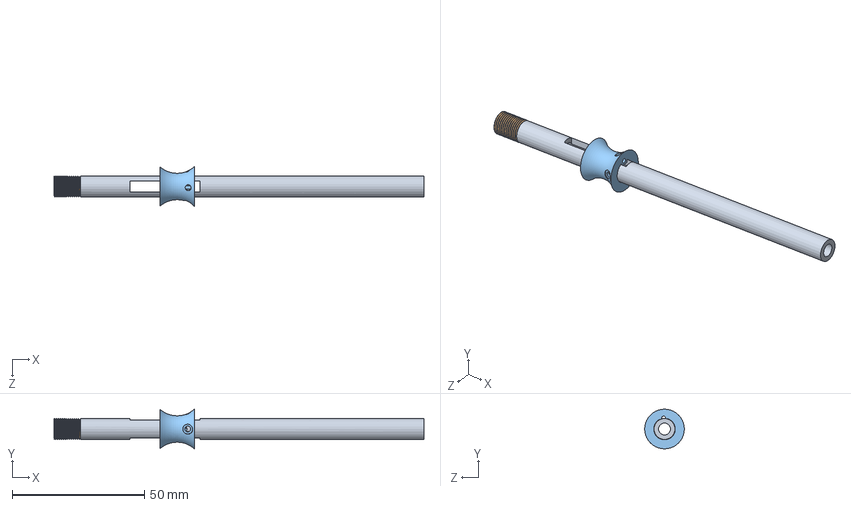
[picture p262: CAD file, 2018-02-12]
Ear Surgery Instruments/Wrist Tool Assembly/slider assembly v-6 23-Nov-2017.SLDASM
140.0 x 15.0 x 15.0 mm
wheel_handle_body_slider v-4 06-Nov-2017
M8X0.75
slider v-7 23-Nov-2017
