arushriswarup/Grad-School/Ear Surgery Instruments/Wrist Tool Assembly/cable + square joint_straight assem.SLDASM

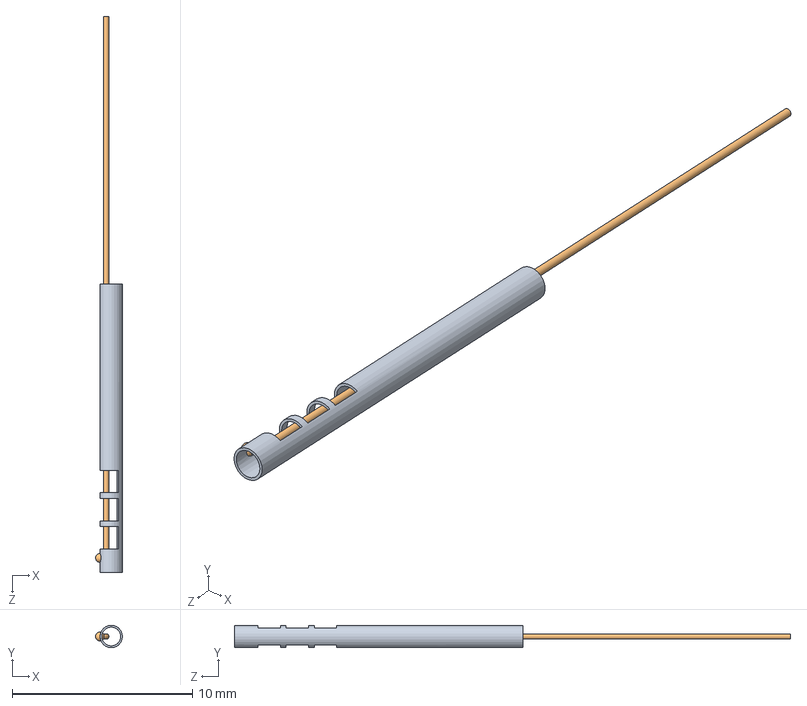
[picture p263: CAD file, 2017-11-13]
Ear Surgery Instruments/Wrist Tool Assembly/cable + square joint_straight assem.SLDASM
1.49 x 1.24 x 30.8 mm
Arushri_Tube_SquareJoint
cable
