arushriswarup/Grad-School/Ear Surgery Instruments/Wrist Tool Assembly/handle assem 20-Mar-2017.SLDASM

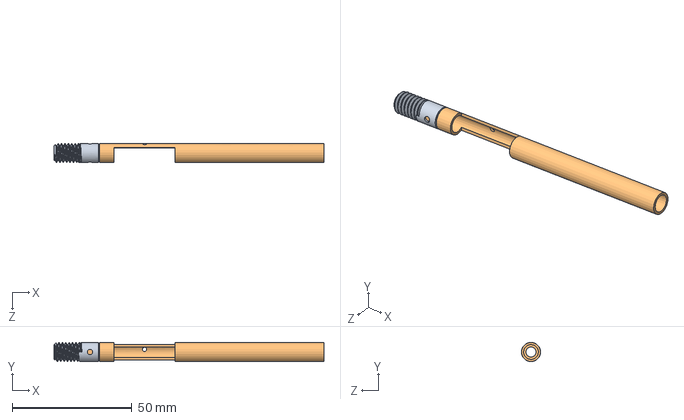
[picture p264: CAD file, 2017-11-13]
Ear Surgery Instruments/Wrist Tool Assembly/handle assem 20-Mar-2017.SLDASM
112.5 x 7.94 x 7.94 mm
wheel_handle_body_A v-2 20-Mar-2017
wheel_handle_body_B v-2 20-Mar-2017
