arushriswarup/Grad-School/3D Models/anatomy stls/ear canal + superior to malleus.stl

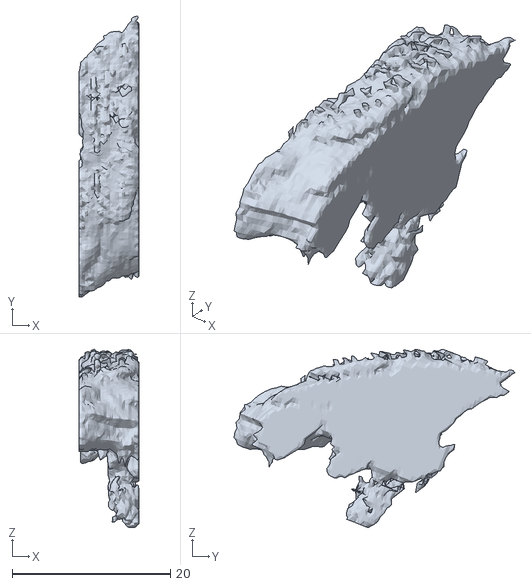
[picture p265: CAD file, 2017-11-13]
3D Models/anatomy stls/ear canal + superior to malleus.stl
7.61 x 35.5 x 22.5
