arushriswarup/Grad-School/3D Models/anatomy stls/patient1720/PATIENT1720_antrum_001.stl

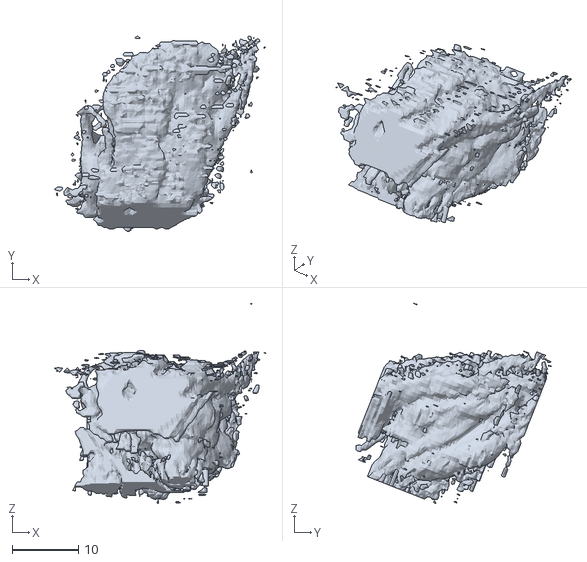
[picture p266: CAD file, 2017-11-13]
3D Models/anatomy stls/patient1720/PATIENT1720_antrum_001.stl
31.8 x 29.5 x 30.2
