arushriswarup/Grad-School/3D Models/anatomy stls/to print 09-Apr-2017/cropped patient 1720 + stand 09-Apr-2017.stl

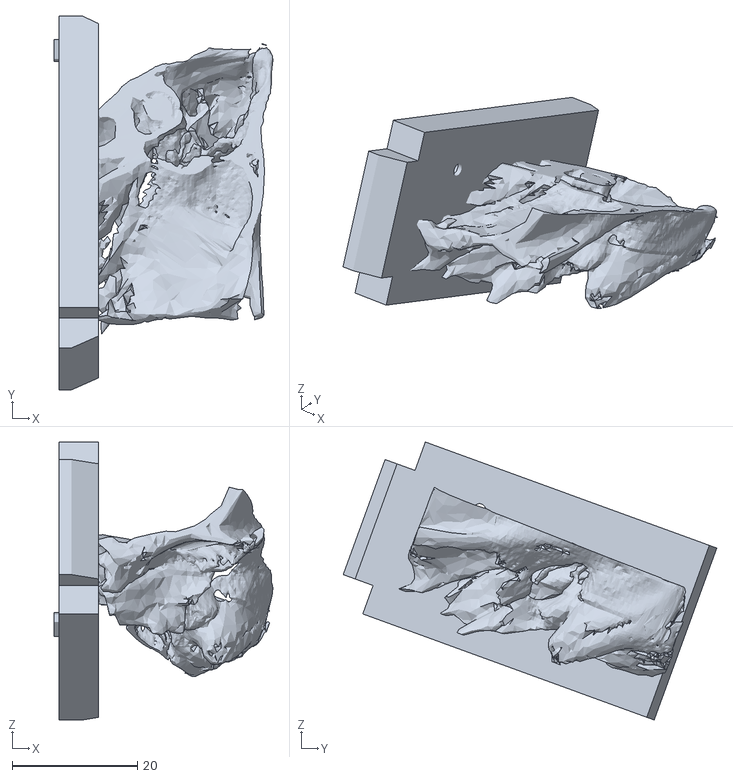
[picture p267: CAD file, 2017-11-13]
3D Models/anatomy stls/to print 09-Apr-2017/cropped patient 1720 + stand 09-Apr-2017.stl
34.9 x 59.7 x 44.4
