arushriswarup/Grad-School/3D Models/ear drum/BLI Phantom  BLI Phantom_Green 1_001.stl

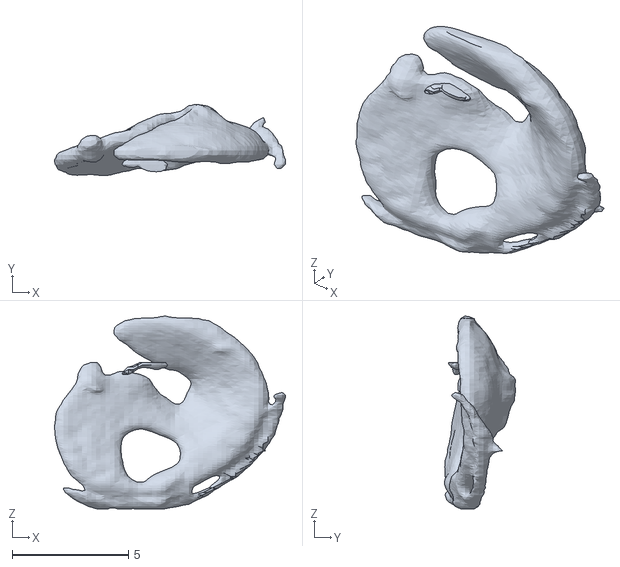
[picture p268: CAD file, 2017-11-13]
3D Models/ear drum/BLI Phantom BLI Phantom_Green 1_001.stl
9.95 x 3.06 x 8.30
