arushriswarup/Grad-School/3D Models/Panetti left.SLDPRT

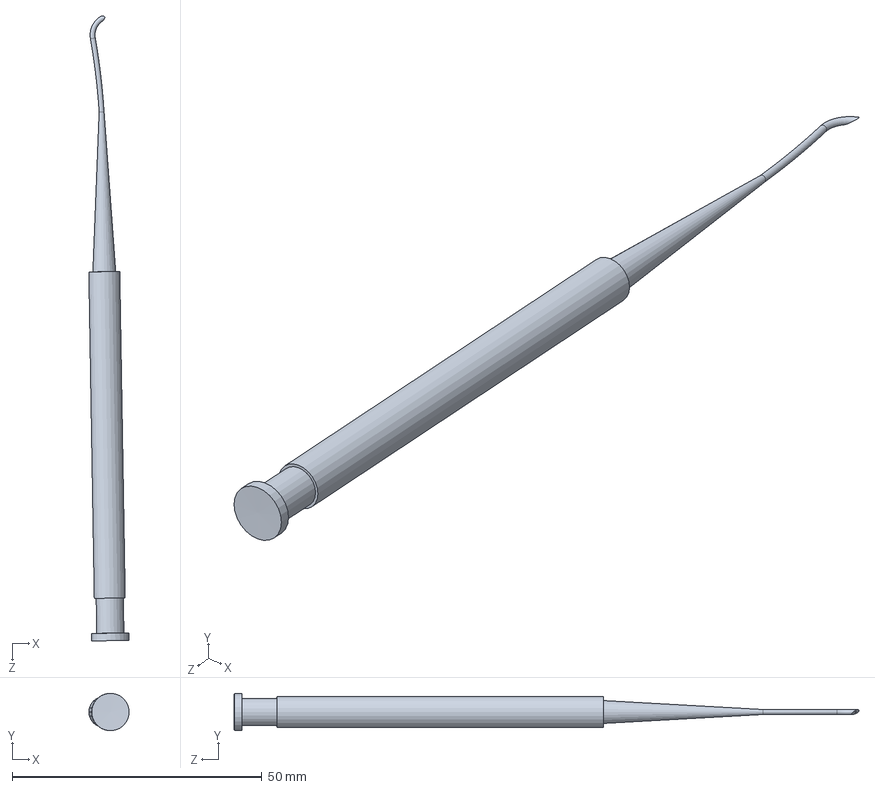
[picture p269: CAD file, 2018-01-30]
3D Models/Panetti left.SLDPRT
8.08 x 7.50 x 125.1 mm
