arushriswarup/Grad-School/Coursework/BME 498 TA/HumanRightEar.stl

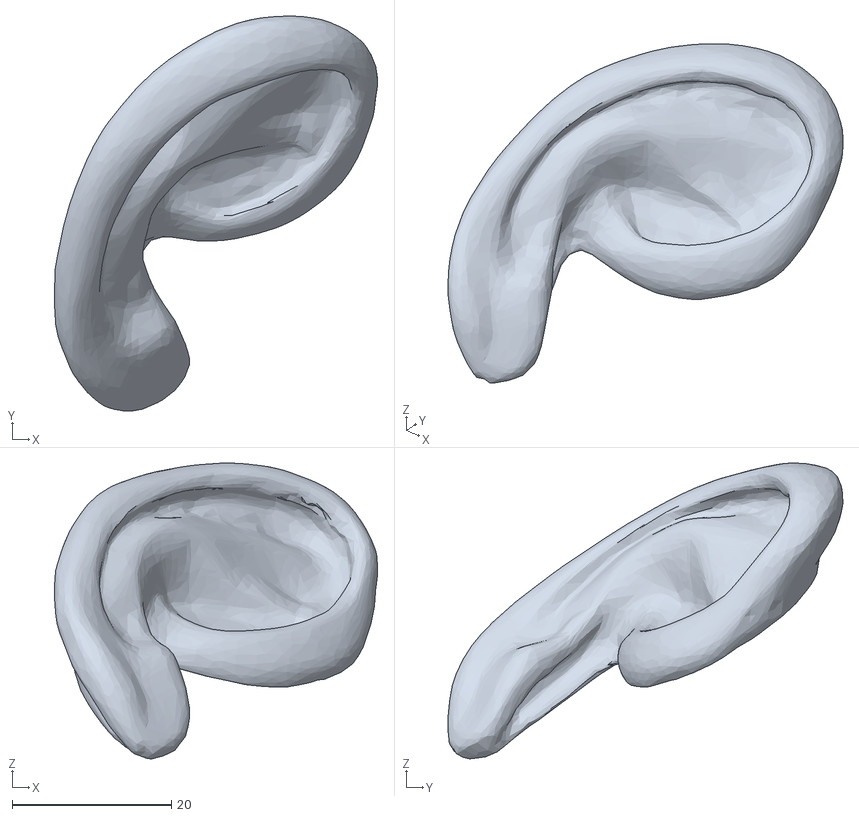
[picture p270: CAD file, 2017-11-13]
Coursework/BME 498 TA/HumanRightEar.stl
40.6 x 49.7 x 37.2
