arushriswarup/Grad-School/Ear Surgery Instruments/collet clamp plug.SLDPRT

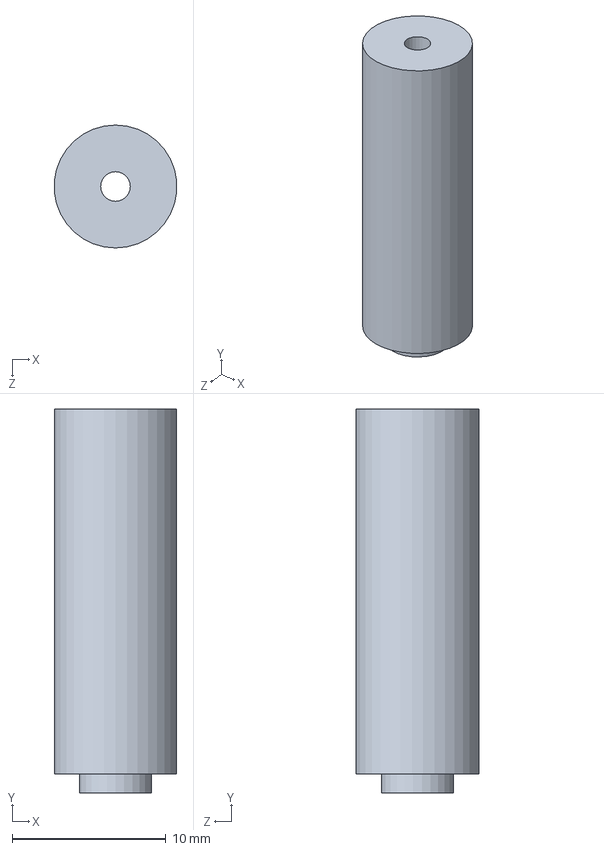
[picture p271: CAD file, 2018-01-30]
Ear Surgery Instruments/collet clamp plug.SLDPRT
7.97 x 25.0 x 8.00 mm
