arushriswarup/Grad-School/Ear Surgery Instruments/ear drum instruments/ear drum tool tip mold.SLDPRT

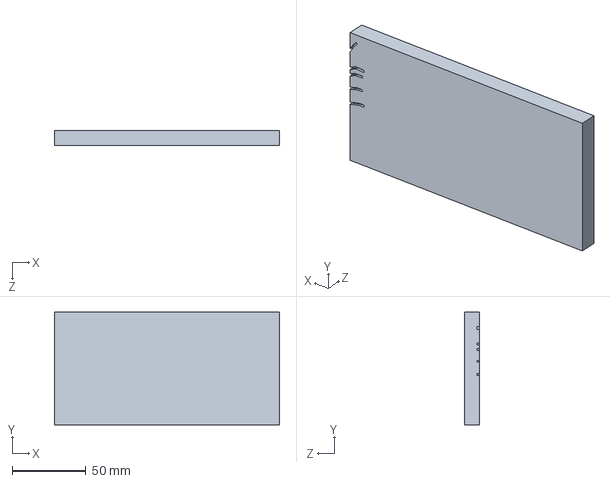
[picture p272: CAD file, 2017-11-13]
Ear Surgery Instruments/ear drum instruments/ear drum tool tip mold.SLDPRT
152.4 x 76.2 x 9.84 mm
