arushriswarup/Grad-School/Ear Surgery Instruments/ear drum instruments/form print 12-Sep-2017/Panetti body_modified.STL

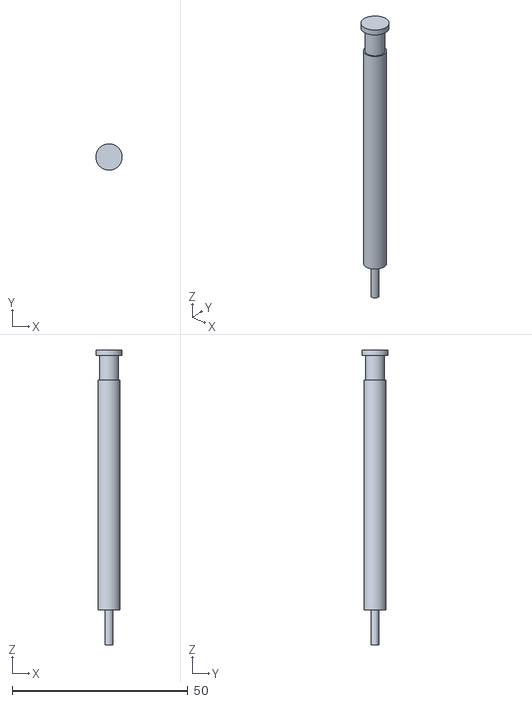
[picture p273: CAD file, 2017-11-13]
Ear Surgery Instruments/ear drum instruments/form print 12-Sep-2017/Panetti body_modified.STL
7.49 x 7.49 x 83.8
