arushriswarup/Grad-School/Ear Surgery Instruments/Wrist Tool Assembly/Arushri_Tube_SquareJoint_curve 2.SLDPRT

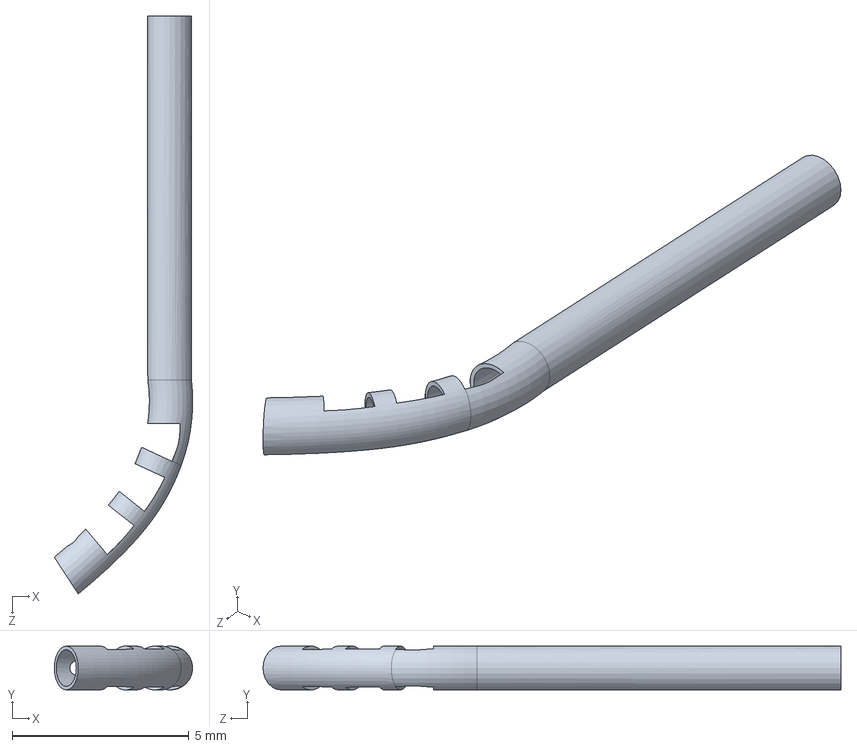
[picture p274: CAD file, 2018-02-12]
Ear Surgery Instruments/Wrist Tool Assembly/Arushri_Tube_SquareJoint_curve 2.SLDPRT
3.92 x 1.24 x 16.4 mm
