arushriswarup/Grad-School/Ear Surgery Instruments/Wrist Tool Assembly/Clinical Tool/laser suction exit tube.SLDPRT

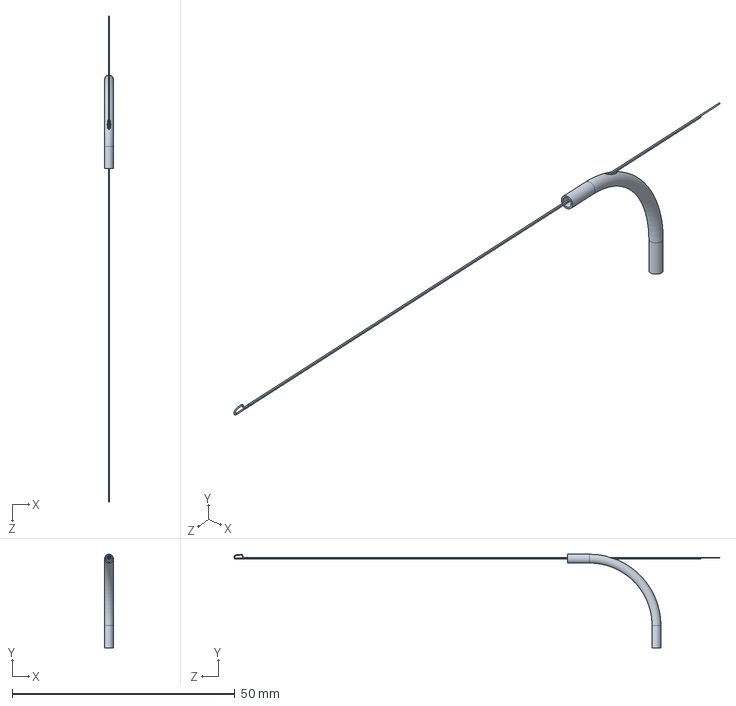
[picture p275: CAD file, 2018-02-27]
Ear Surgery Instruments/Wrist Tool Assembly/Clinical Tool/laser suction exit tube.SLDPRT
2.00 x 21.0 x 109.0 mm
