arushriswarup/Grad-School/Ear Surgery Instruments/Wrist Tool Assembly/superceded/Clinical Tool/Handle M7 threads.STEP

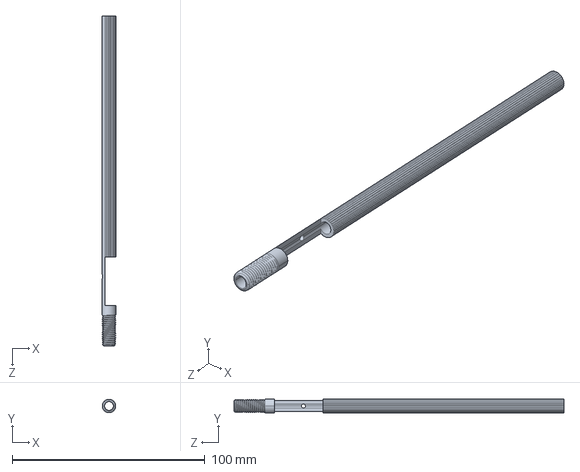
[picture p276: CAD file, 2018-02-12]
Ear Surgery Instruments/Wrist Tool Assembly/superceded/Clinical Tool/Handle M7 threads.STEP
7.00 x 7.00 x 171.0 mm
