arushriswarup/Grad-School/Ear Surgery Instruments/Wrist Tool Assembly/superceded/form print 12-Sep-2017/wire exit path v-4 12-Sep-2017.SLDPRT

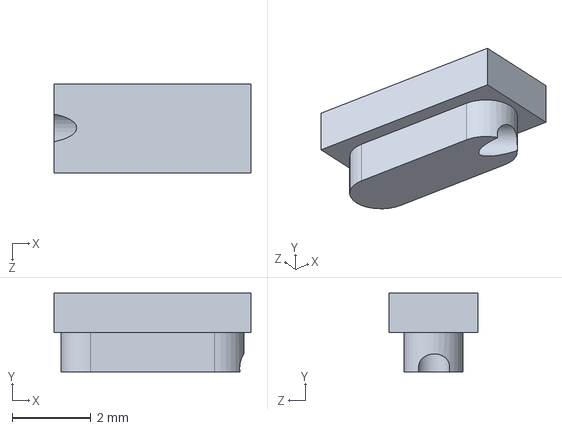
[picture p277: CAD file, 2017-11-13]
Ear Surgery Instruments/Wrist Tool Assembly/superceded/form print 12-Sep-2017/wire exit path v-4 12-Sep-2017.SLDPRT
5.00 x 2.00 x 2.25 mm
