arushriswarup/Grad-School/Ear Surgery Instruments/Wrist Tool Assembly/superceded/form print 16-Aug-2017/V06_Collet_ThreadCap.STL

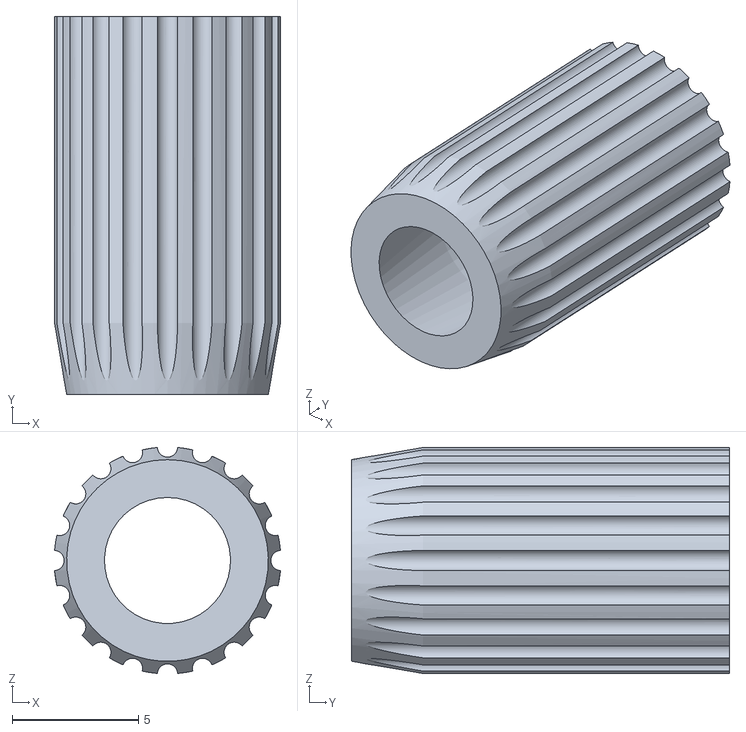
[picture p278: CAD file, 2017-11-13]
Ear Surgery Instruments/Wrist Tool Assembly/superceded/form print 16-Aug-2017/V06_Collet_ThreadCap.STL
8.96 x 15.0 x 8.96
