arushriswarup/Grad-School/Ear Surgery Instruments/Wrist Tool Assembly/superceded/form print 20-Sep-2017/tubing to luer coupler.STL

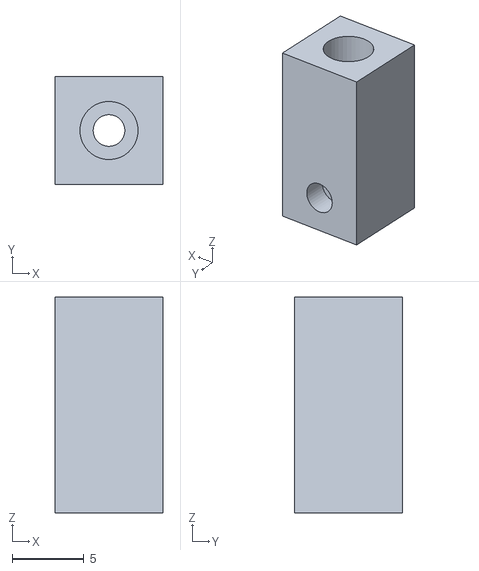
[picture p280: CAD file, 2017-11-13]
Ear Surgery Instruments/Wrist Tool Assembly/superceded/form print 20-Sep-2017/tubing to luer coupler.STL
7.50 x 7.50 x 15.0
