arushriswarup/Grad-School/Ear Surgery Instruments/Wrist Tool Assembly/superceded/Form print 21-Sep-2017/tubing to luer coupler v-2 21-Sep-2017.STL

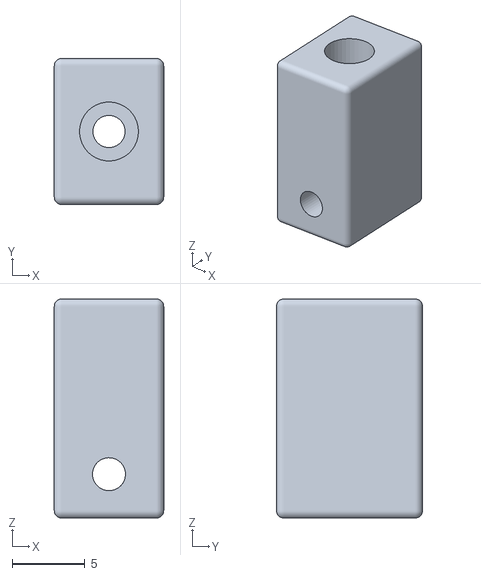
[picture p281: CAD file, 2017-11-13]
Ear Surgery Instruments/Wrist Tool Assembly/superceded/Form print 21-Sep-2017/tubing to luer coupler v-2 21-Sep-2017.STL
7.50 x 10.0 x 15.0
