arushriswarup/Grad-School/Ear Surgery Instruments/Wrist Tool Assembly/superceded/form print 25-Aug-2017/wedge v-4 01-Aug-2017_7mm.STL

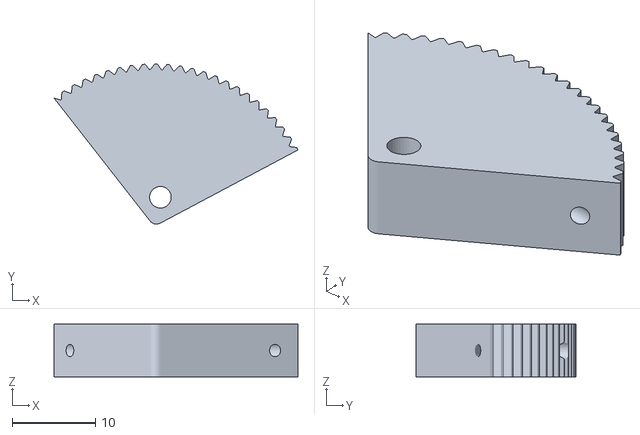
[picture p282: CAD file, 2017-11-13]
Ear Surgery Instruments/Wrist Tool Assembly/superceded/form print 25-Aug-2017/wedge v-4 01-Aug-2017_7mm.STL
29.3 x 19.3 x 6.35
