arushriswarup/Grad-School/Ear Surgery Instruments/Wrist Tool Assembly/superceded/form print 28-Aug-2017/V06_Collet_ThreadCap_repaired threads.SLDPRT

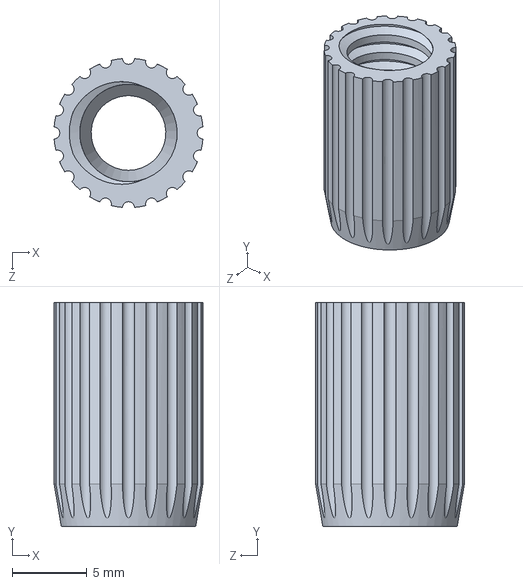
[picture p283: CAD file, 2017-11-13]
Ear Surgery Instruments/Wrist Tool Assembly/superceded/form print 28-Aug-2017/V06_Collet_ThreadCap_repaired threads.SLDPRT
9.97 x 15.0 x 9.97 mm
