arushriswarup/Grad-School/Ear Surgery Instruments/Wrist Tool Assembly/superceded/form print 28-Mar-2017/wedge v-2 28-Mar-2017.STL

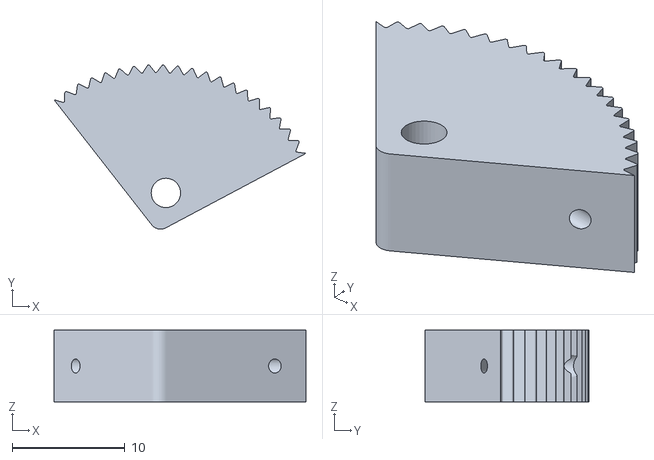
[picture p284: CAD file, 2017-11-13]
Ear Surgery Instruments/Wrist Tool Assembly/superceded/form print 28-Mar-2017/wedge v-2 28-Mar-2017.STL
22.3 x 14.5 x 6.35
