arushriswarup/Grad-School/Ear Surgery Instruments/Wrist Tool Assembly/superceded/form print testing wedge force 01-Aug-2017/wedge v-3 01-Aug-2017_5mm.STL

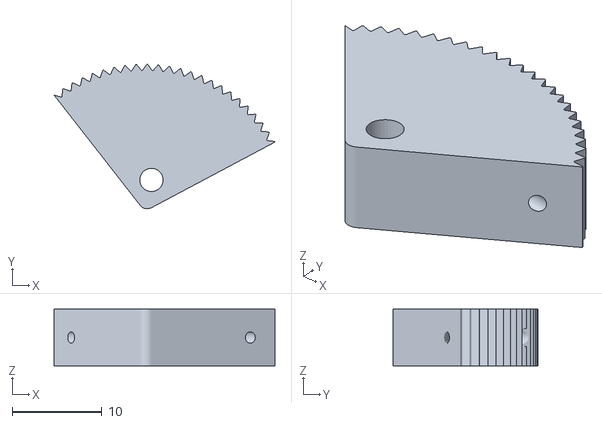
[picture p285: CAD file, 2017-11-13]
Ear Surgery Instruments/Wrist Tool Assembly/superceded/form print testing wedge force 01-Aug-2017/wedge v-3 01-Aug-2017_5mm.STL
24.7 x 16.1 x 6.35
