arushriswarup/Grad-School/Ear Surgery Instruments/Wrist Tool Assembly/superceded/form print wedge 25-sep-2017/wedge v-5 14-Sep-2017_5mm.STL

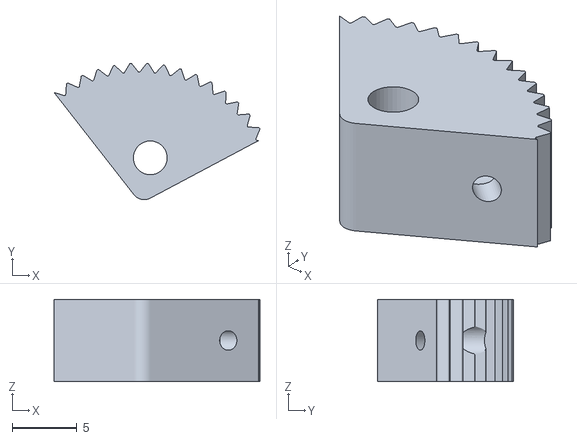
[picture p286: CAD file, 2017-11-13]
Ear Surgery Instruments/Wrist Tool Assembly/superceded/form print wedge 25-sep-2017/wedge v-5 14-Sep-2017_5mm.STL
15.9 x 10.5 x 6.35
