arushriswarup/Grad-School/Ear Surgery Instruments/Wrist Tool Assembly/superceded/print 23-Nov-2017/slider v-7 23-Nov-2017_a.STL

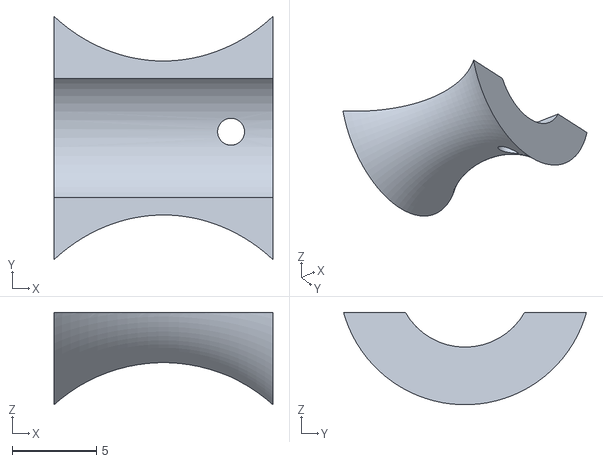
[picture p287: CAD file, 2018-02-12]
Ear Surgery Instruments/Wrist Tool Assembly/superceded/print 23-Nov-2017/slider v-7 23-Nov-2017_a.STL
13.0 x 14.5 x 5.49
