arushriswarup/Grad-School/Ear Surgery Instruments/Wrist Tool Assembly/superceded/prints/form print 20 mar 2017/wheel_ent v-3 17-Mar-2017.STL

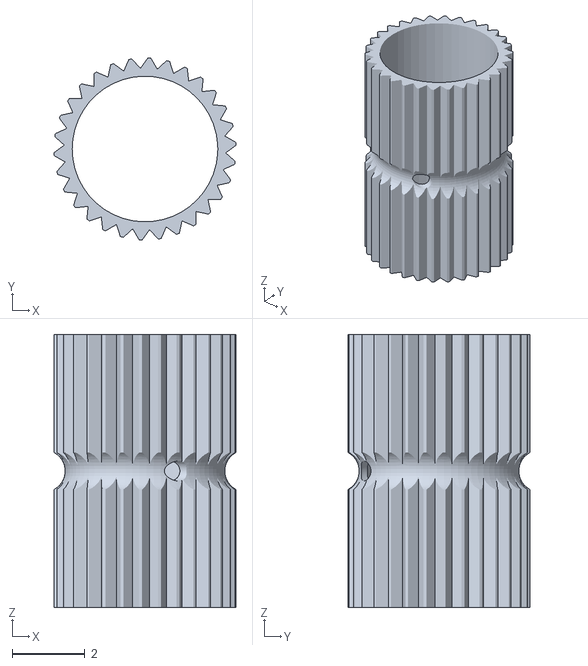
[picture p288: CAD file, 2017-11-13]
Ear Surgery Instruments/Wrist Tool Assembly/superceded/prints/form print 20 mar 2017/wheel_ent v-3 17-Mar-2017.STL
5.00 x 5.00 x 7.50
