arushriswarup/Grad-School/Ear Surgery Instruments/Wrist Tool Assembly/superceded/prints/form print 25-Mar-2017/wedge v-1 23-Mar-2017.STL

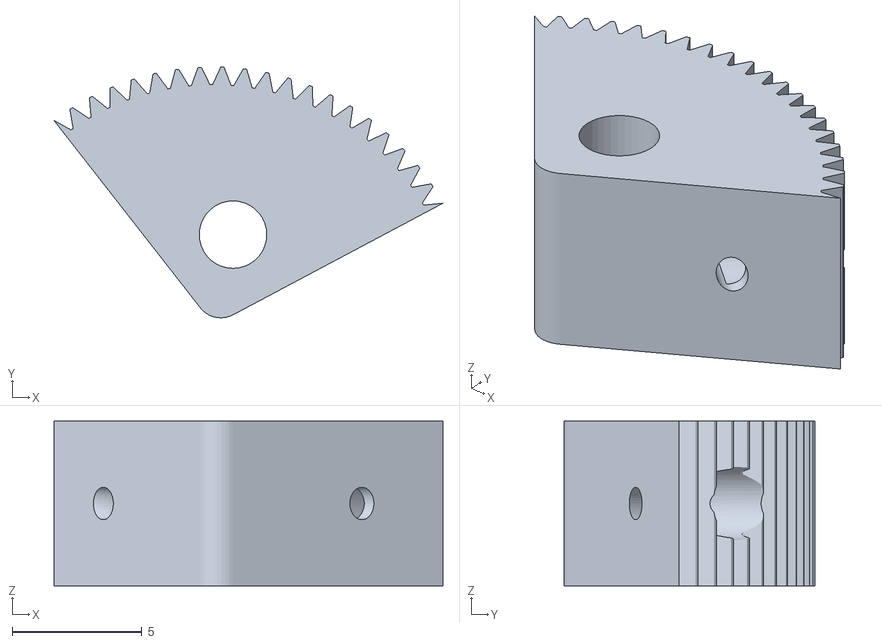
[picture p289: CAD file, 2017-11-13]
Ear Surgery Instruments/Wrist Tool Assembly/superceded/prints/form print 25-Mar-2017/wedge v-1 23-Mar-2017.STL
15.0 x 9.66 x 6.35
