arushriswarup/Grad-School/Ear Surgery Instruments/Wrist Tool Assembly/superceded/prints/form print 27-mar-2017/tubing to luer coupler.STL

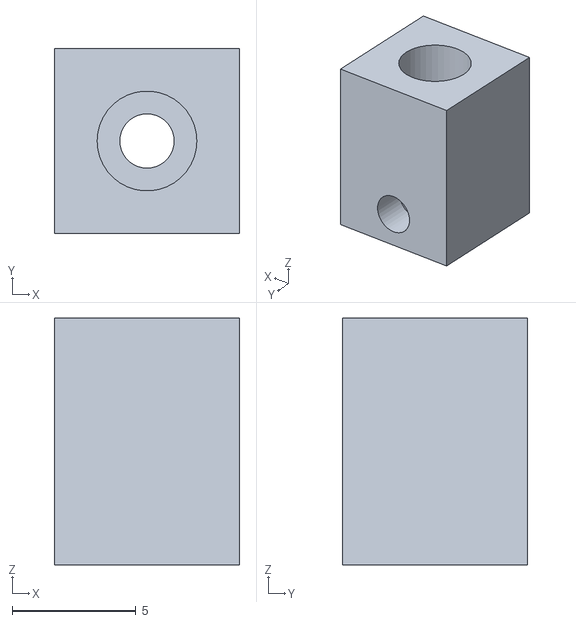
[picture p290: CAD file, 2017-11-13]
Ear Surgery Instruments/Wrist Tool Assembly/superceded/prints/form print 27-mar-2017/tubing to luer coupler.STL
7.50 x 7.50 x 10.0
