arushriswarup/Grad-School/Ear Surgery Instruments/Wrist Tool Assembly/superceded/prints/quotes for 3D printing/wire exit path v-2 23-Mar-2017.STL

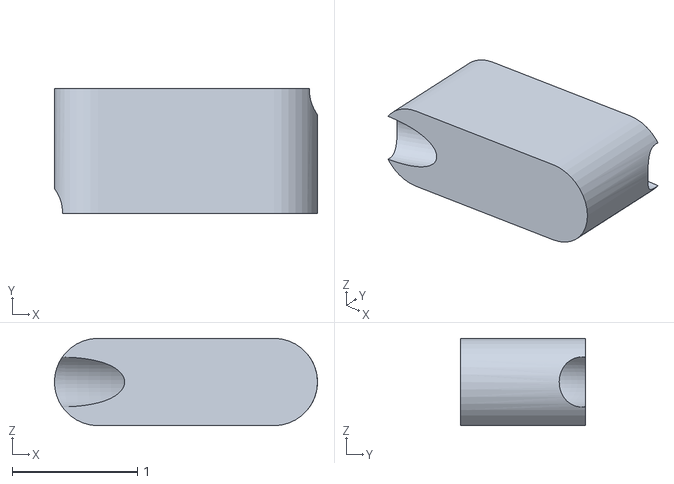
[picture p291: CAD file, 2017-11-13]
Ear Surgery Instruments/Wrist Tool Assembly/superceded/prints/quotes for 3D printing/wire exit path v-2 23-Mar-2017.STL
2.10 x 1.00 x 0.697
