arushriswarup/Grad-School/Ear Surgery Instruments/Wrist Tool Assembly/superceded/prints/taz print 20 mar 2017/wheel_handle_body_B v-2 20-Mar-2017.STL

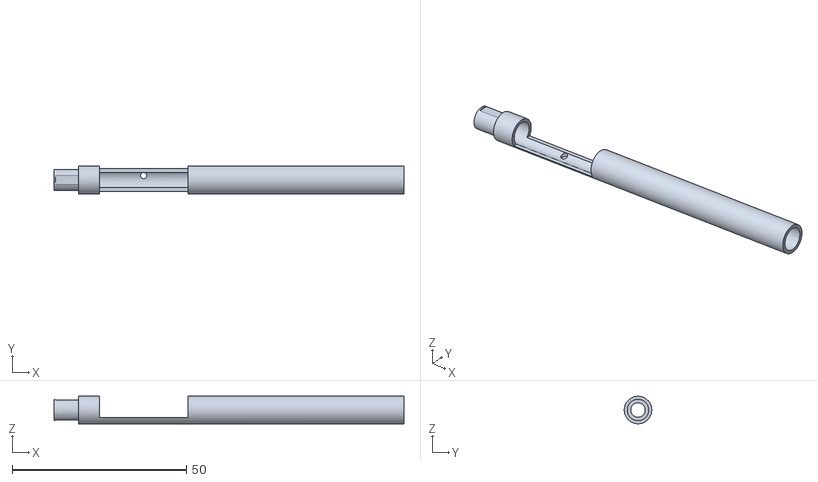
[picture p292: CAD file, 2017-11-13]
Ear Surgery Instruments/Wrist Tool Assembly/superceded/prints/taz print 20 mar 2017/wheel_handle_body_B v-2 20-Mar-2017.STL
100.5 x 7.93 x 7.94
