arushriswarup/Grad-School/Ear Surgery Instruments/Wrist Tool Assembly/superceded/slider print 01-Nov-2017/slider v-3 01-Nov-2017.STL

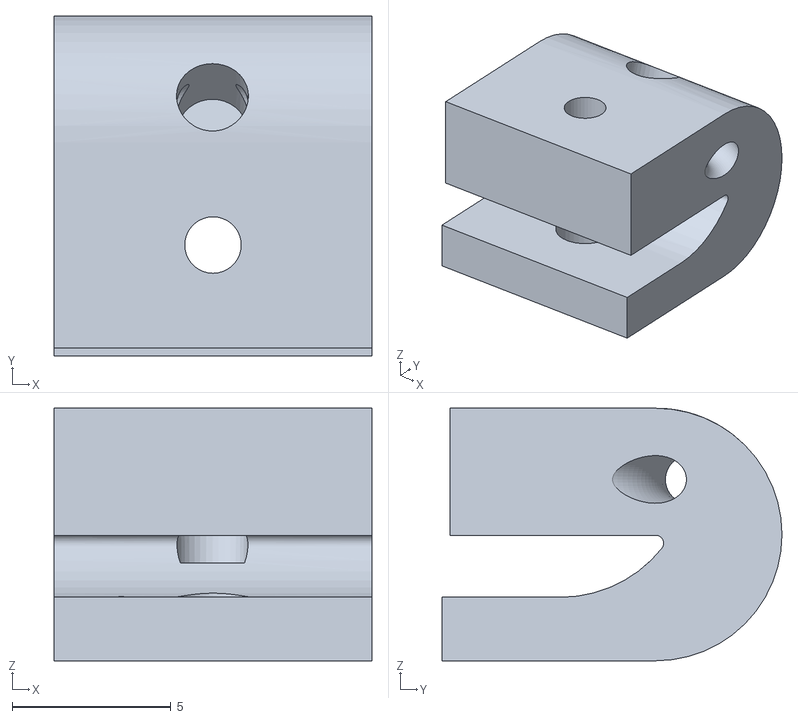
[picture p293: CAD file, 2018-02-12]
Ear Surgery Instruments/Wrist Tool Assembly/superceded/slider print 01-Nov-2017/slider v-3 01-Nov-2017.STL
10.0 x 10.7 x 7.95
