arushriswarup/Grad-School/Ear Surgery Instruments/Wrist Tool Assembly/superceded/slider print 02-Nov-2017/slider v-4 02-Nov-2017.STL

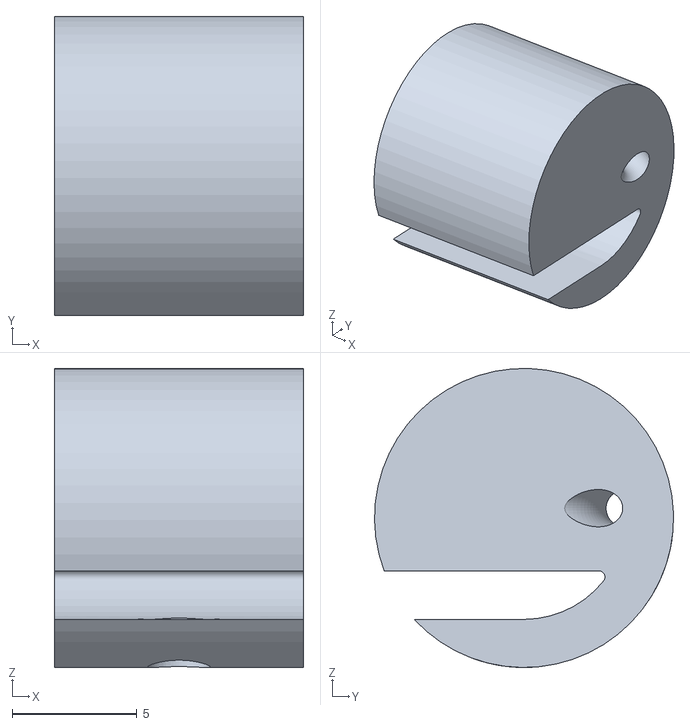
[picture p294: CAD file, 2018-02-12]
Ear Surgery Instruments/Wrist Tool Assembly/superceded/slider print 02-Nov-2017/slider v-4 02-Nov-2017.STL
10.0 x 12.0 x 12.0
