arushriswarup/Grad-School/Ear Surgery Instruments/Wrist Tool Assembly/superceded/slider print 06-Nov-2017/slider v-5 06-Nov-2017_b.STL

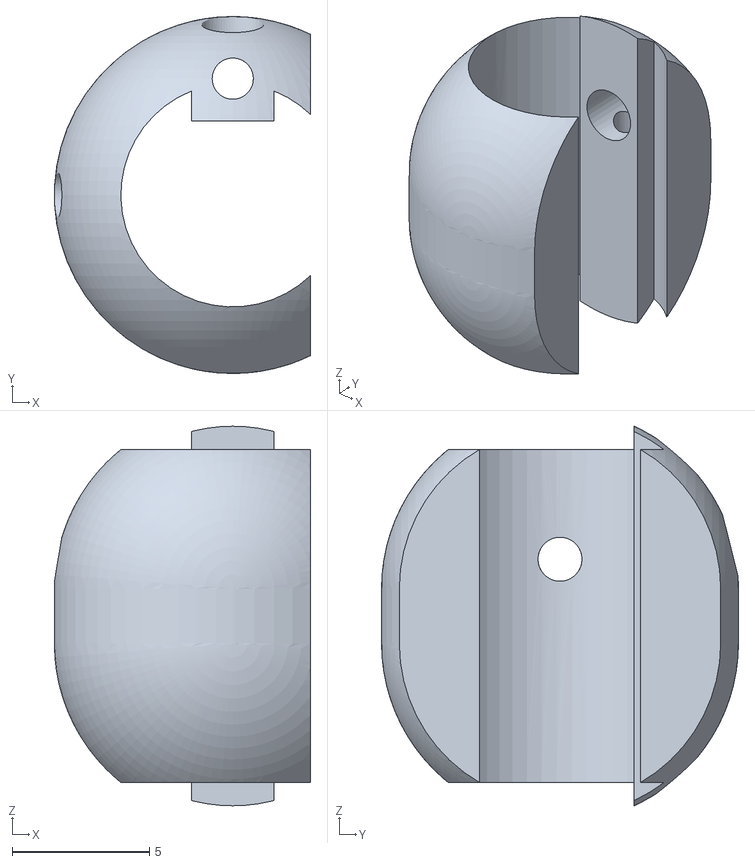
[picture p295: CAD file, 2018-02-12]
Ear Surgery Instruments/Wrist Tool Assembly/superceded/slider print 06-Nov-2017/slider v-5 06-Nov-2017_b.STL
9.33 x 13.0 x 13.8
