arushriswarup/Grad-School/Ear Surgery Instruments/Wrist Tool Assembly/superceded/to print 22-Aug-2017/wire exit path v-2 23-Mar-2017.STL

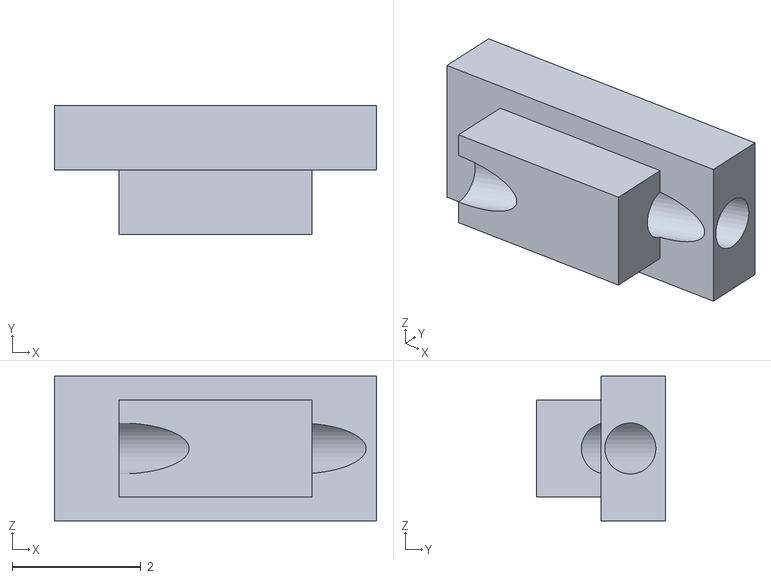
[picture p297: CAD file, 2017-11-13]
Ear Surgery Instruments/Wrist Tool Assembly/superceded/to print 22-Aug-2017/wire exit path v-2 23-Mar-2017.STL
5.00 x 2.00 x 2.25
