arushriswarup/Grad-School/Ear Surgery Instruments/Wrist Tool Assembly/superceded/wheel_handle_body_A v-2 20-Mar-2017.SLDPRT

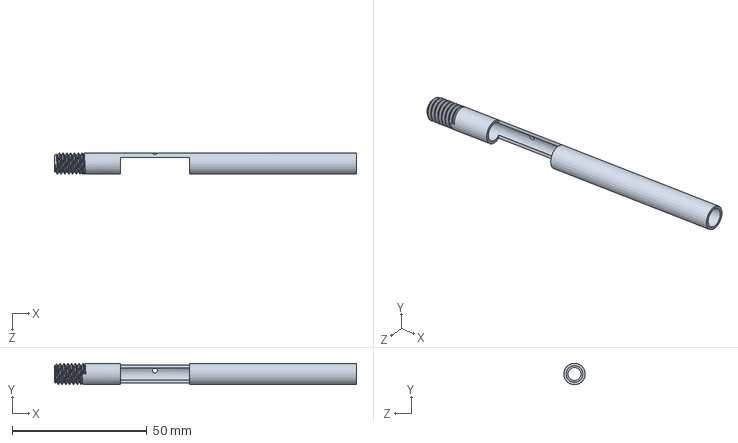
[picture p298: CAD file, 2018-02-12]
Ear Surgery Instruments/Wrist Tool Assembly/superceded/wheel_handle_body_A v-2 20-Mar-2017.SLDPRT
112.0 x 7.94 x 7.94 mm
