arushriswarup/Grad-School/Hamlyn/CAD_for_pin_joint/stainless steel tube_pin joint.SLDPRT

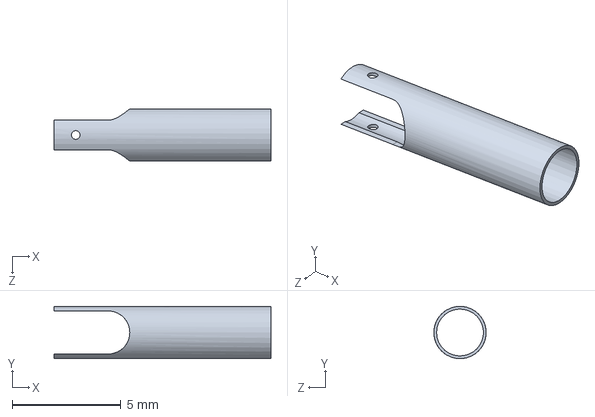
[picture p300: CAD file, 2017-11-13]
Hamlyn/CAD_for_pin_joint/stainless steel tube_pin joint.SLDPRT
10.0 x 2.41 x 2.41 mm
