arushriswarup/Grad-School/Tools/Rosen Needle Mold.SLDPRT

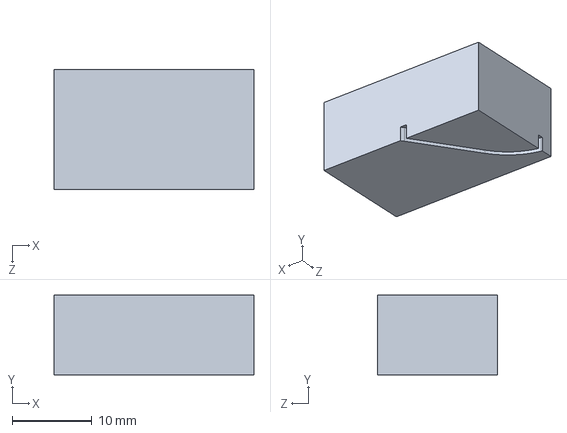
[picture p301: CAD file, 2018-01-30]
Tools/Rosen Needle Mold.SLDPRT
25.0 x 10.0 x 15.0 mm
