arushriswarup/Grad-School/Tools/tube clamp form print/Tube Clamp 1 mm top.STL

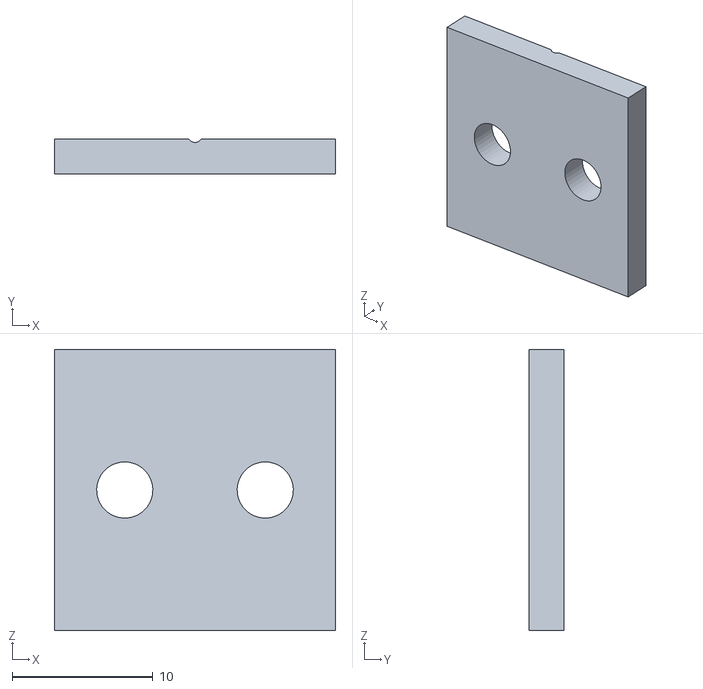
[picture p302: CAD file, 2017-11-13]
Tools/tube clamp form print/Tube Clamp 1 mm top.STL
20.0 x 2.50 x 20.0
