arushriswarup/Grad-School/3D Models/anatomy stls/patient1720/temporal bone axial crop_4.stl

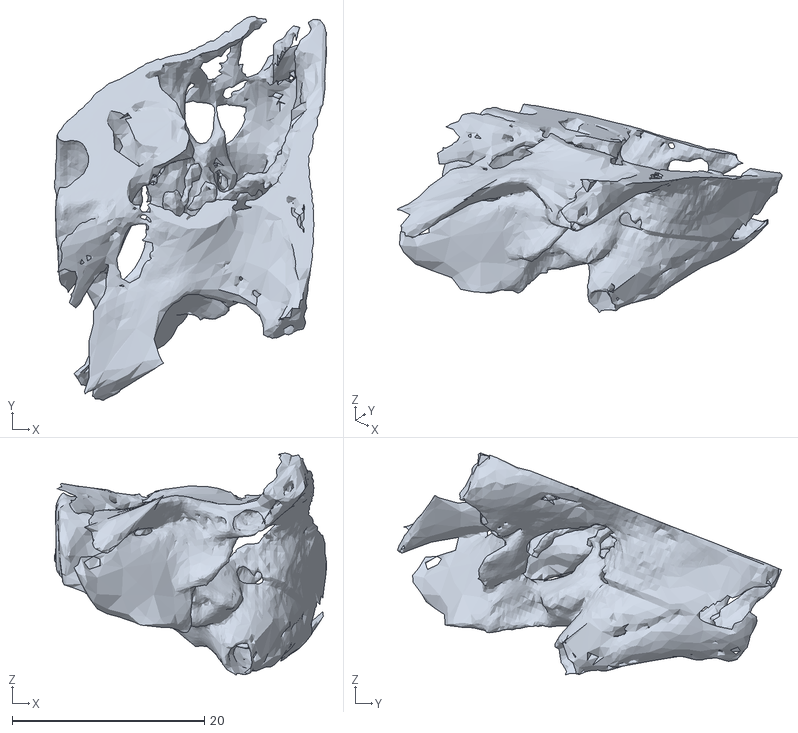
[picture p303: CAD file, 2017-11-13]
3D Models/anatomy stls/patient1720/temporal bone axial crop_4.stl
28.4 x 40.0 x 23.1
