arushriswarup/Grad-School/3D Models/anatomy stls/stand.STL

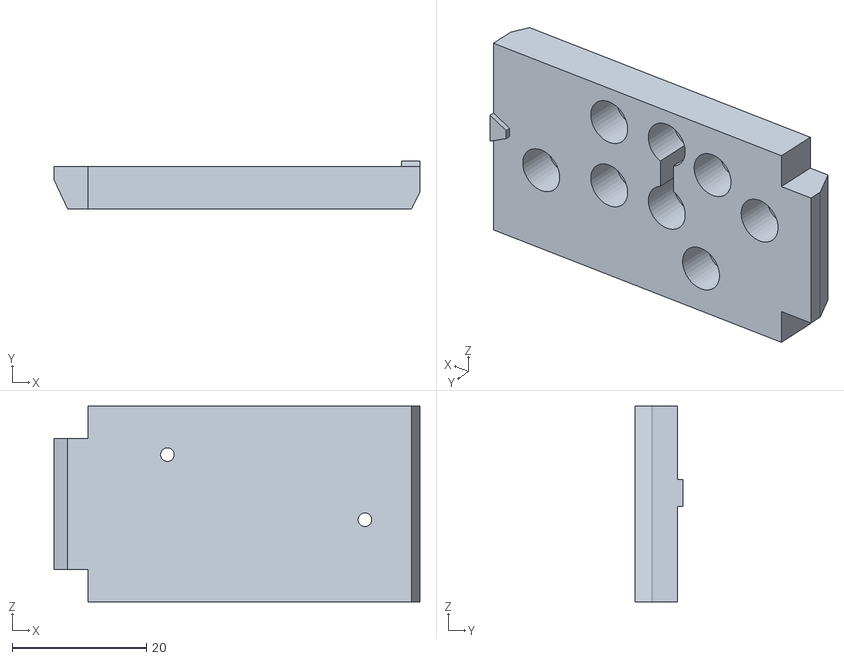
[picture p304: CAD file, 2017-11-13]
3D Models/anatomy stls/stand.STL
54.6 x 7.11 x 29.2
