arushriswarup/Grad-School/Ear Surgery Instruments/ear drum instruments/ear drum tool tip 1.16mm.SLDPRT

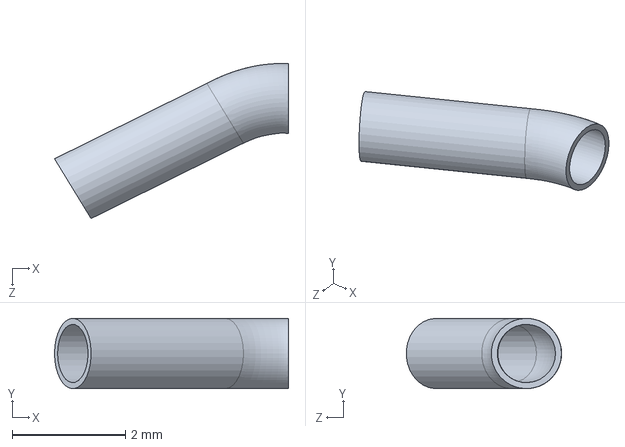
[picture p305: CAD file, 2017-11-13]
Ear Surgery Instruments/ear drum instruments/ear drum tool tip 1.16mm.SLDPRT
4.13 x 1.24 x 2.74 mm
