arushriswarup/Grad-School/Ear Surgery Instruments/Wrist Tool Assembly/Clinical Tool/Handle M7 shallow threads for 3d printing_test.STL

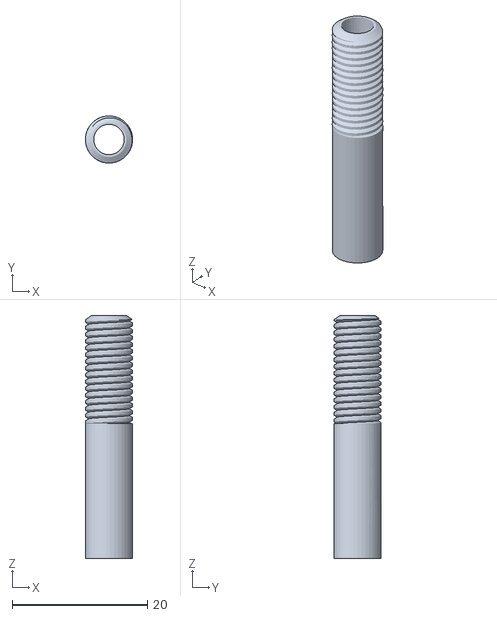
[picture p306: CAD file, 2018-02-27]
Ear Surgery Instruments/Wrist Tool Assembly/Clinical Tool/Handle M7 shallow threads for 3d printing_test.STL
7.00 x 7.00 x 36.0
