arushriswarup/Grad-School/Ear Surgery Instruments/Wrist Tool Assembly/superceded/Clinical Tool/superceded/handle.SLDPRT

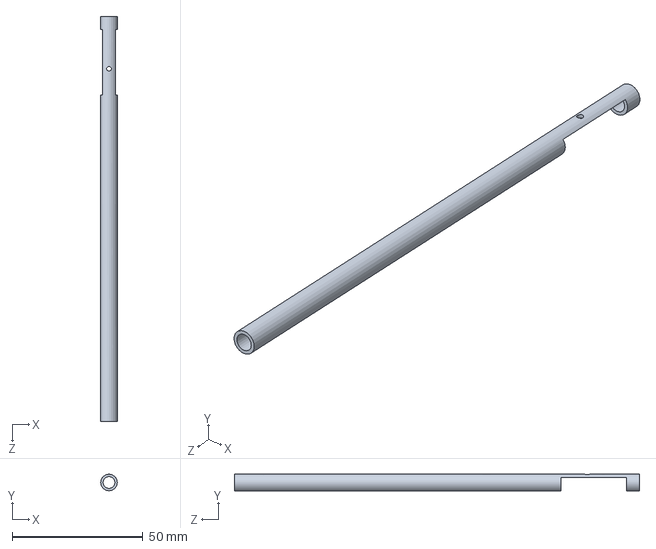
[picture p307: CAD file, 2018-02-12]
Ear Surgery Instruments/Wrist Tool Assembly/superceded/Clinical Tool/superceded/handle.SLDPRT
6.35 x 6.35 x 155.0 mm
