arushriswarup/Grad-School/Ear Surgery Instruments/Wrist Tool Assembly/superceded/form print testing wedge force 01-Aug-2017/wedge v-3 01-Aug-2017_8mm.STL

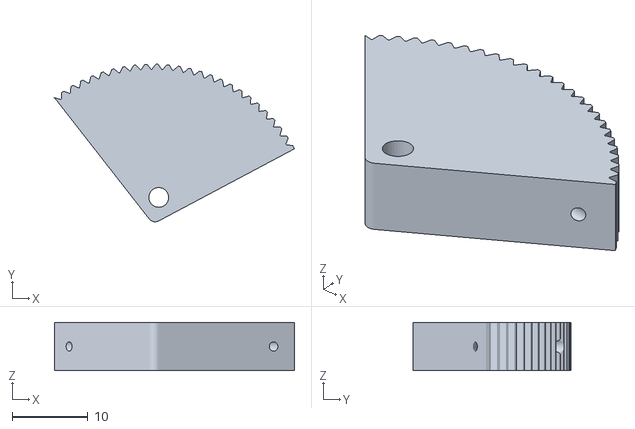
[picture p308: CAD file, 2017-11-13]
Ear Surgery Instruments/Wrist Tool Assembly/superceded/form print testing wedge force 01-Aug-2017/wedge v-3 01-Aug-2017_8mm.STL
31.7 x 20.8 x 6.35
