arushriswarup/Grad-School/Ear Surgery Instruments/Wrist Tool Assembly/superceded/print 22-Nov-2017/slider v-6 22-Nov-2017_a.STL

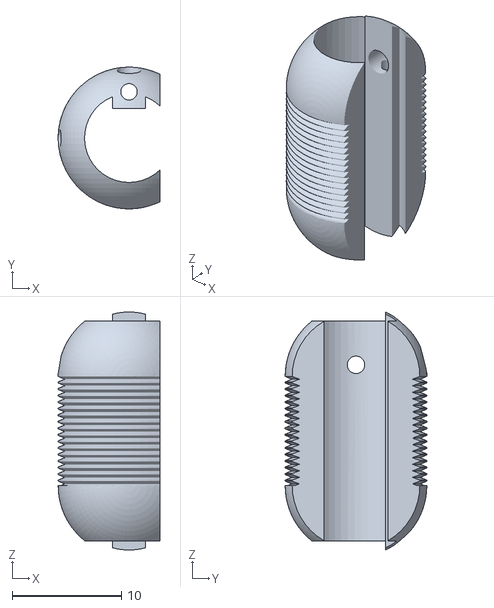
[picture p309: CAD file, 2018-02-12]
Ear Surgery Instruments/Wrist Tool Assembly/superceded/print 22-Nov-2017/slider v-6 22-Nov-2017_a.STL
9.33 x 13.0 x 21.8
