arushriswarup/Grad-School/Ear Surgery Instruments/Wrist Tool Assembly/superceded/print 23-Nov-2017/slider v-7 23-Nov-2017.STL

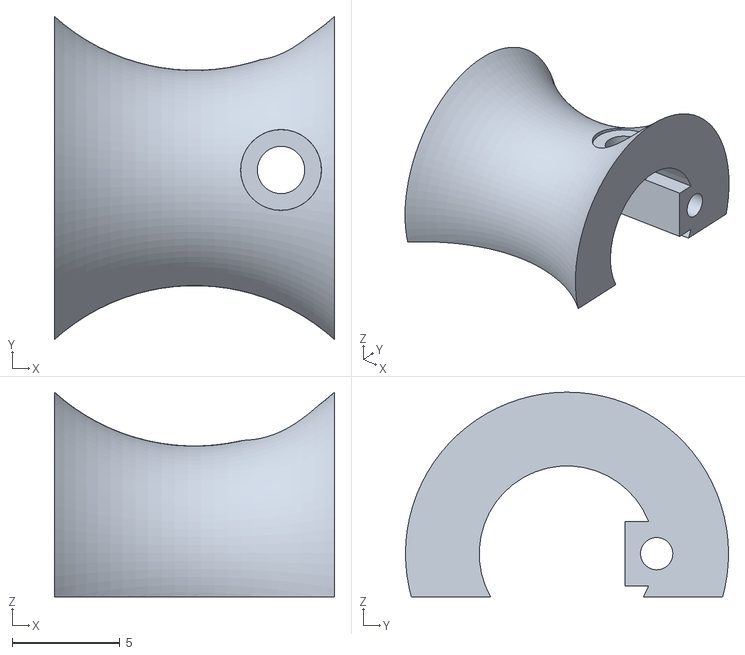
[picture p310: CAD file, 2018-02-12]
Ear Surgery Instruments/Wrist Tool Assembly/superceded/print 23-Nov-2017/slider v-7 23-Nov-2017.STL
13.0 x 15.0 x 9.50
