arushriswarup/Grad-School/Ear Surgery Instruments/Wrist Tool Assembly/superceded/prints/form print 20 mar 2017/wire exit path v-1 17-Mar-2017.STL

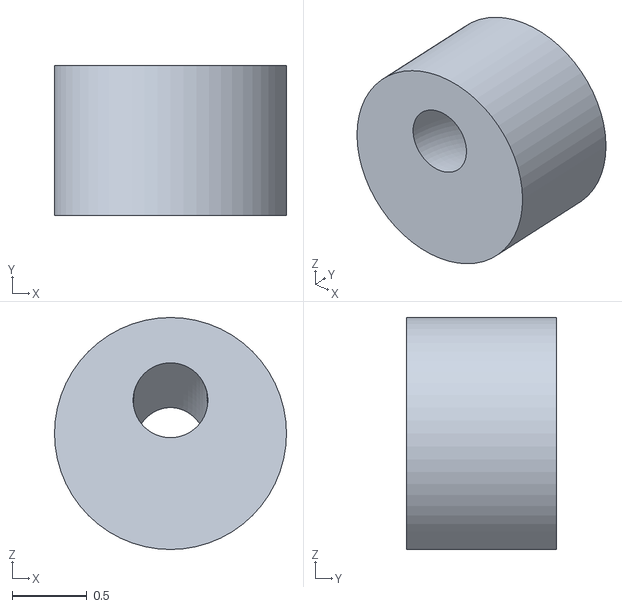
[picture p311: CAD file, 2017-11-13]
Ear Surgery Instruments/Wrist Tool Assembly/superceded/prints/form print 20 mar 2017/wire exit path v-1 17-Mar-2017.STL
1.55 x 1 x 1.55
