arushriswarup/Grad-School/Ear Surgery Instruments/Wrist Tool Assembly/superceded/prints/form print 27-mar-2017/wedge v-1 23-Mar-2017.SLDPRT

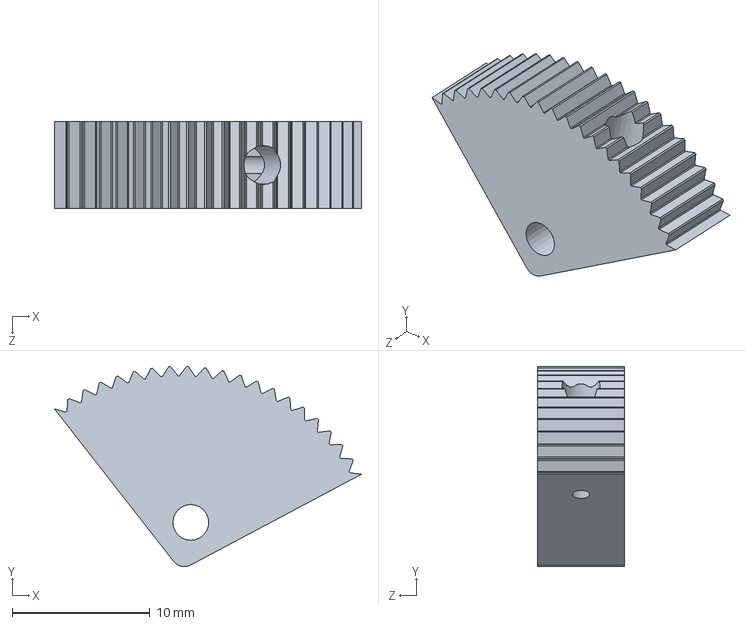
[picture p312: CAD file, 2017-11-13]
Ear Surgery Instruments/Wrist Tool Assembly/superceded/prints/form print 27-mar-2017/wedge v-1 23-Mar-2017.SLDPRT
22.3 x 14.5 x 6.35 mm
