arushriswarup/Grad-School/Ear Surgery Instruments/Wrist Tool Assembly/superceded/slider print 01-Nov-2017/wheel_handle_body_slider v-3 01-Nov-2017.STL

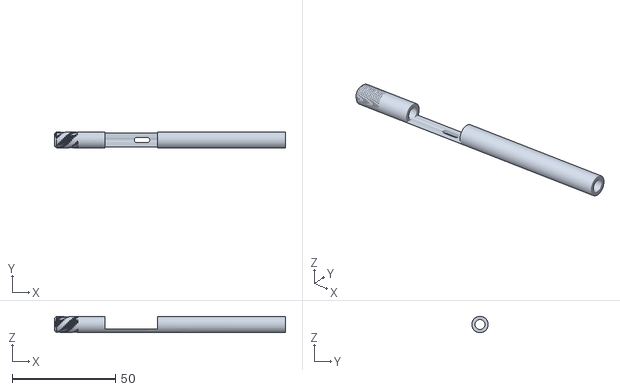
[picture p313: CAD file, 2018-02-12]
Ear Surgery Instruments/Wrist Tool Assembly/superceded/slider print 01-Nov-2017/wheel_handle_body_slider v-3 01-Nov-2017.STL
112.0 x 7.94 x 7.94
