arushriswarup/Grad-School/Ear Surgery Instruments/Wrist Tool Assembly/superceded/slider print 30-Oct-2017/slider v-2 27-oct-2017.STL

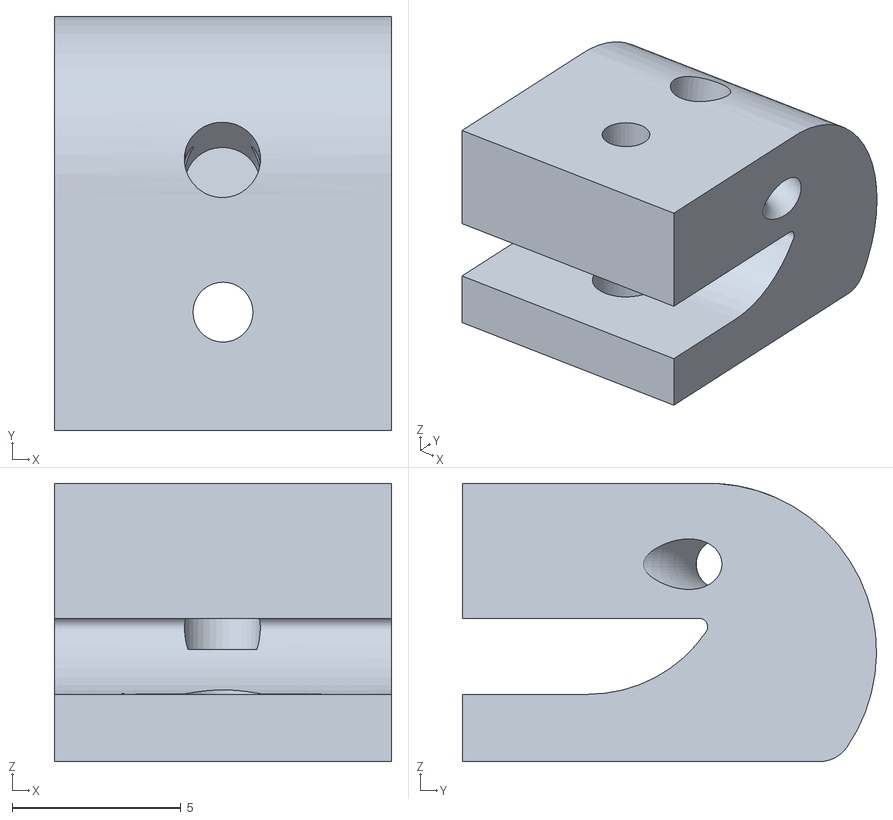
[picture p314: CAD file, 2018-02-12]
Ear Surgery Instruments/Wrist Tool Assembly/superceded/slider print 30-Oct-2017/slider v-2 27-oct-2017.STL
10.0 x 12.3 x 8.26
