arushriswarup/Grad-School/Ear Surgery Instruments/Wrist Tool Assembly/Wristed Cuts/80deg CCM V-1 Wrist left.SLDPRT

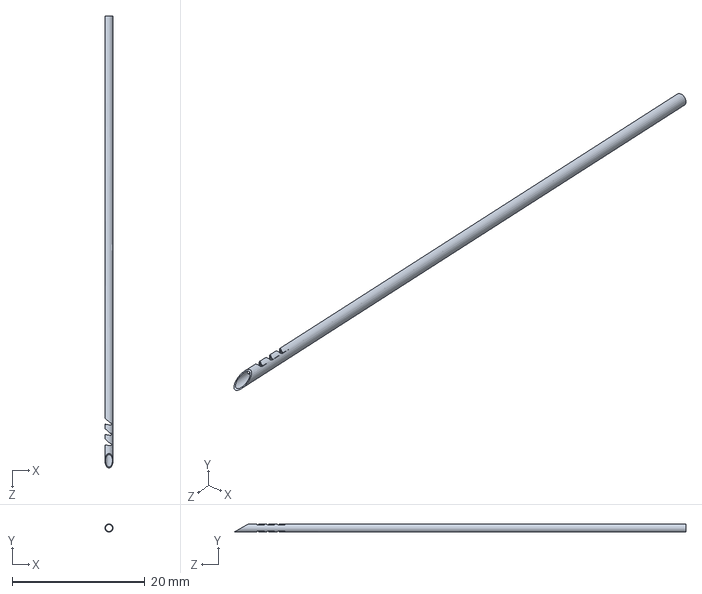
[picture p315: CAD file, 2018-02-12]
Ear Surgery Instruments/Wrist Tool Assembly/Wristed Cuts/80deg CCM V-1 Wrist left.SLDPRT
1.24 x 1.24 x 68.0 mm
