arushriswarup/Grad-School/Ear Surgery Instruments/Wrist Tool Assembly/Wristed Cuts/Preco Feb-2018/80deg CCM V-1 Wrist left 10mm rc.STEP

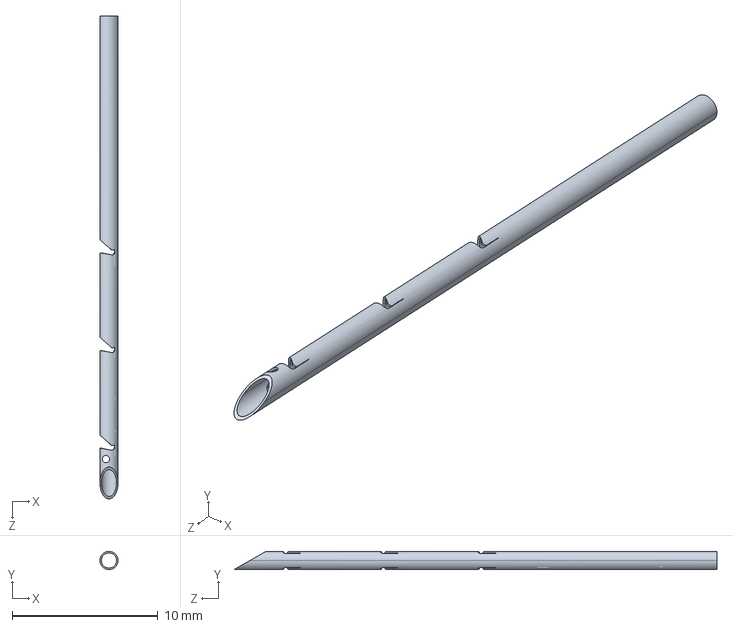
[picture p316: CAD file, 2018-02-06]
Ear Surgery Instruments/Wrist Tool Assembly/Wristed Cuts/Preco Feb-2018/80deg CCM V-1 Wrist left 10mm rc.STEP
1.24 x 1.24 x 33.1 mm
