arushriswarup/Grad-School/Hamlyn/CAD/tube.SLDPRT

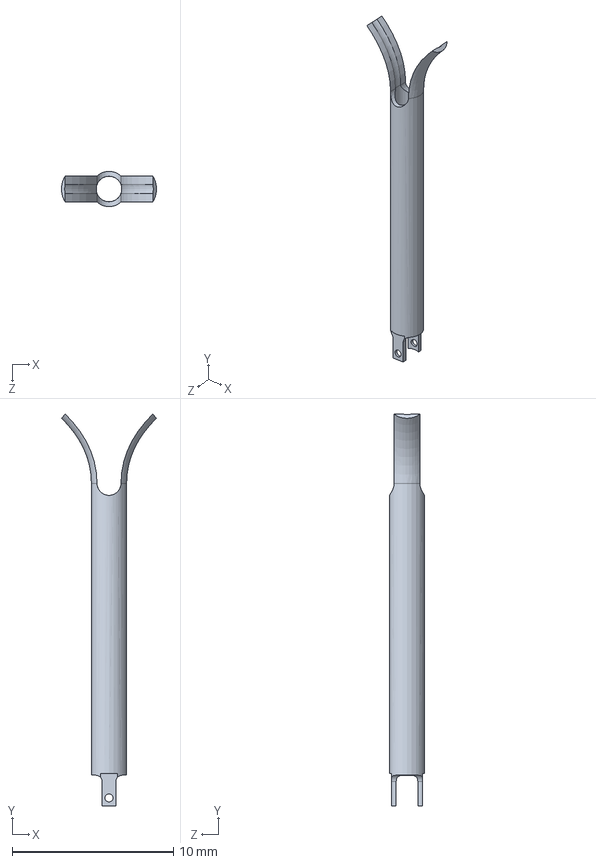
[picture p317: CAD file, 2017-11-13]
Hamlyn/CAD/tube.SLDPRT
5.88 x 24.3 x 2.18 mm
