arushriswarup/Grad-School/Hamlyn/CAD_for_pin_joint/pin.SLDPRT

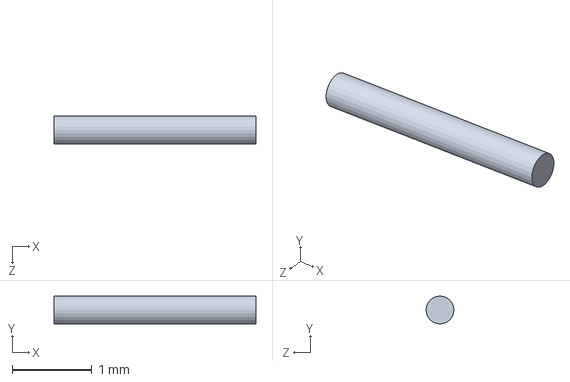
[picture p318: CAD file, 2017-11-13]
Hamlyn/CAD_for_pin_joint/pin.SLDPRT
2.54 x 0.35 x 0.35 mm
