arushriswarup/Grad-School/3D Models/anatomy stls/patient1720/temporal bone axial crop v-3 06-Apr-2017.stl

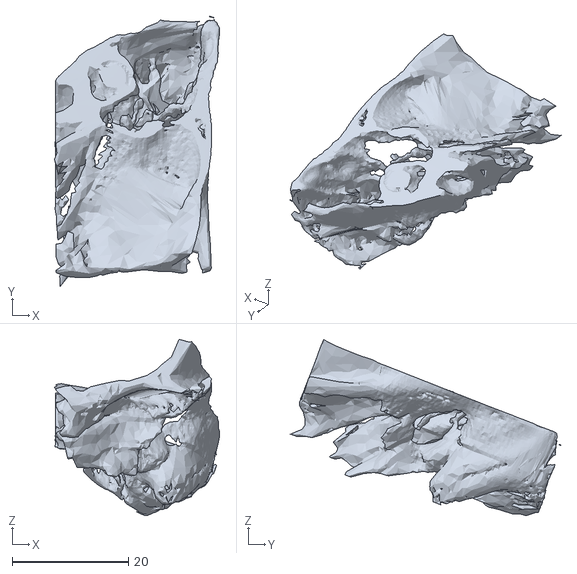
[picture p319: CAD file, 2017-11-13]
3D Models/anatomy stls/patient1720/temporal bone axial crop v-3 06-Apr-2017.stl
28.4 x 46.4 x 30.2
