arushriswarup/Grad-School/Ear Surgery Instruments/Wrist Tool Assembly/New Handle Dec-2017/handle shaft connector.SLDPRT

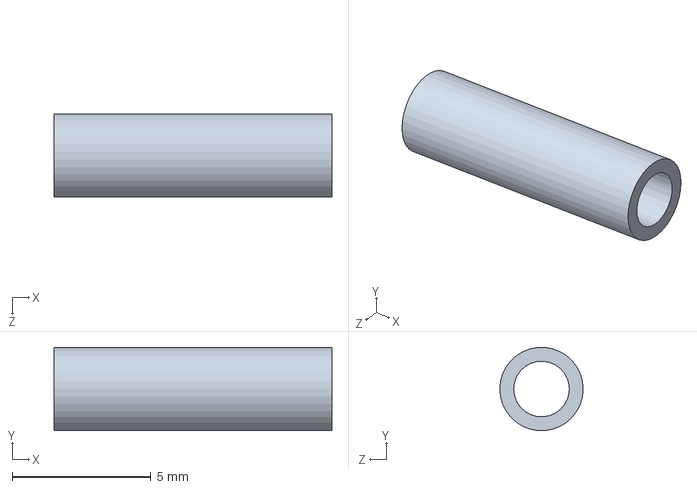
[picture p320: CAD file, 2018-02-12]
Ear Surgery Instruments/Wrist Tool Assembly/New Handle Dec-2017/handle shaft connector.SLDPRT
10.0 x 2.99 x 3.00 mm
