arushriswarup/Grad-School/Ear Surgery Instruments/Wrist Tool Assembly/superceded/form print testing wedge force 01-Aug-2017/wedge v-3 01-Aug-2017_6mm.SLDPRT

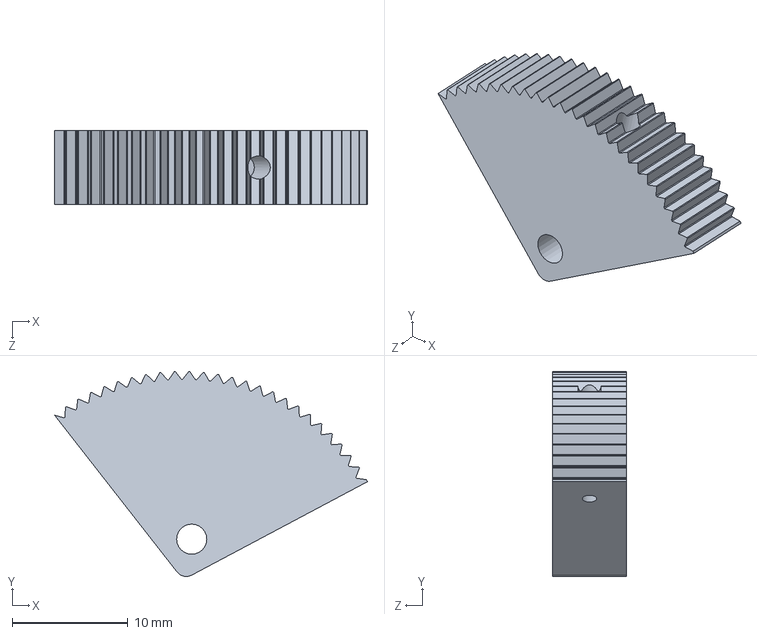
[picture p321: CAD file, 2017-11-13]
Ear Surgery Instruments/Wrist Tool Assembly/superceded/form print testing wedge force 01-Aug-2017/wedge v-3 01-Aug-2017_6mm.SLDPRT
27.0 x 17.7 x 6.35 mm
