arushriswarup/Grad-School/Ear Surgery Instruments/Wrist Tool Assembly/superceded/print 22-Nov-2017/slider v-6 22-Nov-2017_b.STL

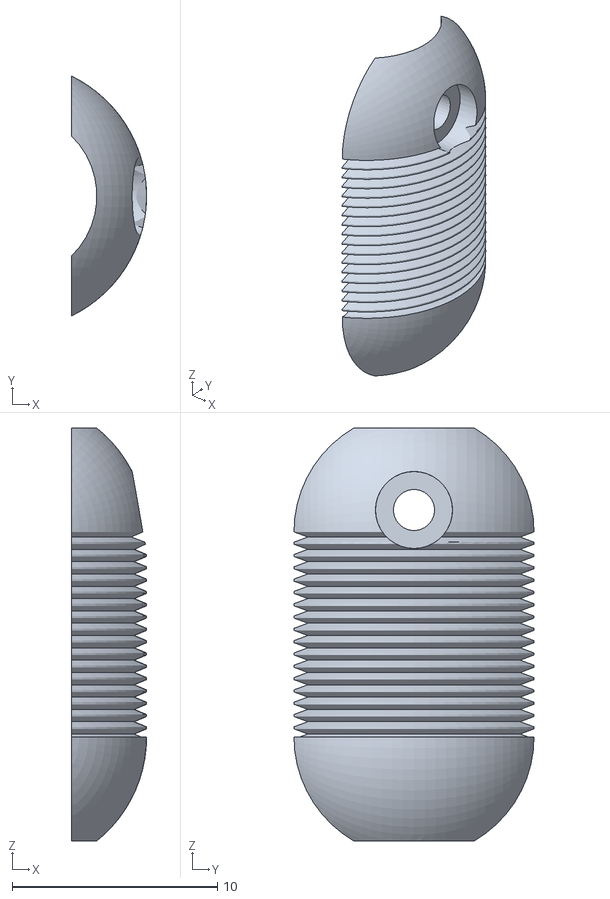
[picture p322: CAD file, 2018-02-12]
Ear Surgery Instruments/Wrist Tool Assembly/superceded/print 22-Nov-2017/slider v-6 22-Nov-2017_b.STL
3.67 x 11.7 x 20.1
