arushriswarup/Grad-School/Ear Surgery Instruments/Wrist Tool Assembly/superceded/prints/form print 20 mar 2017/tubing to luer coupler.STL

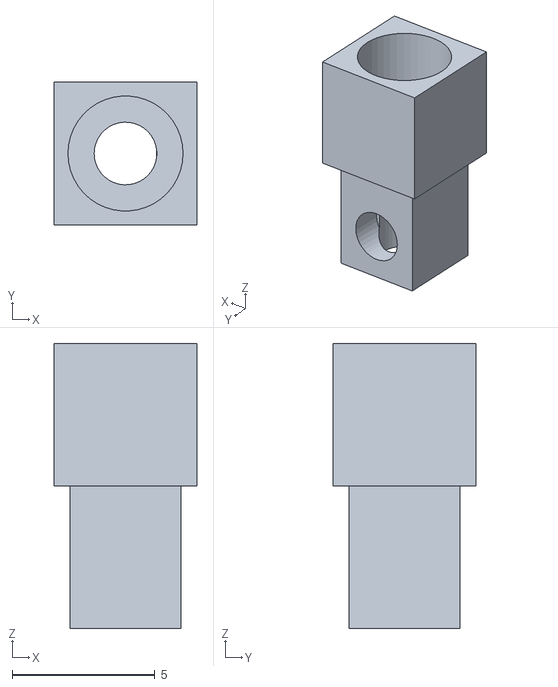
[picture p323: CAD file, 2017-11-13]
Ear Surgery Instruments/Wrist Tool Assembly/superceded/prints/form print 20 mar 2017/tubing to luer coupler.STL
5.00 x 5.00 x 10.0
