arushriswarup/Grad-School/Ear Surgery Instruments/Wrist Tool Assembly/superceded/slider print 06-Nov-2017/slider v-5 06-Nov-2017_a.STL

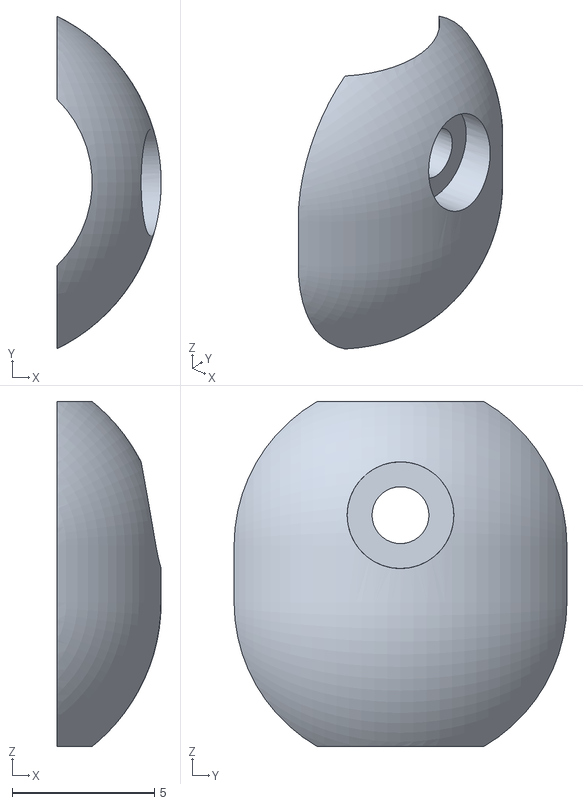
[picture p324: CAD file, 2018-02-12]
Ear Surgery Instruments/Wrist Tool Assembly/superceded/slider print 06-Nov-2017/slider v-5 06-Nov-2017_a.STL
3.67 x 11.7 x 12.1
