arushriswarup/Grad-School/Ear Surgery Instruments/Wrist Tool Assembly/Wristed Cuts/Preco Feb-2018/135deg CCM V-1 Wrist left.STEP

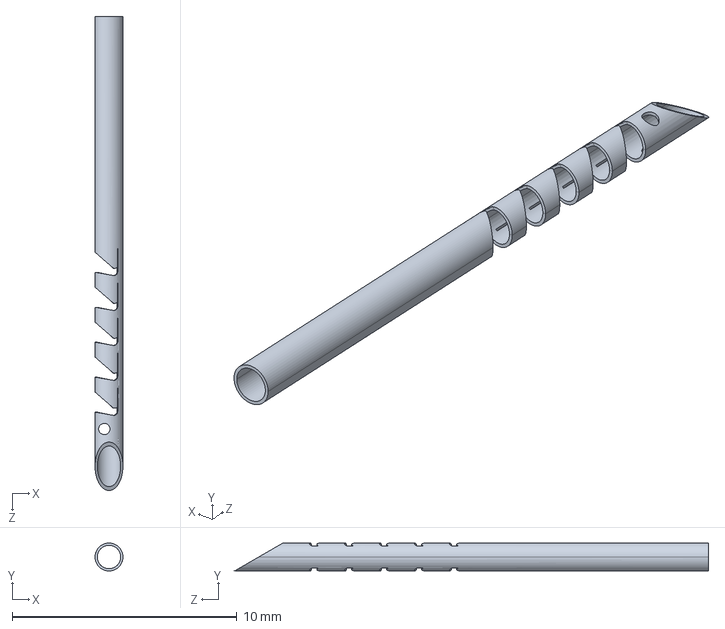
[picture p325: CAD file, 2018-02-06]
Ear Surgery Instruments/Wrist Tool Assembly/Wristed Cuts/Preco Feb-2018/135deg CCM V-1 Wrist left.STEP
1.24 x 1.24 x 21.1 mm
