arushriswarup/Grad-School/Hamlyn/CAD/stainless steel tube_pin joint.SLDPRT

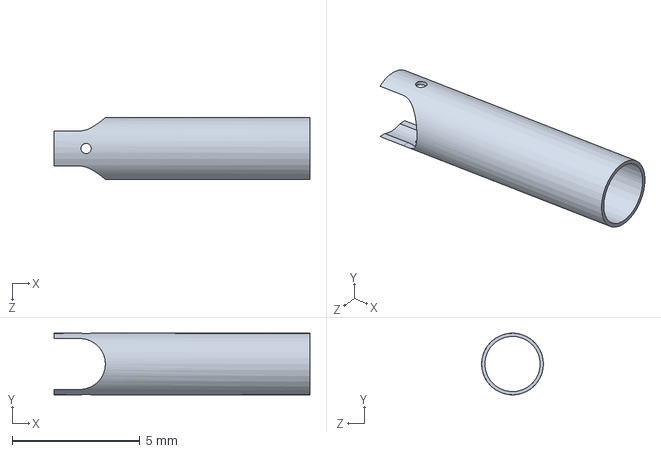
[picture p326: CAD file, 2017-11-13]
Hamlyn/CAD/stainless steel tube_pin joint.SLDPRT
10.0 x 2.41 x 2.41 mm
