arushriswarup/Grad-School/Hamlyn/CAD_for_pin_joint/tube.SLDPRT

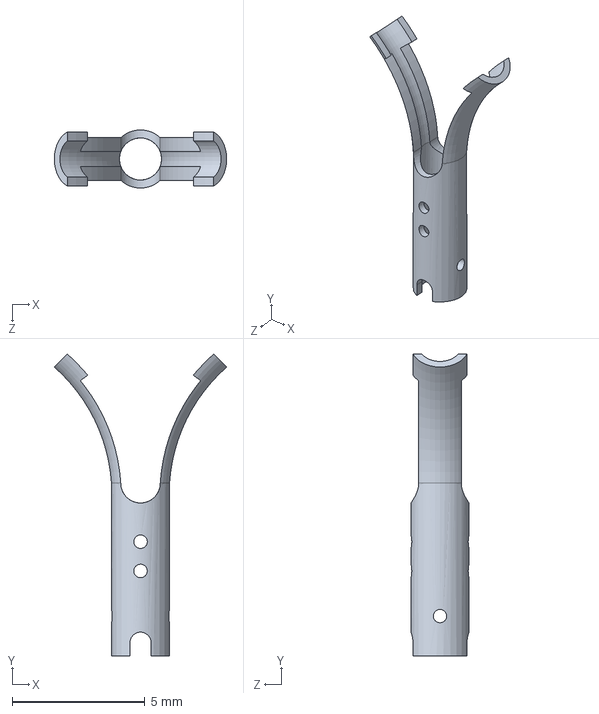
[picture p327: CAD file, 2017-11-13]
Hamlyn/CAD_for_pin_joint/tube.SLDPRT
6.49 x 11.4 x 2.18 mm
