arushriswarup/Grad-School/Tools/Larger tube clamp.SLDPRT

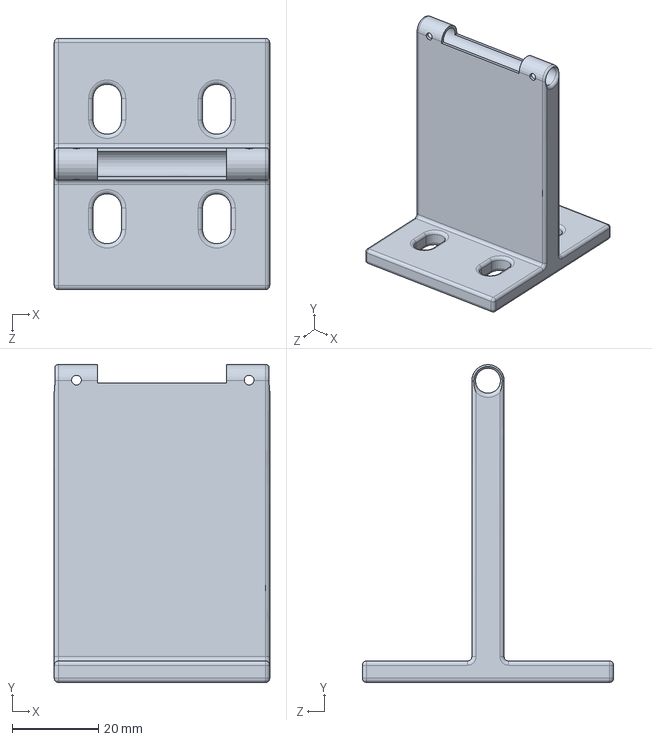
[picture p328: CAD file, 2018-01-30]
Tools/Larger tube clamp.SLDPRT
50.0 x 73.8 x 58.3 mm
