arushriswarup/Grad-School/3D Models/anatomy stls/patient1720/temporal bone axial crop_3.stl

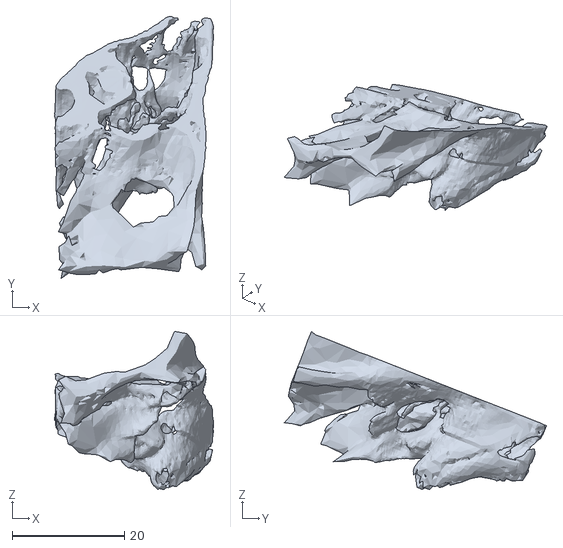
[picture p329: CAD file, 2017-11-13]
3D Models/anatomy stls/patient1720/temporal bone axial crop_3.stl
28.4 x 46.7 x 28.2
