arushriswarup/Grad-School/3D Models/Panetti left with tip reach volume.SLDPRT

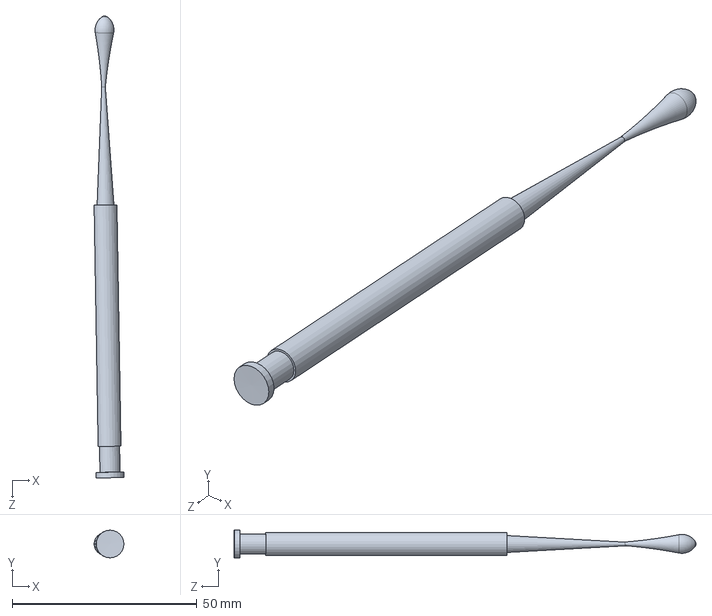
[picture p330: CAD file, 2017-11-13]
3D Models/Panetti left with tip reach volume.SLDPRT
8.08 x 7.50 x 125.1 mm
