arushriswarup/Grad-School/Ear Surgery Instruments/Wrist Tool Assembly/superceded/Clinical Tool/135deg CCM V-1 Wrist left.SLDPRT

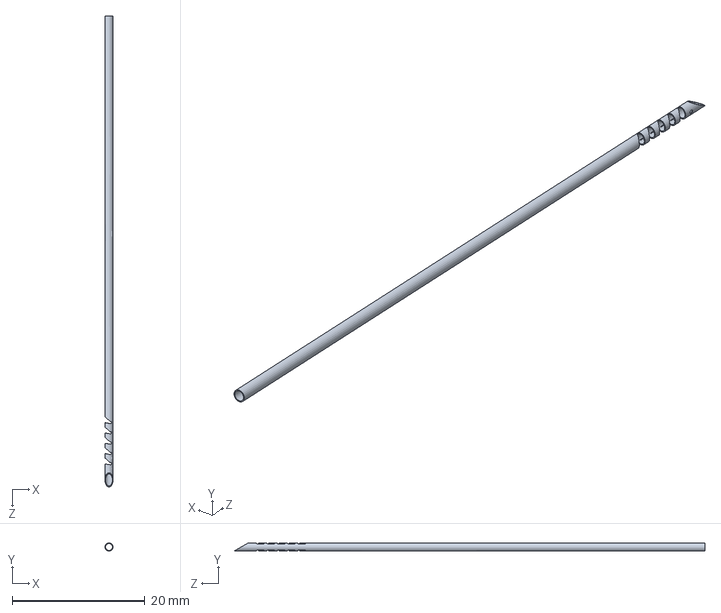
[picture p331: CAD file, 2018-02-12]
Ear Surgery Instruments/Wrist Tool Assembly/superceded/Clinical Tool/135deg CCM V-1 Wrist left.SLDPRT
1.24 x 1.24 x 71.1 mm
