arushriswarup/Grad-School/Ear Surgery Instruments/Wrist Tool Assembly/superceded/prints/form print 20 mar 2017/wheel_handle_body_A v-2 20-Mar-2017.STL

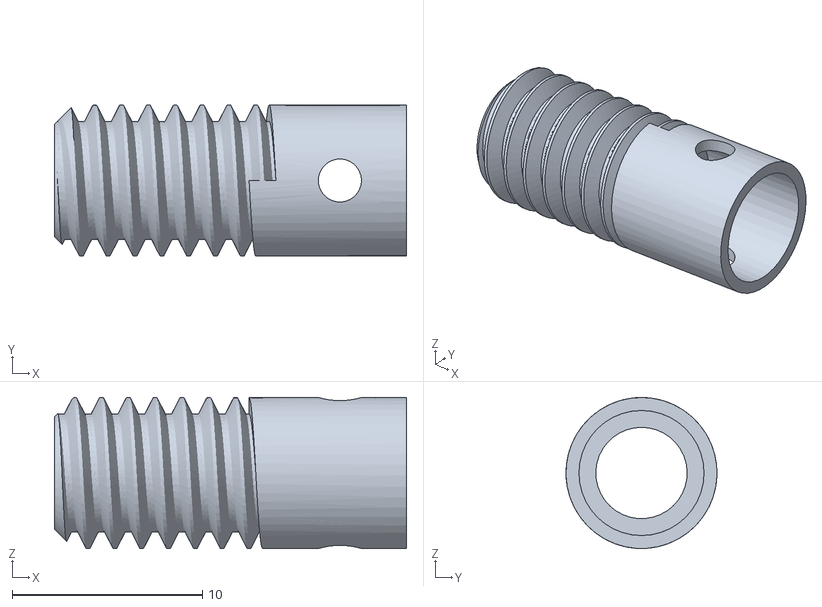
[picture p332: CAD file, 2017-11-13]
Ear Surgery Instruments/Wrist Tool Assembly/superceded/prints/form print 20 mar 2017/wheel_handle_body_A v-2 20-Mar-2017.STL
18.5 x 7.94 x 7.94
