arushriswarup/Grad-School/Ear Surgery Instruments/Wrist Tool Assembly/superceded/wheel_handle_body.SLDPRT

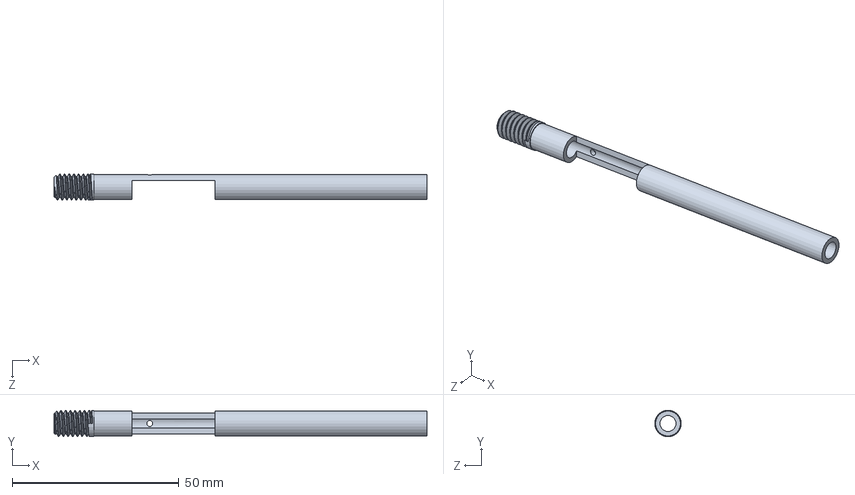
[picture p333: CAD file, 2017-11-13]
Ear Surgery Instruments/Wrist Tool Assembly/superceded/wheel_handle_body.SLDPRT
112.0 x 7.94 x 7.94 mm
