arushriswarup/Grad-School/Ear Surgery Instruments/Wrist Tool Assembly/Wristed Cuts/135 deg Gear Tooth V-2 Wrist right.SLDPRT

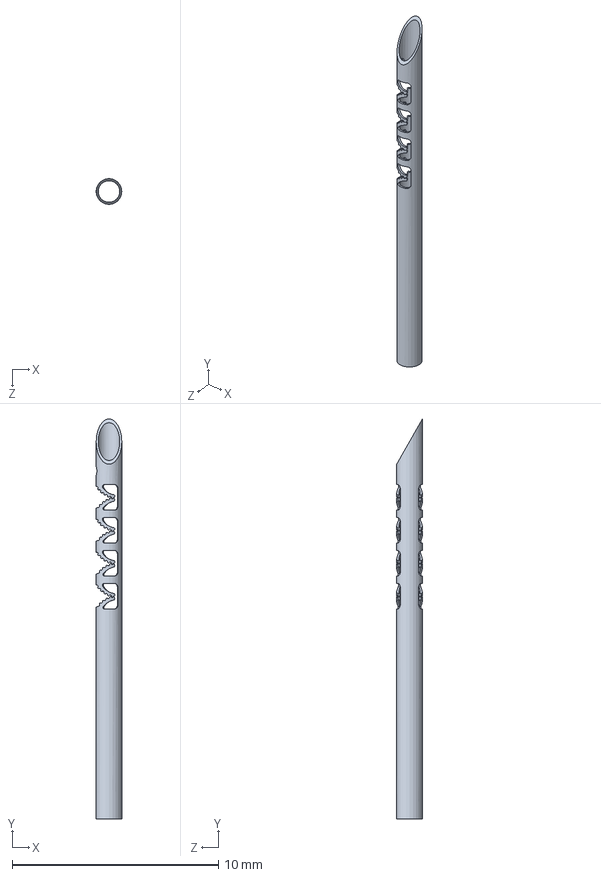
[picture p334: CAD file, 2017-12-21]
Ear Surgery Instruments/Wrist Tool Assembly/Wristed Cuts/135 deg Gear Tooth V-2 Wrist right.SLDPRT
1.24 x 19.4 x 1.24 mm
