arushriswarup/Grad-School/Hamlyn/CAD/tip_small_v3.SLDPRT

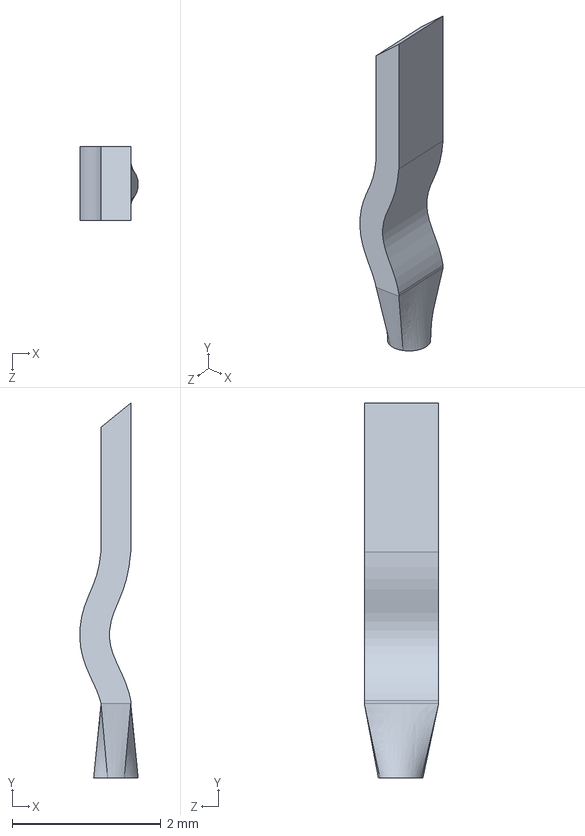
[picture p335: CAD file, 2017-11-13]
Hamlyn/CAD/tip_small_v3.SLDPRT
0.785 x 5.04 x 1.00 mm
