arushriswarup/Grad-School/Tools/linear stage cable clamp.SLDPRT

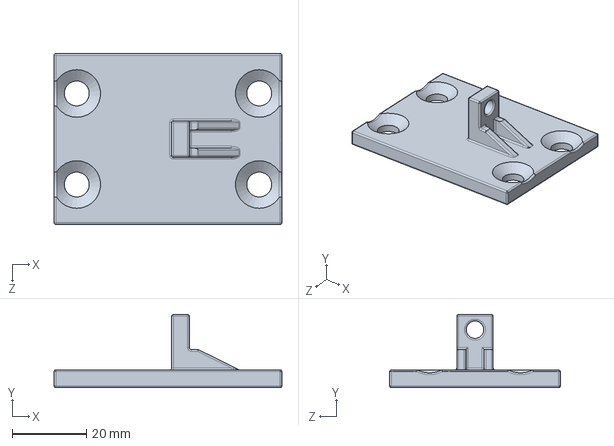
[picture p336: CAD file, 2018-01-30]
Tools/linear stage cable clamp.SLDPRT
61.6 x 19.8 x 46.2 mm
