arushriswarup/Grad-School/3D Models/endoscope viewing range.SLDPRT

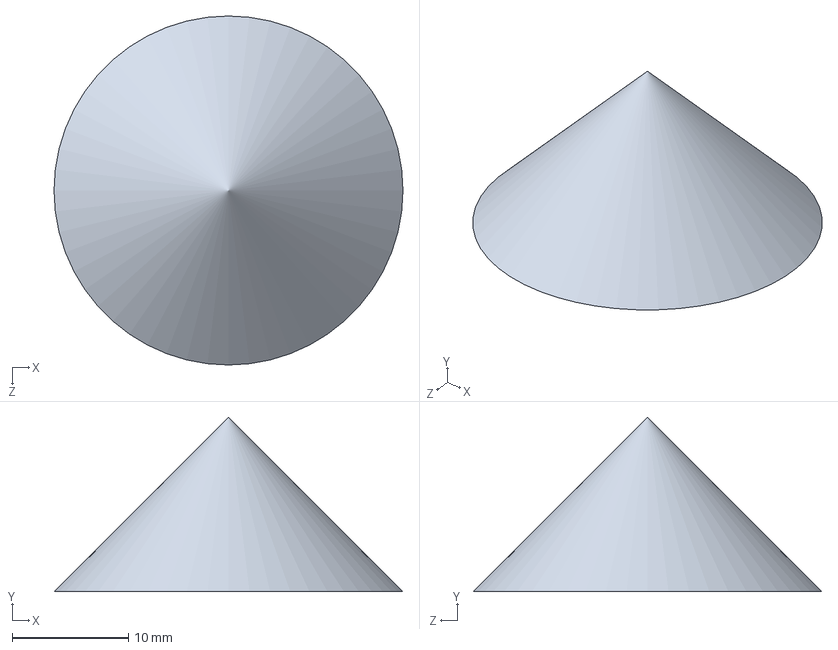
[picture p337: CAD file, 2017-11-13]
3D Models/endoscope viewing range.SLDPRT
30.0 x 15.0 x 30.0 mm
