arushriswarup/Grad-School/Ear Surgery Instruments/Wrist Tool Assembly/New Handle Dec-2017/Arushri_Tube_SquareJoint_curve 1.SLDPRT

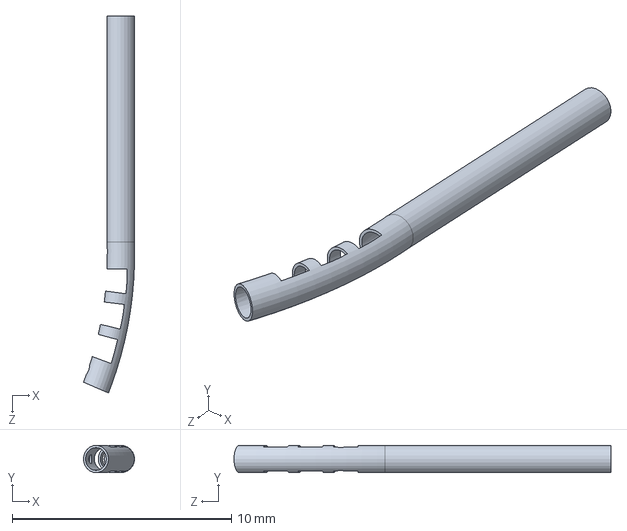
[picture p338: CAD file, 2018-02-12]
Ear Surgery Instruments/Wrist Tool Assembly/New Handle Dec-2017/Arushri_Tube_SquareJoint_curve 1.SLDPRT
2.33 x 1.24 x 17.2 mm
