arushriswarup/Grad-School/Ear Surgery Instruments/Wrist Tool Assembly/superceded/Clinical Tool/collet.SLDPRT

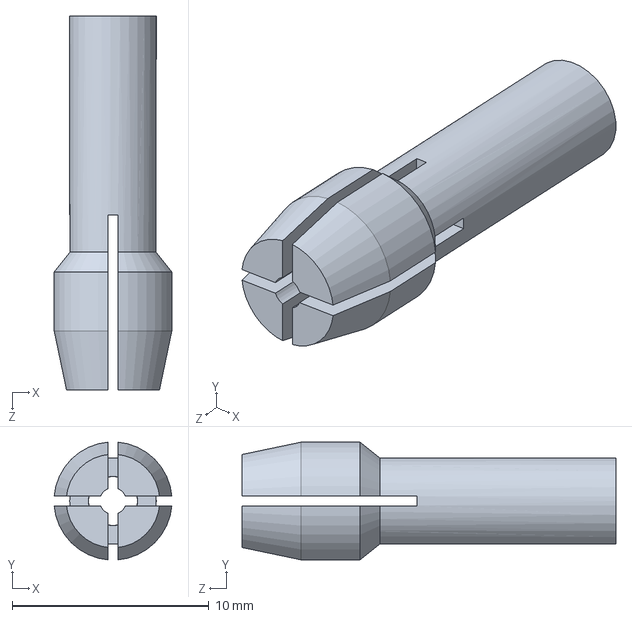
[picture p339: CAD file, 2018-02-12]
Ear Surgery Instruments/Wrist Tool Assembly/superceded/Clinical Tool/collet.SLDPRT
5.98 x 5.98 x 19.0 mm
