arushriswarup/Grad-School/Tools/force gauge laser spot connector.SLDPRT

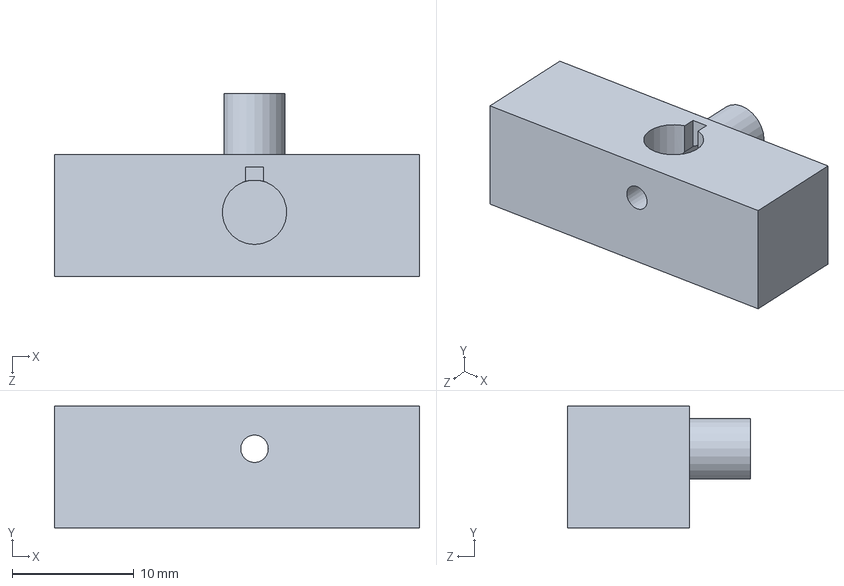
[picture p340: CAD file, 2018-01-30]
Tools/force gauge laser spot connector.SLDPRT
30.0 x 10.0 x 15.0 mm
