arushriswarup/Grad-School/Ear Surgery Instruments/ear drum instruments/BLI Phantom  BLI Phantom_Green 1_001_5000.stl

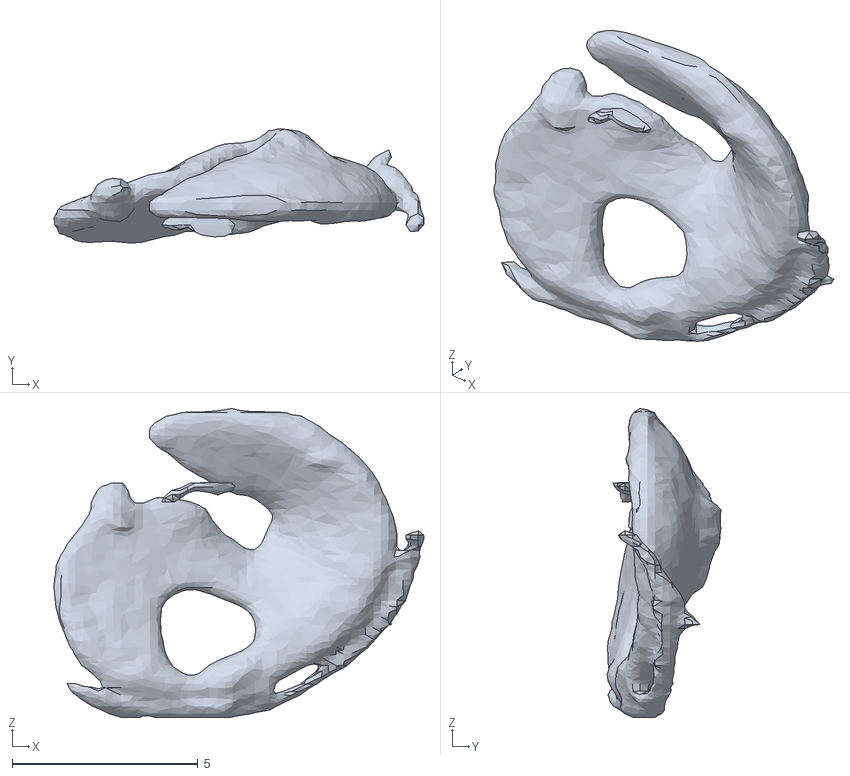
[picture p341: CAD file, 2017-11-13]
Ear Surgery Instruments/ear drum instruments/BLI Phantom BLI Phantom_Green 1_001_5000.stl
9.95 x 3.06 x 8.31
