arushriswarup/Grad-School/(list of files, cad)

Other CAD files:
Ear Surgery Instruments/Wrist Tool Assembly/superceded/slider print 06-Nov-2017/slider assembly v-4 06-Nov-2017.STL
Ear Surgery Instruments/Wrist Tool Assembly/cable + square joint_curve 2 assem.SLDASM
Ear Surgery Instruments/Wrist Tool Assembly/cable + square joint_curve 1 assem.SLDASM
Ear Surgery Instruments/Wrist Tool Assembly/slider assembly v-4 06-Nov-2017.SLDASM
Ear Surgery Instruments/Wrist Tool Assembly/slider handle assembly v-5 22-Nov-2017.SLDASM
Ear Surgery Instruments/Wrist Tool Assembly/cable + square joint_curve 3 assem.SLDASM
Ear Surgery Instruments/Wrist Tool Assembly/superceded/form print 29-Aug-2017/wire exit path v-3 29-Aug-2017.STL
Ear Surgery Instruments/Wrist Tool Assembly/superceded/print 28-Nov-2017/slider v-7 23-Nov-2017a.STL
3D Models/cropped PATIENT12586 V-3 25-Jan-2017.STEP
Ear Surgery Instruments/Wrist Tool Assembly/superceded/Clinical Tool/laser suction exit tube.SLDPRT
Ear Surgery Instruments/Wrist Tool Assembly/superceded/form print 12-Sep-2017/V06_Collet_ThreadCap_oldversion_repaired threads.STL
Ear Surgery Instruments/Wrist Tool Assembly/superceded/form print 25-Aug-2017/wedge v-4 01-Aug-2017_5mm.STL
Ear Surgery Instruments/Wrist Tool Assembly/superceded/form print 28-Mar-2017/tubing to luer coupler.STL
Ear Surgery Instruments/Wrist Tool Assembly/superceded/form print 29-Aug-2017/V06_Collet_ThreadCap_oldversion_repaired threads.SLDPRT
Ear Surgery Instruments/Wrist Tool Assembly/superceded/print 28-Nov-2017/slider v-7 23-Nov-2017b.STL
Ear Surgery Instruments/Wrist Tool Assembly/superceded/wedge v-3 01-Aug-2017.SLDPRT
Ear Surgery Instruments/Wrist Tool Assembly/wedge v-6 15-Nov-2017_5mm 270deg.SLDPRT
Tools/tube clamp form print/Tube Clamp 1_24mm top.STL
Ear Surgery Instruments/ear drum instruments/BLI Phantom BLI Phantom_Green 1_001_2351.stl
Ear Surgery Instruments/Wrist Tool Assembly/superceded/form print 25-Aug-2017/V06_Collet_ThreadCap_oldversion.STL
Ear Surgery Instruments/Wrist Tool Assembly/Wristed Cuts/80deg CCM V-1 Wrist left 10mm rc.SLDPRT
Tools/tube clamp form print/Tube Clamp 2_2 mm top.STL
Ear Surgery Instruments/ear drum instruments/Rosen Needle.SLDPRT
Ear Surgery Instruments/Wrist Tool Assembly/New Handle Dec-2017/Arushri_Tube_SquareJoint_curve 2.SLDPRT
Ear Surgery Instruments/Wrist Tool Assembly/superceded/form print testing wedge force 01-Aug-2017/wedge v-2 28-Mar-2017_4mm.SLDPRT
Ear Surgery Instruments/Wrist Tool Assembly/wheel_handle_body_slider v-1 26-Oct-2017.SLDPRT
Tools/tube clamp form print/Tube Clamp 1_37 mm top.STL
Ear Surgery Instruments/ear drum instruments/Panetti body_modified.SLDPRT
Ear Surgery Instruments/Wrist Tool Assembly/superceded/form print testing wedge force 01-Aug-2017/wedge v-3 01-Aug-2017_4mm.STL
Ear Surgery Instruments/Wrist Tool Assembly/superceded/wedge v-1 23-Mar-2017.SLDPRT
Ear Surgery Instruments/Wrist Tool Assembly/Wristed Cuts/135 deg Gear Tooth V-2 Wrist left.SLDPRT
3D Models/cross section of ear canal with endoscope_1.SLDPRT
3D Models/ID0_9652mm tube at 135deg.STL
3D Models/ID1.03mm tube at 135deg.SLDPRT
3D Models/ID1.03mm tube at 135deg.STL
3D Models/Panetti body.SLDPRT
3D Models/Panetti left with tip reach volume.STL
3D Models/Panetti left.STL
3D Models/Panetti right.SLDPRT
3D Models/Panetti right.STL
3D Models/Rosen Needle.SLDPRT
3D Models/Thomassin angled tip.STL
3D Models/Thomassin dissector.SLDPRT
3D Models/anatomy stls/patient1720/PATIENT1720_ear canal + superior to malleus_001.stl
3D Models/anatomy stls/patient1720/ear canal + superior to malleus.stl
3D Models/anatomy stls/patient1720/ossicles.stl
3D Models/anatomy stls/patient1720/temporal bone axial crop 06-Apr-2017.stl
3D Models/anatomy stls/patient1720/temporal bone axial crop v-2 06-Apr-2017.stl
3D Models/anatomy stls/patient1720/temporal bone axial crop v-4 10-Apr-2017.stl
3D Models/anatomy stls/patient1720/temporal bone axial crop_4_reduced.stl
3D Models/anatomy stls/patient1720/temporal bone_cut_1.stl
3D Models/anatomy stls/patient1720/temporal bone_reduced.stl
3D Models/cable + square joint_curve 1 assem.STL
3D Models/cable + square joint_curve 2 assem.STL
3D Models/cropped PATIENT12586 V-3 25-Jan-2017.SLDPRT
3D Models/cropped PATIENT12586 V-3 25-Jan-2017.stl
3D Models/cross section of ear canal with endoscope_2.SLDPRT
3D Models/endoscope.SLDPRT
3D Models/endoscope.STL
3D Models/endoscope_mesh.STL
3D Models/nitinol notched tube v-1 17-Jan-2017.SLDPRT
3D Models/nitinol notched tube v-1 17-Jan-2017.STL
3D Models/virtual model v-3 19-Apr-2017.stl
Coursework/BME 498 TA/HumanRightEar.obj
Ear Surgery Instruments/Wrist Tool Assembly/51465K161_HIGH-STRENGTH QUICK-TURN TUBE COUPLING.SLDPRT
Ear Surgery Instruments/Wrist Tool Assembly/51525K222_LIGHTWEIGHT QUICK-TURN TUBE COUPLING (2).SLDPRT
Ear Surgery Instruments/Wrist Tool Assembly/Aluminum stock.SLDPRT
Ear Surgery Instruments/Wrist Tool Assembly/Arushri_Tube_Double Modified Joint_bent display states.SLDPRT
Ear Surgery Instruments/Wrist Tool Assembly/Arushri_Tube_SquareJoint.SLDPRT
Ear Surgery Instruments/Wrist Tool Assembly/Arushri_Tube_SquareJoint_curve 1.SLDPRT
Ear Surgery Instruments/Wrist Tool Assembly/Arushri_Tube_SquareJoint_curve 3.SLDPRT
Ear Surgery Instruments/Wrist Tool Assembly/Clinical Tool/51525K315_LIGHTWEIGHT QUICK-TURN TUBE COUPLING.SLDPRT
Ear Surgery Instruments/Wrist Tool Assembly/Clinical Tool/90591A154 M7 collet clamp shallow threads for 3d printing.STL
Ear Surgery Instruments/Wrist Tool Assembly/Clinical Tool/suction tube.SLDPRT
Ear Surgery Instruments/Wrist Tool Assembly/Collet amazon 0.5-3mm.SLDPRT
Ear Surgery Instruments/Wrist Tool Assembly/Collet_1_75mmID.SLDPRT
Ear Surgery Instruments/Wrist Tool Assembly/M8X0.75.SLDPRT
Ear Surgery Instruments/Wrist Tool Assembly/New Handle Dec-2017/1.24mm nitinol laser and suction port.SLDPRT
Ear Surgery Instruments/Wrist Tool Assembly/New Handle Dec-2017/5560K69_stainless steel tubing.SLDPRT
Ear Surgery Instruments/Wrist Tool Assembly/New Handle Dec-2017/5mmALtube to 2mm NiTi tube connector 540 set screw.SLDPRT
Ear Surgery Instruments/Wrist Tool Assembly/New Handle Dec-2017/5mmALtube to 2mm NiTi tube connector 540 set screw.STL
Ear Surgery Instruments/Wrist Tool Assembly/New Handle Dec-2017/90318A102_ULTRA LOW PROFILE TYPE 316 SS SHOULDER SCREW.SLDPRT
Ear Surgery Instruments/Wrist Tool Assembly/New Handle Dec-2017/Arushri_Tube_Double Modified Joint.SLDPRT
Ear Surgery Instruments/Wrist Tool Assembly/New Handle Dec-2017/Arushri_Tube_SquareJoint.SLDPRT
Ear Surgery Instruments/Wrist Tool Assembly/New Handle Dec-2017/Arushri_Tube_SquareJoint_curve 3.SLDPRT
Ear Surgery Instruments/Wrist Tool Assembly/New Handle Dec-2017/Nitinol shaft.SLDPRT
Ear Surgery Instruments/Wrist Tool Assembly/New Handle Dec-2017/cable.SLDPRT
Ear Surgery Instruments/Wrist Tool Assembly/New Handle Dec-2017/cable_curve1.SLDPRT
Ear Surgery Instruments/Wrist Tool Assembly/New Handle Dec-2017/cable_curve2.SLDPRT
Ear Surgery Instruments/Wrist Tool Assembly/New Handle Dec-2017/cable_curve3.SLDPRT
Ear Surgery Instruments/Wrist Tool Assembly/New Handle Dec-2017/handle.SLDPRT
Ear Surgery Instruments/Wrist Tool Assembly/New Handle Dec-2017/nitinol notched tube v-1 17-Jan-2017.SLDPRT
Ear Surgery Instruments/Wrist Tool Assembly/New Handle Dec-2017/stainless steel tube 5560K43.SLDPRT
Ear Surgery Instruments/Wrist Tool Assembly/New Handle Dec-2017/wedge v-5 14-Sep-2017_5mm.SLDPRT
Ear Surgery Instruments/Wrist Tool Assembly/Rosen mould.SLDPRT
Ear Surgery Instruments/Wrist Tool Assembly/Rosen_tip.SLDPRT
Ear Surgery Instruments/Wrist Tool Assembly/Tube Bending Figure.SLDDRW
Ear Surgery Instruments/Wrist Tool Assembly/V06_Collet_ThreadCap.SLDPRT
Ear Surgery Instruments/Wrist Tool Assembly/V06_Collet_ThreadCap_oldversion.SLDPRT
Ear Surgery Instruments/Wrist Tool Assembly/V06_Collet_ThreadCap_oldversion_repaired threads.SLDPRT
Ear Surgery Instruments/Wrist Tool Assembly/V06_Collet_ThreadCap_repaired threads.SLDPRT
Ear Surgery Instruments/Wrist Tool Assembly/V07_Collet_ThreadCap.SLDPRT
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
