arushriswarup/Grad-School/Ear Surgery Instruments/Wrist Tool Assembly/section of ear canal with endoscope.png

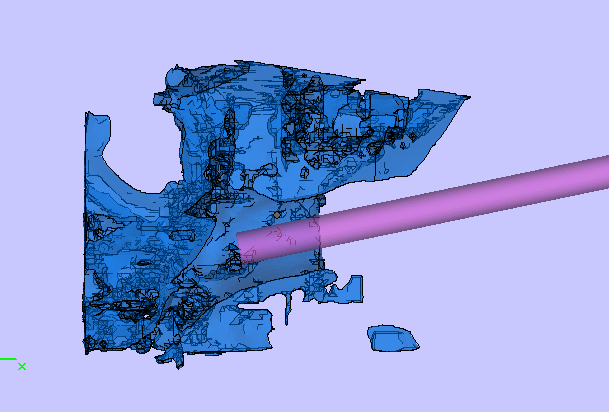
Ear Surgery Instruments/Wrist Tool Assembly/section of ear canal with endoscope.png
