arushriswarup/Grad-School/Time Flow Study/Duration of Steps During Endoscopic Tympanoplasty.png

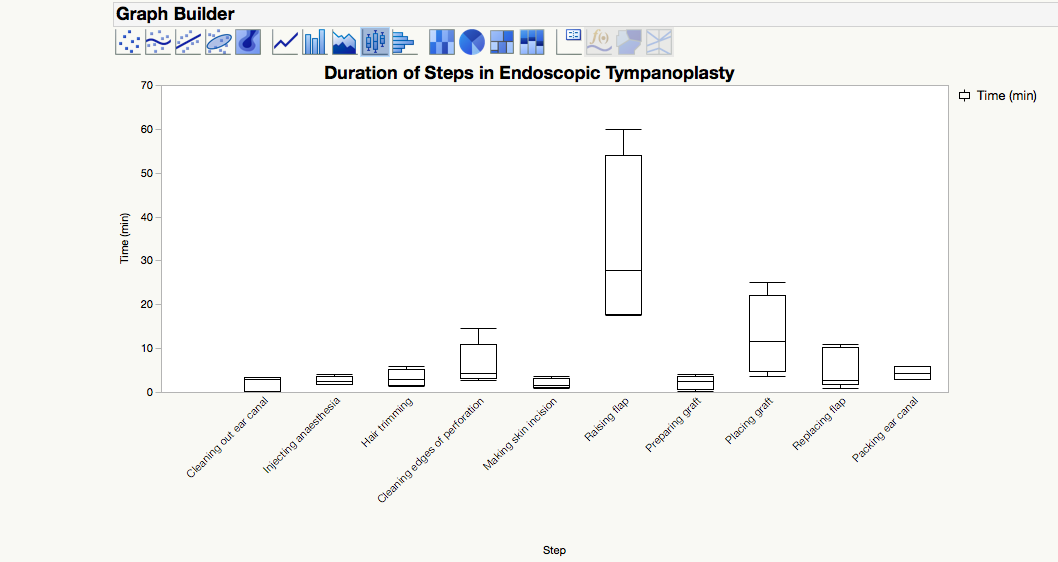
Time Flow Study/Duration of Steps During Endoscopic Tympanoplasty.png
