arushriswarup/Grad-School/Ear Surgery Instruments/Tip Force Testing.xlsx

Sheet: Test Overview
Tip Force Testing | testing the ccm notched wrist vs. rectangular notched wrist
Test | Description | Purpose
Blocking Force | attached cable distal to the joint and pulled on cable perpendicular to the notch using the force sensor to record how much force is pulling distal to the notch perpendicularly and thus how much the tip is being displaced as a result of that. | when handling tissues within the middle ear during surgery, is the tip able to handle those forces need different directions
Cyclic Loading |  | to determine how many times the joint can be loaded and unloaded before it starts to fail/fracture/crack
Twisting |  | degrees the joint can be twisted before it cracks
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
