arushriswarup/Grad-School/Needs Analysis Survey/Needs Analysis Survey Results 27-Jul-2017.xlsx

Sheet: EndoscopicEarSurgery_DATA_09-Ma
record_id | redcap_survey_identifier | percent_of_totally_ees | Percent of TEES Surgeries | instrument set | Instrument Set | Bleeding Control | Reaching Structures | Cutting Bone | Keeping the Lens Clean | Positioning a Graft | Dissection and Removal of Cholesteatoma | survey_1_endoscopic_ear_surgery_needs_assessment_complete
18 |  | 1 | 0 | 2 | No | 50 | 50 | 50 | 50 | 50 | 50 | 2 | Percent of TEES surgeries: | catergory | count: |  | Instrument Set |  | count:
19 |  | 1 | 0 | 2 | No | 8 | 86 | 52 | 11 | 49 | 51 | 2 | 1 | 0% | 0 |  | 1 | Yes | 14
34 |  | 1 | 0 | 1 | Yes | 92 | 92 | 50 | 90 | 50 | 90 |  | 2 | Up to 50% | 8 |  | 2 | No | 2
44 |  | 1 | 0 | 1 | Yes | 53 | 75 | 51 | 50 | 49 | 47 | 2 | 3 | 50%-90% | 5
2 |  | 3 | 50%-90% | 1 | Yes | 53 | 83 | 62 | 72 | 93 | 100 | 2 | 4 | More than 90% | 3
7 |  | 3 | 50%-90% | 1 | Yes | 83 | 93 | 69 | 50 | 57 | 69 | 2
8 |  | 3 | 50%-90% | 1 | Yes | 58 | 40 | 70 | 67 | 56 | 41 | 2
11 |  | 3 | 50%-90% | 2 | No | 24 | 98 | 77 | 41 | 69 | 84 | 2
15 |  | 3 | 50%-90% | 1 | Yes | 50 | 85 | 50 | 35 | 36 | 81 | 2
20 |  | 3 | 50%-90% | 1 | Yes | 50 | 100 | 50 | 50 | 0 | 100 |  |  | Results:
22 |  | 3 | 50%-90% | 1 | Yes | 68 | 88 | 41 | 10 | 49 | 91 |  |  | no sig difference between TEES percentage and any of the difficulties - when alpha = 10% and 5%
23 |  | 3 | 50%-90% | 1 | Yes | 84 | 100 | 52 | 89 | 50 | 65
24 |  | 3 | 50%-90% | 1 | Yes | 50 | 94 | 86 | 90 | 84 | 93
30 |  | 3 | 50%-90% | 2 | No | 58 | 84 | 86 | 63 | 57 | 67
36 |  | 3 | 50%-90% | 1 | Yes | 70 | 100 | 100 | 68 | 68 | 100 | 2
37 |  | 3 | 50%-90% | 1 | Yes | 100 | 100 | 76 | 78 | 79 | 78 | 2
38 |  | 3 | 50%-90% | 2 | No | 50 | 50 | 89 | 96 | 50 | 98 | 2
39 |  | 3 | 50%-90% | 1 | Yes | 100 | 100 | 100 | 49 | 51 | 100 | 2
40 |  | 3 | 50%-90% | 1 | Yes | 62 | 91 | 61 | 92 | 50 | 96 | 2
42 |  | 3 | 50%-90% | 1 | Yes | 71 | 100 | 73 | 100 | 86 | 100 | 2 |  |  | endoscope | instrument
43 |  | 3 | 50%-90% | 1 | Yes | 100 | 86 | 76 | 69 | 60 | 67 | 2 |  |  | flexible | retractible
45 |  | 3 | 50%-90% | 1 | Yes | 50 | 100 | 50 | 0 | 100 | 100 | 2 |  |  |  | suction elevators to control amount of suction
46 |  | 3 | 50%-90% | 2 | No | 99 | 85 | 82 | 83 | 83 | 83 | 2
48 |  | 3 | 50%-90% | 1 | Yes | 79 | 77 | 78 | 50 | 79 | 78 | 2
50 |  | 3 | 50%-90% | 1 | Yes | 98 | 91 | 49 | 50 | 10 | 50 | 2
9 |  | 4 | More than 90% | 1 | Yes | 99 | 100 | 100 | 100 | 99 | 100 | 2
14 |  | 4 | More than 90% | 1 | Yes | 64 | 90 | 99 | 76 | 50 | 90 | 2
16 |  | 4 | More than 90% | 1 | Yes | 92 | 99 | 61 | 87 | 83 | 92 | 2
25 |  | 4 | More than 90% | 2 | No | 96 | 91 | 49 | 95 | 96 | 67
26 |  | 4 | More than 90% | 2 | No | 30 | 99 | 99 | 51 | 100 | 100
28 |  | 4 | More than 90% | 1 | Yes | 48 | 98 | 5 | 50 | 98 | 98
32 |  | 4 | More than 90% | 1 | Yes | 97 | 66 | 15 | 68 | 28 | 75
35 |  | 4 | More than 90% | 1 | Yes | 98 | 99 | 85 | 77 | 99 | 53 | 2
47 |  | 4 | More than 90% | 1 | Yes | 100 | 100 | 100 | 74 | 74 | 100 | 2
49 |  | 4 | More than 90% | 1 | Yes | 50 | 75 | 93 | 88 | 84 | 61 | 2
1 |  | 2 | Up to 50% | 1 | Yes | 76 | 76 | 64 | 77 | 68 | 72 | 2
3 |  | 2 | Up to 50% | 1 | Yes | 86 | 90 | 61 | 62 | 73 | 65 | 2
4 |  | 2 | Up to 50% | 1 | Yes | 50 | 50 | 50 | 7 | 7 | 50 | 2
5 |  | 2 | Up to 50% | 1 | Yes | 20 | 36 | 51 | 52 | 28 | 26 | 2
6 |  | 2 | Up to 50% | 1 | Yes | 64 | 91 | 69 | 43 | 23 | 92 | 2
10 |  | 2 | Up to 50% | 1 | Yes | 19 | 67 | 71 | 33 | 50 | 75 | 2
12 |  | 2 | Up to 50% | 2 | No | 78 | 94 | 71 | 92 | 91 | 86 | 2
13 |  | 2 | Up to 50% | 1 | Yes | 50 | 94 | 92 | 5 | 5 | 96 | 2
17 |  | 2 | Up to 50% | 1 | Yes | 95 | 89 | 50 | 95 | 50 | 50 | 2
21 |  | 2 | Up to 50% | 1 | Yes | 100 | 100 | 100 | 100 | 69 | 81
27 |  | 2 | Up to 50% | 1 | Yes | 50 | 50 | 100 | 100 | 50 | 100
29 |  | 2 | Up to 50% | 1 | Yes | 79 | 49 | 57 | 4 | 5 | 71
31 |  | 2 | Up to 50% | 1 | Yes | 37 | 41 | 57 | 29 | 28 | 61
33 |  | 2 | Up to 50% | 2 | No | 50 | 64 | 66 | 58 | 82 | 64
41 |  | 2 | Up to 50% | 2 | No | 72 | 96 | 50 | 51 | 53 | 100 | 2
51 |  | 2 | Up to 50% | 1 | Yes | 23 | 64 | 32 | 6 | 27 | 16 | 2
mean |  |  |  |  |  | 66.33333333 | 82.66666667 | 67.19607843 | 60.45098039 | 58.52941176 | 76.8627451
median |  |  |  |  |  | 64 | 90 | 66 | 63 | 56 | 81
std dev |  |  |  |  |  | 25.61223666 | 19.01122475 | 22.27915583 | 29.33892549 | 27.62633015 | 21.42430359
std error |  |  |  |  |  | 3.58643049 | 2.66210394 | 3.119705819 | 4.108271305 | 3.868459991 | 3.000002563
0 median |  |  |  |  |  | 78 | 91 | 71 | 69 | 73 | 83
up to 50 median |  |  |  |  |  | 64 | 90 | 66 | 63 | 56 | 81
50-90 median |  |  |  |  |  | 68 | 91 | 69 | 67 | 57 | 81
more than 90 median |  |  |  |  |  | 70 | 91 | 71 | 68 | 60 | 81
interquartile range |  |  |  |  |  | 50-92 | 75-99 | 50.5-86 | 49.5-88.5 | 49.5-83 | 65-98

Sheet: Sheet1
Bleeding Control | Reaching Structures | Cutting Bone | Keeping the Lens Clean | Positioning a Graft | Dissection and Removal of Cholesteatoma |  | Reaching Structures | 82.87755102 | 2.685234476
66.57142857 | 82.87755102 | 68.28571429 | 61.54 | 60.16326531 | 78.08 |  | Dissection and Removal of Cholesteatoma | 78.08 | 2.769790731
3.495795794 | 2.685234476 | 3.077830277 | 4.001521319 | 3.763900917 | 2.769790731 |  | Cutting Bone | 68.28571429 | 3.077830277
 |  |  |  |  |  |  | Bleeding Control | 66.57142857 | 3.495795794
 |  |  |  |  |  |  | Keeping the Lens Clean | 61.54 | 4.001521319
 |  |  |  |  |  |  | Positioning a Graft | 60.16326531 | 3.763900917
 | Bleeding Control | Reaching Structures | Cutting Bone | Keeping the Lens Clean | Positioning a Graft | Dissection and Removal of Cholesteatoma |  | Reaching Structures | 90 | 75-99
 | 64 | 90 | 66 | 63 | 56 | 81 |  | Dissection and Removal of Cholesteatoma | 81 | 65-98
 |  |  |  |  |  |  |  | Cutting Bone | 66 | 50.5-86
 |  |  |  |  |  |  |  | Bleeding Control | 64 | 50-92
 |  |  |  |  |  |  |  | Keeping the Lens Clean | 63 | 49.5-88.5
 |  |  |  |  |  |  |  | Positioning a Graft | 56 | 49.5-83
 | Bleeding Control | Reaching Structures | Cutting Bone | Keeping the Lens Clean | Positioning a Graft | Dissection and Removal of Cholesteatoma

Sheet: Sheet2
1 Reaching Structures | 76
1 Reaching Structures | 83
1 Reaching Structures | 90
1 Reaching Structures | 50
1 Reaching Structures | 36
1 Reaching Structures | 91
1 Reaching Structures | 93
1 Reaching Structures | 40
1 Reaching Structures | 100
1 Reaching Structures | 67
1 Reaching Structures | 98
1 Reaching Structures | 94
1 Reaching Structures | 94
1 Reaching Structures | 90
1 Reaching Structures | 85
1 Reaching Structures | 99
1 Reaching Structures | 89
1 Reaching Structures | 50
1 Reaching Structures | 86
1 Reaching Structures | 100
1 Reaching Structures | 100
1 Reaching Structures | 88
1 Reaching Structures | 100
1 Reaching Structures | 94
1 Reaching Structures | 91
1 Reaching Structures | 99
1 Reaching Structures | 50
1 Reaching Structures | 98
1 Reaching Structures | 49
1 Reaching Structures | 84
1 Reaching Structures | 41
1 Reaching Structures | 66
1 Reaching Structures | 64
1 Reaching Structures | 92
1 Reaching Structures | 99
1 Reaching Structures | 100
1 Reaching Structures | 100
1 Reaching Structures | 50
1 Reaching Structures | 100
1 Reaching Structures | 91
1 Reaching Structures | 96
1 Reaching Structures | 100
1 Reaching Structures | 86
1 Reaching Structures | 75
1 Reaching Structures | 100
1 Reaching Structures | 85
1 Reaching Structures | 100
1 Reaching Structures | 77
1 Reaching Structures | 75
1 Reaching Structures | 91
1 Reaching Structures | 64
2 Dissection and Removal of Cholesteatoma | 72
2 Dissection and Removal of Cholesteatoma | 100
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
6 Positioning a Graft | 53
6 Positioning a Graft | 86
6 Positioning a Graft | 60
6 Positioning a Graft | 49
6 Positioning a Graft | 100
6 Positioning a Graft | 83
6 Positioning a Graft | 74
6 Positioning a Graft | 79
6 Positioning a Graft | 84
6 Positioning a Graft | 10
6 Positioning a Graft | 27

Sheet: Sheet3
Challenge | Experience | Need
Bleeding Control | 0 | 50
Bleeding Control | 0 | 8
Bleeding Control | 0 | 92
Bleeding Control | 0 | 53
Bleeding Control | 50%-90% | 53
Bleeding Control | 50%-90% | 83
Bleeding Control | 50%-90% | 58
Bleeding Control | 50%-90% | 24
Bleeding Control | 50%-90% | 50
Bleeding Control | 50%-90% | 50
Bleeding Control | 50%-90% | 68
Bleeding Control | 50%-90% | 84
Bleeding Control | 50%-90% | 50
Bleeding Control | 50%-90% | 58
Bleeding Control | 50%-90% | 70
Bleeding Control | 50%-90% | 100
Bleeding Control | 50%-90% | 50
Bleeding Control | 50%-90% | 100
Bleeding Control | 50%-90% | 62
Bleeding Control | 50%-90% | 71
Bleeding Control | 50%-90% | 100
Bleeding Control | 50%-90% | 50
Bleeding Control | 50%-90% | 99
Bleeding Control | 50%-90% | 79
Bleeding Control | 50%-90% | 98
Bleeding Control | More than 90% | 99
Bleeding Control | More than 90% | 64
Bleeding Control | More than 90% | 92
Bleeding Control | More than 90% | 96
Bleeding Control | More than 90% | 30
Bleeding Control | More than 90% | 48
Bleeding Control | More than 90% | 97
Bleeding Control | More than 90% | 98
Bleeding Control | More than 90% | 100
Bleeding Control | More than 90% | 50
Bleeding Control | Up to 50% | 76
Bleeding Control | Up to 50% | 86
Bleeding Control | Up to 50% | 50
Bleeding Control | Up to 50% | 20
Bleeding Control | Up to 50% | 64
Bleeding Control | Up to 50% | 19
Bleeding Control | Up to 50% | 78
Bleeding Control | Up to 50% | 50
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
Cutting Bone | Up to 50% | 92
Cutting Bone | Up to 50% | 50
Cutting Bone | Up to 50% | 100
Cutting Bone | Up to 50% | 100
Cutting Bone | Up to 50% | 57
Cutting Bone | Up to 50% | 57
Cutting Bone | Up to 50% | 66
Cutting Bone | Up to 50% | 50
Cutting Bone | Up to 50% | 32
