arushriswarup/Grad-School/Ear Surgery Instruments/Wrist Tool Assembly/PerformanceLog.txt

Create Contact and Generate contact data:  0 hr 0 min 0 sec
