arushriswarup/Grad-School/Needs Analysis Survey/Stats results/Fit Y by X.pptx

## Need for Better Instruments vs. TEES Challenge

Legend:
+ 0-50% TEES Cases
- >50% TEES Cases
