arushriswarup/Grad-School/REB/TEES Instrument Testing Survey/Protocol - Neurosurgical Instrument User-Feedback Study 2017-08-25 AS.docx

# Neurosurgical and Otological Instrument User-Feedback Study

# Background and Rationale

Neuroendoscopy is a form of “key-hole” minimally invasive neurosurgery that is widely used to treat pathologies deep within the center of the brain. Some of the most common indications for this technique include the treatment of hydrocephalus, the removal of choroid cysts and the biopsy and excision of para- and intra-ventricular tumors. Presently, the size and location of such tumors limit the applicability of neuroendoscopy such that only small, minimally vascularized tumors can be removed using this innovative approach. Unfortunately, only a subset of patients fall into this category, and the remainder must be treated using more invasive, open surgical techniques that involve craniotomies, leading to longer procedures, increased blood loss and lengthened recovery time.

One barrier limiting the use of neuroendoscopy for treating larger neoplasms is the design of current standard neuroendoscopic instruments. These tools are straight and rigid/semi-flexible, and offer little to no control over the tool tip. As such, the range of motion and variety of tasks that can be performed using these instruments is restricted to simple straight-line approaches. To extend the reach and range-of-motions that surgeons can achieve through these “key-hole” procedures, new instruments that mimic the dexterity of the “human wrist” are needed.

Middle ear surgery is traditionally performed through an external incision with visualization of delicate anatomical structures using a microscope. More recently, minimally invasive ear surgical (ontological) techniques have been developed using endoscopes to access the middle ear through the ear canal without an external incision. Despite the enthusiasm of some ear surgeons (otologists), transcanal endoscopic ear surgery (TEES) has not as yet been accepted by all practicing otologists. The principal challenge with TEES is that a one-handed surgical technique is required as the endoscope is held in the other hand. Otologic instruments were developed for two-handed microscope-guided surgery so they are not optimized for the TEES environment. As otologists have been trained and gained experience in microscope-guided ear surgery, they have developed techniques with the according instruments and have become accustomed to a two-handed surgical approach. By learning different surgical techniques and gaining experience with the endoscope, most surgeons find that they can complete more cases endoscopically. Nevertheless, the learning curve can be slow and frustrating. Technological advances in the design of the endoscope, camera and suction dissection instruments have lead to incremental stepwise jumps in this learning curve [9]. There is a knowledge gap in the literature where it is not reported exactly why surgeons have not adopted the technique, and what technological and/or training advances would facilitate its use. It is proposed that in order to facilitate TEES, the needs of surgeons and current limitations of tools must be determined.

Over the past three years, we have studied these problems and new technologies have been developed to augment and improve the function of standard neuroendoscopic and otological instruments. In order to translate the benefits of this technology and develop it into a useful surgical tool, surgeon-user feedback on the design of these new instruments is required. The purpose of this study is to rank the features of the instrument’s design and collect feed-back on the features needing improvement.

# Objectives and Goals

The objective of this study is to collect surgeon-user feedback on the design of new neuroendoscopic and otologic instruments developed at the Hospital for Sick Children. The study will consider the use of the tools in basic bench-top pick-and-place maneuvers and also while using the tools along with standard instruments while performing a “mock” surgery using a validated synthetic brain training simulator and 3D printed ear anatomical models. The ultimate goal of this research is to incorporate human factors into the continuing design of the instrument.

# methods

## Study Setting

This single-center study will take place at the Surgical Skills Center in Toronto, Canada. The center will provide standard neuroendoscopy and TEES equipment to compliment the instrument being tested.

## Study population/Demographics

A total of 24 participants will be recruited for the user-feedback study and will include neurosurgical residents with varying levels of experience (novice), neurosurgical fellows (experienced) and staff surgeons (experts). Participants for testing the TEES instruments will be residents, fellows and staff ear surgeons.

## Data Collection

A total of 24 neurosurgical residents and fellow/staff neurosurgeons will perform simulated endoscopic neurosurgeries using the new instrument in conjunction with standard clinical equipment on a validated, synthetic brain training simulator. Participants testing the TEES instruments will perform simulated tasks in a 3D printed ear anatomical model with the new instrument and standard clinical equipment.

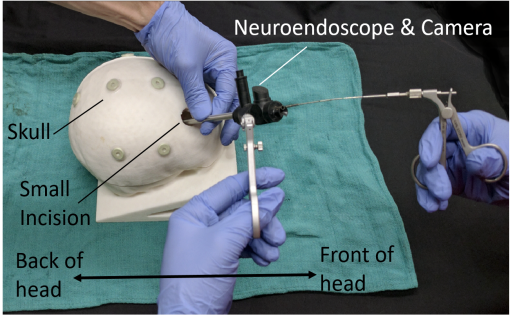
[picture p345: figure]
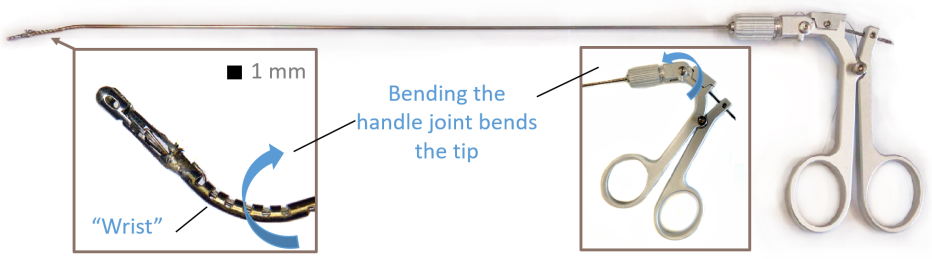
[picture p346: figure]

Figure 1: Example of Neurosurgical Simulator Set-up with Synthetic Brain Model and Neuroendoscopic Instruments [Left]. Example of New Instrument with “Wrist” to be Tested in Survey

Figure 2: Example of otological instrument.

Using a mixed-methods design, all participants will complete a 30-item questionnaire (5-point Likert scales) to rate the design features of the instrument and will also provide feedback for each item. The survey will also include six separate questions regarding demographics and prior experience, as well as a final overall impressions section. Specifically, the neurosurgical 24-item questionnaire considers the instrument handle’s form and feel (Items 7-9), the rating of instrument’s ease-of-use alongside existing standard equipment (Items 10-17), the rating of the instrument’s performance (Items 18-24) and the tool’s comfort (Items 25-30).

The otological instrument survey is a 22-item questionnaire which considers the instrument handle’s form (items 7-9), the rating of instrument’s ease-of-use (items 10-16), the rating of the instrument’s performance and safety (items 17-21), the rating of the tools functionality (items 22-25) and instrument’s comfort (items 26-28).

An example of the surveys are included in the appendix. All of the information will be stored on a secure server and anonymized.

## Study Limitations

The first limitation of the study design is that some of the participants (junior residents in years 1-3) will have limited experience using standard neuroendoscopic and otologic instruments. This issue will limit their ability to evaluate the differences between the new instrument and existing tools. Additionally, participants will be subject to recall bias when comparing the use of the tool for the simulated surgery to previous actual surgical experiences. Finally, the sample size of the study may be small, particularly for conducting any sub-group analysis to compare differences in responses between surgeons of different experience levels, such as the staff and trainees.

# DATA ANALYSIS PROCEDURES

The collected data consists of ordinal categorical variables (Likert: Strongly Disagree, Disagree, Neutral, Agree, Strongly Agree) grouped into four themes. This information will be collected from three evaluator subgroups (nominal data) that are defined by levels of experience: Novice (Residents in post-graduate years 1-6), experienced (Fellows) and experts (staff neurosurgeons/otologists). The pooled results of each of the twelve items will be presented as frequencies in a contingency table. To more succinctly summarize the four themes, the mean, standard deviation and median ratings of the handle’s form and feel (Items 7-9), the instrument’s ease-of-use (Items 10-17), the instrument’s performance (Items 18-24) and the tool’s comfort (Items 25-30). will be calculated.

A subgroup analysis will also be conducted for the two evaluator groups to identify any statistically significant differences in the instrument’s assessments based on surgical experience. The Kruskall-Wallis test, which is a non-parametric one-way analysis of variance, will be considered (assuming a 95% confidence interval) to test whether the novice, experienced and expert responses originate from the same distribution. For any questionnaire items that are found to have a p-value less than 0.05, the Mann-Whitney U test, which is considered a non-parametric alternative to the independent t-test, will be used to perform a multiple comparison of means. The p-values in the multiple comparisons analysis will be adjusted using the method of Benjamini-Hochberg (BH) which aims to control the false discovery rate. This adjustment will be compared to the un-adjusted p-values. All analysis will be completed using R version 3.2.0 (The R Foundation).

The qualitative feedback obtained from the surveys will be organized by the same themes, which include instrument’s handle’s form and feel, the instrument’s ease-of-use, the instrument’s performance, and the tool’s comfort. The responses will be coded and recurring items will be grouped. Any coded items that occurred more than three times will be explicitly tabulated and discussed in the results.

Protocol Page 2 of 4 Neurosurgical and Otological Instrument User-Feedback Study Version 2017-08-31
