arushriswarup/Grad-School/Testimonials/Reference for Prof Yoo.pdf

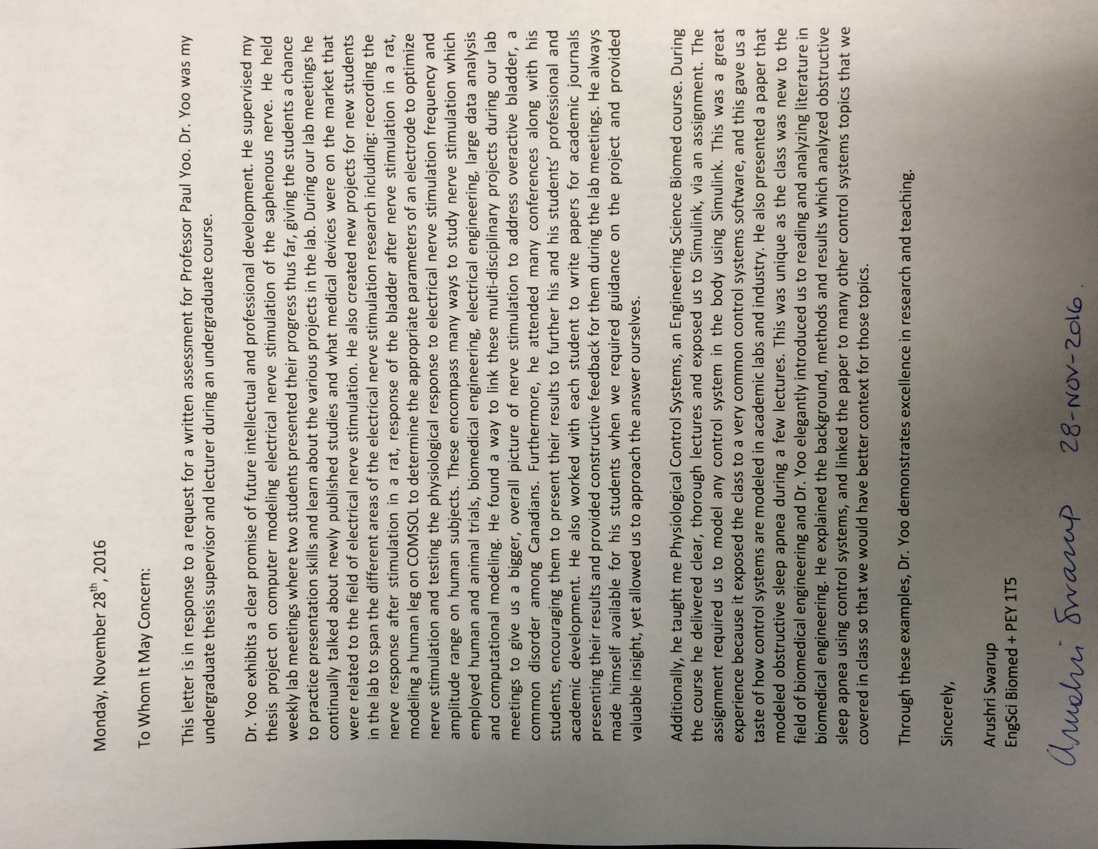
[picture p347: page 1]
