arushriswarup/Grad-School/Testimonials/Testimonial for Dr. James.pdf

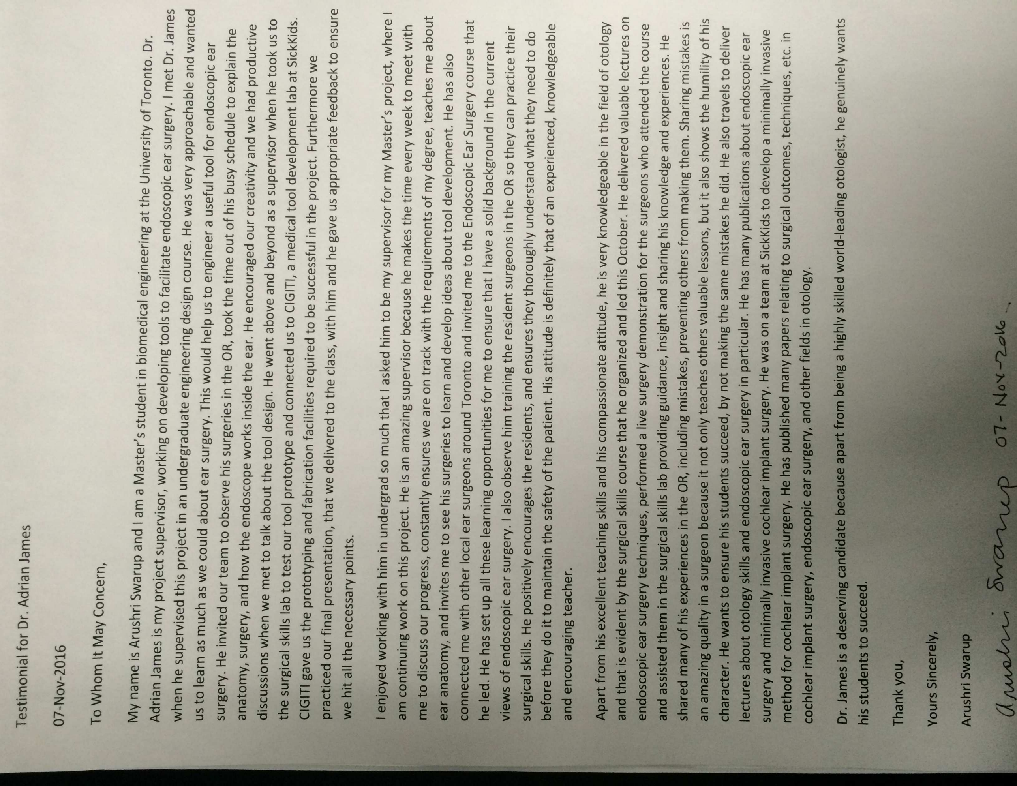
[picture p348: page 1]
