arushriswarup/Grad-School/UHN Observership/Results_Privacy Module.pdf

## Privacy for Non-Clinicians Test

## Arushri Swarup

Date / Time | Student Score | Passing Score | Result
May 31, 2017 11:14 am | 100 | 100 | Pass
Results | https://www.uhnmodules.ca/for_staff/computer_education/privacy...
1 of 1 | 2017-05-31, 11:16 AM
