arushriswarup/Grad-School/EES Course/EES course prelim survey results 19-Oct-2016.xlsx

Factor: | Level(s): | Score:
1. Years of EES experience | a. <1 | 10
 | b. 1-3 | 4
 | c. 4-7 | 1
 | d. >8
2. Percentage of totally EES surgeries | a. 0 | 8
 | <5 | 1
 | b. 5-25 | 4
 | c. 25-50 | 2
 | d. 50-75
 | e. 75-100
3. What surgeries do you use EES for? | a. cholesteatoma removal | 9
 | b.tympanoplasty | 10
 | c. ossicular repair | 6
 | d. other | 1
 | e. none of the above | 5
4. Do you currently use any of these dedicated EES instruments? | a. Spiggle & Theis Panetti | 3
 | b. Storz Endoscopic Middle Ear Surgery Instrument Set | 8
 | c. Grace Medical IWGEES | 2
 | (d. None) | 4
5. What are the factors that hinder your use of EES? | a. One handed surgery | 7
 | b. bleeding control | 5
 | c. effect of endoscope on depth perception of the surgical field | 2
 | d. other | 5 | resident: uses what the attending allows them to use | lack of experience (x3) | steep learning curve | haven't been trained
6. What are things that you find difficult during EES? | a. gripping and/or moving an ear drum graft | 2
 | b. cutting the ear drum graft into the appropriate shape | 1
 | c. gripping and/or moving cholesteatoma | 3
 | d. keeping tissues in place or in tgension while cutting or dissecting | 6
 | e. keeping the operative field clean | 8
 | f. accessing areas within hidden recesses in the ear (e.g. antrum) | 4
 | g. accessing areas that are visible via endoscope (but cannot be reached by conventional instruments) | 3
 | h. keeping the endoscope lens clean | 8
 | (e. None) | 1
7. What functionality of instruments do you think will improve y our experience with EES? | a. suction integrated woith another functionality (e.g. suction+curette or suction+forceps) | 12
 | b. suction actuated by a pedal (rather than with a finger plug hole) | 8
 | c. increasing accessibility of instrument tips to reach all areas within the viewing angle of the endoscope | 8
 | d. none |  | more rigid, small curved suctions
 | (e. Other) | 1 | drill with irrigation and suction (x2)
8. if there is a tool that can reach within the recesses in the middle ear, what would you like the tip function to be? | a. gripping something (e.g. foceps) | 7
 | b. suctioning | 9
 | c. cutting
 | d. dissecting | 10
 | e. a combination of the above (specify) | 4 | combine suction and dissection | combine grip and dissect
 | f. other
 | g. it is unnecessary to reach within these recesses in EES |  |  |  |  |  |  | average | std error
9. Risk the functions of a tool in order of importance | a. facilitate graft movement and positioning |  | 4 | 1 | 3 | 3 | 1 | 3.1 | 0.4333333333
 | b. suction |  | 1 | 2 | 1 | 1 | 3 | 2.1 | 0.4068851872
 | c. cutting |  | 3 | 5 | 5 | 5 | 4 | 4 | 0.3944053189
 | d. gripping (e.g. cholesteatoma, bone or ear drum graft) | 1 | 2 | 4 | 2 | 4 | 2 | 2.7 | 0.3958114029
 | e. reaching hidden areas within the ear | 2 | 5 | 3 | 4 | 2 | 5 | 3.1 | 0.4818944098
 |  |  | conclusions:
 |  |  | ranking: suction, gripping, reaching&graft maneuvering, cutting
 |  |  | tool: combine suction&dissection, dissecting, gripping, suction
 |  |  | 67% <1 year experience, and 50% have 0% adoption
 |  |  | 50% have storz
 |  |  | hindering factors: one handed surgery, bleeding control, lack of experience
 |  |  | difficulties: operative field clean, tissues in tension while cutting/dissecting, accessing hidden areas, keeping endoscope lens clean
