arushriswarup/Grad-School/REB/TEES Instrument Testing Survey/Instrument Survey Results.xlsx

Instrument Validation Survey:
Study ID: | Training Status: | Number of Years in Surgical Practice: | Left or Right Handed | Surgical Glove Size | Total No. of Endoscopic cases performed as primary or assistant surgeon | Percentage of cases performed totally endosocopically | Instrument Form |  |  | Instrument Operation - Mental Effort |  |  |  |  |  |  | Instrument Operation - Performance and Safety |  |  |  |  | Instrument Operation - Functionality |  |  |  |  | Instrument Operation - Comfort |  |  | 3D Printed Ear Model
 |  |  |  |  |  |  | appropriate weight | handle is appropriate size | wrist is appropriate size | Understanding how instrument works is intuitive | effort to perform tasks using the instrument is minimal | bending the tip of the instrument requires minimal effort | the bend/curvature of the tip is useful to reach target structures | dissecting tissue without bending the wrist was not difficult | dissecting tissue while bending the wrist was not difficult | the forces applied by the instrument on the tissue were appropriate | instrument performed as expected | instrument tip moved accurately | instrument was responsive | instrument tip moved smoothly | instrument
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
