arushriswarup/Grad-School/Coursework/BME 498 TA/Survey Results.xlsx

Sheet: Knowledge of Each Method
 |  |  | Pre Knowledge (1 - 7) |  |  |  | Post Knowledge (1 - 7)
Name | Group | Brainstorming Method Used | 635 | Mind Map | HMW? | Bio | 635 | Mind Map | HMW? | Bio | 635 | Mind Map | HMW? | Bio
Kathryn McIntosh | 1 | Mind Mapping | 5 | 7 | 6 | 4 | 7 | 7 | 6 | 7 | 2 | 0 | 0 | 3
Simon Spichak | 1 | Mind Mapping | 6 | 7 | 5 | 7 | 5 | 7 | 5 | 7 | -1 | 0 | 0 | 0
Anlan Li | 2 | How Might We …? | 3 | 4 | 6 | 4 | 4 | 5 | 6 | 4 | 1 | 1 | 0 | 0
Xiaotang Gao | 2 | How Might We …? | 4 | 5 | 7 | 5 | 5 | 6 | 6 | 5 | 1 | 1 | -1 | 0
Ghazal Sondhi | 2 | How Might We …? | 5 | 4 | 6 | 5 | 5 | 3 | 6 | 5 | 0 | -1 | 0 | 0
Jerry Mathew | 2 | How Might We …? | 6 | 5 | 4 | 4 | 6 | 5 | 4 | 5 | 0 | 0 | 0 | 1
Atta Habbolla-Zadeh | 3 | Biological Inspiration | 3 | 5 | 3 | 6 | 3 | 3 | 3 | 6 | 0 | -2 | 0 | 0
Ramin Ranjbar | 3 | Biological Inspiration | 6 | 6 | 7 | 6 | 5 | 7 | 6 | 7 | -1 | 1 | -1 | 1
Katariina Jaenes | 4 | Modified 635 | 6 | 6 | 5 | 5 | 7 | 6 | 5 | 6 | 1 | 0 | 0 | 1
Haiqi Wei | 4 | Modified 635 | 7 | 7 | 4 | 6 | 6 | 7 | 3 | 5 | -1 | 0 | -1 | -1
Prateek | 4 | Modified 635 | 7 | 6 | 4 | 6 | 7 | 7 | 7 | 7 | 0 | 1 | 3 | 1
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
