arushriswarup/Grad-School/Needs Analysis Survey/superceded/Needs Analysis Survey Results.xlsx

Needs Analysis Survey Results
Legend: | Not at all useful, not very useful, somewhat useful, useful, very useful
Analysis: Likert scale - will give a score between 1-5 to each question use http://poincare.matf.bg.ac.rs/~kristina/topic-dane-likert.pdf and http://www.measuringu.com/blog/interpret-responses.php for analysis used "Wording for rating scales" on mendeley to develop wording for questions
Question | Score
