arushriswarup/Grad-School/REB/TEES Instrument Testing Survey/Master File - Instrument 2017-03-20 JD.xlsx

Study ID | Name
.
.
.
.
.
.
.
.
.
.
.
.
.
.
.
.
.
.
.
.
.
.
.
.
