arushriswarup/Grad-School/authored papers/Gear Tooth Joint /Experiments/Kinematics Data_Experimental and FEA 08-Dec-2017.xlsx

Sheet: Summary Table
Column1 | Column2 | Column3 | Column4 | Column5 | Column6 | Column7
 | Steps | Time [s] | [A] Elemental Euler XZ Angle (Min) [°] | [B] Elemental Euler XZ Angle (Max) [°] | User Defined Result (Max)
1 | 1 | 0.1 | -3.5231 | -3.2637 | 6.9157e-002
2 | 1 | 0.2 | -7.0716 | -6.5139 | 0.13787
3 | 1 | 0.3 | -10.568 | -9.8166 | 0.2066
4 | 1 | 0.4 | -14.021 | -13.205 | 0.27505
5 | 1 | 0.5 | -17.432 | -16.631 | 0.34312
6 | 1 | 0.6 | -20.815 | -20.064 | 0.40997
7 | 1 | 0.7 | -24.149 | -23.4 | 0.4752
8 | 1 | 0.8 | -27.45 | -26.826 | 0.54097
9 | 1 | 1. | -29.158 | -28.539 | 0.5719
10 | 2 | 2.
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
