arushriswarup/Grad-School/authored papers/Gear Tooth Joint /Experiments/CAJ_NDI_20171121/caj_ndi_20171121_000.csv

1 | Port 10: NDI-MF2 610059 T6F0-L00061 s/n:3A915800 Channel:0 | 35166 | 1 | OK | -12.6489839 | 8.6345449 | -171.3973241 | 92.615 | -37.160 | -210.863 | 0.1461861 | 20 | Missing | -3.697314E28 | -3.697314E28 | -3.697314E28 | Missing | -3.697314E28 | -3.697314E28 | -3.697314E28 | Missing | -3.697314E28 | -3.697314E28 | -3.697314E28 | Missing | -3.697314E28 | -3.697314E28 | -3.697314E28 | Missing | -3.697314E28 | -3.697314E28 | -3.697314E28 | Missing | -3.697314E28 | -3.697314E28 | -3.697314E28 | Missing | -3.697314E28 | -3.697314E28 | -3.697314E28 | Missing | -3.697314E28 | -3.697314E28 | -3.697314E28 | Missing | -3.697314E28 | -3.697314E28 | -3.697314E28 | Missing | -3.697314E28 | -3.697314E28 | -3.697314E28 | Missing | -3.697314E28 | -3.697314E28 | -3.697314E28 | Missing | -3.697314E28 | -3.697314E28
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
