arushriswarup/Grad-School/authored papers/Gear Tooth Joint /Experiments/CAJ_NDI_20171121/caj_ndi_20171121_001.csv

1 | Port 10: NDI-MF2 610059 T6F0-L00061 s/n:3A915800 Channel:0 | 48438 | 1 | OK | -13.9161854 | 4.6177342 | 175.8366048 | 93.288 | -38.300 | -211.634 | 0.1813458 | 20 | Missing | -3.697314E28 | -3.697314E28 | -3.697314E28 | Missing | -3.697314E28 | -3.697314E28 | -3.697314E28 | Missing | -3.697314E28 | -3.697314E28 | -3.697314E28 | Missing | -3.697314E28 | -3.697314E28 | -3.697314E28 | Missing | -3.697314E28 | -3.697314E28 | -3.697314E28 | Missing | -3.697314E28 | -3.697314E28 | -3.697314E28 | Missing | -3.697314E28 | -3.697314E28 | -3.697314E28 | Missing | -3.697314E28 | -3.697314E28 | -3.697314E28 | Missing | -3.697314E28 | -3.697314E28 | -3.697314E28 | Missing | -3.697314E28 | -3.697314E28 | -3.697314E28 | Missing | -3.697314E28 | -3.697314E28 | -3.697314E28 | Missing | -3.697314E28 | -3.697314E28
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
