arushriswarup/Grad-School/authored papers/Gear Tooth Joint /Experiments/CAJ_NDI_20171121/caj_ndi_20171121_002.csv

1 | Port 10: NDI-MF2 610059 T6F0-L00061 s/n:3A915800 Channel:0 | 178302 | 1 | OK | -13.3452702 | 5.2459908 | 174.9127272 | 93.376 | -38.452 | -211.843 | 0.1891513 | 20 | Missing | -3.697314E28 | -3.697314E28 | -3.697314E28 | Missing | -3.697314E28 | -3.697314E28 | -3.697314E28 | Missing | -3.697314E28 | -3.697314E28 | -3.697314E28 | Missing | -3.697314E28 | -3.697314E28 | -3.697314E28 | Missing | -3.697314E28 | -3.697314E28 | -3.697314E28 | Missing | -3.697314E28 | -3.697314E28 | -3.697314E28 | Missing | -3.697314E28 | -3.697314E28 | -3.697314E28 | Missing | -3.697314E28 | -3.697314E28 | -3.697314E28 | Missing | -3.697314E28 | -3.697314E28 | -3.697314E28 | Missing | -3.697314E28 | -3.697314E28 | -3.697314E28 | Missing | -3.697314E28 | -3.697314E28 | -3.697314E28 | Missing | -3.697314E28 | -3.697314E28
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
