arushriswarup/Grad-School/authored papers/Gear Tooth Joint /Experiments/CAJ_NDI_20171121/caj_ndi_20171121_003.csv

1 | Port 10: NDI-MF2 610059 T6F0-L00061 s/n:3A915800 Channel:0 | 200750 | 1 | OK | -11.8035585 | 5.7951176 | 171.6145867 | 93.580 | -38.859 | -212.300 | 0.2081316 | 20 | Missing | -3.697314E28 | -3.697314E28 | -3.697314E28 | Missing | -3.697314E28 | -3.697314E28 | -3.697314E28 | Missing | -3.697314E28 | -3.697314E28 | -3.697314E28 | Missing | -3.697314E28 | -3.697314E28 | -3.697314E28 | Missing | -3.697314E28 | -3.697314E28 | -3.697314E28 | Missing | -3.697314E28 | -3.697314E28 | -3.697314E28 | Missing | -3.697314E28 | -3.697314E28 | -3.697314E28 | Missing | -3.697314E28 | -3.697314E28 | -3.697314E28 | Missing | -3.697314E28 | -3.697314E28 | -3.697314E28 | Missing | -3.697314E28 | -3.697314E28 | -3.697314E28 | Missing | -3.697314E28 | -3.697314E28 | -3.697314E28 | Missing | -3.697314E28 | -3.697314E28
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
