arushriswarup/Grad-School/authored papers/Gear Tooth Joint /Experiments/CAJ_NDI_20171121/caj_ndi_20171121_004.csv

1 | Port 10: NDI-MF2 610059 T6F0-L00061 s/n:3A915800 Channel:0 | 223518 | 1 | OK | -12.4527697 | 6.0860970 | 165.5535525 | 93.967 | -39.232 | -213.194 | 0.2247745 | 20 | Missing | -3.697314E28 | -3.697314E28 | -3.697314E28 | Missing | -3.697314E28 | -3.697314E28 | -3.697314E28 | Missing | -3.697314E28 | -3.697314E28 | -3.697314E28 | Missing | -3.697314E28 | -3.697314E28 | -3.697314E28 | Missing | -3.697314E28 | -3.697314E28 | -3.697314E28 | Missing | -3.697314E28 | -3.697314E28 | -3.697314E28 | Missing | -3.697314E28 | -3.697314E28 | -3.697314E28 | Missing | -3.697314E28 | -3.697314E28 | -3.697314E28 | Missing | -3.697314E28 | -3.697314E28 | -3.697314E28 | Missing | -3.697314E28 | -3.697314E28 | -3.697314E28 | Missing | -3.697314E28 | -3.697314E28 | -3.697314E28 | Missing | -3.697314E28 | -3.697314E28
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
