arushriswarup/Grad-School/Committee Meeting/anatomy with tool testing.png

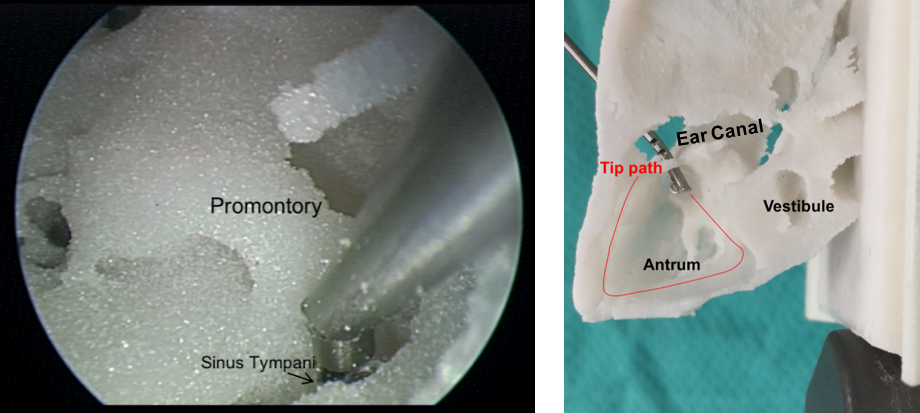
Committee Meeting/anatomy with tool testing.png
