arushriswarup/Grad-School/Needs Analysis Survey/Stats results/Degree of Need vs TEES Challenge.png

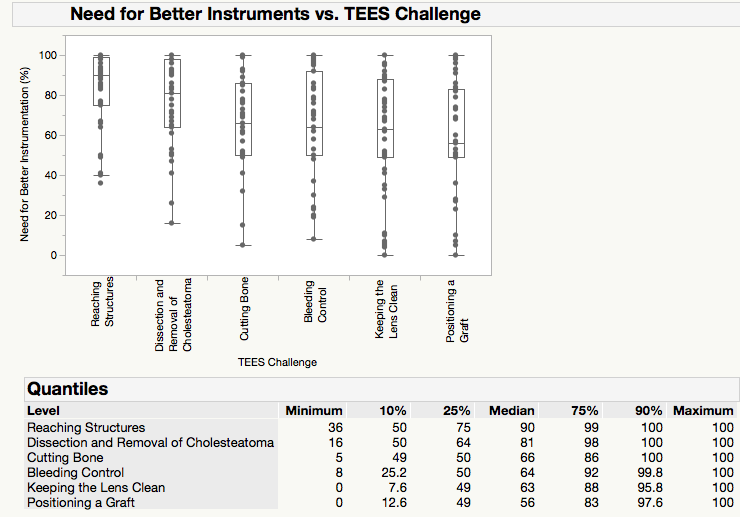
Needs Analysis Survey/Stats results/Degree of Need vs TEES Challenge.png
