arushriswarup/Grad-School/Needs Analysis Survey/Stats results/Fit Y by X.png

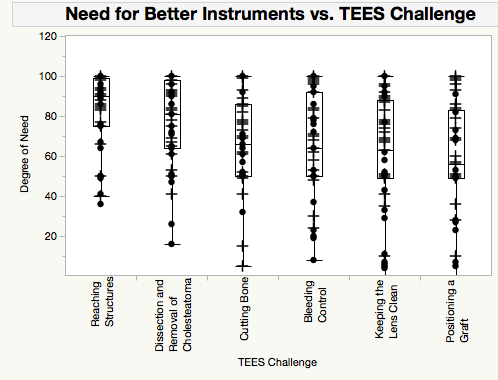
Needs Analysis Survey/Stats results/Fit Y by X.png
