arushriswarup/Grad-School/Needs Analysis Survey/Stats results/Need for Better Instruments vs. TEES Challenge.png

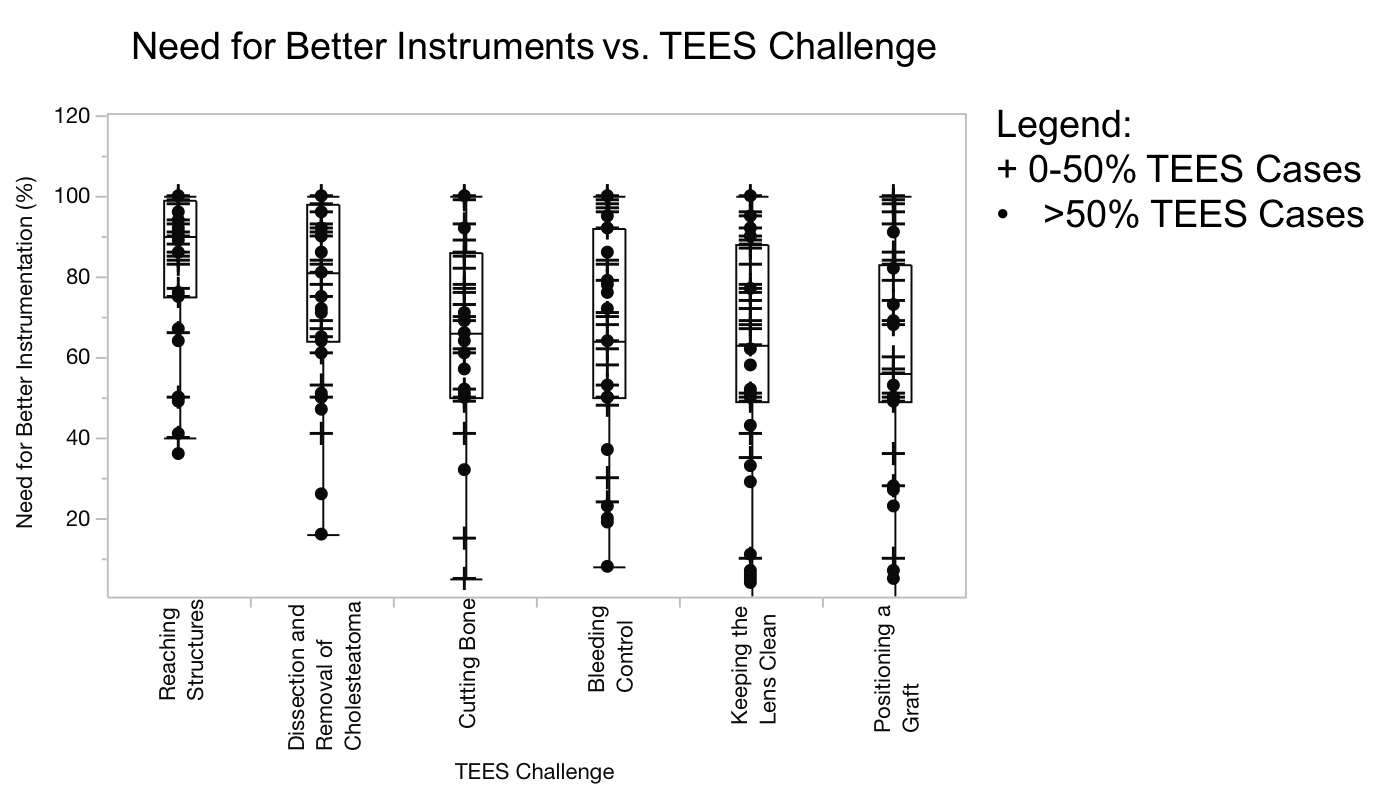
Needs Analysis Survey/Stats results/Need for Better Instruments vs. TEES Challenge.png
