arushriswarup/Grad-School/Ear Surgery Instruments/Instrument Bug List.xlsx

Instrument Bug List
Bug | Root Cause | Possible Solutions | Actions
not enough space for collet between stopper and tubing adaptor
collet can't slide onto the SS shaft because it gets stuck on the the stopper/tubing adaptor | larger diameter SS stopper/tubing adaptor is preventing collet from sliding on | remove the stopper and just drill a hole in the SS shaft where the cable can exit the shaft and out of the silicone tubing
laser fibre gets stuck while being fed into the instrument | it is fed from larger diameter tubes to smaller diameter tubes so the tip collides with the smaller diameter tubes | remove the stopper and just drill a hole in the SS shaft where the cable can exit the shaft and out of the silicone tubing
wrist was torqued inside cadaver ear which caused the rectangular notched wrist to snap due to torquing at the thin members | torquing at the thin members | CCM or CACJ V-2 notches instead of rectangular notches | laser cut ccm notches to achieve the desired arc length, bending angles
welded SS pieces came off | holes in the weld seam
Design Suggestions from survey comments
lockable
roll
tip first closure
loop where cable is anchored obstructs view and comes in the way while dissecting
longer tip so that the hand doesn't collide with the face
useful for dissection with the spring back that acts like a cantilever arm
useful in larynx
eustachian tube to look into middle ear
