arushriswarup/Grad-School/Ear Surgery Instruments/Wrist Tool Assembly/Wristed Cuts/CCM V-1 wrist for Pulse 02-Feb-2018_tolerance updated.PDF

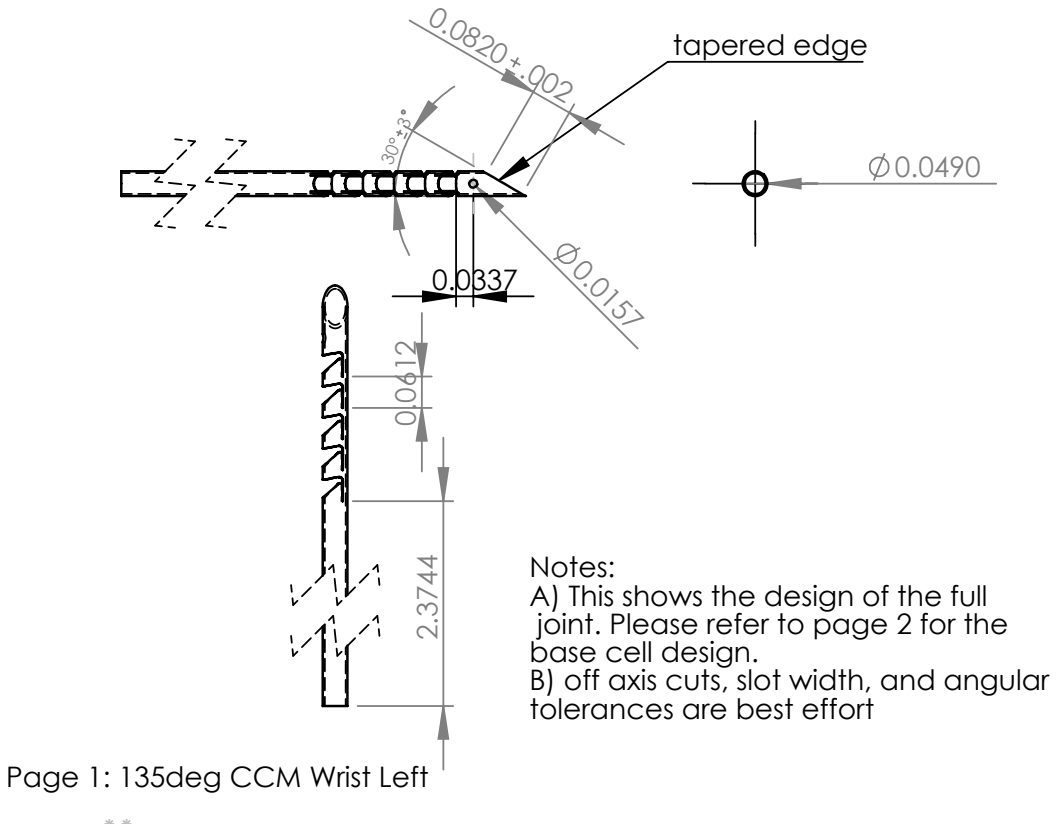
[picture p353: page 1]
tapered edge

Notes:
A) This shows the design of the full
joint. Please refer to page 2 for the
base cell design.
B) off axis cuts, slot width, and angular
tolerances are best effort

Page 1: 135deg CCM Wrist Left

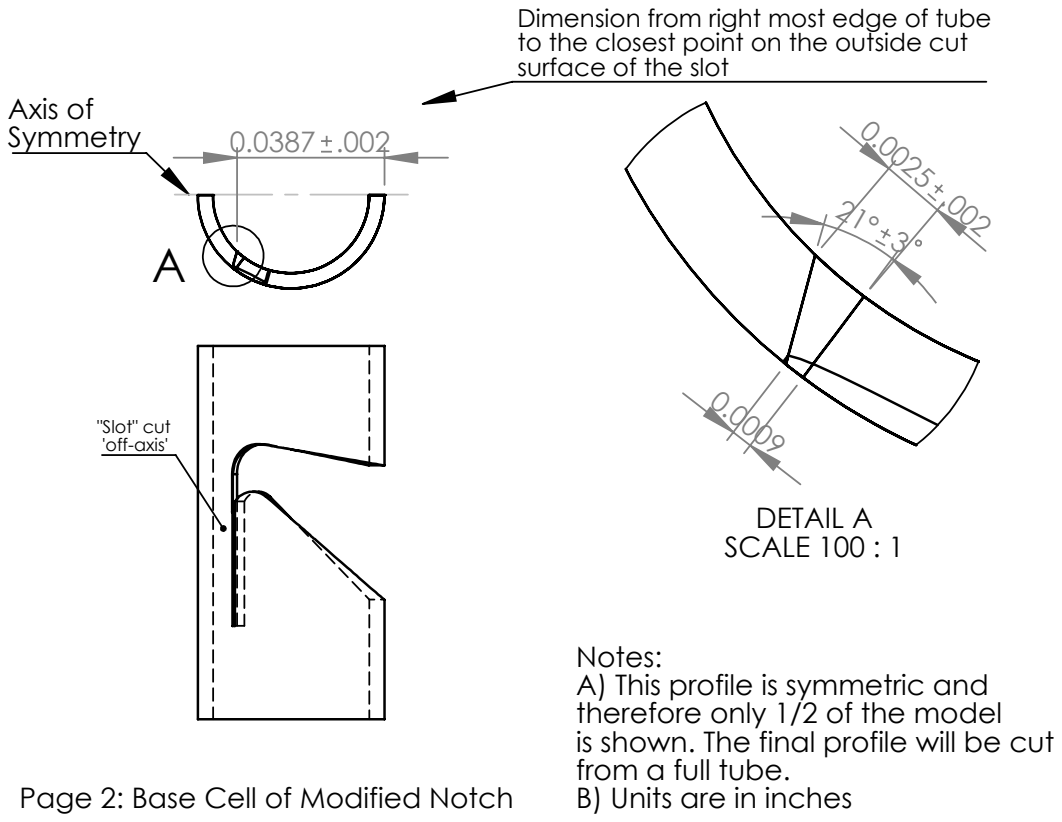
[picture p354: page 2]
"Slot" cut; Axis of; DETAIL A SCALE 100 : 1; Page 2: Base Cell of Modified Notch; B) Units are in inches

Dimension from right most edge of tube
to the closest point on the outside cut
surface of the slot

Notes:
A) This profile is symmetric and
therefore only 1/2 of the model
is shown. The final profile will be cut
from a full tube.

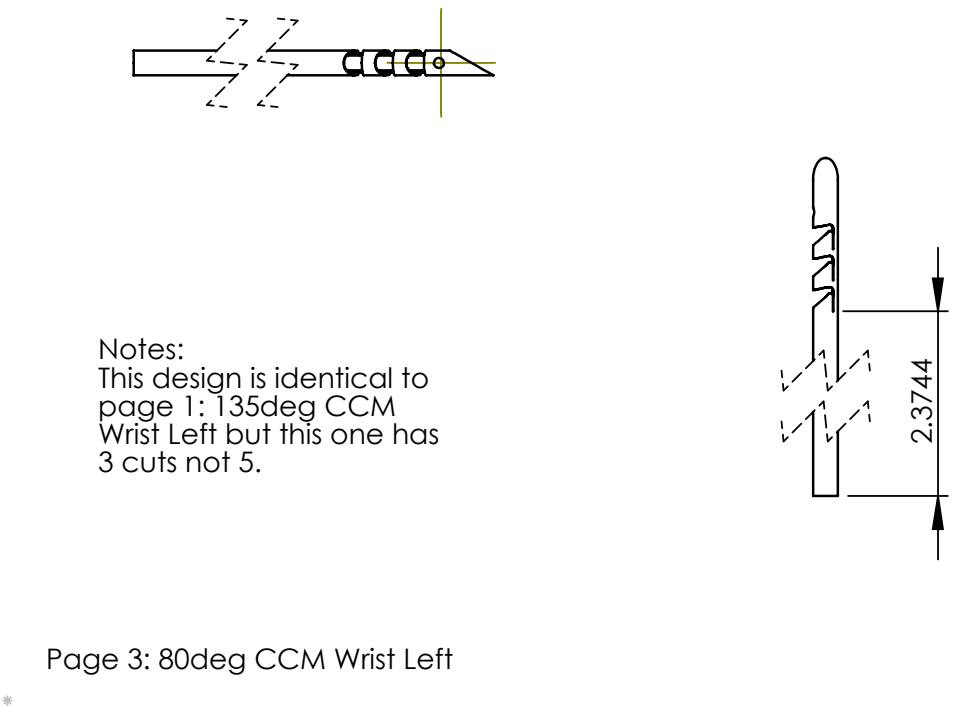
[picture p355: page 3]

Notes:
This design is identical to
page 1: 135deg CCM
Wrist Left but this one has
3 cuts not 5.

Page 3: 80deg CCM Wrist Left
