arushriswarup/Grad-School/Ear Surgery Instruments/Wrist Tool Assembly/Wristed Cuts/CCM V-1 wrist for Preco Arushri 19-Jan-2018.PDF

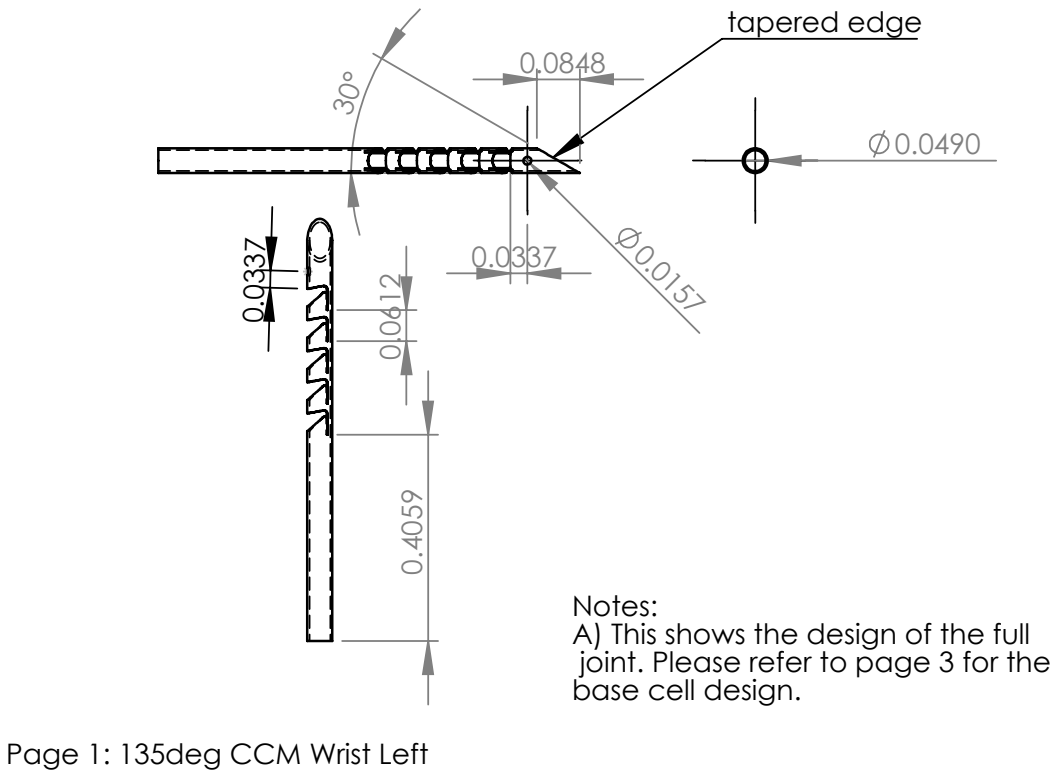
[picture p358: page 1]
tapered edge

Notes:
A) This shows the design of the full
joint. Please refer to page 3 for the
base cell design.

Page 1: 135deg CCM Wrist Left

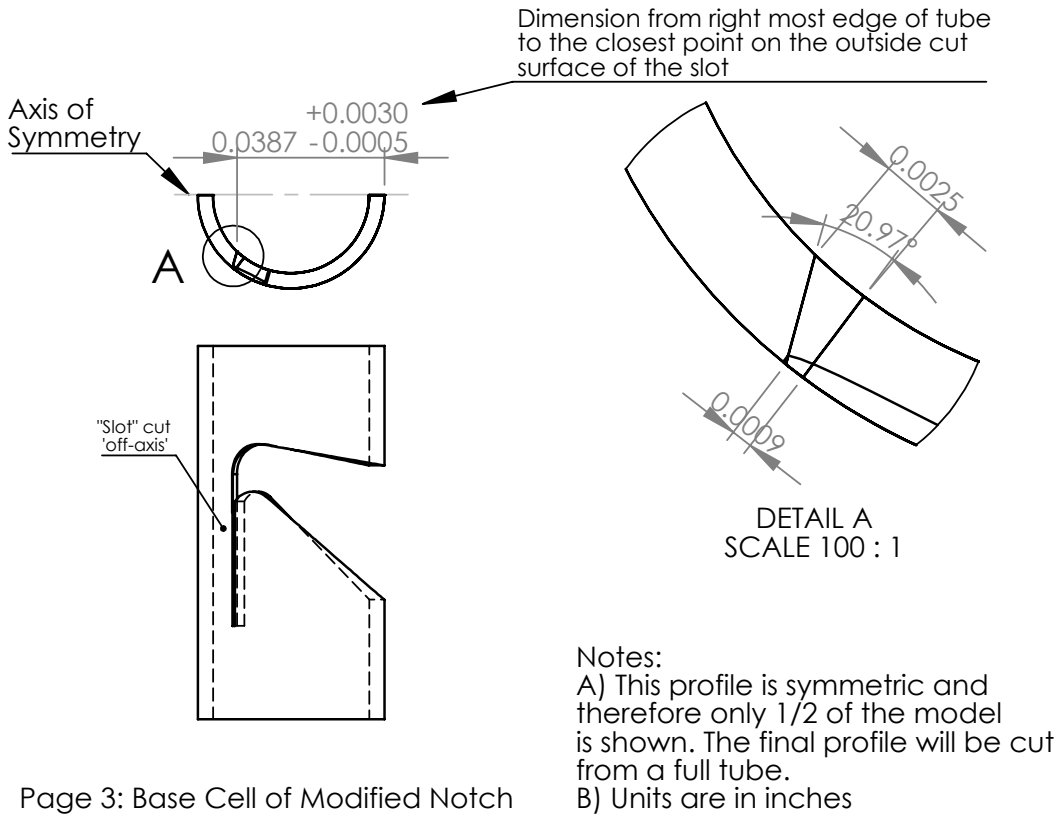
[picture p359: page 2]
"Slot" cut; Axis of; DETAIL A SCALE 100 : 1; Page 3: Base Cell of Modified Notch; B) Units are in inches

Dimension from right most edge of tube
to the closest point on the outside cut
surface of the slot

Notes:
A) This profile is symmetric and
therefore only 1/2 of the model
is shown. The final profile will be cut
from a full tube.

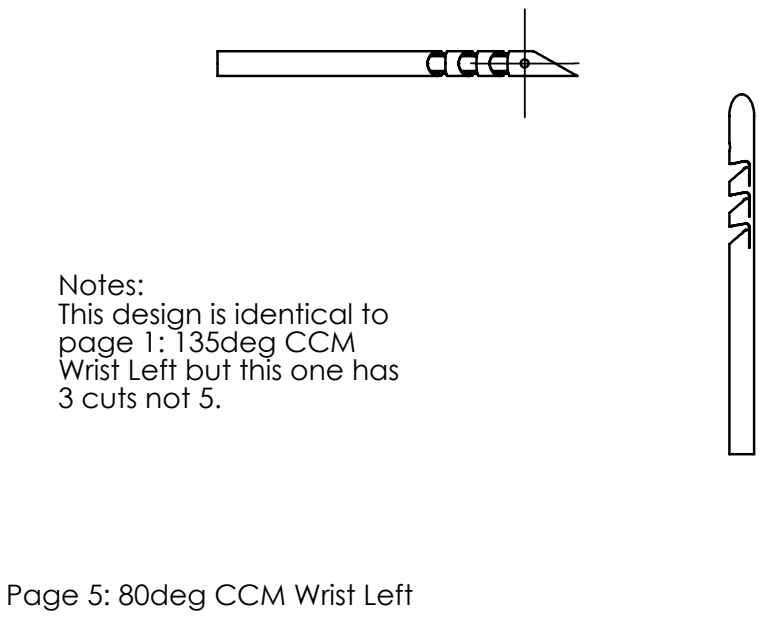
[picture p360: page 3]

Notes:
This design is identical to
page 1: 135deg CCM
Wrist Left but this one has
3 cuts not 5.

Page 5: 80deg CCM Wrist Left
