arushriswarup/Grad-School/Ear Surgery Instruments/Wrist Tool Assembly/Wristed Cuts/135deg CCM V-1 Wrist 07-Dec-2017.PDF

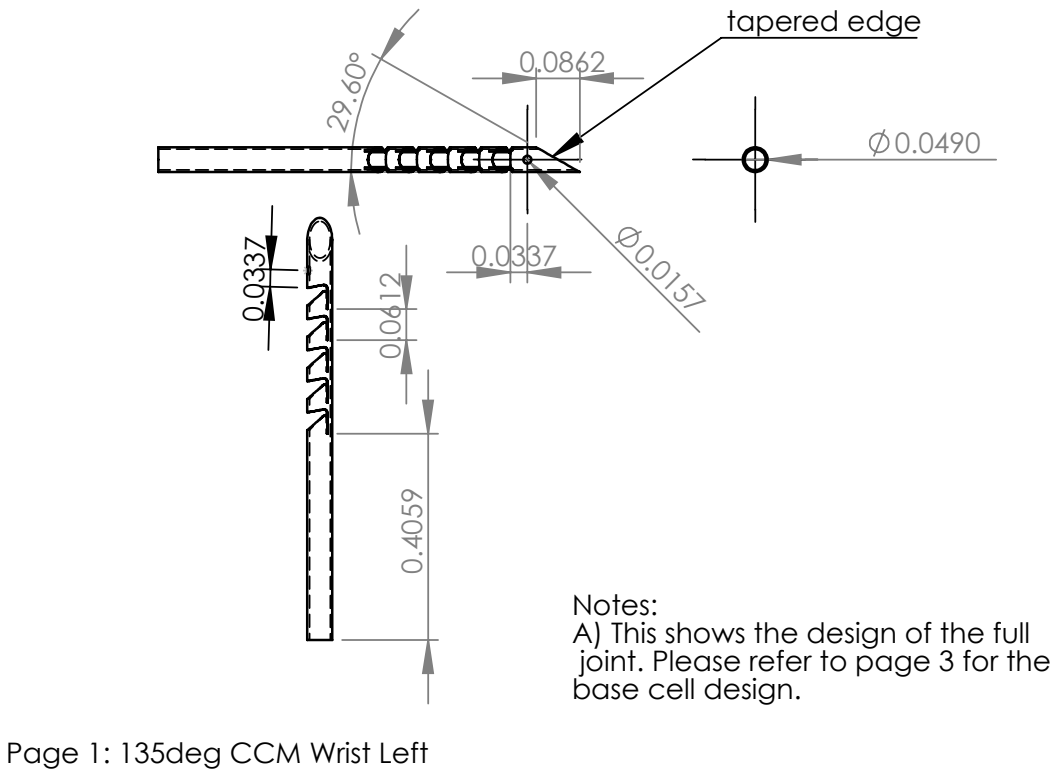
[picture p361: page 1]
tapered edge

Notes:
A) This shows the design of the full
joint. Please refer to page 3 for the
base cell design.

Page 1: 135deg CCM Wrist Left

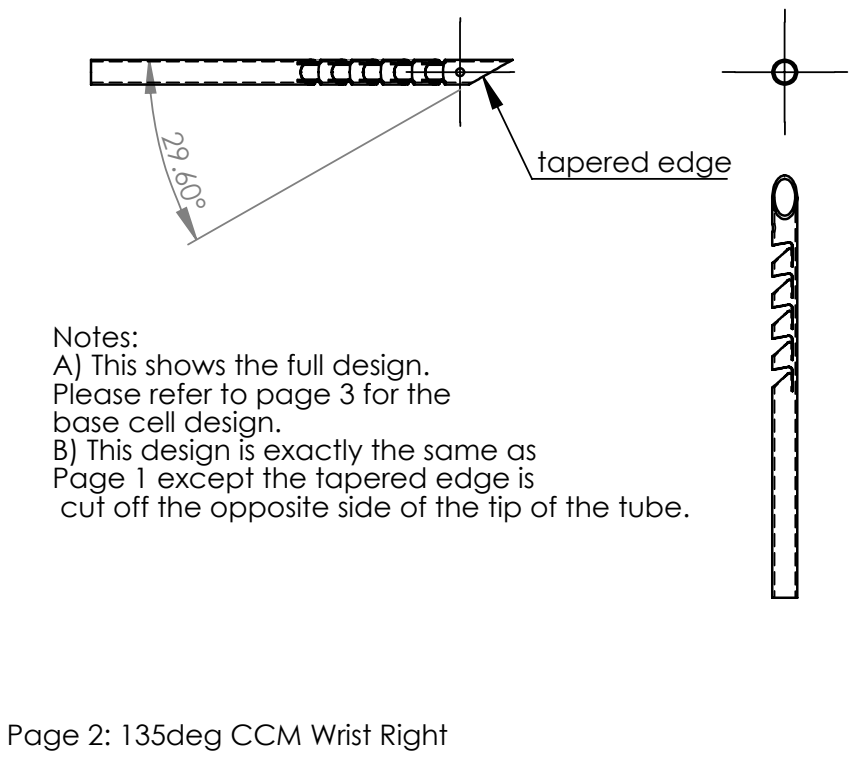
[picture p362: page 2]
tapered edge

Notes:
A) This shows the full design.
Please refer to page 3 for the
base cell design.
B) This design is exactly the same as
Page 1 except the tapered edge is
cut off the opposite side of the tip of the tube.

Page 2: 135deg CCM Wrist Right

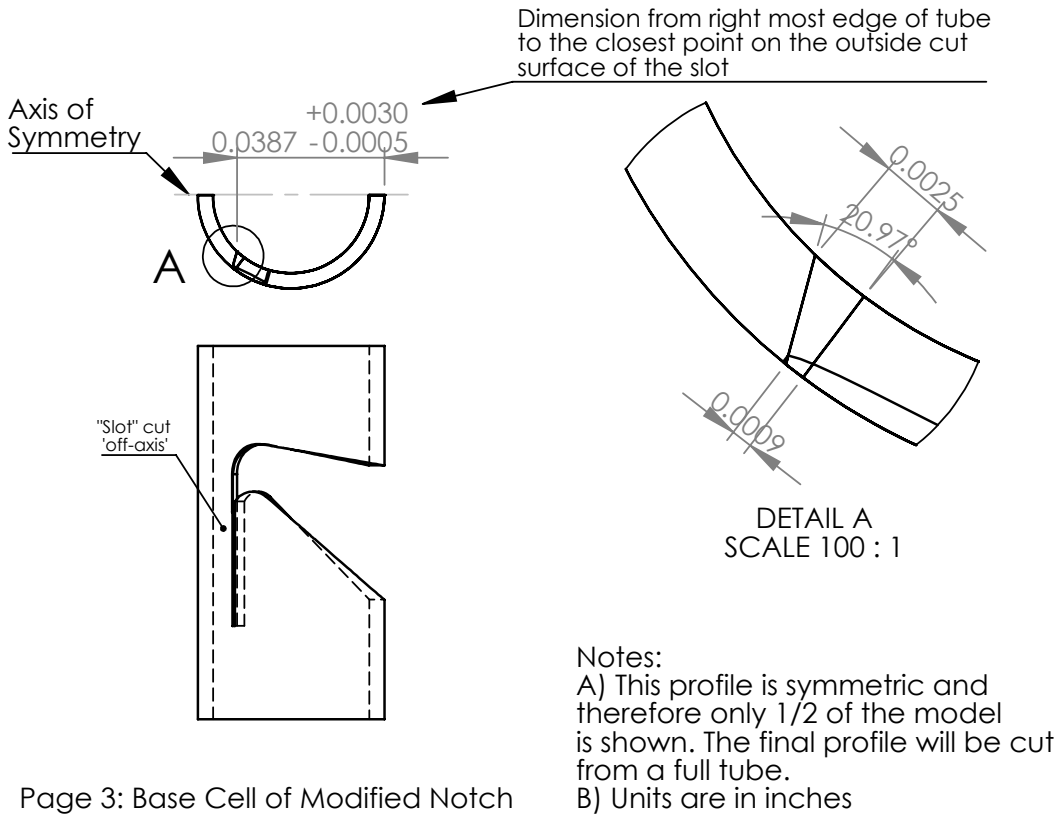
[picture p363: page 3]
"Slot" cut; Axis of; DETAIL A SCALE 100 : 1; Page 3: Base Cell of Modified Notch; B) Units are in inches

Dimension from right most edge of tube
to the closest point on the outside cut
surface of the slot

Notes:
A) This profile is symmetric and
therefore only 1/2 of the model
is shown. The final profile will be cut
from a full tube.

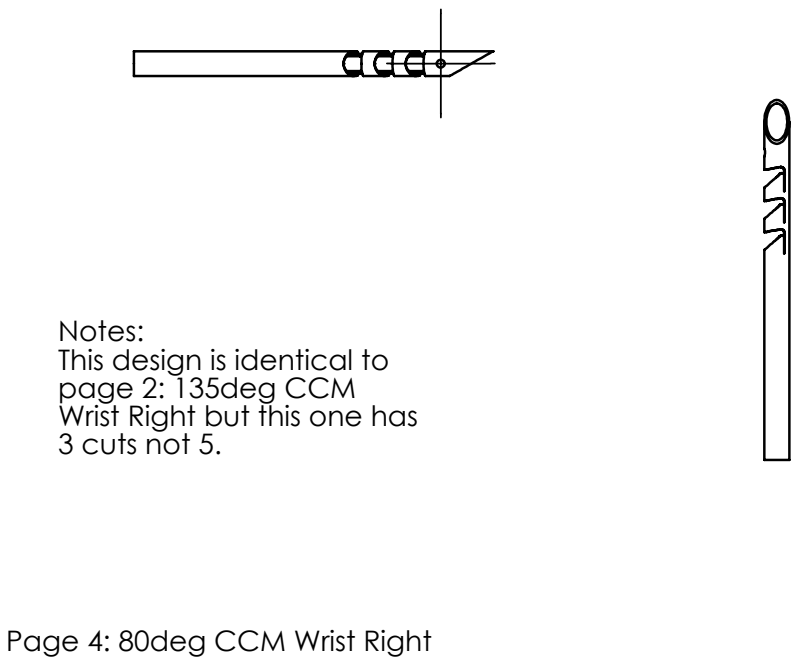
[picture p364: page 4]

Notes:
This design is identical to
page 2: 135deg CCM
Wrist Right but this one has
3 cuts not 5.

Page 4: 80deg CCM Wrist Right


Notes:
This design is identical to
page 1: 135deg CCM
Wrist Left but this one has
3 cuts not 5.

Page 5: 80deg CCM Wrist Left
