arushriswarup/Grad-School/Ear Surgery Instruments/Wrist Tool Assembly/Wristed Cuts/ANSTY Profile_1DOF_ARUSHRI.PDF

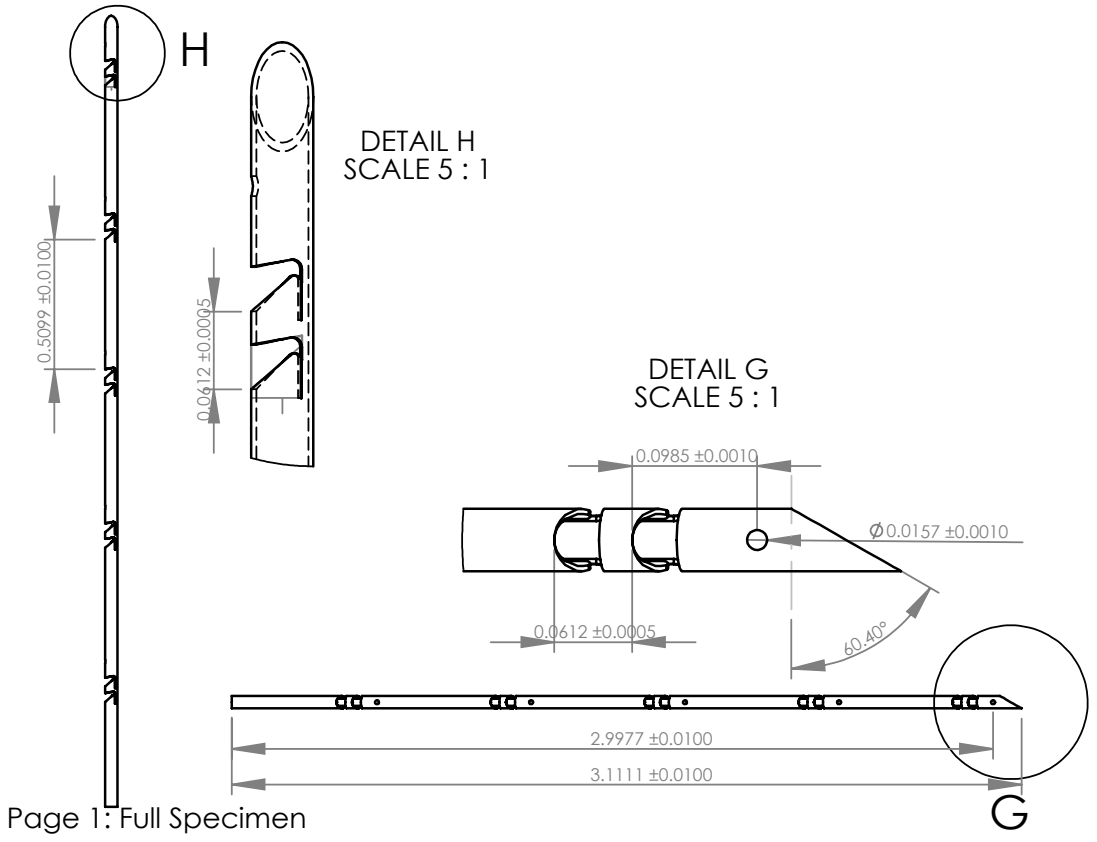
[picture p365: page 1]
DETAIL G SCALE 5 : 1; DETAIL H SCALE 5 : 1

Page 1: Full Specimen

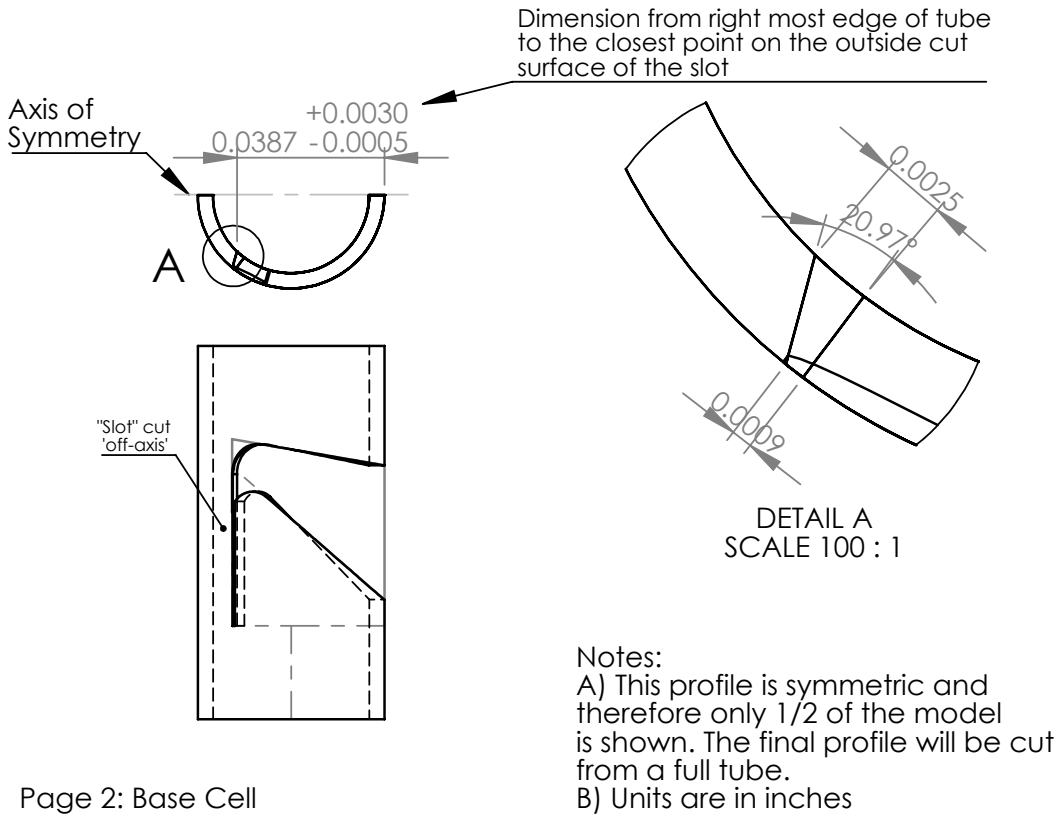
[picture p366: page 2]
"Slot" cut; Axis of; DETAIL A SCALE 100 : 1; Page 2: Base Cell; B) Units are in inches

Dimension from right most edge of tube
to the closest point on the outside cut
surface of the slot

Notes:
A) This profile is symmetric and
therefore only 1/2 of the model
is shown. The final profile will be cut
from a full tube.
